pcbarts/fast-open-switch-hardware/README.md

The electronic design data from the fast-open-switch project is stored in this repo.
