pcbarts/fast-open-switch-hardware/fast-open-switch r1.0/Documentation/KlusterLab r1.x Pinouts.xlsx

Sheet: FPGA Pinout
Pin Designator | Net Name | Display Name | IO Bank | IO Standard | Slew Rate | Drive Strength | IO Pin | Vref Pin | CLK Pin | Config Pin | Special Pin | Group | Differential Pair
A1 | GND | GND
A2 | GND | GND
A3 | PCIe_C_TX0_N | MGTXTXN3_116
A4 | PCIe_C_TX0_P | MGTXTXP3_116
A5 | GND | GND
A6 | GND | GND
A7 | GND | GND
A8 | CRUVI_B_6_N | IO_L9N_T1_DQS_16
A9 | CRUVI_B_6_P | IO_L9P_T1_DQS_16
A10 | CRUVI_A_4_N | IO_L22N_T3_16
A11 | VCC3V3 | VCCO_16
A12 | CRUVI_A_1_N | IO_L24N_T3_16
A13 | CRUVI_A_1_P | IO_L24P_T3_16
A14 | CRUVI_A_7_N | IO_L21N_T3_DQS_16
A15 | CRUVI_A_8_N | IO_L23N_T3_16
A16 | GND | GND
A17 | UART_USB_RxD | IO_L3N_T0_DQS_AD1N_15
A18 | PI_E\X\T\R\S\T\ | IO_L2P_T0_AD8P_15
A19 |  | IO_L2N_T0_AD8N_15
A20 | FPGA_SOFT_RST | IO_L8N_T1_D12_14
A21 | VCC1V8 | VCCO_14
A22 | FPGA_D3 | IO_L2N_T0_D03_14
A23 | FPGA_D4 | IO_L4P_T0_D04_14
A24 | FPGA_D5 | IO_L4N_T0_D05_14
A25 | FPGA_D1 | IO_L1N_T0_D01_DIN_14
A26 | GND | GND
AA1 | VCC1V5 | VCCO_34
AA2 |  | IO_L12N_T1_MRCC_34
AA3 | DDR3_D57 | IO_L12P_T1_MRCC_34
AA4 | DDR3_D39 | IO_L13P_T2_MRCC_34
AA5 | DDR3_DQS4_P | IO_L15P_T2_DQS_34
AA6 | GND | GND
AA7 | DDR3_C\A\S\ | IO_L8N_T1_33
AA8 | DDR3_ODT0 | IO_L8P_T1_33
AA9 | DDR3_CLK1_P | IO_L11P_T1_SRCC_33
AA10 | DDR3_R\A\S\ | IO_L14P_T2_SRCC_33
AA11 | VCC1V5 | VCCO_33
AA12 | DDR3_A5 | IO_L16N_T2_33
AA13 | DDR3_A12 | IO_L16P_T2_33
AA14 | DDR3_DM3 | IO_L7P_T1_32
AA15 | DDR3_D24 | IO_L7N_T1_32
AA16 | GND | GND
AA17 | DDR3_D29 | IO_L11P_T1_SRCC_32
AA18 | DDR3_D28 | IO_L11N_T1_SRCC_32
AA19 | DDR3_D4 | IO_L16P_T2_32
AA20 | DDR3_D5 | IO_L16N_T2_32
AA21 | VCC1V8 | VCCO_12
AA22 | SMI_SD17 | IO_L13N_T2_MRCC_12
AA23 | SMI_SD15 | IO_L11P_T1_SRCC_12
AA24 | SMI_SD16 | IO_L12N_T1_MRCC_12
AA25 | SMI_SD3 | IO_L7P_T1_12
AA26 | GND | GND
AB1 | DDR3_DQS7_P | IO_L9P_T1_DQS_34
AB2 | DDR3_D56 | IO_L11P_T1_SRCC_34
AB3 | GND | GND
AB4 | DDR3_D35 | IO_L13N_T2_MRCC_34
AB5 | DDR3_DQS4_N | IO_L15N_T2_DQS_34
AB6 | DDR3_D36 | IO_L16P_T2_34
AB7 | DDR3_A13 | IO_L10P_T1_33
AB8 | VCC1V5 | VCCO_33
AB9 | DDR3_CLK1_N | IO_L11N_T1_SRCC_33
AB10 | DDR3_A2 | IO_L14N_T2_SRCC_33
AB11 | DDR3_CLK0_P | IO_L13P_T2_MRCC_33
AB12 | DDR3_A8 | IO_L15P_T2_DQS_33
AB13 | GND | GND
AB14 | DDR3_D27 | IO_L10P_T1_32
AB15 | DDR3_D30 | IO_L10N_T1_32
AB16 | DDR3_D25 | IO_L12P_T1_MRCC_32
AB17 | DDR3_D0 | IO_L14P_T2_SRCC_32
AB18 | VCC1V5 | VCCO_32
AB19 | DDR3_D11 | IO_L18P_T2_32
AB20 | DDR3_D10 | IO_L18N_T2_32
AB21 | FPGA_µSD_DAT3 | IO_L18P_T2_12
AB22 | FPGA_µSD_CMD | IO_L17P_T2_12
AB23 | GND | GND
AB24 | SMI_SD7 | IO_L11N_T1_SRCC_12
AB25 | SMI_SA4 | IO_L7N_T1_12
AB26 | SMI_SA0 | IO_L9P_T1_DQS_12
AC1 | DDR3_DQS7_N | IO_L9N_T1_DQS_34
AC2 | DDR3_D60 | IO_L11N_T1_SRCC_34
AC3 | DDR3_D34 | IO_L14N_T2_SRCC_34
AC4 | DDR3_DM4 | IO_L14P_T2_SRCC_34
AC5 | VCC1V5 | VCCO_34
AC6 | DDR3_D33 | IO_L16N_T2_34
AC7 | DDR3_BA0 | IO_L10N_T1_33
AC8 | DDR3_A3 | IO_L9P_T1_DQS_33
AC9 | 200MHz_SYSCLK_P | IO_L12P_T1_MRCC_33
AC10 | GND | GND
AC11 | DDR3_CLK0_N | IO_L13N_T2_MRCC_33
AC12 | DDR3_A6 | IO_L15N_T2_DQS_33
AC13 | DDR3_BA2 | IO_L17P_T2_33
AC14 | DDR3_D31 | IO_L8P_T1_32
AC15 | VCC1V5 | VCCO_32
AC16 | DDR3_D7 | IO_L12N_T1_MRCC_32
AC17 | DDR3_D2 | IO_L14N_T2_SRCC_32
AC18 | DDR3_D1 | IO_L13P_T2_MRCC_32
AC19 | DDR3_DM0 | IO_L17P_T2_32
AC20 | GND | GND
AC21 | FPGA_µSD_DAT1 | IO_L18N_T2_12
AC22 | FPGA_µSD_CD | IO_L17N_T2_12
AC23 | SMI_SD11 | IO_L14P_T2_SRCC_12
AC24 | SMI_SOE_N/SE | IO_L14N_T2_SRCC_12
AC25 | VCC1V8 | VCCO_12
AC26 | SMI_SD5 | IO_L9N_T1_DQS_12
AD1 | DDR3_D47 | IO_L20P_T3_34
AD2 | VCC1V5 | VCCO_34
AD3 | VTTVREF | IO_L19N_T3_VREF_34
AD4 | DDR3_D46 | IO_L19P_T3_34
AD5 |  | IO_L18N_T2_34
AD6 | DDR3_D32 | IO_L18P_T2_34
AD7 | GND | GND
AD8 | DDR3_A1 | IO_L9N_T1_DQS_33
AD9 | 200MHz_SYSCLK_N | IO_L12N_T1_MRCC_33
AD10 |  | IO_L20P_T3_33
AD11 | DDR3_A9 | IO_L19P_T3_33
AD12 | VCC1V5 | VCCO_33
AD13 | DDR3_A7 | IO_L17N_T2_33
AD14 | DDR3_D26 | IO_L8N_T1_32
AD15 | DDR3_D22 | IO_L4P_T0_32
AD16 | DDR3_D21 | IO_L6P_T0_32
AD17 | GND | GND
AD18 | DDR3_D6 | IO_L13N_T2_MRCC_32
AD19 | DDR3_D3 | IO_L17N_T2_32
AD20 | DDR3_DQS0_P | IO_L15P_T2_DQS_32
AD21 | FPGA_µSD_CLK | IO_L19P_T3_12
AD22 | VCC1V8 | VCCO_12
AD23 | FPGA_µSD_DAT2 | IO_L16P_T2_12
AD24 | FPGA_µSD_DAT0 | IO_L16N_T2_12
AD25 |  | IO_L23P_T3_12
AD26 | TEMP_I2C_SDA_LS | IO_L21P_T3_DQS_12
AE1 | DDR3_D43 | IO_L20N_T3_34
AE2 | DDR3_D42 | IO_L22N_T3_34
AE3 | DDR3_D41 | IO_L22P_T3_34
AE4 | GND | GND
AE5 | DDR3_D45 | IO_L23N_T3_34
AE6 | DDR3_D44 | IO_L23P_T3_34
AE7 | DDR3_A10 | IO_L7P_T1_33
AE8 |  | IO_L22P_T3_33
AE9 | VCC1V5 | VCCO_33
AE10 |  | IO_L20N_T3_33
AE11 | VTTVREF | IO_L19N_T3_VREF_33
AE12 |  | IO_L21P_T3_DQS_33
AE13 |  | IO_L23P_T3_33
AE14 | GND | GND
AE15 | DDR3_D18 | IO_L4N_T0_32
AE16 | VTTVREF | IO_L6N_T0_VREF_32
AE17 | DDR3_D17 | IO_L1P_T0_32
AE18 | DDR3_DQS2_P | IO_L3P_T0_DQS_32
AE19 | VCC1V5 | VCCO_32
AE20 | DDR3_DQS0_N | IO_L15N_T2_DQS_32
AE21 |  | IO_L19N_T3_VREF_12
AE22 | Main_I2C_SDA | IO_L24P_T3_12
AE23 |  | IO_L22P_T3_12
AE24 | GND | GND
AE25 |  | IO_L23N_T3_12
AE26 | TEMP_I2C_SCL_LS | IO_L21N_T3_DQS_12
AF1 | GND | GND
AF2 | DDR3_DM5 | IO_L24N_T3_34
AF3 | DDR3_D40 | IO_L24P_T3_34
AF4 | DDR3_DQS5_N | IO_L21N_T3_DQS_34
AF5 | DDR3_DQS5_P | IO_L21P_T3_DQS_34
AF6 | VCC1V5 | VCCO_34
AF7 | DDR3_A0 | IO_L7N_T1_33
AF8 |  | IO_L22N_T3_33
AF9 |  | IO_L24N_T3_33
AF10 |  | IO_L24P_T3_33
AF11 | GND | GND
AF12 |  | IO_L21N_T3_DQS_33
AF13 |  | IO_L23N_T3_33
AF14 | DDR3_D23 | IO_L2P_T0_32
AF15 | DDR3_D19 | IO_L2N_T0_32
AF16 | VCC1V5 | VCCO_32
AF17 | DDR3_DM2 | IO_L1N_T0_32
AF18 | DDR3_DQS2_N | IO_L3N_T0_DQS_32
AF19 | DDR3_D16 | IO_L5P_T0_32
AF20 | DDR3_D20 | IO_L5N_T0_32
AF21 | GND | GND
AF22 |  | IO_L24N_T3_12
AF23 |  | IO_L22N_T3_12
AF24 |  | IO_L20P_T3_12
AF25 |  | IO_L20N_T3_12
AF26 | VCC1V8 | VCCO_12
B1 | SATA_TX_C_N | MGTXTXN2_116
B2 | SATA_TX_C_P | MGTXTXP2_116
B3 | MGTAVTT | MGTAVTT
B4 | GND | GND
B5 | PCIe_RX0_N | MGTXRXN3_116
B6 | PCIe_RX0_P | MGTXRXP3_116
B7 | GND | GND
B8 | VCC3V3 | VCCO_16
B9 | CRUVI_A_3_N | IO_L10N_T1_16
B10 | CRUVI_A_4_P | IO_L22P_T3_16
B11 | CRUVI_A_5_N | IO_L20N_T3_16
B12 | CRUVI_A_5_P | IO_L20P_T3_16
B13 | GND | GND
B14 | CRUVI_A_7_P | IO_L21P_T3_DQS_16
B15 | CRUVI_A_8_P | IO_L23P_T3_16
B16 | PCIe_PERST | IO_L1N_T0_AD0N_15
B17 | UART_USB_R\T\S\ | IO_L3P_T0_DQS_AD1P_15
B18 | VCC3V3 | VCCO_15
B19 | FPGA_FAN_TACH | IO_L4N_T0_AD9N_15
B20 |  | IO_L8P_T1_D11_14
B21 |  | IO_L10N_T1_D15_14
B22 | FPGA_D2 | IO_L2P_T0_D02_14
B23 | GND | GND
B24 | FPGA_D0 | IO_L1P_T0_D00_MOSI_14
B25 | NetR274_2 | IO_L3P_T0_DQS_PUDC_B_14
B26 | FPGA_EMCCLK | IO_L3N_T0_DQS_EMCCLK_14
C1 | GND | GND
C2 | MGTAVTT | MGTAVTT
C3 | SATA_RX_C_N | MGTXRXN2_116
C4 | SATA_RX_C_P | MGTXRXP2_116
C5 | GND | GND
C6 | MGTAVCC | MGTAVCC
C7 | GND | GND
C8 | FPGA_CLK | CCLK_0
C9 | CRUVI_A_3_P | IO_L10P_T1_16
C10 | GND | GND
C11 | CRUVI_A_6_N | IO_L13N_T2_MRCC_16
C12 | CRUVI_A_6_P | IO_L13P_T2_MRCC_16
C13 | CRUVI_A_9_N | IO_L19N_T3_VREF_16
C14 | CRUVI_A_9_P | IO_L19P_T3_16
C15 | VCC3V3 | VCCO_16
C16 |  | IO_L1P_T0_AD0P_15
C17 | FPGA_FAN_PWM | IO_L5P_T0_AD2P_15
C18 | CRUVI_B_DO | IO_L5N_T0_AD2N_15
C19 | SYS_FAN_PWM | IO_L4P_T0_AD9P_15
C20 | GND | GND
C21 |  | IO_L10P_T1_D14_14
C22 | CS_MAN_CTRL | IO_L7N_T1_D10_14
C23 | FPGA_F\C\S\ | IO_L6P_T0_FCS_B_14
C24 |  | IO_L6N_T0_D08_VREF_14
C25 | VCC1V8 | VCCO_14
C26 | FPGA_D7 | IO_L5N_T0_D07_14
D1 |  | MGTXTXN1_116
D2 |  | MGTXTXP1_116
D3 | MGTAVTT | MGTAVTT
D4 | GND | GND
D5 | PCIe_REFCLK_N | MGTREFCLK0N_116
D6 | PCIe_REFCLK_P | MGTREFCLK0P_116
D7 | GND | GND
D8 | CRUVI_A_2_N | IO_L8N_T1_16
D9 | CRUVI_A_2_P | IO_L8P_T1_16
D10 | CRUVI_B_5_N | IO_L12N_T1_MRCC_16
D11 | CRUVI_B_7_N | IO_L14N_T2_SRCC_16
D12 | VCC3V3 | VCCO_16
D13 | CRUVI_A_11_N | IO_L17N_T2_16
D14 | CRUVI_A_11_P | IO_L17P_T2_16
D15 | CRUVI_B_RESET | IO_L6P_T0_15
D16 | CRUVI_B_HSO | IO_L6N_T0_VREF_15
D17 | GND | GND
D18 | CRUVI_B_SEL | IO_L13N_T2_MRCC_15
D19 | CRUVI_B_SCK | IO_L15P_T2_DQS_15
D20 | CRUVI_A_DO | IO_L15N_T2_DQS_ADV_B_15
D21 | FPGA_Strobe | IO_L7P_T1_D09_14
D22 | VCC1V8 | VCCO_14
D23 | Switch_5 | IO_L11P_T1_SRCC_14
D24 | Switch_4 | IO_L11N_T1_SRCC_14
D25 | Switch_2 | IO_L15N_T2_DQS_DOUT_CSO_B_14
D26 | FPGA_D6 | IO_L5P_T0_D06_14
E1 | GND | GND
E2 | GND | GND
E3 |  | MGTXRXN1_116
E4 |  | MGTXRXP1_116
E5 | GND | GND
E6 | MGTAVCC | MGTAVCC
E7 | GND | GND
E8 | NetTP21_1 | VCCBATT_0
E9 | VCC3V3 | VCCO_16
E10 | CRUVI_B_5_P | IO_L12P_T1_MRCC_16
E11 | CRUVI_B_7_P | IO_L14P_T2_SRCC_16
E12 | CRUVI_B_9_N | IO_L18N_T2_16
E13 | CRUVI_B_9_P | IO_L18P_T2_16
E14 | GND | GND
E15 | CRUVI_B_SMB_SCL | IO_L10P_T1_AD4P_15
E16 | CRUVI_B_REFCLK | IO_L10N_T1_AD4N_15
E17 | CRUVI_A_REFCLK | IO_L12N_T1_MRCC_AD5N_15
E18 | CRUVI_B_MODE | IO_L13P_T2_MRCC_15
E19 | VCC3V3 | VCCO_15
E20 | CRUVI_A_SEL | IO_L17N_T2_A25_15
E21 |  | IO_L9P_T1_DQS_14
E22 | Switch_7 | IO_L9N_T1_DQS_D13_14
E23 | Switch_6 | IO_L12N_T1_MRCC_14
E24 | GND | GND
E25 | Switch_0 | IO_L15P_T2_DQS_RDWR_B_14
E26 | Switch_1 | IO_L17N_T2_A13_D29_14
F1 |  | MGTXTXN0_116
F2 |  | MGTXTXP0_116
F3 | GND | GND
F4 | GND | GND
F5 | 150MHz_REFCLK_N | MGTREFCLK1N_116
F6 | 150MHz_REFCLK_P | MGTREFCLK1P_116
F7 | GND | GND
F8 | CRUVI_B_3_N | IO_L7N_T1_16
F9 | CRUVI_B_3_P | IO_L7P_T1_16
F10 | CRUVI_B_4_N | IO_L11N_T1_SRCC_16
F11 | GND | GND
F12 | CRUVI_B_8_N | IO_L16N_T2_16
F13 | CRUVI_A_0_N | IO_L15N_T2_DQS_16
F14 | CRUVI_A_0_P | IO_L15P_T2_DQS_16
F15 | CRUVI_B_HSIO | IO_L8N_T1_AD3N_15
F16 | VCC3V3 | VCCO_15
F17 | CRUVI_A_HSI | IO_L12P_T1_MRCC_AD5P_15
F18 | UART_USB_C\T\S\ | IO_L11N_T1_SRCC_AD12N_15
F19 | CRUVI_A_SMB_SDA | IO_L17P_T2_A26_15
F20 | CRUVI_A_MODE | IO_L16N_T2_A27_15
F21 | GND | GND
F22 | Switch_3 | IO_L12P_T1_MRCC_14
F23 | USER_LED_0 | IO_L13N_T2_MRCC_14
F24 | USER_LED_5 | IO_L14N_T2_SRCC_14
F25 | USER_LED_6 | IO_L17P_T2_A14_D30_14
F26 | VCC1V8 | VCCO_14
G1 | GND | GND
G2 | MGTAVTT | MGTAVTT
G3 |  | MGTXRXN0_116
G4 |  | MGTXRXP0_116
G5 | GND | GND
G6 | MGTAVCC | MGTAVCC
G7 | FPGA_I\N\I\T\ | INIT_B_0
G8 | GND | GND
G9 | CRUVI_B_2_N | IO_L2N_T0_16
G10 | CRUVI_B_2_P | IO_L2P_T0_16
G11 | CRUVI_B_4_P | IO_L11P_T1_SRCC_16
G12 | CRUVI_B_8_P | IO_L16P_T2_16
G13 | VCC3V3 | VCCO_16
G14 | CRUVI_A_10_N | IO_L5N_T0_16
G15 | CRUVI_B_SMB_ALERT | IO_L8P_T1_AD3P_15
G16 | CRUVI_B_HSI | IO_L7N_T1_AD10N_15
G17 | CRUVI_A_SMB_SCL | IO_L11P_T1_SRCC_AD12P_15
G18 | GND | GND
G19 | CRUVI_A_DI | IO_L16P_T2_A28_15
G20 | CRUVI_A_SCK | IO_L18N_T2_A23_15
G21 |  | IO_L19N_T3_A09_D25_VREF_14
G22 | Button_D | IO_L13P_T2_MRCC_14
G23 | VCC1V8 | VCCO_14
G24 | USER_LED_7 | IO_L14P_T2_SRCC_14
G25 | USER_LED_4 | IO_L16P_T2_CSI_B_14
G26 | USER_LED_2 | IO_L16N_T2_A15_D31_14
H1 | MGTX115_TX3_N | MGTXTXN3_115
H2 | MGTX115_TX3_P | MGTXTXP3_115
H3 | MGTAVTT | MGTAVTT
H4 | GND | GND
H5 | 156.25MHz_REFCLK_N | MGTREFCLK0N_115
H6 | 156.25MHz_REFCLK_P | MGTREFCLK0P_115
H7 | GND | GND
H8 | CRUVI_B_1_N | IO_L1N_T0_16
H9 | CRUVI_B_1_P | IO_L1P_T0_16
H10 | VCC3V3 | VCCO_16
H11 | CRUVI_B_10_N | IO_L6N_T0_VREF_16
H12 | CRUVI_B_10_P | IO_L6P_T0_16
H13 | CRUVI_B_11_N | IO_L3N_T0_DQS_16
H14 | CRUVI_A_10_P | IO_L5P_T0_16
H15 | GND | GND
H16 | CRUVI_A_RESET | IO_L7P_T1_AD10P_15
H17 | CRUVI_A_HSO | IO_L14P_T2_SRCC_15
H18 | CRUVI_A_HSIO | IO_L14N_T2_SRCC_15
H19 | CRUVI_A_SMB_ALERT | IO_L18P_T2_A24_15
H20 | VCC3V3 | VCCO_15
H21 |  | IO_L19P_T3_A10_D26_14
H22 | Button_L | IO_L21N_T3_DQS_A06_D22_14
H23 | Button_C | IO_L20P_T3_A08_D24_14
H24 | Button_R | IO_L20N_T3_A07_D23_14
H25 | GND | GND
H26 | USER_LED_3 | IO_L18N_T2_A11_D27_14
J1 | GND | GND
J2 | GND | GND
J3 | MGTX115_RX3_N | MGTXRXN3_115
J4 | MGTX115_RX3_P | MGTXRXP3_115
J5 | GND | GND
J6 | MGTAVCC | MGTAVCC
J7 | FPGA_DONE | DONE_0
J8 |  | IO_0_16
J9 | VCC1V0_FPGA | VCCINT
J10 | CRUVI_B_0_N | IO_L4N_T0_16
J11 | CRUVI_B_0_P | IO_L4P_T0_16
J12 | GND | GND
J13 | CRUVI_B_11_P | IO_L3P_T0_DQS_16
J14 |  | IO_25_16
J15 | CRUVI_B_DI | IO_L9P_T1_DQS_AD11P_15
J16 | CRUVI_B_SMB_SDA | IO_L9N_T1_DQS_AD11N_15
J17 | VCC3V3 | VCCO_15
J18 |  | IO_L20P_T3_A20_15
J19 |  | IO_L20N_T3_A19_15
J20 |  | IO_L19N_T3_A21_VREF_15
J21 |  | IO_L21P_T3_DQS_14
J22 | GND | GND
J23 |  | IO_L24N_T3_A00_D16_14
J24 | Button_U | IO_L22P_T3_A05_D21_14
J25 | Switch_8 | IO_L22N_T3_A04_D20_14
J26 | USER_LED_1 | IO_L18P_T2_A12_D28_14
K1 | MGTX115_TX2_N | MGTXTXN2_115
K2 | MGTX115_TX2_P | MGTXTXP2_115
K3 | GND | GND
K4 | GND | GND
K5 | SI5324_REFCLK_N | MGTREFCLK1N_115
K6 | SI5324_REFCLK_P | MGTREFCLK1P_115
K7 | GND | GND
K8 | VCC1V0_FPGA | VCCINT
K9 | GND | GND
K10 | VCC1V0_FPGA | VCCINT
K11 | GND | GND
K12 | VCC1V0_FPGA | VCCINT
K13 | GND | GND
K14 | VCC1V0_FPGA | VCCINT
K15 | UART_USB_TxD | IO_0_15
K16 |  | IO_L22P_T3_A17_15
K17 |  | IO_L22N_T3_A16_15
K18 | NetTP11_1 | IO_L24N_T3_RS0_15
K19 | GND | GND
K20 |  | IO_L19P_T3_A22_15
K21 |  | IO_0_14
K22 |  | IO_L23N_T3_A02_D18_14
K23 |  | IO_L24P_T3_A01_D17_14
K24 | VCC3V3 | VCCO_13
K25 | HDMI_FPGA_TX1_P | IO_L1P_T0_13
K26 | HDMI_FPGA_TX1_N | IO_L1N_T0_13
L1 | GND | GND
L2 | MGTAVTT | MGTAVTT
L3 | MGTX115_RX2_N | MGTXRXN2_115
L4 | MGTX115_RX2_P | MGTXRXP2_115
L5 | GND | GND
L6 | MGTAVCC | MGTAVCC
L7 | VCC2V5 | VCCO_0
L8 | JTAG_TCK | TCK_0
L9 | VCC1V0_FPGA | VCCINT
L10 | GND | GND
L11 | VCC1V8_AUX | VCCAUX
L12 | GND | GND
L13 | VCC1V0_FPGA | VCCINT
L14 | GND | GND
L15 | VCC1V0_FPGA | VCCINT
L16 | GND | GND
L17 | NetTP10_1 | IO_L24P_T3_RS1_15
L18 | NetTP9_1 | IO_L23N_T3_FWE_B_15
L19 |  | IO_L21P_T3_DQS_15
L20 |  | IO_L21N_T3_DQS_A18_15
L21 | VCC1V8 | VCCO_14
L22 |  | IO_L23P_T3_A03_D19_14
L23 |  | IO_25_14
L24 | HDMI_FPGA_RXC_N | IO_L8N_T1_13
L25 | HDMI_FPGA_TX2_N | IO_L3N_T0_DQS_13
L26 | GND | GND
M1 | MGTX115_TX1_N | MGTXTXN1_115
M2 | MGTX115_TX1_P | MGTXTXP1_115
M3 | MGTAVTT | MGTAVTT
M4 | GND | GND
M5 | MGTAVTT | MGTAVTTRCAL_115
M6 | NetR16_1 | MGTRREF_115
M7 | GND | GND
M8 | VCC1V0_FPGA | VCCINT
M9 | GND | GND
M10 | VCC1V8_AUX | VCCAUX
M11 | GND | GNDADC_0
M12 | NetTP22_1 | VCCADC_0
M13 | GND | GND
M14 | VCC1V0_FPGA | VCCINT
M15 | GND | GND
M16 |  | IO_25_15
M17 | NetTP8_1 | IO_L23P_T3_FOE_B_15
M18 | VCC3V3 | VCCO_15
M19 | SFP+_1_LOS | IO_L22N_T3_13
M20 | HDMI_FPGA_TXC_N | IO_L7N_T1_13
M21 | HDMI_FPGA_RXSDA | IO_L10P_T1_13
M22 | HDMI_FPGA_RXHPD | IO_L10N_T1_13
M23 | GND | GND
M24 | HDMI_FPGA_RXC_P | IO_L8P_T1_13
M25 | HDMI_FPGA_TX2_P | IO_L3P_T0_DQS_13
M26 | HDMI_FPGA_TXHPD | IO_L5N_T0_13
N1 | GND | GND
N2 | GND | GND
N3 | MGTX115_RX1_N | MGTXRXN1_115
N4 | MGTX115_RX1_P | MGTXRXP1_115
N5 | GND | GND
N6 | VCC1V8_AUX | MGTVCCAUX
N7 | GND | GND
N8 | JTAG_TMS | TMS_0
N9 | VCC1V0_FPGA | VCCINT
N10 | GND | GND
N11 | GND | VREFN_0
N12 | GND | VP_0
N13 | VCC1V0_FPGA | VCCBRAM
N14 | GND | GND
N15 | VCC1V0_FPGA | VCCINT
N16 |  | IO_0_13
N17 | SFP+_2_TX_DIS | IO_L20N_T3_13
N18 | SFP+_1_TX_DIS | IO_L22P_T3_13
N19 | HDMI_FPGA_TXC_P | IO_L7P_T1_13
N20 | GND | GND
N21 | SFP+_2_ACT | IO_L12P_T1_MRCC_13
N22 | SFP+_2_Link | IO_L12N_T1_MRCC_13
N23 | HDMI_FPGA_RXCEC | IO_L11N_T1_SRCC_13
N24 | HDMI_FPGA_RX0_N | IO_L4N_T0_13
N25 | VCC3V3 | VCCO_13
N26 | HDMI_FPGA_TXCEC | IO_L5P_T0_13
P1 | MGTX115_TX0_N | MGTXTXN0_115
P2 | MGTX115_TX0_P | MGTXTXP0_115
P3 | GND | GND
P4 | GND | GND
P5 | FPGA_M2 | M2_0
P6 | FPGA_PROG | PROGRAM_B_0
P7 | VCC2V5 | CFGBVS_0
P8 | VCC1V8_AUX | VCCAUX_IO_G0
P9 | GND | GND
P10 | VCC1V8_AUX | VCCAUX
P11 | GND | VN_0
P12 | GND | VREFP_0
P13 | GND | GND
P14 | VCC1V0_FPGA | VCCINT
P15 | GND | GND
P16 | SFP+_3_TX_DIS | IO_L20P_T3_13
P17 | GND | GND
P18 |  | IO_L24N_T3_13
P19 | HDMI_FPGA_TX0_P | IO_L9P_T1_DQS_13
P20 | HDMI_FPGA_TX0_N | IO_L9N_T1_DQS_13
P21 | REC_CLOCK_C_N | IO_L13N_T2_MRCC_13
P22 | VCC3V3 | VCCO_13
P23 | HDMI_FPGA_RXSCL | IO_L11P_T1_SRCC_13
P24 | HDMI_FPGA_RX0_P | IO_L4P_T0_13
P25 | HDMI_FPGA_RX2_N | IO_L6N_T0_VREF_13
P26 | HDMI_FPGA_RX1_N | IO_L2N_T0_13
R1 | GND | GND
R2 | GND | GND
R3 | MGTX115_RX0_N | MGTXRXN0_115
R4 | MGTX115_RX0_P | MGTXRXP0_115
R5 | GND | GND
R6 | JTAG_TDI | TDI_0
R7 | JTAG_TDO | TDO_0
R8 | GND | GND
R9 | VCC1V8_AUX | VCCAUX_IO_G0
R10 | GND | GND
R11 | GND | DXN_0
R12 | GND | DXP_0
R13 | VCC1V0_FPGA | VCCBRAM
R14 | GND | GND
R15 | VCC1V0_FPGA | VCCINT
R16 | SFP+_3_LOS | IO_L21P_T3_DQS_13
R17 | SFP+_2_LOS | IO_L21N_T3_DQS_13
R18 | SFP+_0_TX_DIS | IO_L24P_T3_13
R19 | VCC3V3 | VCCO_13
R20 | SFP+_3_Link | IO_L16N_T2_13
R21 | REC_CLOCK_C_P | IO_L13P_T2_MRCC_13
R22 | SFP+_3_ACT | IO_L14P_T2_SRCC_13
R23 | SFP+_1_ACT | IO_L14N_T2_SRCC_13
R24 | GND | GND
R25 | HDMI_FPGA_RX2_P | IO_L6P_T0_13
R26 | HDMI_FPGA_RX1_P | IO_L2P_T0_13
T1 | GND | GND
T2 | FPGA_M1 | M1_0
T3 | GND | GND
T4 | GND | GND
T5 | FPGA_M0 | M0_0
T6 | VCC2V5 | VCCO_0
T7 | VRP_34 | IO_25_VRP_34
T8 | VCC1V8_AUX | VCCAUX_IO_G0
T9 | GND | GND
T10 | VCC1V8_AUX | VCCAUX
T11 | GND | GND
T12 | VCC1V0_FPGA | VCCBRAM
T13 | GND | GND
T14 | VCC1V0_FPGA | VCCINT
T15 | GND | GND
T16 | VCC3V3 | VCCO_13
T17 |  | IO_L23N_T3_13
T18 |  | IO_L19P_T3_13
T19 | SFP+_0_LOS | IO_L19N_T3_VREF_13
T20 |  | IO_L16P_T2_13
T21 | GND | GND
T22 | SFP+_1_Link | IO_L17P_T2_13
T23 |  | IO_L17N_T2_13
T24 | SFP+_0_Link | IO_L15P_T2_DQS_13
T25 | SFP+_0_ACT | IO_L15N_T2_DQS_13
T26 | VCC3V3 | VCCO_13
U1 | DDR3_D54 | IO_L2N_T0_34
U2 | DDR3_D50 | IO_L2P_T0_34
U3 | VCC1V5 | VCCO_34
U4 | VRN_34 | IO_0_VRN_34
U5 | DDR3_D51 | IO_L1N_T0_34
U6 | DDR3_D55 | IO_L1P_T0_34
U7 | DDR3_DM6 | IO_L5P_T0_34
U8 | GND | GND
U9 | VRN_33 | IO_0_VRN_33
U10 | GND | GND
U11 | VCC1V8_AUX | VCCAUX
U12 | GND | GND
U13 | VCC1V0_FPGA | VCCBRAM
U14 | GND | GND
U15 | VCC1V0_FPGA | VCCINT
U16 |  | IO_25_13
U17 |  | IO_L23P_T3_13
U18 | GND | GND
U19 |  | IO_L18P_T2_13
U20 |  | IO_L18N_T2_13
U21 |  | IO_0_12
U22 | SMI_SD4 | IO_L1P_T0_12
U23 | VCC1V8 | VCCO_12
U24 | SMI_SA2 | IO_L2P_T0_12
U25 | SMI_SD6 | IO_L2N_T0_12
U26 | SMI_SA3 | IO_L4P_T0_12
V1 | DDR3_D63 | IO_L8N_T1_34
V2 | DDR3_D59 | IO_L8P_T1_34
V3 | DDR3_D53 | IO_L4P_T0_34
V4 | DDR3_D49 | IO_L6P_T0_34
V5 | GND | GND
V6 | DDR3_D52 | IO_L5N_T0_34
V7 | DDR3_S\1\ | IO_L2N_T0_33
V8 | DDR3_BA1 | IO_L2P_T0_33
V9 | DDR3_ODT1 | IO_L6P_T0_33
V10 | VCC1V5 | VCCO_33
V11 | DDR3_R\E\S\E\T\ | IO_L1P_T0_33
V12 | VRP_33 | IO_25_VRP_33
V13 | VRN_32 | IO_0_VRN_32
V14 |  | IO_L24P_T3_32
V15 | GND | GND
V16 | DDR3_D8 | IO_L20P_T3_32
V17 | DDR3_DM1 | IO_L20N_T3_32
V18 | DDR3_D9 | IO_L23P_T3_32
V19 | DDR3_D13 | IO_L23N_T3_32
V20 | VCC1V8 | VCCO_12
V21 | Main_I2C_SCL | IO_L6P_T0_12
V22 | SI5324_\R\S\T\_LS | IO_L1N_T0_12
V23 | SMI_SA5 | IO_L3P_T0_DQS_12
V24 | SI5324_I\N\I\T\_LS | IO_L3N_T0_DQS_12
V25 | GND | GND
V26 | SMI_SA1 | IO_L4N_T0_12
W1 | DDR3_D58 | IO_L10P_T1_34
W2 | GND | GND
W3 | DDR3_D48 | IO_L4N_T0_34
W4 | VTTVREF | IO_L6N_T0_VREF_34
W5 | DDR3_DQS6_N | IO_L3N_T0_DQS_34
W6 | DDR3_DQS6_P | IO_L3P_T0_DQS_34
W7 | VCC1V5 | VCCO_33
W8 | VTTVREF | IO_L6N_T0_VREF_33
W9 | DDR3_CKE1 | IO_L3N_T0_DQS_33
W10 | DDR3_E\V\E\N\T\ | IO_L3P_T0_DQS_33
W11 | DDR3_A4 | IO_L1N_T0_33
W12 | GND | GND
W13 | VRP_32 | IO_25_VRP_32
W14 |  | IO_L24N_T3_32
W15 | DDR3_D12 | IO_L22P_T3_32
W16 | DDR3_D14 | IO_L22N_T3_32
W17 | VCC1V5 | VCCO_32
W18 | DDR3_DQS1_P | IO_L21P_T3_DQS_32
W19 | DDR3_DQS1_N | IO_L21N_T3_DQS_32
W20 | SMI_SD13 | IO_L15P_T2_DQS_12
W21 | Main_I2C_MUX_RST | IO_L6N_T0_VREF_12
W22 | GND | GND
W23 | SMI_SWE_N/SRW_N | IO_L8P_T1_12
W24 | SMI_SD0 | IO_L8N_T1_12
W25 | SMI_SD9 | IO_L5P_T0_12
W26 | SMI_SD14 | IO_L5N_T0_12
Y1 | DDR3_DM7 | IO_L10N_T1_34
Y2 | DDR3_D62 | IO_L7N_T1_34
Y3 | DDR3_D61 | IO_L7P_T1_34
Y4 | VCC1V5 | VCCO_34
Y5 | DDR3_D38 | IO_L17N_T2_34
Y6 | DDR3_D37 | IO_L17P_T2_34
Y7 | DDR3_W\E\ | IO_L4N_T0_33
Y8 | DDR3_S\0\ | IO_L4P_T0_33
Y9 | GND | GND
Y10 | DDR3_CKE0 | IO_L5N_T0_33
Y11 | DDR3_A11 | IO_L5P_T0_33
Y12 | DDR3_A15 | IO_L18N_T2_33
Y13 | DDR3_A14 | IO_L18P_T2_33
Y14 | VCC1V5 | VCCO_32
Y15 | DDR3_DQS3_P | IO_L9P_T1_DQS_32
Y16 | DDR3_DQS3_N | IO_L9N_T1_DQS_32
Y17 | DDR3_D15 | IO_L19P_T3_32
Y18 | VTTVREF | IO_L19N_T3_VREF_32
Y19 | GND | GND
Y20 |  | IO_25_12
Y21 | SMI_SD12 | IO_L15N_T2_DQS_12
Y22 | SMI_SD8 | IO_L13P_T2_MRCC_12
Y23 | SMI_SD10 | IO_L12P_T1_MRCC_12
Y24 | VCC1V8 | VCCO_12
Y25 | SMI_SD2 | IO_L10P_T1_12
Y26 | SMI_SD1 | IO_L10N_T1_12

Sheet: Pi CM4 Pinout
GPIO | Pull | ALT0 | ALT1 | ALT2 | ALT3 | ALT4 | ALT5 | Design Note
GPIO0 | High | SDA0 | SA5 | PCLK | SPI3_CE0_N | TXD2 | SDA6
GPIO1 | High | SCL0 | SA4 | DE | SPI3_MISO | RXD2 | SCL6
GPIO2 | High | SDA1 | SA3 | LCD_VSYNC | SPI3_MOSI | CTS2 | SDA3
GPIO3 | High | SCL1 | SA2 | LCD_HSYNC | SPI3_SCLK | RTS2 | SCL3
GPIO4 | High | GPCLK0 | SA1 | DPI_D0 | SPI4_CE0_N | TXD3 | SDA3
GPIO5 | High | GPCLK1 | SA0 | DPI_D1 | SPI4_MISO | RXD3 | SCL3
GPIO6 | High | GPCLK2 | SOE_N / SE | DPI_D2 | SPI4_MOSI | CTS3 | SDA4
GPIO7 | High | SPI0_CE1_N | SWE_N / SRW_N | DPI_D3 | SPI4_SCLK | RTS3 | SCL4
GPIO8 | High | SPI0_CE0_N | SD0 | DPI_D4 | BSCSL / CE_N | TXD4 | SDA4
GPIO9 | Low | SPI0_MISO | SD1 | DPI_D5 | BSCSL / MISO | RXD4 | SCL4
GPIO10 | Low | SPI0_MOSI | SD2 | DPI_D6 | BSCSL SDA / MOSI | CTS4 | SDA5
GPIO11 | Low | SPI0_SCLK | SD3 | DPI_D7 | BSCSL SCL / SCLK | RTS4 | SCL5
GPIO12 | Low | PWM0_0 | SD4 | DPI_D8 | SPI5_CE0_N | TXD5 | SDA5
GPIO13 | Low | PWM0_1 | SD5 | DPI_D9 | SPI5_MISO | RXD5 | SCL5
GPIO14 | Low | TXD0 | SD6 | DPI_D10 | SPI5_MOSI | CTS5 | TXD1
GPIO15 | Low | RXD0 | SD7 | DPI_D11 | SPI5_SCLK | RTS5 | RXD1
GPIO16 | Low | <reserved> | SD8 | DPI_D12 | CTS0 | SPI1_CE2_N | CTS1
GPIO17 | Low | <reserved> | SD9 | DPI_D13 | RTS0 | SPI1_CE1_N | RTS1
GPIO18 | Low | PCM_CLK | SD10 | DPI_D14 | SPI6_CE0_N | SPI1_CE0_N | PWM0_0
GPIO19 | Low | PCM_FS | SD11 | DPI_D15 | SPI6_MISO | SPI1_MISO | PWM0_1
GPIO20 | Low | PCM_DIN | SD12 | DPI_D16 | SPI6_MOSI | SPI1_MOSI | GPCLK0
GPIO21 | Low | PCM_DOUT | SD13 | DPI_D17 | SPI6_SCLK | SPI1_SCLK | GPCLK1
GPIO22 | Low | SD0_CLK | SD14 | DPI_D18 | SD1_CLK | ARM_TRST | SDA6
GPIO23 | Low | SD0_CMD | SD15 | DPI_D19 | SD1_CMD | ARM_RTCK | SCL6
GPIO24 | Low | SD0_DAT0 | SD16 | DPI_D20 | SD1_DAT0 | ARM_TDO | SPI3_CE1_N
GPIO25 | Low | SD0_DAT1 | SD17 | DPI_D21 | SD1_DAT1 | ARM_TCK | SPI4_CE1_N
GPIO26 | Low | SD0_DAT2 | <reserved> | DPI_D22 | SD1_DAT2 | ARM_TDI | SPI5_CE1_N | not connected
GPIO27 | Low | SD0_DAT3 | <reserved> | DPI_D23 | SD1_DAT3 | ARM_TMS | SPI6_CE1_N | not connected
GPIO44 | - | GPCLK1 | SDA0 | SDA1 | <reserved> | SPI0_CE1_N | SD_CARD_VOLT | not connected
GPIO45 | - | PWM0_1 | SCL0 | SCL1 | <reserved> | SPI0_CE2_N | SD_CARD_PWR0 | not connected
