pcbarts/fast-open-switch-hardware/fast-open-switch r1.0/Output Data/PCB/JLC12161H-2313A layerstack.png

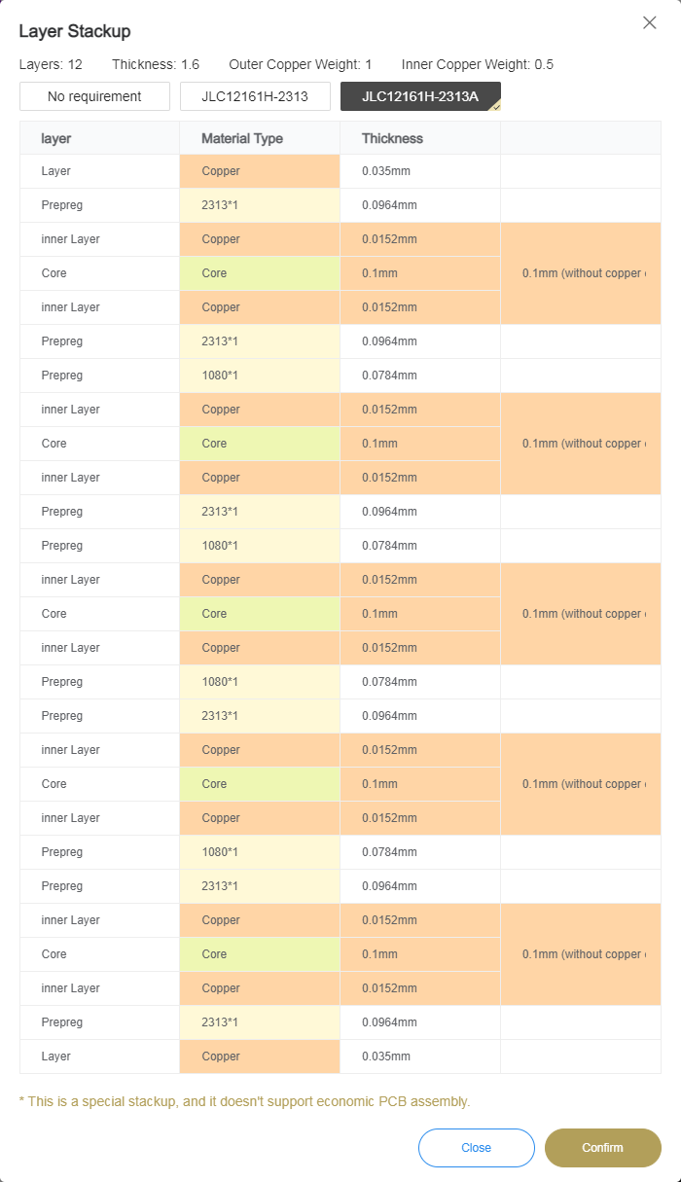
fast-open-switch r1.0/Output Data/PCB/JLC12161H-2313A layerstack.png
