pcbarts/fast-open-switch-hardware/fast-open-switch r1.0/Output Data/PCBA/fast-open-switch r1.0.xlsx

 | Bill of Materials |  | Bill of Materials for Project [fast-open-switch r1.0.PrjPcb] (No PCB Document Selected)
 | Source Data From: |  | fast-open-switch r1.0.PrjPcb
 | Project: |  | fast-open-switch r1.0.PrjPcb
 | Variant: |  | None
 | Report Date: | 03.05.2023 | 15:09
 | Print Date: | 2023-05-03 | 16:19:40
# | Comment | Description | Designator | Footprint | Library Name | Manufacturer 1 | Manufacturer 1 Prt. Nr. | Manufacturer 2 | Manufacturer 2 Prt. Nr. | Quantity
1 | 10nF 50V | Multilayer Ceramic Capacitors MLCC - SMD/SMT 0402 50VDC | C1, C2, C3, C14, C16, C83, C84, C85, C86, C107, C108, C109, C110, C151, C287, C288, C289, C291, C292 | CAP_0402_L | Cap.SchLib | Wurth Elektronik | 885012205067 | Yageo | AC0402KPX7R9BB103 | 19
2 | 10µF 35V | Multilayer Ceramic Capacitors MLCC - SMD/SMT 0805 35VDC | C4, C7, C8, C11, C12, C13, C37, C59, C80, C121, C139, C180 | CAP_0805 | Cap.SchLib | Murata Electronics | GRM21BR6YA106ME43L | TDK | C2012X5R1V106M085AC | 12
3 | 100nF 50V | Multilayer Ceramic Capacitors MLCC - SMD/SMT 0402 50VDC | C5, C9, C10, C15, C17, C18, C19, C21, C22, C23, C24, C25, C26, C27, C28, C29, C30, C31, C32, C33, C34, C35, C36, C57, C58, C78, C79, C81, C82, C88, C90, C92, C94, C95, C97, C99, C101, C105, C106, C114, C115, C116, C122, C123, C124, C125, C126, C127, C128, C129, C130, C131, C132, C133, C134, C135, C136, C137, C138, C140, C142, C143, C147, C148, C150, C152, C153, C154, C155, C156, C157, C158, C159, C160, C161, C162, C163, C164, C165, C166, C167, C168, C169, C170, C171, C172, C173, C176, C177, C179, C181, C183, C184, C185, C186, C187, C188, C189, C190, C191, C192, C194, C195, C197, C198, C199, C286, C290, C381, C382, C399, C400, C416, C417, C418, C419, C420 | CAP_0402_L | Cap.SchLib | Murata Electronics | GCM155L8EH104KE07D | TDK | UMK105B7104KV-FR | 117
4 | 100nF 100V | Multilayer Ceramic Capacitors MLCC - SMD/SMT 0603 100VDC | C6 | CAP_0603_L | Cap.SchLib | Samsung Electro-Mechanics | CL10B104KC8NNNC | AVX | 06031C104KAT2A | 1
5 | 100µF 6.3V | Multilayer Ceramic Capacitors MLCC - SMD/SMT 1210 6.3VDC | C38, C207, C235, C253 | CAP_1210 | Cap.SchLib | Samsung Electro-Mechanics | CL32A107MQVNNWE | Taiyo Yuden | JMK325ABJ107MMHP | 4
6 | 1µF 35V | Multilayer Ceramic Capacitors MLCC - SMD/SMT 0402 35VDC | C39, C40, C120, C144, C200, C201, C202, C204, C205, C206, C208, C209, C210, C211, C212, C214, C215, C216, C217, C218, C219, C220, C221, C222, C223, C224, C225, C226, C227, C228, C229, C230, C231, C232, C233, C234, C236, C237, C238, C239, C241, C242, C243, C244, C245, C247, C248, C249, C251, C254, C255, C256, C257, C263, C269, C271, C272, C274, C275, C277, C421, C422 | CAP_0402_L | Cap.SchLib | Kyocera Electronic Components | CM05X5R105K35AH | TDK | C1005X5R1V105K050BC | 62
7 | 22µF 25V | Multilayer Ceramic Capacitors MLCC - SMD/SMT 1210 25VDC | C87, C89, C91, C93, C96, C98, C100, C102, C103, C104, C149, C178 | CAP_1210 | Cap.SchLib | KEMET | C1210C226K3PACTU | Taiyo Yuden | TMK212BBJ226MG-TT | 12
8 | 1nF 2000V | Multilayer Ceramic Capacitors MLCC - SMD/SMT 1206 2000VDC | C111 | CAP_1206 | Cap.SchLib | Yageo | CC1206MKX7RDBB102 | Walsin | 1206B102M202CT | 1
9 | 10µF 6.3V | Multilayer Ceramic Capacitors MLCC - SMD/SMT 0603 6.3VDC | C112, C113, C118, C174, C175, C203, C240, C246, C261, C262 | CAP_0603_L | Cap.SchLib | Murata Electronics | GRM188R60J106ME84J | Taiyo Yuden | JMK107ABJ106MA-T | 10
10 | 12pF 50V | Multilayer Ceramic Capacitors MLCC - SMD/SMT 0402 50VDC | C117, C145, C146 | CAP_0402_L | Cap.SchLib | Murata Electronics | GCM1555C1H120JA16J | KEMET | C0402C120J5GACTU | 3
11 | 22µF 16V | Multilayer Ceramic Capacitors MLCC - SMD/SMT 0805 16VDC | C119 | CAP_0805 | Cap.SchLib | Samsung Electro-Mechanics | CL21A226KOQNNNG | Murata Electronics | GRM21BC81C226ME44K | 1
12 | 100µF 10V | Organische Polymer-Aluminiumkondensatoren 100uF 10 Volts 20% | C141 | WCAP-ASLI_D5H5.5 | Cap.SchLib | Würth Elektronik | 875105242010 |  |  | 1
13 | 22µF 10V | Multilayer Ceramic Capacitors MLCC - SMD/SMT 0603 10VDC | C182 | CAP_0603_L | Cap.SchLib | Samsung Electro-Mechanics | CL10A226MP8NUNE | Murata Electronics | GRM188R61A226ME15D | 1
14 | OPT | Multilayer Ceramic Capacitors MLCC - SMD/SMT 0402 Optional Placeholder | C193, C196, C407, C408, C409, C410, C411, C412, C413, C414, C415 | CAP_0402_L | Cap.SchLib |  |  |  |  | 11
15 | 1µF 50V | Multilayer Ceramic Capacitors MLCC - SMD/SMT 0805 50VDC | C279, C284, C285, C293, C294, C295, C296, C297, C298, C299, C300, C337, C338, C339, C340, C341, C342, C343, C344, C383, C384, C385, C386 | CAP_0805 | Cap.SchLib | Samsung Electro-Mechanics | CL21B105KBFNNNG | Taiyo Yuden | UMK212BJ105KGHT | 23
16 | 330µF 25V | Organische Polymer-Aluminiumkondensatoren 330uF 25 Volts 20% AEC-Q200 | C281, C282, C283, C318, C320, C322, C324, C325, C326, C327, C328, C329, C330, C331, C332, C362, C364, C366, C368, C369, C370, C371, C372, C373, C374, C375, C376, C396, C397, C401, C402, C403, C404 | WCAP-PTG5_D10H12.5 | Cap.SchLib | Würth Elektronik | 870025575009 |  |  | 33
17 | 10µF 100V | Multilayer Ceramic Capacitors MLCC - SMD/SMT 1210 100VDC | C301, C302, C303, C304, C305, C306, C307, C308, C309, C310, C311, C312, C313, C314, C315, C316, C317, C319, C321, C323, C345, C346, C347, C348, C349, C350, C351, C352, C353, C354, C355, C356, C357, C358, C359, C360, C361, C363, C365, C367, C387, C388, C389, C390, C391, C392, C393, C394, C395, C398 | CAP_1210 | Cap.SchLib | Murata Electronics | GRM32EC72A106ME05L | TDK | C3225X7R2A106K250AC | 50
18 | 220nF 35V | Multilayer Ceramic Capacitors MLCC - SMD/SMT 0402 35VDC | C333, C334, C335, C336, C377, C378, C379, C380, C406 | CAP_0402_L | Cap.SchLib | Murata Electronics | GCM155R71C224ME02D | Wurth Elektronik | 885012105017 | 9
19 | 1nF 50V | Multilayer Ceramic Capacitors MLCC - SMD/SMT 0402 50VDC | C405 | CAP_0402_L | Cap.SchLib | Murata Electronics | GRM155R71H102JA01D | KEMET | C0402C102J5RAC7411 | 1
20 | LTST-S270KGKT | GREEN 0603 Light Emitting Diode | D1, D30, D138, D140, D142, D144 | LED-0603 Sideview | Active.SchLib | lite-On | LTST-S270KGKT |  |  | 6
21 | LTST-S270KRKT | RED 0603 Light Emitting Diode | D2, D29, D64, D65, D66, D67, D68, D69, D70, D71 | LED-0603 Sideview | Active.SchLib | lite-On | LTST-S270KRKT |  |  | 10
22 | CESDP0402UC5VB | Low Capacitance ESD Protection Diode 0402 | D3, D4, D5, D6, D7, D8, D9, D10, D11, D12, D13, D14, D15, D16, D17, D18, D19, D20, D21, D22, D23, D24, D25, D26, D27, D28, D32, D33, D34, D35, D36, D38, D39, D40, D41, D42, D43, D44, D45, D46, D47, D48, D51, D52, D53, D54, D55, D56, D57, D58, D59, D60, D61, D62, D63, D74, D75, D76 | TVS_0402 | Protec.SchLib | CREATEK | CESDP0402UC5VB | BORN | BPESD0402-05ST | 58
23 | LTST-S270TBKT | BLUE 0603 Light Emitting Diode | D31, D73 | LED-0603 Sideview | Active.SchLib | lite-On | LTST-S270TBKT |  |  | 2
24 | BAT54GWJ | Schottky Diode 30V, 200mA | D37, D49, D50 | SOD123 | Active.SchLib | Nexperia | BAT54GWJ | onsemi | BAT54T1G | 3
25 | SMB15F18A | ESD-Entstörer/TVS-Dioden 1500 W, 18 V TVS | D72 | DO221-AA | Protec.SchLib | STMicroelectronics | SMB15F18A |  |  | 1
26 | LTST-S270KFKT | ORANGE 0603 Light Emitting Diode | D139, D141, D143, D145 | LED-0603 Sideview | Active.SchLib | lite-On | LTST-S270KFKT |  |  | 4
27 | 15406.3 | SMD Ceramic Holder with Fuse - Fast 6.3A | F1 | 154 Series Littelfuse | Passive.SchLib | Littelfuse | 15406.3 |  |  | 1
28 | 9774065151R | Würth Standoff M2.5 h:6.5mm 9774065151R | H1 | 9774065151R | Electro_Mech.SchLib | Würth Elektronik | 9774065151R |  |  | 1
29 | 9774030151R | Würth Standoff M2.5 h:3.0mm 9774030151R | H2, H3, H4, H5 | 9774030151R | Electro_Mech.SchLib | Würth Elektronik | 9774030151R |  |  | 4
30 | 9774050960R | Würth Standoff TH3.3 h:5mm 9774050960R | H6, H7, H8, H9 | 9774050960R | Electro_Mech.SchLib | Würth Elektronik | 9774050960R | Würth Elektronik | 78614050960 | 4
31 | 9774050243R | Würth Standoff M2 h:5mm 9774050243R | H10, H11, H12, H13, H14, H15 | 9774050243R | Electro_Mech.SchLib | Würth Elektronik | 9774050243R |  |  | 6
32 | 9774020360R | Würth Standoff M3 h:2mm 9774020360R | H16, H17, H18, H19 | 9774020360R | Electro_Mech.SchLib | Würth Elektronik | 9774020360R |  |  | 4
33 | Heatsink Assembly 52.65x52.65x24.5mm | Machined Copper Heatsink for GaN Devices | HS1 | ATS-61500W-C2-R0 | Electro_Mech.SchLib | Advanced Thermal Solutions | ATS-61500W-C2-R0 |  |  | 1
34 | 2-2013310-1 | SO-DIMM DDR3 204P 9.2H STD Connector | J1 | 2-2013310-1 | Conn.SchLib | TE Connectivity | 2-2013310-1 |  |  | 1
35 | 74441-0010 | 20 Pin Right Angle 0.8mm SMD Card Edge Connector for SFP+ | J2, J3, J4, J5 | 74441-0010 | Conn.SchLib | Molex | 74441-0010 |  |  | 4
36 | APCI0161 | NGFF B-Key Card Edge Connector 8.5mm Height | J6 | APCI0161-P001A | Conn.SchLib | Lotes | APCI0161 |  |  | 1
37 | Hirose Hirose DF40HC(3.0)-100DS-0.4V | Hirose DF40HC(3.0)-100DS-0.4V 3mm heigth receptacle for Raspberry Pi CM4, Pin 1-100 | J7 | Hirose DF40HC(3.0)-100DS-0.4V_1-100 | Conn.SchLib | Hirose | DF40HC(3.0)-100DS-0.4V |  |  | 1
38 | Hirose DF40HC(3.0)-100DS-0.4V PiMC4 Pin 101-200 | Hirose DF40C-100DS-0.4V 3mm heigth receptacle for Raspberry Pi CM4, Pin 101-200 | J8 | Hirose DF40HC(3.0)-100DS-0.4V_101-200 | Conn.SchLib | Hirose | DF40HC(3.0)-100DS-0.4V |  |  | 1
39 | R-RJ45R08P-C000 | RJ45 8 1 Shielded Yellow - Green Through Hole Ethernet Connectors/Modular Connectors (RJ45 RJ11) RoHS | J9 | Ckmtw - R-RJ45R08P-C000 | Conn.SchLib | Ckmtw(Shenzhen Cankemeng) | R-RJ45R08P-C000 |  |  | 1
40 | 53398-0476 | 1.25mm Pitch, PicoBlade PCB Header, Single Row, horizontal, SMD, 4 Pin | J10, J16 | Molex 53398-0476 | Conn.SchLib | Molex | 53398-0476 | Molex | 53398-0471 | 2
41 | EB-500-6007 | HDMI Connector Female Vertical 19 Pin | J11, J23, J24 | Elecbee EB-500-6007 | Conn.SchLib | Elecbee | EB-500-6007 |  |  | 3
42 | TF-115 | microSD™ Memory Card 8 connector&Ejector 14.5x14.75x1.85mm Card Sockets Connector | J12, J22 | TF-115 | Conn.SchLib | XUNPU | TF-115 |  |  | 2
43 | MICRO5.9mmusb | SHOU HAN MICRO5.9mmusb | J13, J19, J31 | MICRO5.9mmusb | Conn.SchLib | SHOU HAN | MICRO5.9mmusb |  |  | 3
44 | UEA1112C-8FS6-4F | Dual USB 3.0 Horizontal Type A | J14 | UEA1112C-8FS6-4F | Conn.SchLib | Foxconn | UEA1112C-8FS6-4F | HDGC | USB-HX-19DIP | 1
45 | 4-Pin THT Pin header | WR-PHD 2.54mm 4Pin THT Header | J15, J17, J25 | 61300411121 | Conn.SchLib | Würth Elektronik | 61300411121 |  |  | 3
46 | Box Pinheader, 14 Pin, THT, Straight | Box Pin header THT 2.00mm 14Pol Straight | J18 | 87832-1420 | Conn.SchLib | Molex | 87832-1420 |  |  | 1
47 | Pinheader, 20 Pin, THT, Straight | Box Pin header THT 1.27mm 20Pol Straight | J20 | 62702021621 | Conn.SchLib | Würth Elektronik | 62702021621 |  |  | 1
48 | SS4-30-3.50-L-D-K-TR | Platine-zu-Platine & Mezzanine-Steckverbinder 0.40 mm Micro Blade & Beam Ultra Fine Pitch Socket | J21, J27 | SS4-30-3.50-L-D-K-TR | Conn.SchLib | Samtec | SS4-30-3.50-L-D-K-TR |  |  | 2
49 | 87427-0602 | Mini-Fit Jr. Right angle Header, 4.20mm Pitch, Dual Row, 6 Circuits | J26 | Molex 87427-0602 | Conn.SchLib | MOLEX | 874270602 |  |  | 1
50 | Pinheader, 10 Pin, THT, Straight | Box Pin header THT 1.27mm 10Pol Straight | J28 | 62701021621 | Conn.SchLib | Würth Elektronik | 62701021621 |  |  | 1
51 | PINREX 744-81-04TG20 | FAN Connector header 2.54mm 4Pol | J29, J30 | PINREX 744-81-04TG20 | Conn.SchLib | PINREX | 744-81-04TG20 |  |  | 2
52 | BLM18SG121TN1D | Ferritperlen BLM18_xN 0603 100MHz 120Ohm 3000mA 25mOhm RSER | L1, L2, L3, L4, L5, L6, L7, L8, L12, L13 | L_0603 | Indc.SchLib | Murata Electronics | BLM18SG121TN1D |  |  | 10
53 | FXL0420-1R0-M | 1uH ±20% 6A 27mΩ SMD,4.4x4.5x1.8mm Power Inductor | L9 | FXL0420-1R0-M | Indc.SchLib | cjiang(Changjiang Microelectronics Tech) | FXL0420-1R0-M |  |  | 1
54 | BLM21PG221SN1D | Ferrite Beads 0805 220 OHM | L10, L11 | L_0805 | Indc.SchLib | Murata Electronics | BLM21PG221SN1D |  |  | 2
55 | 2007198-1 | 2SFP+ Cage, 1x1, external EMV springs, no lightpipes | M1, M2, M3, M4 | 2007198-1 | Conn.SchLib | TE Connectivity | 2007198-1 |  |  | 4
56 | RPiCM4 | Raspberry Pi 4 Compute Module 4 | PC1 | RaspberryPi_CM4 | Mechanical.SchLib | Raspberry Pi | Compute Module 4 |  |  | 1
57 | RUC002N05T116 | MOSFET N-Ch 1.2 VGS Spec | Q1, Q2, Q3, Q4, Q7, Q8, Q12 | SOT95P251X112-3N | Trans.SchLib | ROHM Semiconductor | RUC002N05T116 |  |  | 7
58 | 2N7002NXAKR | MOSFET 60V SGL N-CH TRENCHMOS | Q5, Q6, Q9, Q10, Q11 | SOT95P251X112-3N | Trans.SchLib | Nexperia | 2N7002NXAKR |  |  | 5
59 | 80.6R 1% | Thick Film Resistors - SMD 80.6R 1% | R1, R3, R5, R6, R7, R8 | RES_0402_L | Res.SchLib | Vishay / Dale | CRCW040280R6FKEDC | Yageo | RC0402FR-7W80R6L | 6
60 | 1.07k 1% | Thick Film Resistors - SMD 1.07kOhm 1% | R2, R4, R214, R218, R221, R223, R227, R237, R238, R239, R240, R245, R246, R247, R248, R253 | RES_0402_L | Res.SchLib | Vishay / Dale | CRCW04021K07FKEDC | Yageo | AC0402FR-071K07L | 16
61 | 100R 1% | Thick Film Resistors - SMD 100Ohm 1% | R9, R16, R109, R206 | RES_0402_L | Res.SchLib | Vishay / Dale | CRCW0402100RFKEE | Yageo | RC0402FR-7W100RL | 4
62 | 4.7k 1% | Thick Film Resistors - SMD 4.7kOhm 1% | R10, R11, R12, R13, R14, R15, R20, R21, R22, R23, R24, R25, R28, R29, R30, R31, R32, R33, R34, R35, R36, R39, R40, R41, R42, R43, R44, R45, R46, R47, R50, R51, R52, R53, R54, R55, R56, R57, R58, R61, R62, R63, R82, R83, R84, R94, R95, R98, R105, R139, R140, R141, R176, R177, R181, R182, R183, R184, R186, R187, R188, R211, R212, R216, R217, R219, R224, R225, R228, R251 | RES_0402_L | Res.SchLib | Vishay / Dale | CRCW04024K70FKEDC | Yageo | RC0402FR-134K7L | 70
63 | 47k 1% | Thick Film Resistors - SMD 47kOhm 1% | R64, R65, R164, R165, R166, R167, R170, R171, R262, R263, R264, R265, R266, R267, R268, R269, R270, R271, R272, R273, R274 | RES_0402_L | Res.SchLib | Vishay / Dale | CRCW040247K0FKEDC | Yageo | RC0402FR-7W47KL | 21
64 | 0R Jumper | Thick Film Resistors - SMD 0Ohm | R67, R70, R103, R104, R118, R119, R120, R121, R122, R123, R124, R125, R126, R127, R128, R129, R130, R142, R143, R144, R145, R146, R147, R148, R202, R203, R204 | RES_0402_L | Res.SchLib | Vishay / Dale | CRCW04020000Z0EDC | Yageo | RC0402JR-070RL | 27
65 | 2.2k 1% | Thick Film Resistors - SMD 2.2kOhm 1% | R68, R132 | RES_0402_L | Res.SchLib | Vishay / Dale | CRCW04022K20FKEDC | Yageo | AF0402FR-072K2L | 2
66 | 1k 1% | Thick Film Resistors - SMD 1kOhm 1% | R71, R72, R110, R111, R112, R178, R257, R258, R259, R261, R287, R288, R289, R290 | RES_0402_L | Res.SchLib | Vishay / Dale | CRCW04021K00FKEDC | Yageo | RC0402FR-7W1KL | 14
67 | 75R 1% | Thick Film Resistors - SMD 75Ohm 1% | R73, R74, R75, R78 | RES_0805 | Res.SchLib | Bourns | CR0805-FX-75R0ELF | Panasonic | ERJ-6ENF75R0V | 4
68 | 110R 1% | Thick Film Resistors - SMD 110Ohm 1% | R76, R77, R275, R277, R279, R281 | RES_0402_L | Res.SchLib | Vishay / Dale | CRCW0402110RFKTD | Yageo | RC0402FR-7W110RL | 6
69 | 12k 1% | Thick Film Resistors - SMD 12kOhm 1% | R79 | RES_0402_L | Res.SchLib | Vishay / Dale | CRCW040212K0FKEDC | Yageo | RC0402FR-7W12KL | 1
70 | 10k 1% | Thick Film Resistors - SMD 10kOhm 1% | R80, R85, R91, R92, R93, R102, R113, R116, R155, R156, R157, R160, R163, R175, R179, R180, R185, R255, R260, R291 | RES_0402_L | Res.SchLib | Vishay / Dale | CRCW040210K0FKEDC | Yageo | RC0402FR-7W10KL | 20
71 | 16k 1% | Thick Film Resistors - SMD 16kOhm 1% | R81 | RES_0402_L | Res.SchLib | Vishay / Dale | CRCW040216K0FKED | Yageo | RC0402FR-0716KL | 1
72 | 12.4k 1% | Thick Film Resistors - SMD 12.4kOhm 1% | R86 | RES_0402_L | Res.SchLib | Vishay / Dale | CRCW040212K4FKEDC | Yageo | RC0402FR-0712K4L | 1
73 | 1.6k 1% | Thick Film Resistors - SMD 1.6kOhm 1% | R87, R88, R89, R90, R153, R154, R158, R159, R168, R169, R172, R173, R174, R197, R198, R199, R208, R209, R283, R284, R285, R286 | RES_0402_L | Res.SchLib | Vishay / Dale | CRCW04021K60FKEDC | Yageo | RC0402FR-7W1K6L | 22
74 | 22R 1% | Thick Film Resistors - SMD 22Ohm 1% | R97, R99, R100, R101, R114, R115 | RES_0402_L | Res.SchLib | Vishay / Dale | CRCW040222R0FKEDC | Yageo | RC0402FR-7W22RL | 6
75 | 270R 1% | Thick Film Resistors - SMD 270Ohm 1% | R106, R108 | RES_0402_L | Res.SchLib | Vishay / Dale | CRCW0402270RFKEDC | Yageo | RC0402FR-07270RL | 2
76 | 360R 1% | Thick Film Resistors - SMD 360Ohm 1% | R107 | RES_0402_L | Res.SchLib | Vishay / Dale | CRCW0402360RFKED | Yageo | AC0402FR-07360RL | 1
77 | 20k 1% | Thick Film Resistors - SMD 20kOhm 1% | R131, R149, R207 | RES_0402_L | Res.SchLib | Vishay / Dale | CRCW040220K0FKEDC | Yageo | RC0402FR-7D20KL | 3
78 | 1M 1% | Thick Film Resistors - SMD 1MOhm 1% | R137, R150, R210 | RES_0402_L | Res.SchLib | Vishay / Dale | CRCW04021M00FKEDC | Yageo | RC0402FR-071ML | 3
79 | 30.1k 1% | Thick Film Resistors - SMD 30.1kOhm 1% | R151 | RES_0402_L | Res.SchLib | Vishay / Dale | CRCW040230K1FKEDC | Yageo | RC0402FR-1330K1L | 1
80 | 4.64k 1% | Thick Film Resistors - SMD 4.64kOhm 1% | R152 | RES_0402_L | Res.SchLib | Vishay / Dale | CRCW04024K64FKEDC | Yageo | RC0402FR-134K64L | 1
81 | 100k 1% | Thick Film Resistors - SMD 100kOhm 1% | R161, R162 | RES_0402_L | Res.SchLib | Vishay / Dale | CRCW0402100KFKEDC | Yageo | RC0402FR-7W100KL | 2
82 | 200R 1% | Thick Film Resistors - SMD 200Ohm 1% | R189, R190, R191, R192, R193, R194, R195, R196, R276, R278, R280, R282 | RES_0402_L | Res.SchLib | Vishay / Dale | CRCW0402200RFKEDC | Yageo | AF0402FR-07200RL | 12
83 | 5.62k 1% | Thick Film Resistors - SMD 5.62kOhm 1% | R213, R233, R254 | RES_0402_L | Res.SchLib | Vishay / Dale | CRCW04025K62FKEDC | Yageo | AC0402FR-7W5K62L | 3
84 | 267R 1% | Thick Film Resistors - SMD 267Ohm 1% | R215, R226, R242, R252 | RES_0402_L | Res.SchLib | Vishay / Dale | CRCW0402267RFKED | Yageo | RC0402FR-07267RL | 4
85 | 1.33k 1% | Thick Film Resistors - SMD 1.33kOhm 1% | R220, R229, R234, R235 | RES_0402_L | Res.SchLib | Vishay / Dale | CRCW04021K33FKEDC | Yageo | AC0402FR-071K33L | 4
86 | 536R 1% | Thick Film Resistors - SMD 536Ohm 1% | R222, R241 | RES_0402_L | Res.SchLib | Vishay / Dale | CRCW0402536RFKED | Yageo | RC0402FR-07536RL | 2
87 | 931R 1% | Thick Film Resistors - SMD 931Ohm 1% | R236 | RES_0402_L | Res.SchLib | Vishay / Dale | CRCW0402931RFKED | Yageo | RC0402FR-07931RL | 1
88 | 2.67k 1% | Thick Film Resistors - SMD 2.67kOhm 1% | R243 | RES_0402_L | Res.SchLib | Vishay / Dale | CRCW04022K67FKEDC | Yageo | AC0402FR-072K67L | 1
89 | 3.32k 1% | Thick Film Resistors - SMD 3.32kOhm 1% | R244 | RES_0402_L | Res.SchLib | Vishay / Dale | CRCW04023K32FKEDC | Yageo | AC0402FR-073K32L | 1
90 | LL3301BF065QJ | SPST Top Actuated Button, 65gf, SMD h: 9.8mm | S1, S2, S4, S5, S7, S8, S9, S12 | LL3301BF065QJ | Electro_Mech.SchLib | E-Switch | LL3301BF065QJ |  |  | 8
91 | DS04-254-1-03BK-SMT | SMD DIP Switch, 3 Pos, Slide actuator | S3, S6, S10, S11 | CUI DS04-254-SMT Series, 3 Pole | Electro_Mech.SchLib | CUI Devices | DS04-254-1-03BK-SMT |  |  | 4
92 | 7101MD9AV2BE | Kippschalter SPDT Right Angle Vertical | S13 | 7101MD9AV2BE | Electro_Mech.SchLib | C&K | 7101MD9AV2BE |  |  | 1
93 | QT24A01 | 1:1 350 28 1.2 -1 -16 SMD,24PIN RJ45 Transformer RoHS | T1 | QT24A01 | Indc.SchLib | TNK | QT24A01 |  |  | 1
94 | XC7K160T-3FFG676E | Kintex-7 FPGA, 400 User I/Os, 8 GTX, 676-Ball BGA, Speed Grade 3, Extended Grade, Pb-Free | U1 | BGA100P2700X2700X317-676N | Digital.SchLib | Xilinx | XC7K160T-3FFG676E |  |  | 1
95 | TPS51200DRCT | Sink and Source DDR Termination Regulator | U2 | QFN50P300X300X100-11N | Power.SchLib | Texas Instruments | TPS51200DRCT |  |  | 1
96 | NL17SZ07DFT2G | Puffer u. Leitungstreiber 1.65-5.5V Single Non-Inverting | U3, U4 | SOT65P210X110-5N | Digital.SchLib | ON Semiconductor | NL17SZ07DFT2G |  |  | 2
97 | AP21510FM-7 | Power Switch ICs - Power Distribution 0.5A SGL Ch USB 2.0 Curr Limited Switch | U5, U20 | QFN50P201X181X60_HS-7N | Power.SchLib | Diodes Incorporated | AP21510FM-7 |  |  | 2
98 | TLV62568ADRL | Step Down Converter with Forced PWM in SOT563 Package | U6 | SON50P150X80-6N | Power.SchLib | Texas Instruments | TLV62568ADRL |  |  | 1
99 | VL822-Q7 | USB Interface IC USB 3.1 Hub 4 Ports | U7 | QFN50P900X900X85-76N | Digital.SchLib | VIA Labs | VL822-Q7 |  |  | 1
100 | AP22811AW5-7 | Power Switch ICs - Power Distribution Load Switch | U8 | SOT95P285X140-5N | Power.SchLib | Diodes Incorporated | AP22811AW5-7 |  |  | 1
101 | FSUSB42MUX | IC USB SWITCH DPDT | U9, U10 | SOP50P300X300X110-10N | Digital.SchLib | onsemi / Fairchild | FSUSB42MUX |  |  | 2
102 | JTAG-SMT3-NC | Surface-mount JTAG Programming + UART Module | U11 | JTAG-SMT3-NC | Conn_Modules.SchLib | Digilent | JTAG-SMT3-NC |  |  | 1
103 | 74LV1T34GV-Q100H | Single supply translating buffer | U12 | SOT95P275X110-5N | Digital.SchLib | Nexperia | 74LV1T34GV-Q100H |  |  | 1
104 | FT234XD-R | IC USB SERIAL BASIC UART 12DFN | U13 | QFN45P300X300x75_-12N | Digital.SchLib | FTDI | FT234XD-R |  |  | 1
105 | S40FC004C1B2C00000 | eMMC 4GB e.MMC5.1 BGA 9.0 x 7.5 x 0.8 mm | U14 | BGA50P900X750X080-153N | Digital.SchLib | SkyHigh Memory | S40FC004C1B2C00000 |  |  | 1
106 | SN74LVC1G18DBVR | 1:2 Noninverting Demultiplexer With 3-State Deselected Output | U15 | SOT95P275X110-6N | Digital.SchLib | Texas Instruments | SN74LVC1G18DBVR |  |  | 1
107 | TXB0302DQMR | Translation - Voltage Levels 2B Bidir Vltg-Level Translator | U16, U24 | SON40P120X40-8N | Digital.SchLib | Texas Instruments | TXB0302DQMR |  |  | 2
108 | MT25QU256ABA8ESF-0SIT | NOR-Flash SPI 256Mbit NOR-Flash /1.8V | U17 | SOIC16_Widebody | Digital.SchLib | Micron | MT25QU256ABA8ESF-0SIT |  |  | 1
109 | TXB0108RGYR | Translation - Voltage Levels 8B Bidir Vltg-Level Translator | U18 | QFN50P450X350X100-21N | Digital.SchLib | Texas Instruments | TXB0108RGYR |  |  | 1
110 | TMDS141RHAR | HDMI Hider, 130 mA, 6 kV, 0 to +70 degC, 40-pin QFN | U19 | QFN50P600X600X100-41N | Digital.SchLib | Texas Instruments | TMDS141RHAR |  |  | 1
111 | AD8195ACPZ | IC VIDEO HDMI/DVI BUFFER 40LFCSP | U21 | QFN50P600X600X100-41N | Digital.SchLib | Analog Devices | AD8195ACPZ |  |  | 1
112 | TCA9548ARGERQ1 | Automotive 8-Channel I2C Switch with Reset | U22 | QFN50P400X400X100-25N | Digital.SchLib | Texas Instruments | TCA9548ARGERQ1 |  |  | 1
113 | SI5324C-C-GM | PRECISION CLOCK MULTIPLIER/ JITTER ATTENUATOR | U23 | QFN50P600X600X85-37N | Timer.SchLib | Skyworks Solutions, Inc. | SI5324C-C-GM |  |  | 1
114 | L7805CDT-TR | Linear Voltage Regulators 5.0V 1.0A Positive | U25 | DPAK230P991X241-3N | Power.SchLib | STMicroelectronics | L7805CDT-TR |  |  | 1
115 | TPS37043BJOFDDFRQ1 | Triple Supply Voltage Window Supervisors With Fixed Delay, Open Drain Output | U26, U27 | SOT65P295X160-8N | Comp.SchLib | Texas Instruments | TPS37043BJOFDDFRQ1 |  |  | 2
116 | LMZ22010TZE/NOPB | 10A SIMPLE SWITCHER® Power Module with 20V Maximum Input and Current Sharing | U28, U29, U30, U31, U32, U33, U34, U35, U38, U39 | TI Simpleswitcher NDY0011A_N | Power.SchLib | Texas Instruments | LMZ22010TZE/NOPB |  |  | 10
117 | PCT2075TP,147 | Digital Temp Sensor I2C | U36, U37 | SOT1069-2 (HWSON8) | Active.SchLib | NXP | PCT2075TP,147 |  |  | 2
118 | 74LVC1G14GV,125 | Inverter Single inverting Schmitt trigger | U40, U41 | SOT95P275X110-5N | Digital.SchLib | Nexperia | 74LVC1G14GV,125 |  |  | 2
119 | ECS-250-10-36B2-CTN-TR | 2.5 x 2.0 x 0.55 mm SMD Crystal | Y1 | ECX-2236B | Timer.SchLib | ECS | ECS-250-10-36B2-CTN-TR |  |  | 1
120 | ASVMB-66.000MHZ-XY-T | Clock-Memsoszillator 66.000MHz 1.8V 10ppm -40C +105C | Y2 | ASVMB Series | Timer.SchLib | ABRACON | ASVMB-66.000MHZ-XY-T |  |  | 1
121 | CS-023-114.285M | 3.2 x 2.5 x 0.8 mm SMD Crystal | Y3 | S3D - Shenzhen SCTF Elec | Timer.SchLib | Connor Winfield | CS-023-114.285M |  |  | 1
122 | AX3DCF1-200.0000 | 200MHz Clock Oscillator, 1V8, LVDS | Y4 | Abracon AX3 | Timer.SchLib | Abracon | AX3DCF1-200.0000 |  |  | 1
123 | 511JBA150M000BAG | 150MHz Clock Oscillator, 1V8, LVDS | Y5 | Abracon AX3 | Timer.SchLib | Skyworks Solutions, Inc. | 511JBA150M000BAG |  |  | 1
124 | AX3DCF1-156.2500 | 156.25MHz Clock Oscillator, 1V8, LVDS | Y6 | Abracon AX3 | Timer.SchLib | Abracon | AX3DCF1-156.2500 |  |  | 1
Approved |  |  | Notes |  |  |  |  |  |  | 860
 |  |  | The information contained in these documents is confidential, privileged and only for the information of the intended recipient and may not be used, published or redistributed without the prior written consent from PCB Arts GmbH. |  |  |  | PCB Arts GmbH https://pcb-arts.com/ Sitz: Fürth, Bayern Registergericht: Amtsgericht Fürth, HRB 16070 Geschäftsführer: Saber Kaygusuz
