pcbarts/fast-open-switch-hardware/CM4 to FMC Adapter/CM4 to FMC Adapter r2.0/Output Data 230405/PCBA/CM4 to FMC Adapter r2.0.xlsx

 | Bill of Materials |  | RPi_CM4_Testadapter
 | Source Data From: |  | RPi_CM4_Testadapter.PrjPcb
 | Project: |  | RPi_CM4_Testadapter.PrjPcb
 | Variant: |  | None
 | Report Date: | 05.04.2023 | 10:20
 | Print Date: | 2023-04-05 | 16:48:10
# | Comment | Description | Designator | Footprint | Library Name | Manufacturer 1 | Manufacturer 1 Prt. Nr. | Manufacturer 2 | Manufacturer 2 Prt. Nr. | Quantity
1 | 100µF 10V | Organische Polymer-Aluminiumkondensatoren 100uF 10 Volts 20% | C1 | WCAP-ASLI_D5H5.5 | Cap.SchLib | Würth Elektronik | 875105242010 |  |  | 1
2 | 1µF 16V | Multilayer Ceramic Capacitors MLCC - SMD/SMT 0402 16VDC | C2, C25 | CAP_0402 | Cap.SchLib | Taiyo Yuden | EMK105BJ105MVHF | Murata Electronics | GRM155R61E105KA12D | 2
3 | 100nF 50V | Multilayer Ceramic Capacitors MLCC - SMD/SMT 0402 50VDC | C3, C10, C11, C13, C16, C22, C23, C24, C27 | CAP_0402 | Cap.SchLib, AlemNano 201029.SchLib | Murata Electronics | GCM155L8EH104KE07D | TDK | UMK105B7104KV-FR | 9
4 | 10nF 50V | Multilayer Ceramic Capacitors MLCC - SMD/SMT 0402 50VDC | C4, C5, C6, C7 | CAP_0402 | Cap.SchLib | Wurth Elektronik | 885012205067 | Yageo | AC0402KPX7R9BB103 | 4
5 | 1nF 2000V | Multilayer Ceramic Capacitors MLCC - SMD/SMT 1206 2000VDC | C8 | CAP_1206 | Cap.SchLib | Yageo | CC1206MKX7RDBB102 | Walsin | 1206B102M202CT | 1
6 | 10µF 6.3V | Multilayer Ceramic Capacitors MLCC - SMD/SMT 0603 6.3VDC | C9, C17, C18, C26 | CAP_0603 | Cap.SchLib, AlemNano 201029.SchLib | Murata Electronics | GRM188R60J106ME84J | Taiyo Yuden | JMK107ABJ106MA-T | 4
7 | 10µF 16V | Multilayer Ceramic Capacitors MLCC - SMD/SMT 0805 16VDC | C12, C14 | CAP_0805 | AlemNano 201029.SchLib | Taiyo Yuden | EMK212ABJ106KG-T | TDK | C2012X5R1C106K085AC | 2
8 | 22nF 50V | Multilayer Ceramic Capacitors MLCC - SMD/SMT 0402 50VDC | C19 | CAP_0402 | AlemNano 201029.SchLib | Murata Electronics | GCM155R71H223KA55D | TDK | UMK105B7223KV-FR | 1
9 | 12pF 50V | Multilayer Ceramic Capacitors MLCC - SMD/SMT 0402 50VDC | C20 | CAP_0402 | AlemNano 201029.SchLib | Murata Electronics | GCM1555C1H120JA16J | KEMET | C0402C120J5GACTU | 1
10 | 1.8nF 50V | Multilayer Ceramic Capacitors MLCC - SMD/SMT 0402 50VDC | C21 | CAP_0402 | AlemNano 201029.SchLib | Yageo | CC0402JRX7R9BB182 | Murata Electronics | GCM155R71H182JA37D | 1
11 | 100nF 50V | Multilayer Ceramic Capacitors MLCC - SMD/SMT 0402 50VDC | C28 | CAP_0402_L | Cap.SchLib | Murata Electronics | GCM155L8EH104KE07D | TDK | UMK105B7104KV-FR | 1
12 | LTST-S270KGKT | GREEN 0603 Light Emitting Diode | D1 | LED-0603 Sideview | Active.SchLib | lite-On | LTST-S270KGKT |  |  | 1
13 | CESDP0402UC5VB | Low Capacitance ESD Protection Diode 0402 | D2, D3, D4, D5, D6, D7, D8, D9, D10, D11, D12, D13, D14, D15, D16, D17, D18, D19, D20, D22, D23, D24, D25, D26, D27, D28, D29, D30, D31, D32, D33, D34, D35, D36, D37, D38, D39, D40, D41, D42, D43, D44, D45, D46, D47, D48, D49, D50, D51, D52, D53, D54 | TVS_0402 | Protec.SchLib | CREATEK | CESDP0402UC5VB | BORN | BPESD0402-05ST | 52
14 | LTST-S270KRKT | RED 0603 Light Emitting Diode | D21 | LED-0603 Sideview | Active.SchLib | lite-On | LTST-S270KRKT |  |  | 1
15 | 9774030151R | Würth Standoff M2.5 h:3.0mm 9774030151R | H1, H2, H3, H4 | 9774030151R | Electro_Mech.SchLib | Würth Elektronik | 9774030151R |  |  | 4
16 | 9774100151R | Würth Standoff M2.5 h:10mm 9774050151R | H5, H6 | 9774100151R | Electro_Mech.SchLib | Würth Elektronik | 9774100151R |  |  | 2
17 | Hirose Hirose DF40HC(3.0)-100DS-0.4V | Hirose DF40HC(3.0)-100DS-0.4V 3mm heigth receptacle for Raspberry Pi CM4, Pin 1-100 | J1 | Hirose DF40HC(3.0)-100DS-0.4V_1-100 | Conn.SchLib | Hirose | DF40HC(3.0)-100DS-0.4V |  |  | 1
18 | Hirose DF40HC(3.0)-100DS-0.4V PiMC4 Pin 101-200 | Hirose DF40C-100DS-0.4V 3mm heigth receptacle for Raspberry Pi CM4, Pin 101-200 | J2 | Hirose DF40HC(3.0)-100DS-0.4V_PiCM4_101_200 | Conn.SchLib | Hirose | DF40HC(3.0)-100DS-0.4V |  |  | 1
19 | CU01SAH0S00 | USB-A USB 2.0 Buchse Steckverbinder, rechtwinklig | J3 | USB_A_2.0_single | Conn.SchLib | Cvilux USA | CU01SAH0S00 |  |  | 1
20 | MICRO5.9mmusb | SHOU HAN MICRO5.9mmusb | J4 | MICRO5.9mmusb | Conn.SchLib | SHOU HAN | MICRO5.9mmusb |  |  | 1
21 | DC-005-5A-2.0 | DC Power Receptacle Jack 5.5/2.1mm | J6 | DC-005-5A-2.0 | Conn.SchLib | XKB Enterprise | DC-005-5A-2.0 |  |  | 1
22 | LCSC C60561 | Pin header 2.54mm 4Pol right angle | J10 | LCSC C60561 | Conn.SchLib | BOOMELE(Boom Precision Elec) | C60561 |  |  | 1
23 | TF-115 | microSD™ Memory Card 8 connector&Ejector 14.5x14.75x1.85mm Card Sockets Connector | J11 | TF-115 | Conn.SchLib | XUNPU | TF-115 |  |  | 1
24 | R-RJ45R08P-C000 | RJ45 8 1 Shielded Yellow - Green Through Hole Ethernet Connectors/Modular Connectors (RJ45 RJ11) RoHS | J12 | Ckmtw - R-RJ45R08P-C000 | Conn.SchLib | Ckmtw(Shenzhen Cankemeng) | R-RJ45R08P-C000 |  |  | 1
25 | HDMI-001_C138388 | HDMI Connector Female 19 Pin LCSC C138388 | J13 | BOOMELE HDMI-001 | Conn.SchLib | BOOMELE(Boom Precision Elec) | HDMI-001 |  |  | 1
26 | ASP-134604-01 | Female FMC-Connector mating plug | J14 | ASP-134604-01 | Conn.SchLib | Samtec | ASP-134604-01 |  |  | 1
27 | MS1350-3R3M | 3.3uH ±20% 13A 7.5mΩ SMD,13.8x12.6x5mm Inductor | L2 | MS1350 | AlemNano 201029.SchLib | COILMX | MS1350-3R3M |  |  | 1
28 | RPiCM4 | Raspberry Pi 4 Compute Module 4 | PC1 | RaspberryPi_CM4 | Mechanical.SchLib | Raspberry Pi | Compute Module 4 |  |  | 1
29 | 1k 1% | Thick Film Resistors - SMD 1kOhm 1% | R1, R12, R13, R14 | RES_0402 | Res.SchLib | Vishay / Dale | CRCW04021K00FKEDC | Yageo | RC0402FR-7W1KL | 4
30 | 75R 1% | Thick Film Resistors - SMD 75Ohm 1% | R2, R3, R9, R10 | RES_0805 | Res.SchLib | Bourns | CR0805-FX-75R0ELF | Panasonic | ERJ-6ENF75R0V | 4
31 | 0R Jumper | Thick Film Resistors - SMD 0Ohm | R4, R15 | RES_0402 | Res.SchLib | Vishay / Dale | CRCW04020000Z0EDC | Yageo | RC0402JR-070RL | 2
32 | 16.2k 1% | Thick Film Resistors - SMD 16.2kOhm 1% | R5 | RES_0402 | AlemNano 201029.SchLib | Vishay / Dale | CRCW040216K2FKED | Yageo | RC0402FR-0716K2L | 1
33 | 52.3k 1% | Thick Film Resistors - SMD 52.3kOhm 1% | R6 | RES_0402 | AlemNano 201029.SchLib | Vishay / Dale | CRCW040252K3FKEDC | Yageo | AC0402FR-0752K3L | 1
34 | 4.02k 1% | Thick Film Resistors - SMD 4.02kOhm 1% | R7 | RES_0402 | AlemNano 201029.SchLib | Vishay / Dale | CRCW04024K02FKEDC | Panasonic | ERJ-2RKF4021X | 1
35 | 2.21k 1% | Thick Film Resistors - SMD 2.21kOhm 1% | R8 | RES_0402 | AlemNano 201029.SchLib | Vishay / Dale | CRCW04022K21FKEDC | Yageo | RC0402FR-7W2K21L | 1
36 | 10k 1% | Thick Film Resistors - SMD 10kOhm 1% | R11 | RES_0402 | Res.SchLib | Vishay / Dale | CRCW040210K0FKEDC | Yageo | RC0402FR-7W10KL | 1
37 | 2.2k 1% | Thick Film Resistors - SMD 2.2kOhm 1% | R16, R17 | RES_0402_L | Res.SchLib | Vishay / Dale | CRCW04022K20FKEDC | Yageo | AF0402FR-072K2L | 2
38 | LL3301BF065QJ | SPST Top Actuated Button, 65gf, SMD h: 9.8mm | S1 | LL3301BF065QJ | Electro_Mech.SchLib | XKB Connectivity | TC-1109DE-C-B |  |  | 1
39 | Solderbridge_0402 | Solderbridge_0402 | SJ1, SJ2, SJ3, SJ4 | Solderbridge_0402 | Conn.SchLib |  |  |  |  | 4
40 | QT24A01 | 1:1 350 28 1.2 -1 -16 SMD,24PIN RJ45 Transformer RoHS | T1 | QT24A01 | Indc.SchLib | TNK | QT24A01 |  |  | 1
41 | AP22811AW5-7 | Power Switch ICs - Power Distribution Load Switch | U1, U3 | SOT95P285X140-5N | Power.SchLib | Diodes Incorporated | AP22811AW5-7 |  |  | 2
42 | AP21510FM-7 | Power Switch ICs - Power Distribution 0.5A SGL Ch USB 2.0 Curr Limited Switch | U2 | QFN50P201X181X60_HS-7N | Power.SchLib | Diodes Incorporated | AP21510FM-7 |  |  | 1
43 | TPS54821RHLR | 4.5 V to 17 V Input, 8 A Synchronous Step Down Converter | U4 | VQFN14U3535 | AlemNano 201029.SchLib | Texas Instruments | TPS54821RHLR |  |  | 1
44 | NL17SZ07DFT2G | Puffer u. Leitungstreiber 1.65-5.5V Single Non-Inverting | U5, U6 | SOT65P210X110-5N | Digital.SchLib | ON Semiconductor | NL17SZ07DFT2G |  |  | 2
45 | FSUSB42MUX | IC USB SWITCH DPDT | U7 | SOP50P300X300X110-10N | Digital.SchLib | onsemi / Fairchild | FSUSB42MUX |  |  | 1
Approved |  |  | Notes |  |  |  |  |  |  | 129
 |  |  | The information contained in these documents is confidential, privileged and only for the information of the intended recipient and may not be used, published or redistributed without the prior written consent from PCB Arts GmbH. |  |  |  | PCB Arts GmbH https://pcb-arts.com/ Sitz: Fürth, Bayern Registergericht: Amtsgericht Fürth, HRB 16070 Geschäftsführer: Saber Kaygusuz
