pcbarts/fast-open-switch-hardware/fast-open-switch r1.0 - KiCad/ALTIUM_EMBEDDED_MODELS/X2SON-8 vergleichbar mit TXB0302DQMR.stp

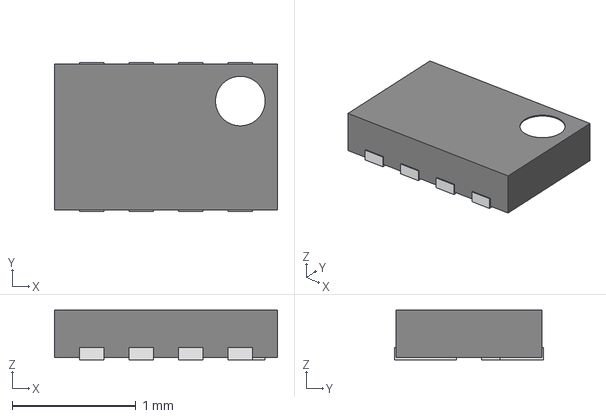
[picture p2: CAD file, 2023-05-11]
fast-open-switch r1.0 - KiCad/ALTIUM_EMBEDDED_MODELS/X2SON-8 vergleichbar mit TXB0302DQMR.stp
1.80 x 1.20 x 0.4 mm
