pcbarts/fast-open-switch-hardware/fast-open-switch r1.0 - KiCad/ALTIUM_EMBEDDED_MODELS/OLED.stp

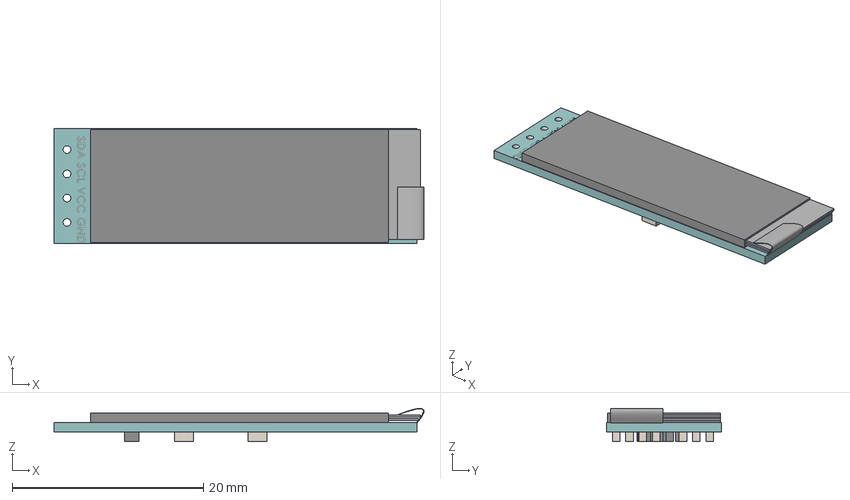
[picture p3: CAD file, 2023-05-11]
fast-open-switch r1.0 - KiCad/ALTIUM_EMBEDDED_MODELS/OLED.stp
38.7 x 12.0 x 3.46 mm
