pcbarts/fast-open-switch-hardware/fast-open-switch r1.0 - KiCad/ALTIUM_EMBEDDED_MODELS/SOT-353.stp

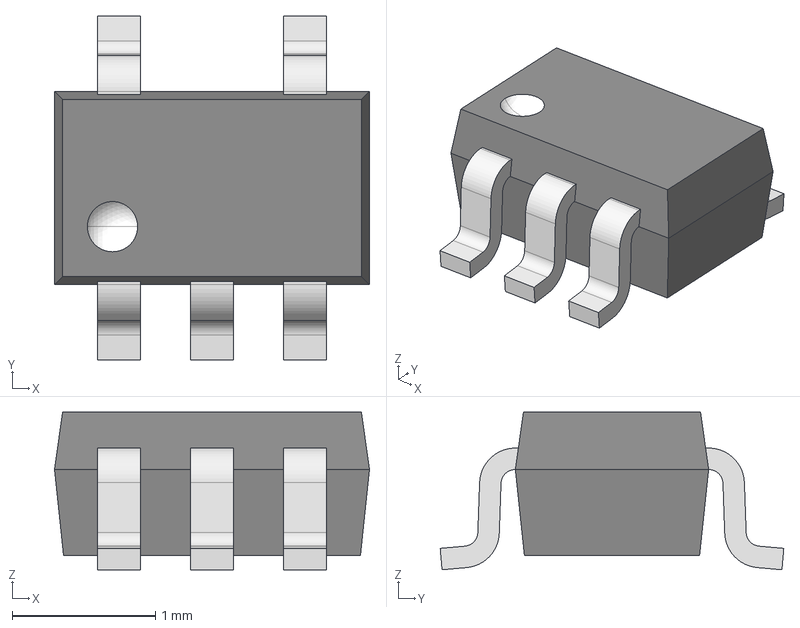
[picture p4: CAD file, 2023-05-11]
fast-open-switch r1.0 - KiCad/ALTIUM_EMBEDDED_MODELS/SOT-353.stp
2.20 x 2.40 x 1.10 mm
