pcbarts/fast-open-switch-hardware/fast-open-switch r1.0 - KiCad/ALTIUM_EMBEDDED_MODELS/TVS Diode vergleichbar mit CESDP0402UC5VB.stp

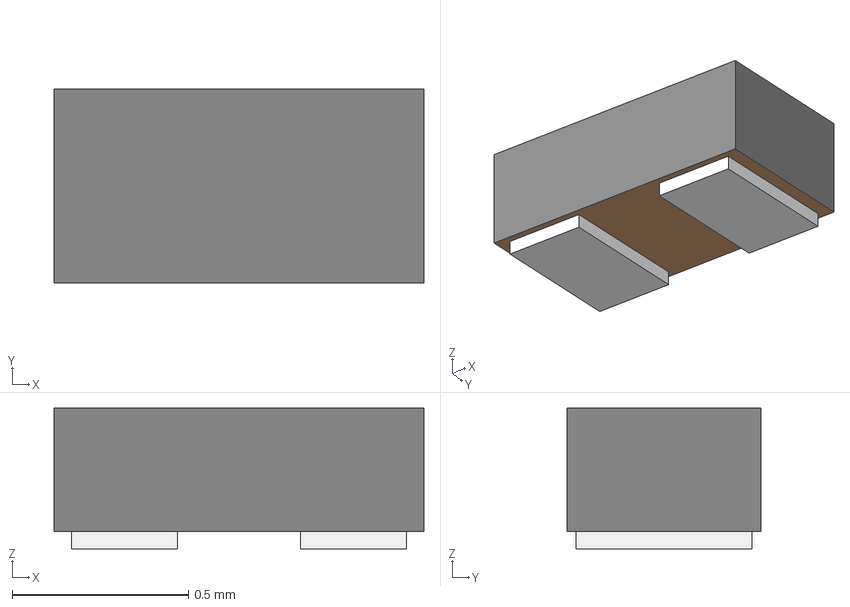
[picture p5: CAD file, 2023-05-11]
fast-open-switch r1.0 - KiCad/ALTIUM_EMBEDDED_MODELS/TVS Diode vergleichbar mit CESDP0402UC5VB.stp
1.05 x 0.55 x 0.4 mm
