pcbarts/fast-open-switch-hardware/fast-open-switch r1.0 - KiCad/ALTIUM_EMBEDDED_MODELS/10x12.5x5x0.6.stp

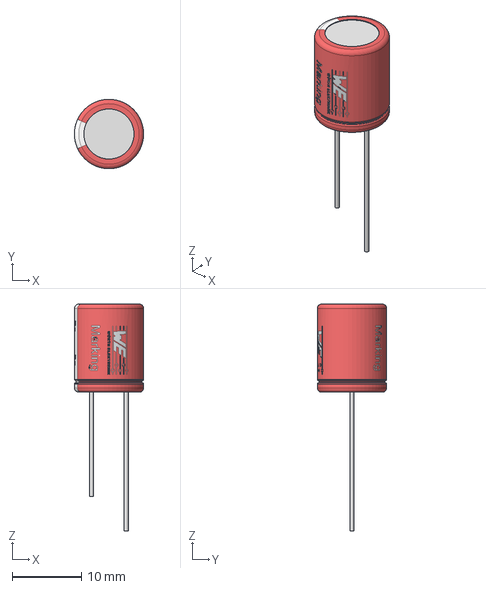
[picture p6: CAD file, 2023-05-11]
fast-open-switch r1.0 - KiCad/ALTIUM_EMBEDDED_MODELS/10x12.5x5x0.6.stp
9.99 x 10.00 x 32.7 mm
