pcbarts/fast-open-switch-hardware/fast-open-switch r1.0 - KiCad/ALTIUM_EMBEDDED_MODELS/ATS-61500W-C2-R0.STEP

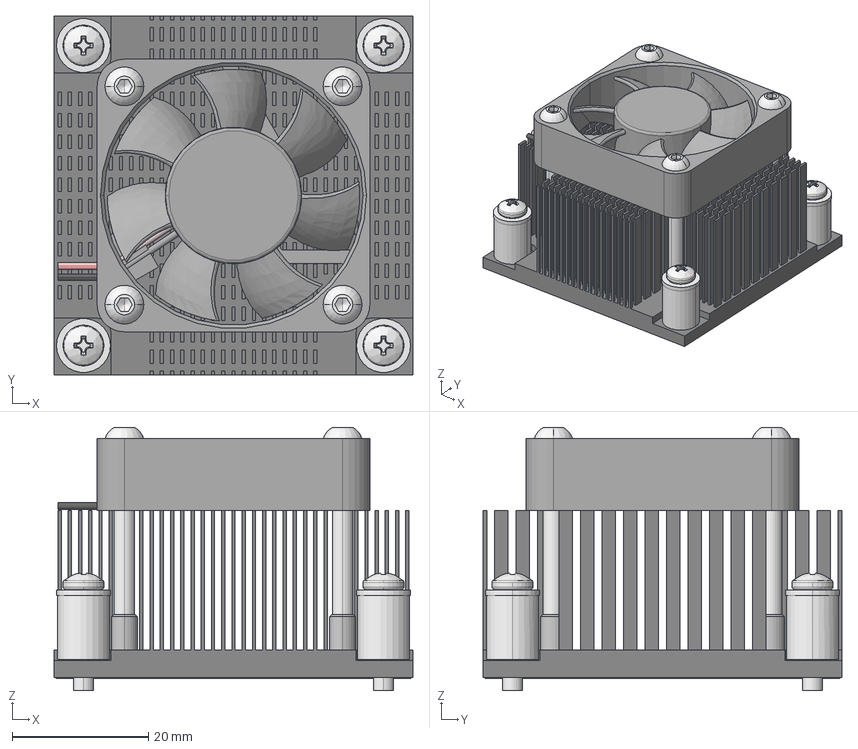
[picture p7: CAD file, 2023-05-11]
fast-open-switch r1.0 - KiCad/ALTIUM_EMBEDDED_MODELS/ATS-61500W-C2-R0.STEP
52.7 x 52.7 x 38.6 mm
40x40x10 DC Fan
schraube_iso_7380-m3x35-12_9 x 4
