pcbarts/fast-open-switch-hardware/fast-open-switch r1.0 - KiCad/ALTIUM_EMBEDDED_MODELS/7101MD9AV2BE.stp

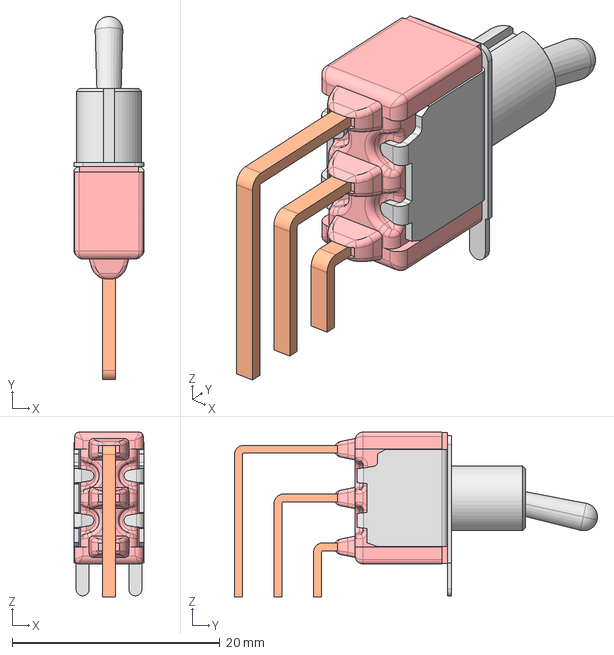
[picture p8: CAD file, 2023-05-11]
fast-open-switch r1.0 - KiCad/ALTIUM_EMBEDDED_MODELS/7101MD9AV2BE.stp
6.76 x 35.0 x 15.9 mm
7101MD9AV2BE_PART2
7101MD9AV2BE_PART1
