pcbarts/fast-open-switch-hardware/fast-open-switch r1.0 - KiCad/ALTIUM_EMBEDDED_MODELS/USB3.0x2 vergleichbar mit UEA11121-8FS6-4F.stp

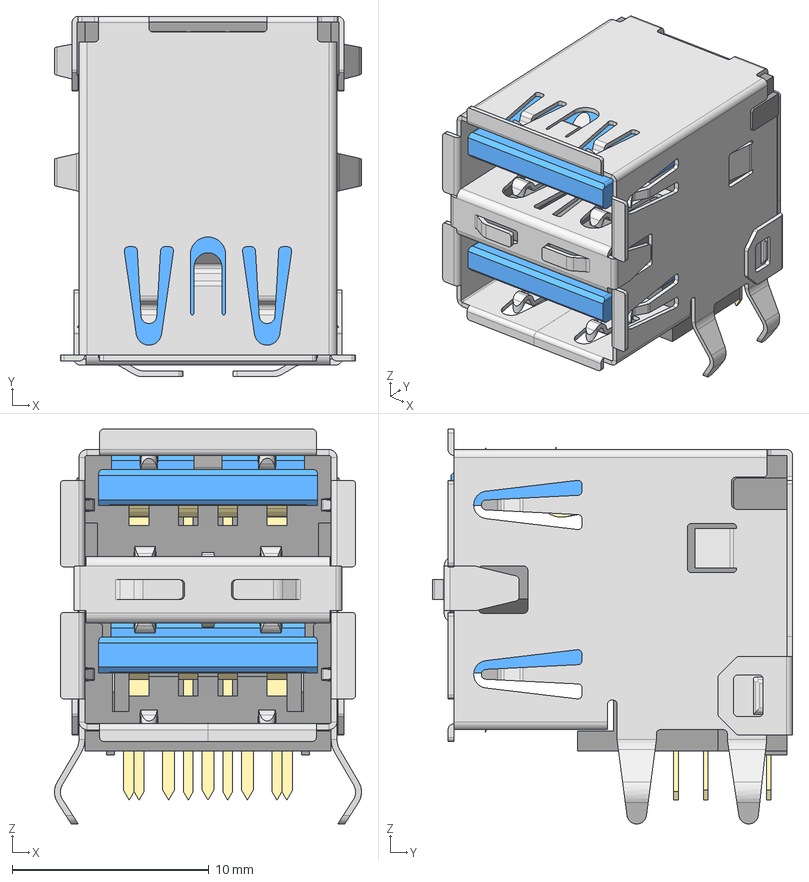
[picture p11: CAD file, 2023-05-11]
fast-open-switch r1.0 - KiCad/ALTIUM_EMBEDDED_MODELS/USB3.0x2 vergleichbar mit UEA11121-8FS6-4F.stp
15.6 x 18.3 x 20.1 mm
pin1 x 5
pin4 x 5
pin3 x 2
pin2 x 2
pin5 x 2
pin6 x 2
Housing1
Housing
Housing2
Housing4
Shielding2
Shielding
