pcbarts/fast-open-switch-hardware/fast-open-switch r1.0 - KiCad/ALTIUM_EMBEDDED_MODELS/Crystal 3.2x2.5_6p.stp

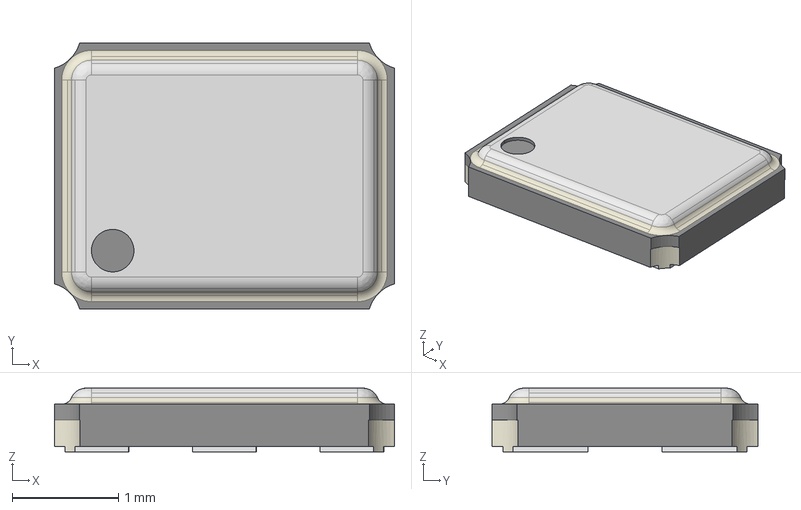
[picture p13: CAD file, 2023-05-11]
fast-open-switch r1.0 - KiCad/ALTIUM_EMBEDDED_MODELS/Crystal 3.2x2.5_6p.stp
3.20 x 2.50 x 0.6 mm
