pcbarts/fast-open-switch-hardware/fast-open-switch r1.0 - KiCad/ALTIUM_EMBEDDED_MODELS/uUSB vergleichbar mit C393940.stp

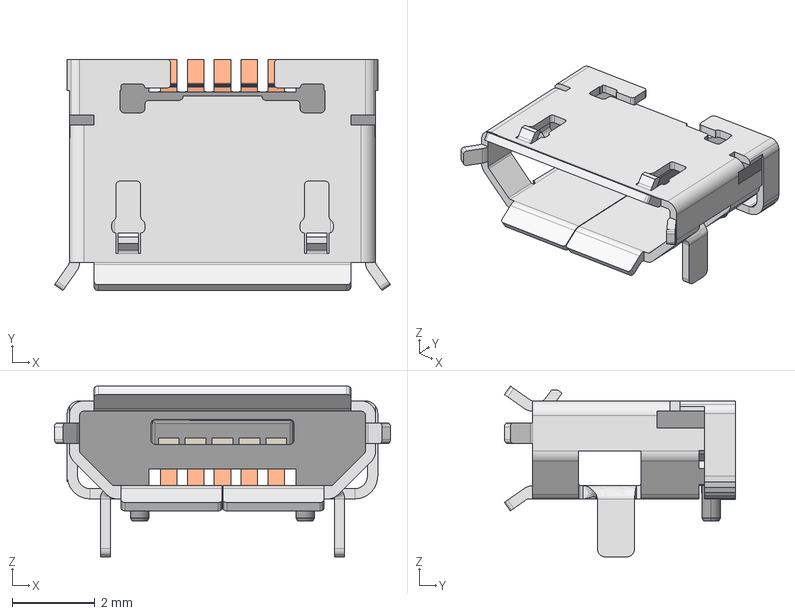
[picture p15: CAD file, 2023-05-11]
fast-open-switch r1.0 - KiCad/ALTIUM_EMBEDDED_MODELS/uUSB vergleichbar mit C393940.stp
8.11 x 5.59 x 4.13 mm
Shielding
Insulator
Pin x 5
