pcbarts/fast-open-switch-hardware/fast-open-switch r1.0 - KiCad/ALTIUM_EMBEDDED_MODELS/NDY0011A.stp

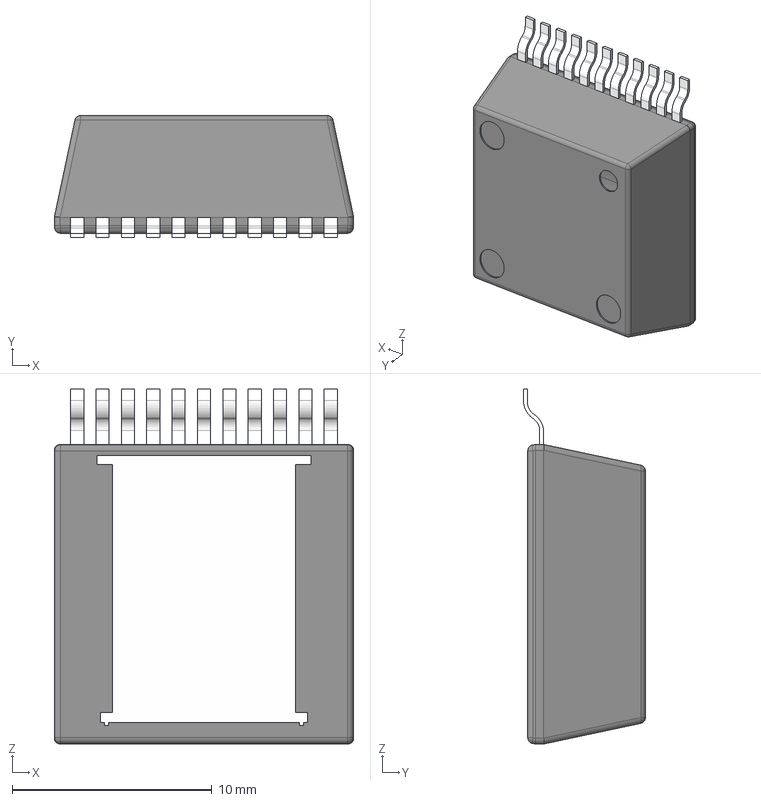
[picture p16: CAD file, 2023-05-11]
fast-open-switch r1.0 - KiCad/ALTIUM_EMBEDDED_MODELS/NDY0011A.stp
15.0 x 6.11 x 17.8 mm
LF_TOP_TZA11A
LF_BTM_TZA11A
BODY_TZA11A
LEAD_TZA11A x 11
