pcbarts/fast-open-switch-hardware/fast-open-switch r1.0 - KiCad/ALTIUM_EMBEDDED_MODELS/36-Lead 6 x 6 mm QFN.stp

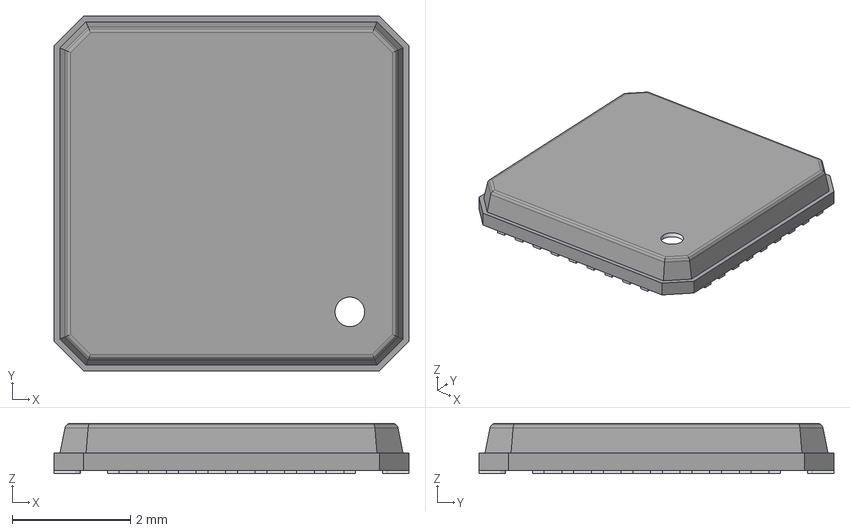
[picture p19: CAD file, 2023-05-11]
fast-open-switch r1.0 - KiCad/ALTIUM_EMBEDDED_MODELS/36-Lead 6 x 6 mm QFN.stp
6.00 x 6.00 x 0.85 mm
QFN Package
Pins
