pcbarts/fast-open-switch-hardware/fast-open-switch r1.0 - KiCad/ALTIUM_EMBEDDED_MODELS/JEDEC DDR3 204P SODIMM (1_5V).step

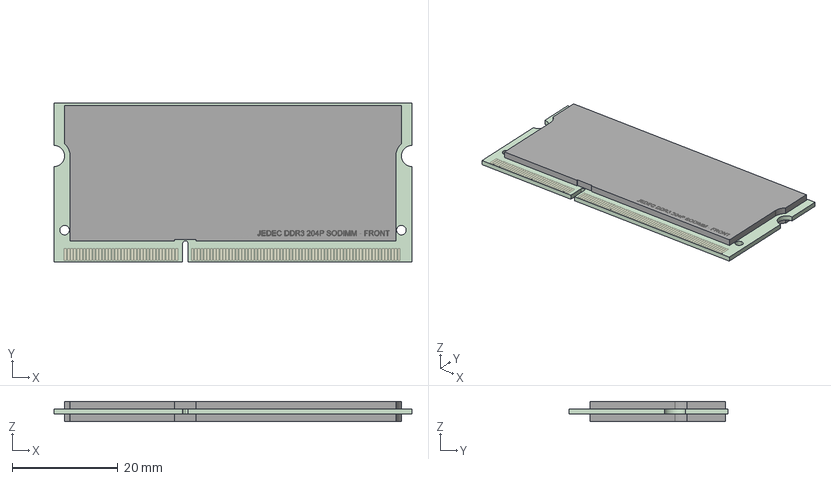
[picture p20: CAD file, 2023-05-11]
fast-open-switch r1.0 - KiCad/ALTIUM_EMBEDDED_MODELS/JEDEC DDR3 204P SODIMM (1_5V).step
67.6 x 30.0 x 3.80 mm
