pcbarts/fast-open-switch-hardware/fast-open-switch r1.0 - KiCad/ALTIUM_EMBEDDED_MODELS/QFN50P900X900X85-76N - VLI.step

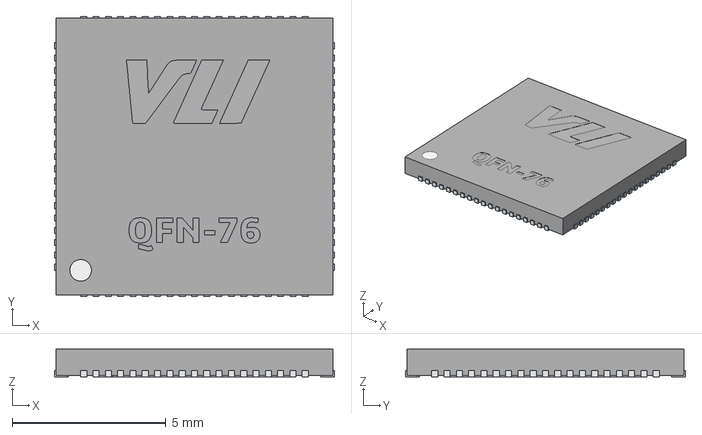
[picture p21: CAD file, 2023-05-11]
fast-open-switch r1.0 - KiCad/ALTIUM_EMBEDDED_MODELS/QFN50P900X900X85-76N - VLI.step
9.10 x 9.10 x 0.9 mm
