pcbarts/fast-open-switch-hardware/fast-open-switch r1.0 - KiCad/ALTIUM_EMBEDDED_MODELS/5x5.5x1.4.stp

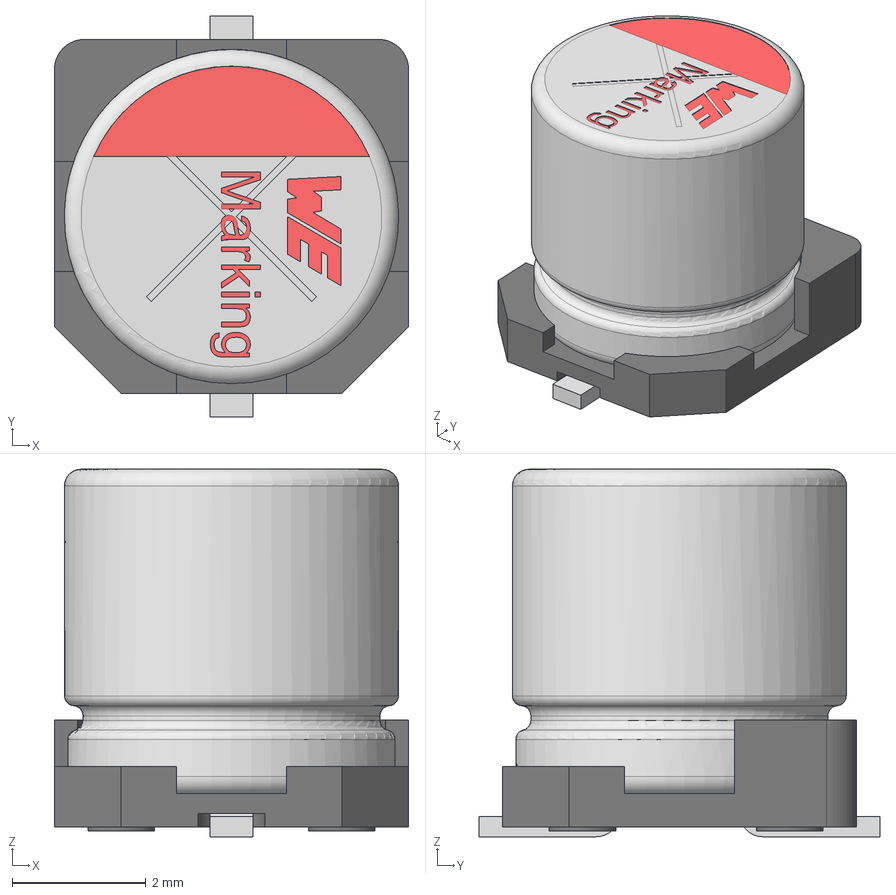
[picture p22: CAD file, 2023-05-11]
fast-open-switch r1.0 - KiCad/ALTIUM_EMBEDDED_MODELS/5x5.5x1.4.stp
5.30 x 6.00 x 5.50 mm
capicitor_5x5.5x1.4
Base_Φ5Capacitor
