pcbarts/fast-open-switch-hardware/fast-open-switch r1.0 - KiCad/ALTIUM_EMBEDDED_MODELS/Fan Connector vergleichbar pinrex 744-81-04TG20.stp

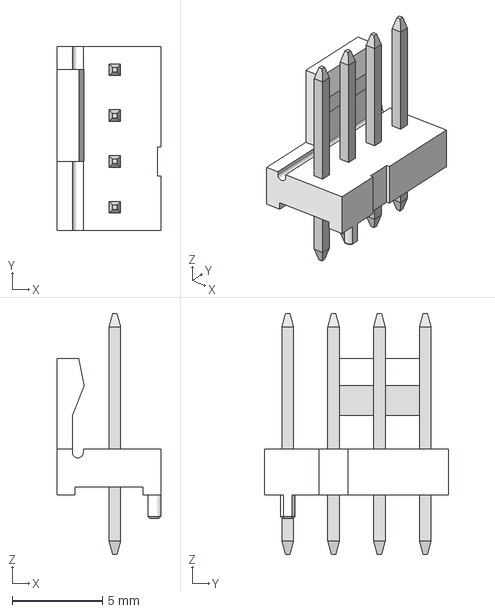
[picture p23: CAD file, 2023-05-11]
fast-open-switch r1.0 - KiCad/ALTIUM_EMBEDDED_MODELS/Fan Connector vergleichbar pinrex 744-81-04TG20.stp
5.75 x 10.2 x 13.4 mm
