pcbarts/fast-open-switch-hardware/fast-open-switch r1.0 - KiCad/ALTIUM_EMBEDDED_MODELS/DO221-AA.stp

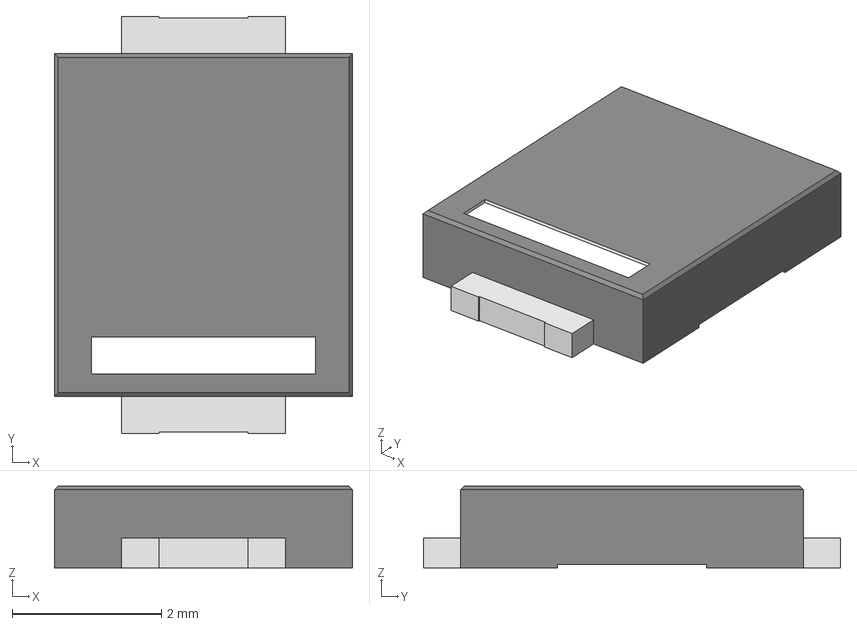
[picture p27: CAD file, 2023-05-11]
fast-open-switch r1.0 - KiCad/ALTIUM_EMBEDDED_MODELS/DO221-AA.stp
4.00 x 5.60 x 1.10 mm
Komponente2
Komponente3
Komponente4
