pcbarts/fast-open-switch-hardware/fast-open-switch r1.0 - KiCad/ALTIUM_EMBEDDED_MODELS/Inductor vergleichbar mit FXL0420-1R0-M.stp

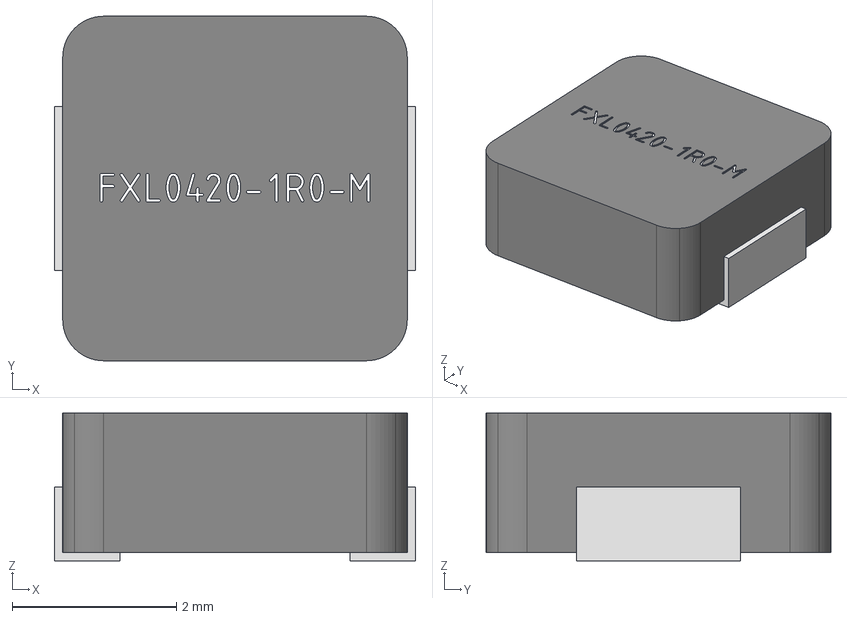
[picture p28: CAD file, 2023-05-11]
fast-open-switch r1.0 - KiCad/ALTIUM_EMBEDDED_MODELS/Inductor vergleichbar mit FXL0420-1R0-M.stp
4.40 x 4.20 x 1.80 mm
