pcbarts/fast-open-switch-hardware/fast-open-switch r1.0 - KiCad/ALTIUM_EMBEDDED_MODELS/U-DFN2018-6 vergleichbar mit AP21510FM-7.stp

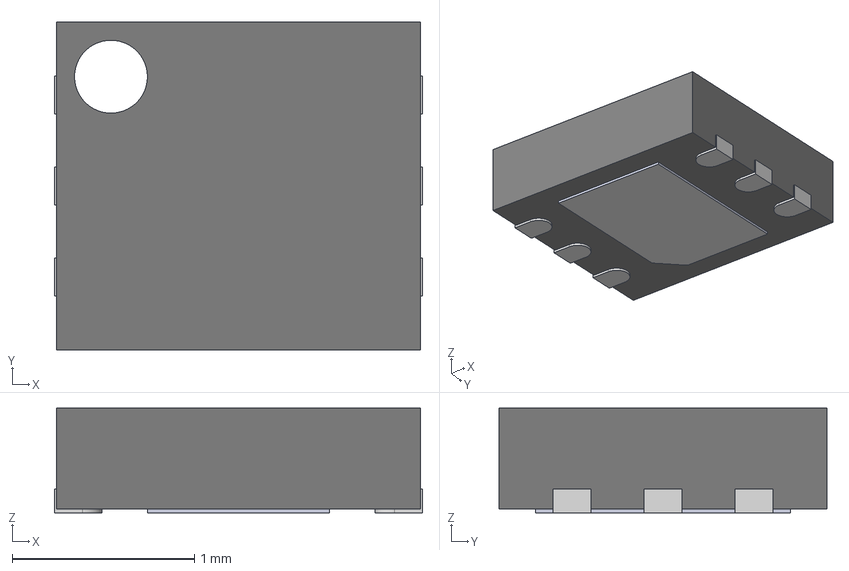
[picture p29: CAD file, 2023-05-11]
fast-open-switch r1.0 - KiCad/ALTIUM_EMBEDDED_MODELS/U-DFN2018-6 vergleichbar mit AP21510FM-7.stp
2.02 x 1.80 x 0.575 mm
