pcbarts/fast-open-switch-hardware/fast-open-switch r1.0 - KiCad/ALTIUM_EMBEDDED_MODELS/Lite-On LTST-S270KRKT.stp

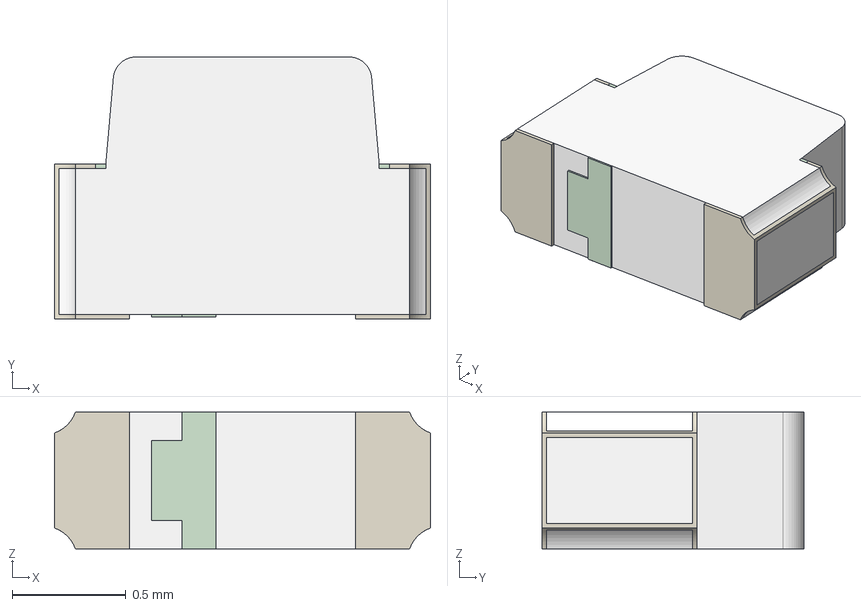
[picture p30: CAD file, 2023-05-11]
fast-open-switch r1.0 - KiCad/ALTIUM_EMBEDDED_MODELS/Lite-On LTST-S270KRKT.stp
1.65 x 1.15 x 0.6 mm
