pcbarts/fast-open-switch-hardware/fast-open-switch r1.0 - KiCad/ALTIUM_EMBEDDED_MODELS/LL3301BF065QJ.stp

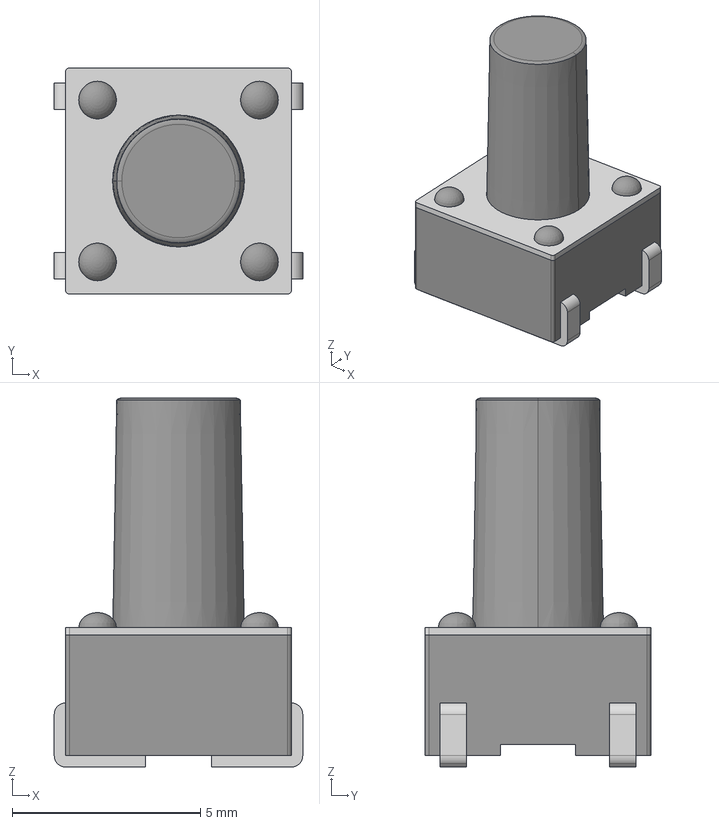
[picture p31: CAD file, 2023-05-11]
fast-open-switch r1.0 - KiCad/ALTIUM_EMBEDDED_MODELS/LL3301BF065QJ.stp
6.60 x 6.00 x 9.80 mm
