pcbarts/fast-open-switch-hardware/fast-open-switch r1.0 - KiCad/ALTIUM_EMBEDDED_MODELS/Testpad Cylinder.stp

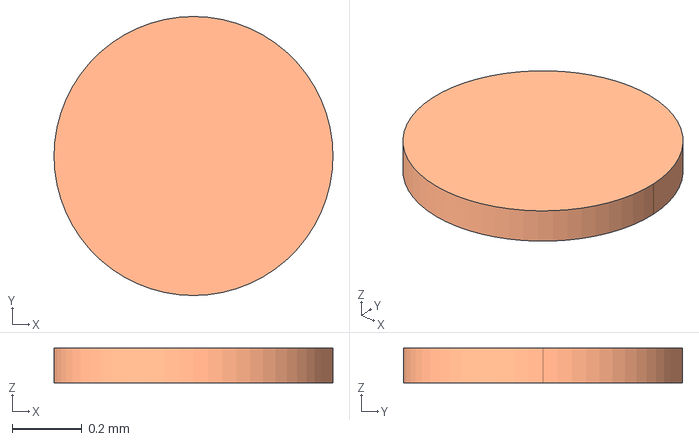
[picture p32: CAD file, 2023-05-11]
fast-open-switch r1.0 - KiCad/ALTIUM_EMBEDDED_MODELS/Testpad Cylinder.stp
0.8 x 0.8 x 0.1 mm
