pcbarts/fast-open-switch-hardware/fast-open-switch r1.0 - KiCad/ALTIUM_EMBEDDED_MODELS/ECS-260-10-36B-CKY-TR.stp

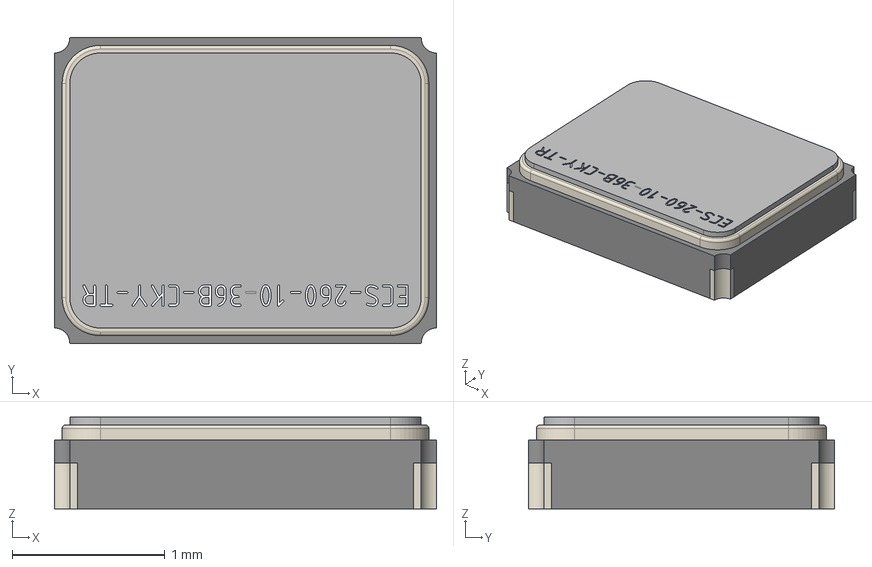
[picture p33: CAD file, 2023-05-11]
fast-open-switch r1.0 - KiCad/ALTIUM_EMBEDDED_MODELS/ECS-260-10-36B-CKY-TR.stp
2.50 x 2.00 x 0.6 mm
