pcbarts/fast-open-switch-hardware/fast-open-switch r1.0 - KiCad/ALTIUM_EMBEDDED_MODELS/Conn_SAMTEC_SS4-30-3_50-L-D-K-TR_eec.STEP

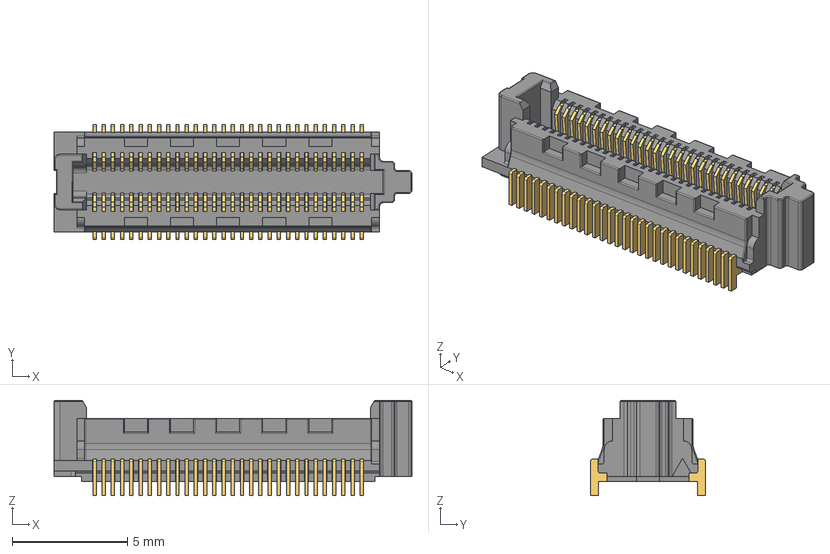
[picture p34: CAD file, 2023-05-11]
fast-open-switch r1.0 - KiCad/ALTIUM_EMBEDDED_MODELS/Conn_SAMTEC_SS4-30-3_50-L-D-K-TR_eec.STEP
15.5 x 5.00 x 4.13 mm
SS4-30_socket
C-229-30-3.50
Pin1_Triangle
Samtec
