pcbarts/fast-open-switch-hardware/fast-open-switch r1.0 - KiCad/ALTIUM_EMBEDDED_MODELS/HWSON8-2x3x0_80.step

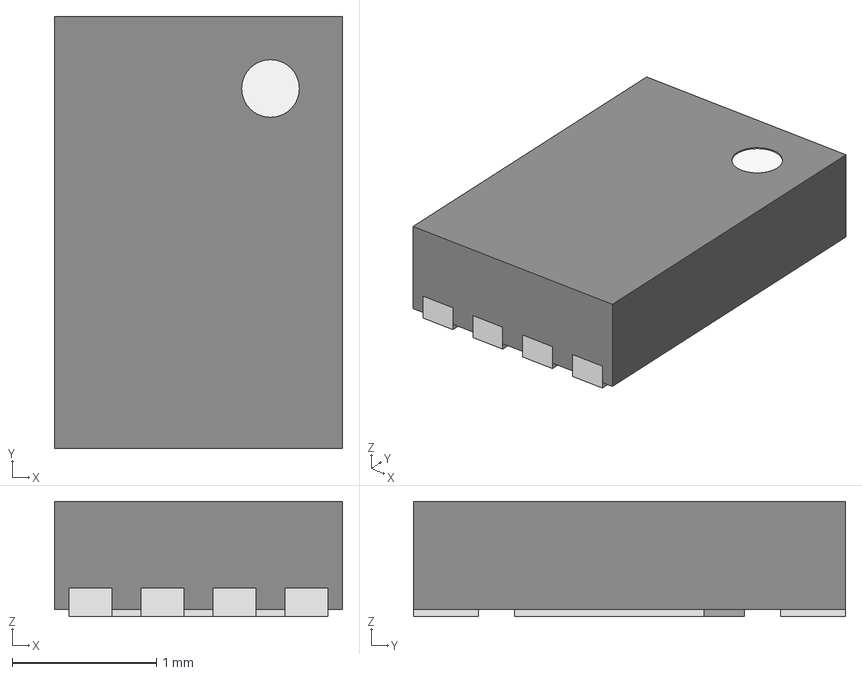
[picture p35: CAD file, 2023-05-11]
fast-open-switch r1.0 - KiCad/ALTIUM_EMBEDDED_MODELS/HWSON8-2x3x0_80.step
2.00 x 3.00 x 0.8 mm
