pcbarts/fast-open-switch-hardware/fast-open-switch r1.0 - KiCad/ALTIUM_EMBEDDED_MODELS/CUI_DEVICES_DS04-254-1-01BK-SMT.step

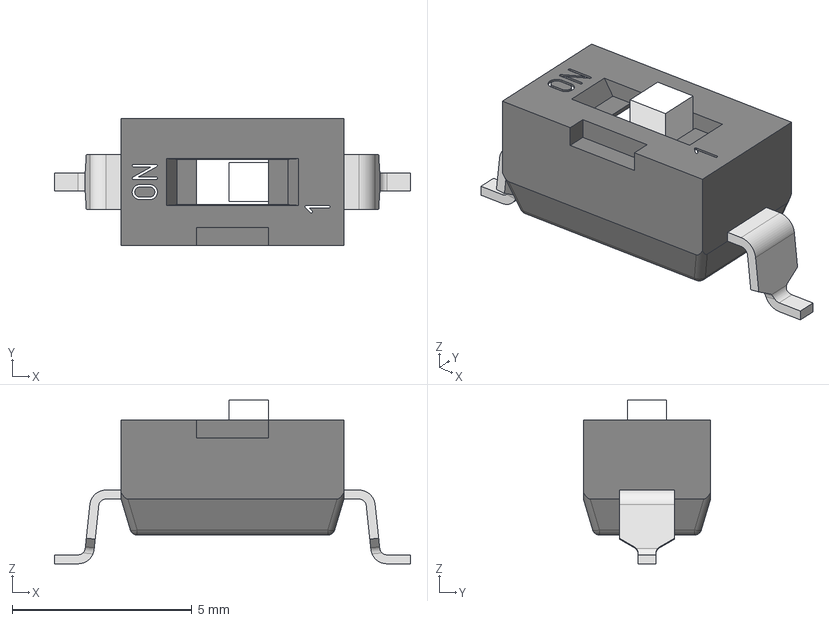
[picture p36: CAD file, 2023-05-11]
fast-open-switch r1.0 - KiCad/ALTIUM_EMBEDDED_MODELS/CUI_DEVICES_DS04-254-1-01BK-SMT.step
9.90 x 3.54 x 4.55 mm
