pcbarts/fast-open-switch-hardware/fast-open-switch r1.0 - KiCad/ALTIUM_EMBEDDED_MODELS/JTAG-SMT3-NC.stp

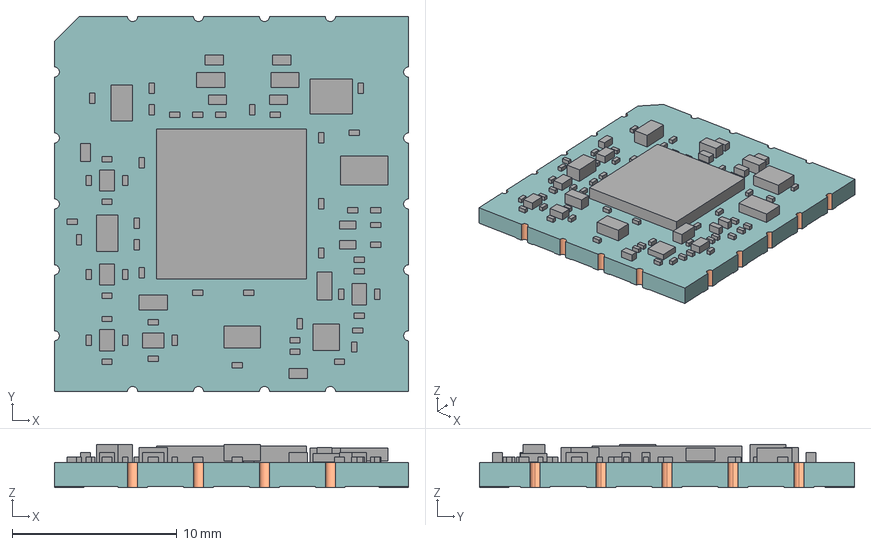
[picture p37: CAD file, 2023-05-11]
fast-open-switch r1.0 - KiCad/ALTIUM_EMBEDDED_MODELS/JTAG-SMT3-NC.stp
21.5 x 22.8 x 2.61 mm
Extruded
Extruded-0 x 3
Extruded-1 x 5
Extruded-2 x 27
Extruded-3 x 24
Extruded-4
Extruded-5
Extruded-6
Extruded-7
Extruded-8
Extruded-9 x 2
Extruded-10
Extruded-11 x 2
Extruded-12
Extruded-13 x 4
Board
