pcbarts/fast-open-switch-hardware/fast-open-switch r1.0 - KiCad/ALTIUM_EMBEDDED_MODELS/S3D32.768KB20F30T.stp

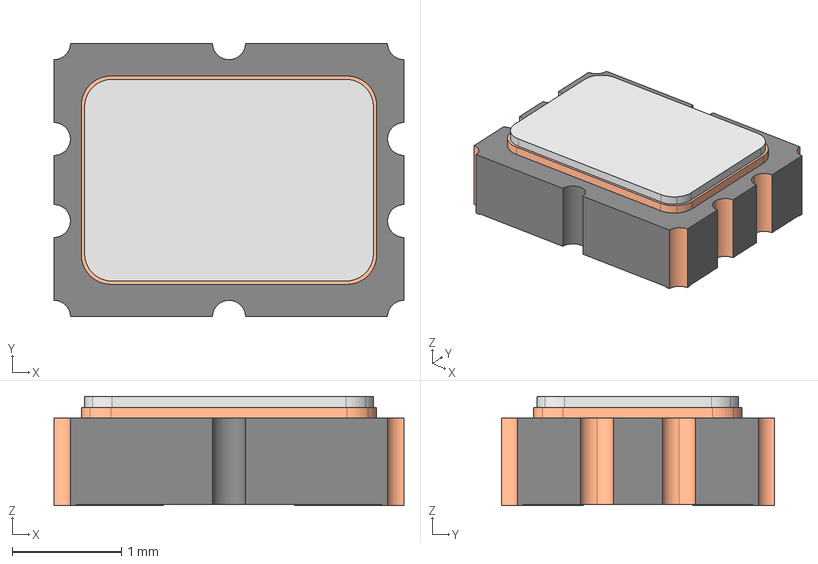
[picture p38: CAD file, 2023-05-11]
fast-open-switch r1.0 - KiCad/ALTIUM_EMBEDDED_MODELS/S3D32.768KB20F30T.stp
3.20 x 2.50 x 1.00 mm
