pcbarts/fast-open-switch-hardware/fast-open-switch r1.0 - KiCad/ALTIUM_EMBEDDED_MODELS/153BallWFBGA.stp

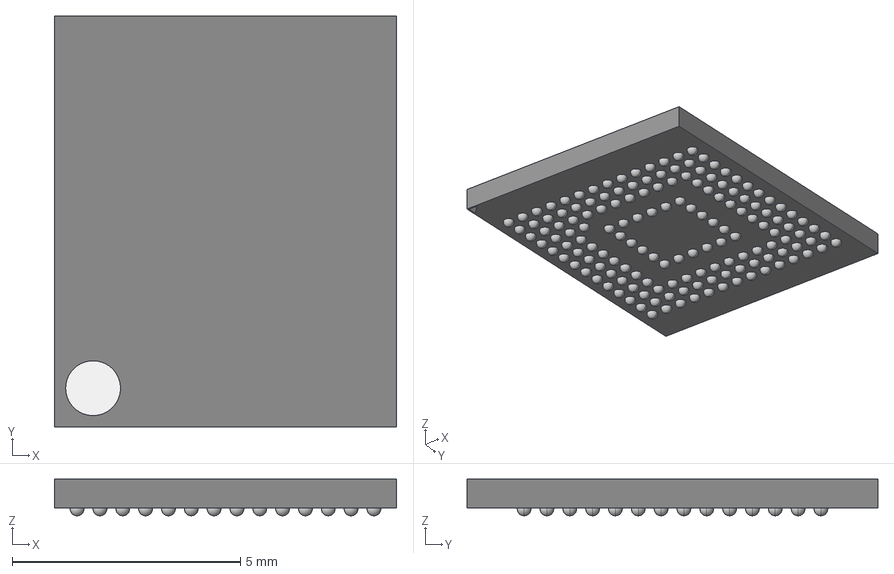
[picture p41: CAD file, 2023-05-11]
fast-open-switch r1.0 - KiCad/ALTIUM_EMBEDDED_MODELS/153BallWFBGA.stp
7.50 x 9.00 x 0.802 mm
