pcbarts/fast-open-switch-hardware/fast-open-switch r1.0 - KiCad/ALTIUM_EMBEDDED_MODELS/Ckmtw R-RJ45R08P-C000.stp

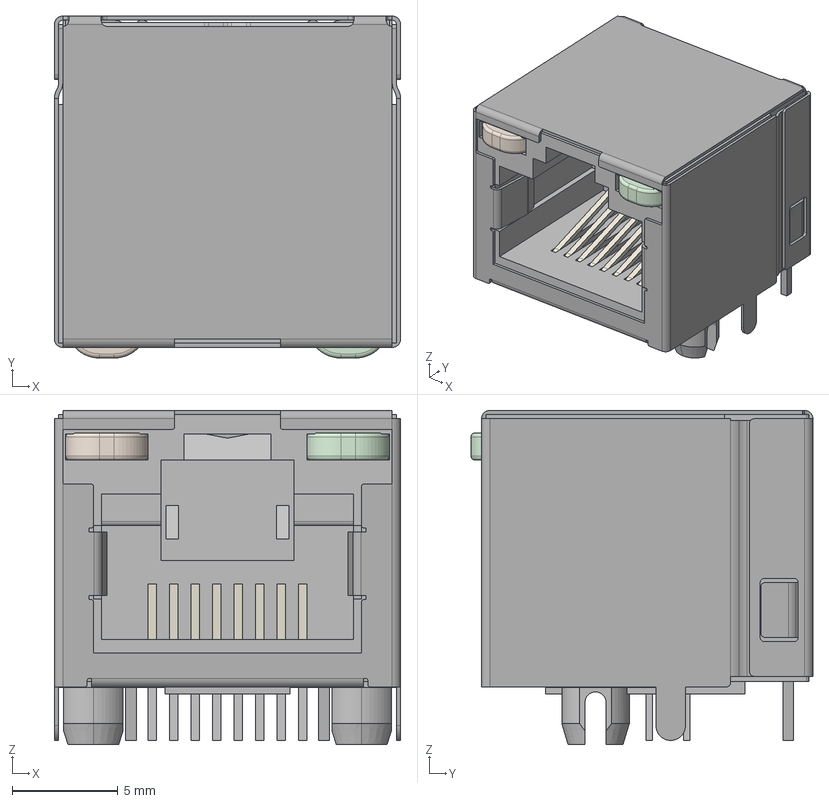
[picture p42: CAD file, 2023-05-11]
fast-open-switch r1.0 - KiCad/ALTIUM_EMBEDDED_MODELS/Ckmtw R-RJ45R08P-C000.stp
16.4 x 16.2 x 15.8 mm
615108137421R_Housing
615108137421R_Shielding
615108137421R_Pin_short x 4
615108137421R_Pin_long x 4
615108137421R_Housing2
615108137421R_LED_green
615108137421R_LED_yellow
