pcbarts/fast-open-switch-hardware/fast-open-switch r1.0 - KiCad/ALTIUM_EMBEDDED_MODELS/Ethernet transformer QT24A01.stp

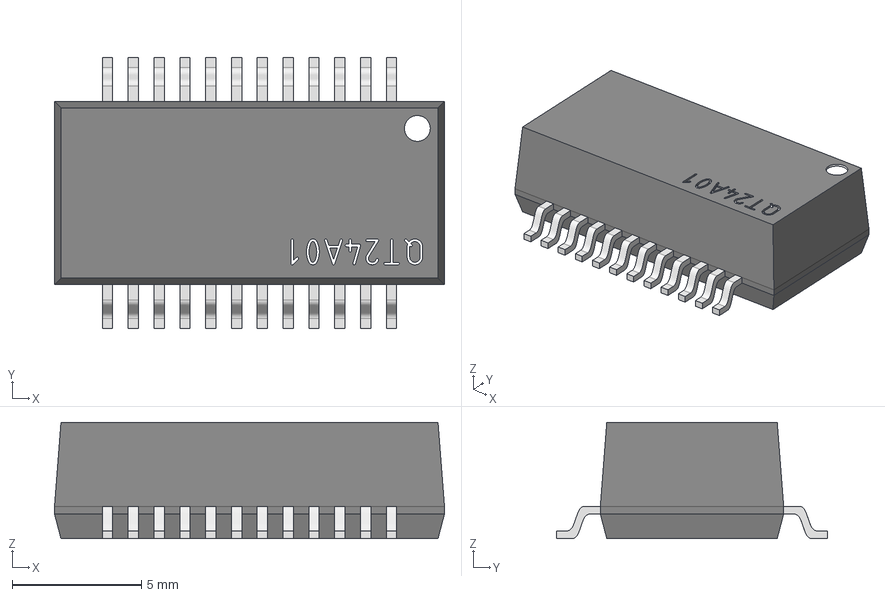
[picture p43: CAD file, 2023-05-11]
fast-open-switch r1.0 - KiCad/ALTIUM_EMBEDDED_MODELS/Ethernet transformer QT24A01.stp
15.1 x 10.5 x 4.50 mm
Konstruktion2
Komponente1
