pcbarts/fast-open-switch-hardware/fast-open-switch r1.0 - KiCad/ALTIUM_EMBEDDED_MODELS/QFN50P450X350X100-21N.stp

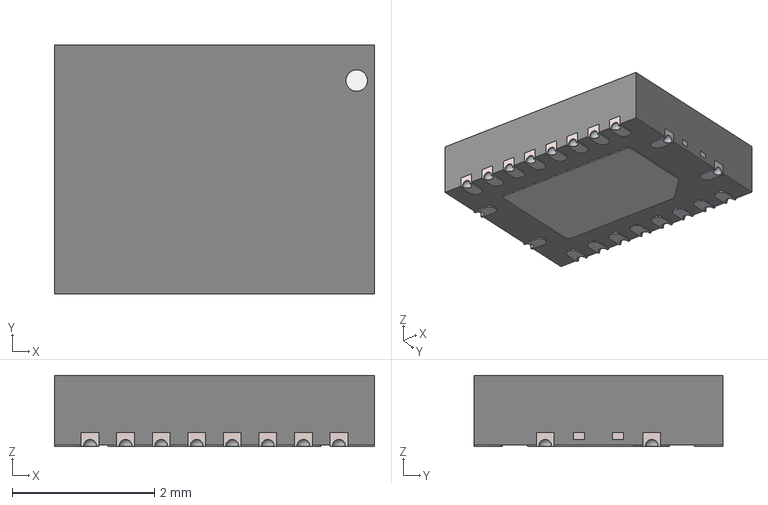
[picture p44: CAD file, 2023-05-11]
fast-open-switch r1.0 - KiCad/ALTIUM_EMBEDDED_MODELS/QFN50P450X350X100-21N.stp
4.50 x 3.50 x 1.00 mm
SOT764-1 LF
SOT764-1 Mold Body
