pcbarts/fast-open-switch-hardware/fast-open-switch r1.0 - KiCad/ALTIUM_EMBEDDED_MODELS/Conn_Molex_533980471_eec.STEP

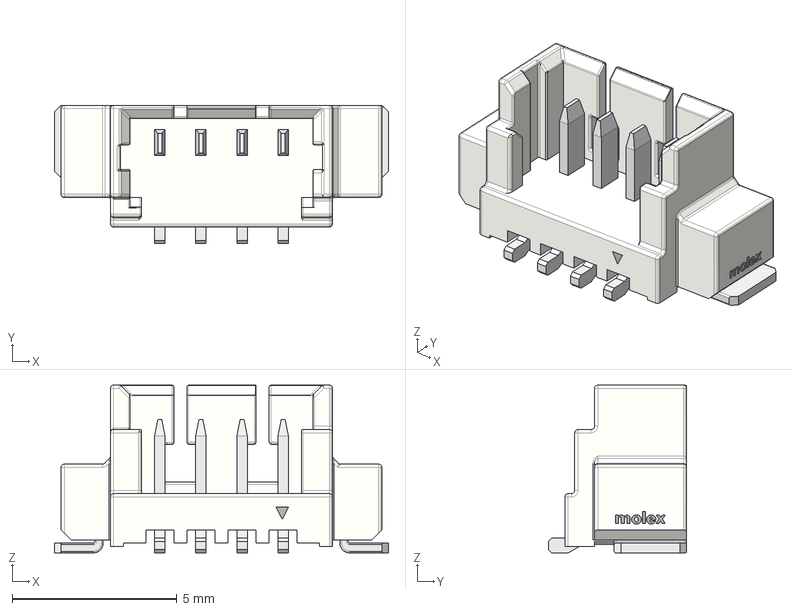
[picture p45: CAD file, 2023-05-11]
fast-open-switch r1.0 - KiCad/ALTIUM_EMBEDDED_MODELS/Conn_Molex_533980471_eec.STEP
10.2 x 4.20 x 5.10 mm
