pcbarts/fast-open-switch-hardware/fast-open-switch r1.0 - KiCad/ALTIUM_EMBEDDED_MODELS/BLM21PG121BH1J--3DModel-STEP-1.STEP

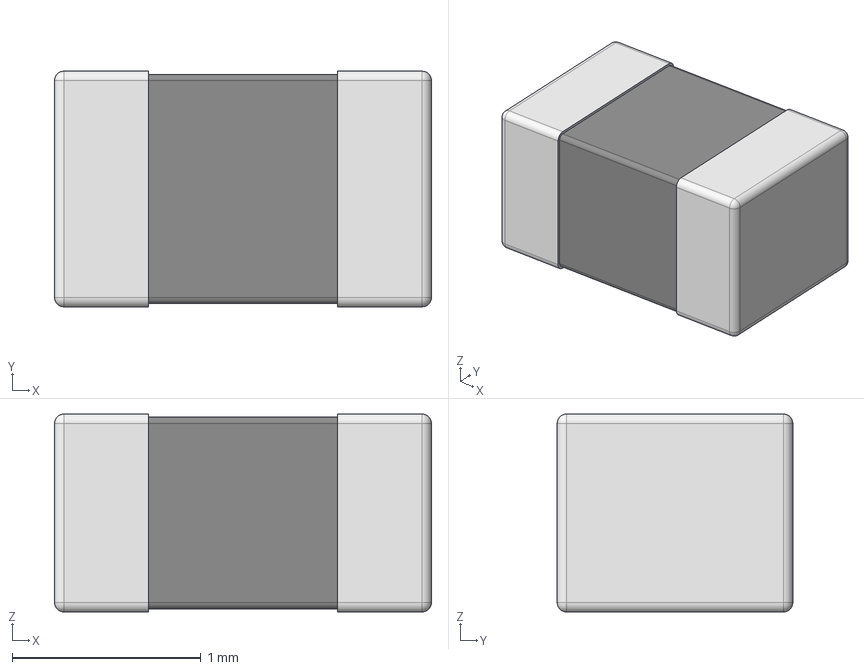
[picture p50: CAD file, 2023-05-11]
fast-open-switch r1.0 - KiCad/ALTIUM_EMBEDDED_MODELS/BLM21PG121BH1J--3DModel-STEP-1.STEP
2.00 x 1.25 x 1.05 mm
