pcbarts/fast-open-switch-hardware/fast-open-switch r1.0 - KiCad/ALTIUM_EMBEDDED_MODELS/DPAK_TO-252AA.stp

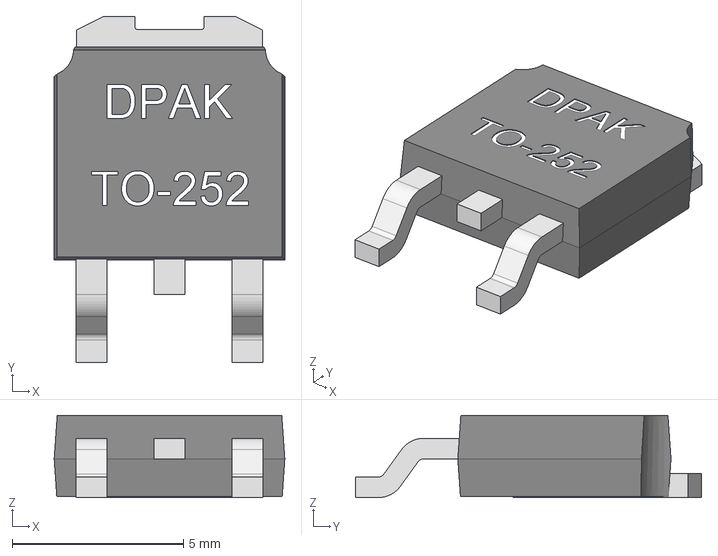
[picture p51: CAD file, 2023-05-11]
fast-open-switch r1.0 - KiCad/ALTIUM_EMBEDDED_MODELS/DPAK_TO-252AA.stp
6.73 x 10.1 x 2.40 mm
