pcbarts/fast-open-switch-hardware/fast-open-switch r1.0 - KiCad/ALTIUM_EMBEDDED_MODELS/QFN40_6mmX6mm.step

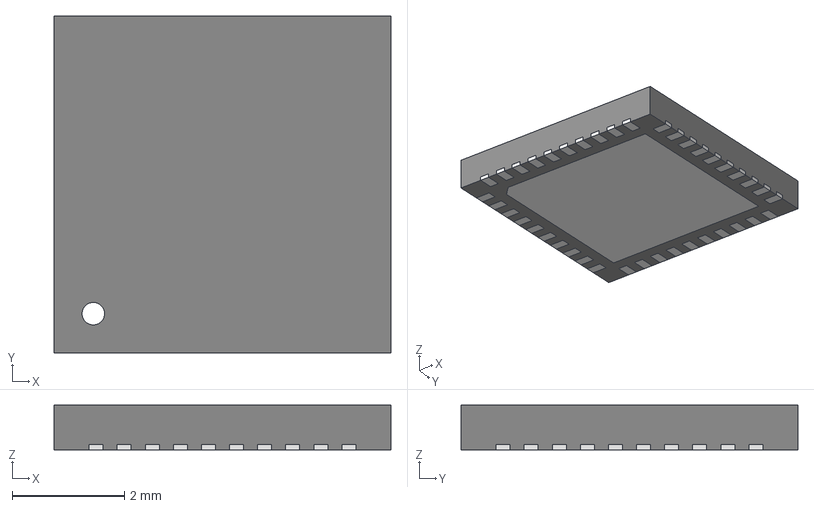
[picture p52: CAD file, 2023-05-11]
fast-open-switch r1.0 - KiCad/ALTIUM_EMBEDDED_MODELS/QFN40_6mmX6mm.step
6.00 x 6.00 x 0.8 mm
