pcbarts/fast-open-switch-hardware/fast-open-switch r1.0 - KiCad/ALTIUM_EMBEDDED_MODELS/WSON-6 vergleichbar mit TLV70018DSET.stp

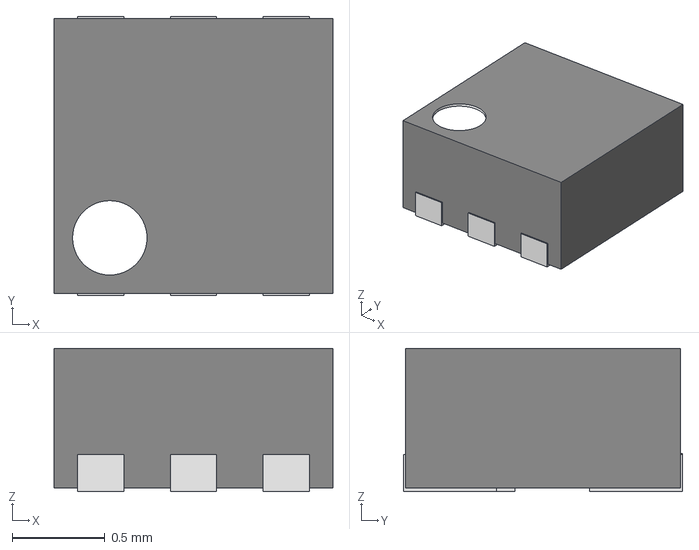
[picture p53: CAD file, 2023-05-11]
fast-open-switch r1.0 - KiCad/ALTIUM_EMBEDDED_MODELS/WSON-6 vergleichbar mit TLV70018DSET.stp
1.50 x 1.50 x 0.77 mm
