pcbarts/fast-open-switch-hardware/fast-open-switch r1.0 - KiCad/ALTIUM_EMBEDDED_MODELS/IC_ON_Semiconductor_FSUSB42MUX_eec.STEP

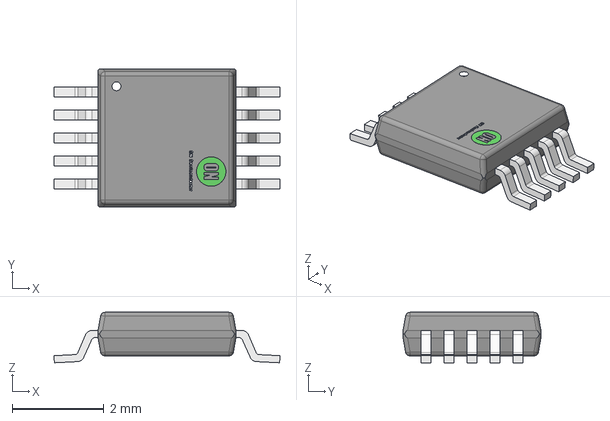
[picture p56: CAD file, 2023-05-11]
fast-open-switch r1.0 - KiCad/ALTIUM_EMBEDDED_MODELS/IC_ON_Semiconductor_FSUSB42MUX_eec.STEP
4.92 x 3.00 x 1.10 mm
