pcbarts/fast-open-switch-hardware/(list of files, cad)

Other CAD files:
fast-open-switch r1.0 - KiCad/ALTIUM_EMBEDDED_MODELS/0154010.DR.STP
fast-open-switch r1.0 - KiCad/ALTIUM_EMBEDDED_MODELS/2007198-1.stp
fast-open-switch r1.0 - KiCad/ALTIUM_EMBEDDED_MODELS/2007435-1.STP
fast-open-switch r1.0 - KiCad/ALTIUM_EMBEDDED_MODELS/61300411121 (rev1).stp
fast-open-switch r1.0 - KiCad/ALTIUM_EMBEDDED_MODELS/62701021621.stp
fast-open-switch r1.0 - KiCad/ALTIUM_EMBEDDED_MODELS/62702021621.stp
fast-open-switch r1.0 - KiCad/ALTIUM_EMBEDDED_MODELS/74441-0010.stp
fast-open-switch r1.0 - KiCad/ALTIUM_EMBEDDED_MODELS/874270602.stp
fast-open-switch r1.0 - KiCad/ALTIUM_EMBEDDED_MODELS/87832-1420.stp
fast-open-switch r1.0 - KiCad/ALTIUM_EMBEDDED_MODELS/9774020360R (rev1).stp
fast-open-switch r1.0 - KiCad/ALTIUM_EMBEDDED_MODELS/9774030151R.stp
fast-open-switch r1.0 - KiCad/ALTIUM_EMBEDDED_MODELS/9774050243R (rev1).stp
fast-open-switch r1.0 - KiCad/ALTIUM_EMBEDDED_MODELS/9774050960R (rev1).stp
fast-open-switch r1.0 - KiCad/ALTIUM_EMBEDDED_MODELS/9774065151.stp
