pcbarts/fast-open-switch-hardware/fast-open-switch r1.0/Documentation/KlusterLab Blockdiagram.pdf

# Blockdiagram FPGA 10Gig Switch

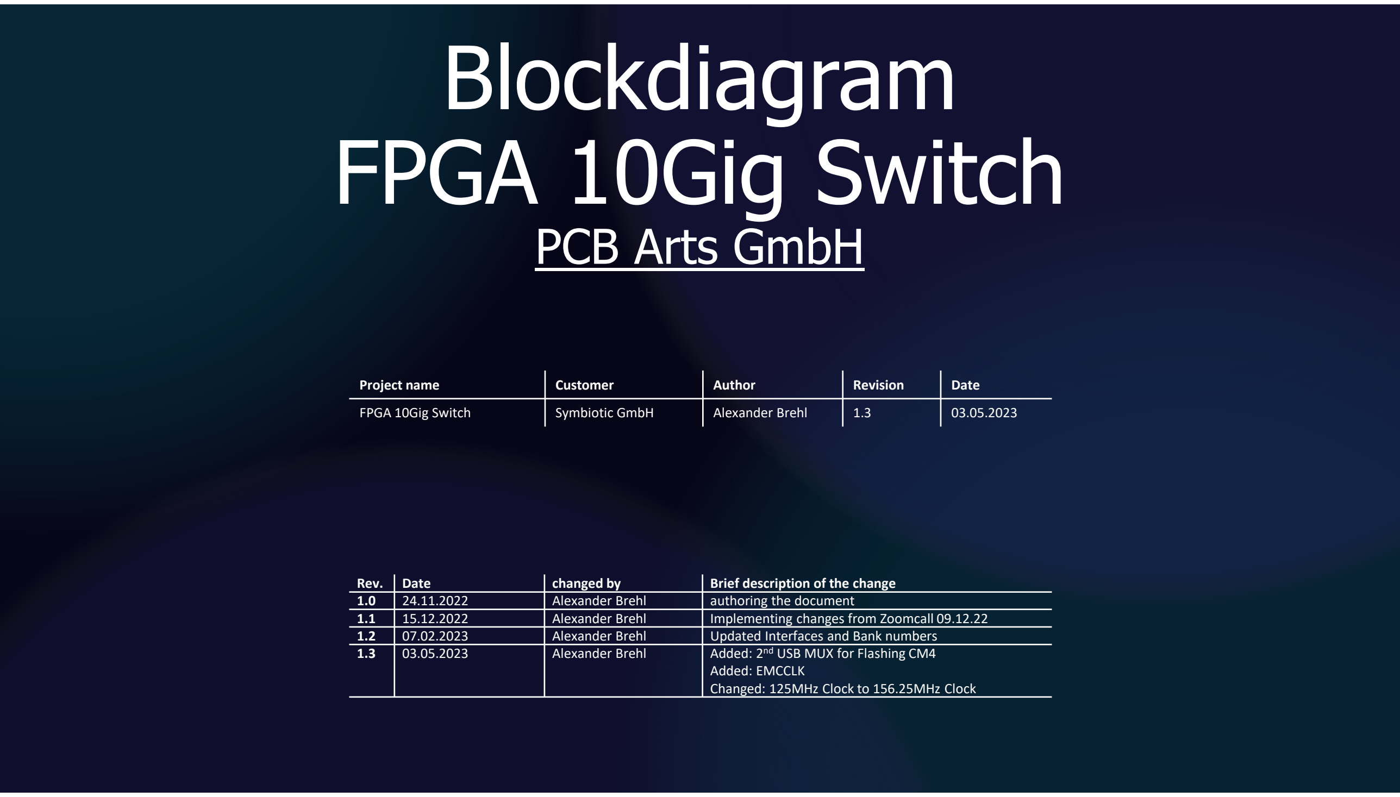
[picture p57: page 1]

# PCB Arts GmbH

Brief description of the changechanged byDateRev.

### 1.0 authoring the documentAlexander Brehl24.11.2022

1.1 | rehl15.12.2022 | Implementing changes from Zoomcall 09.12.22Alexander B
1.2 | 7.02.2023 | Updated Interfaces and Bank numbersAlexander Brehl0
Added: 2nd USB MUX for Flashing CM4 Added: EMCCLK
Changed: 125MHz Clock to 156.25MHz Clock

### 1.3 Alexander Brehl03.05.2023

DateRevisionAuthorCustomerProject name

Switch | 03.05.20231.3Alexander BrehlSymbiotic GmbHFPGA 10Gig

# Overview

# Raspberry Pi CM 4

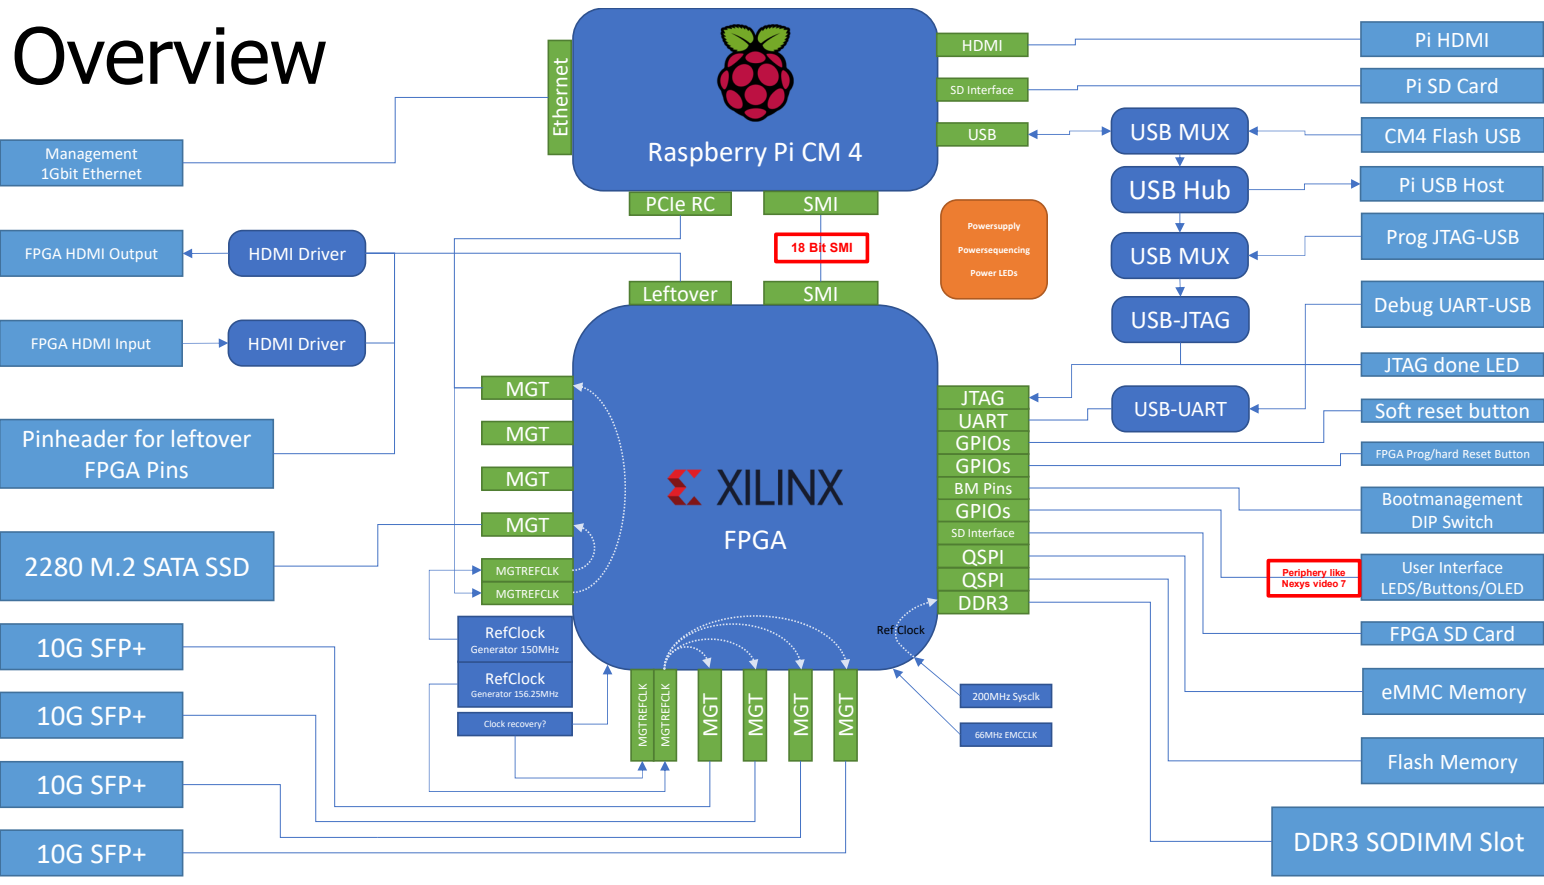
[picture p58: page 2]
FPGA; 10G SFP+; SMI; DDR3 SODIMM Slot; DDR3; eMMC Memory; Flash Memory; QSPI; UART; Powersupply; Powersequencing; Power LEDs; JTAG; Ethernet; 200MHz Sysclk; RefClock; Generator 156.25MHz; MGT; MGTREFCLK; 2280 M.2 SATA SSD; Management 1Gbit Ethernet; 18 Bit SMI; HDMI; PCIe RC; SD Interface; Pi SD Card; Pi HDMI; Generator 150MHz; Ref Clock; USB Hub; USB; USB MUX; Prog JTAG-USB; USB-JTAG; USB-UART; GPIOs; Periphery like Nexys video 7; Bootmanagement DIP Switch; BM Pins; Leftover; Clock recovery?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

Pi USB Host

Debug UART-USB

JTAG done LED

Soft reset button

Pinheader for leftover
FPGA Pins

FPGA Prog/hard Reset Button

User Interface
LEDS/Buttons/OLED

FPGA SD Card
