pcbarts/fast-open-switch-hardware/CM4 to FMC Adapter/CM4 to FMC Adapter r2.0/Source Data/CM4 to FMC Adapter r2.0.pdf

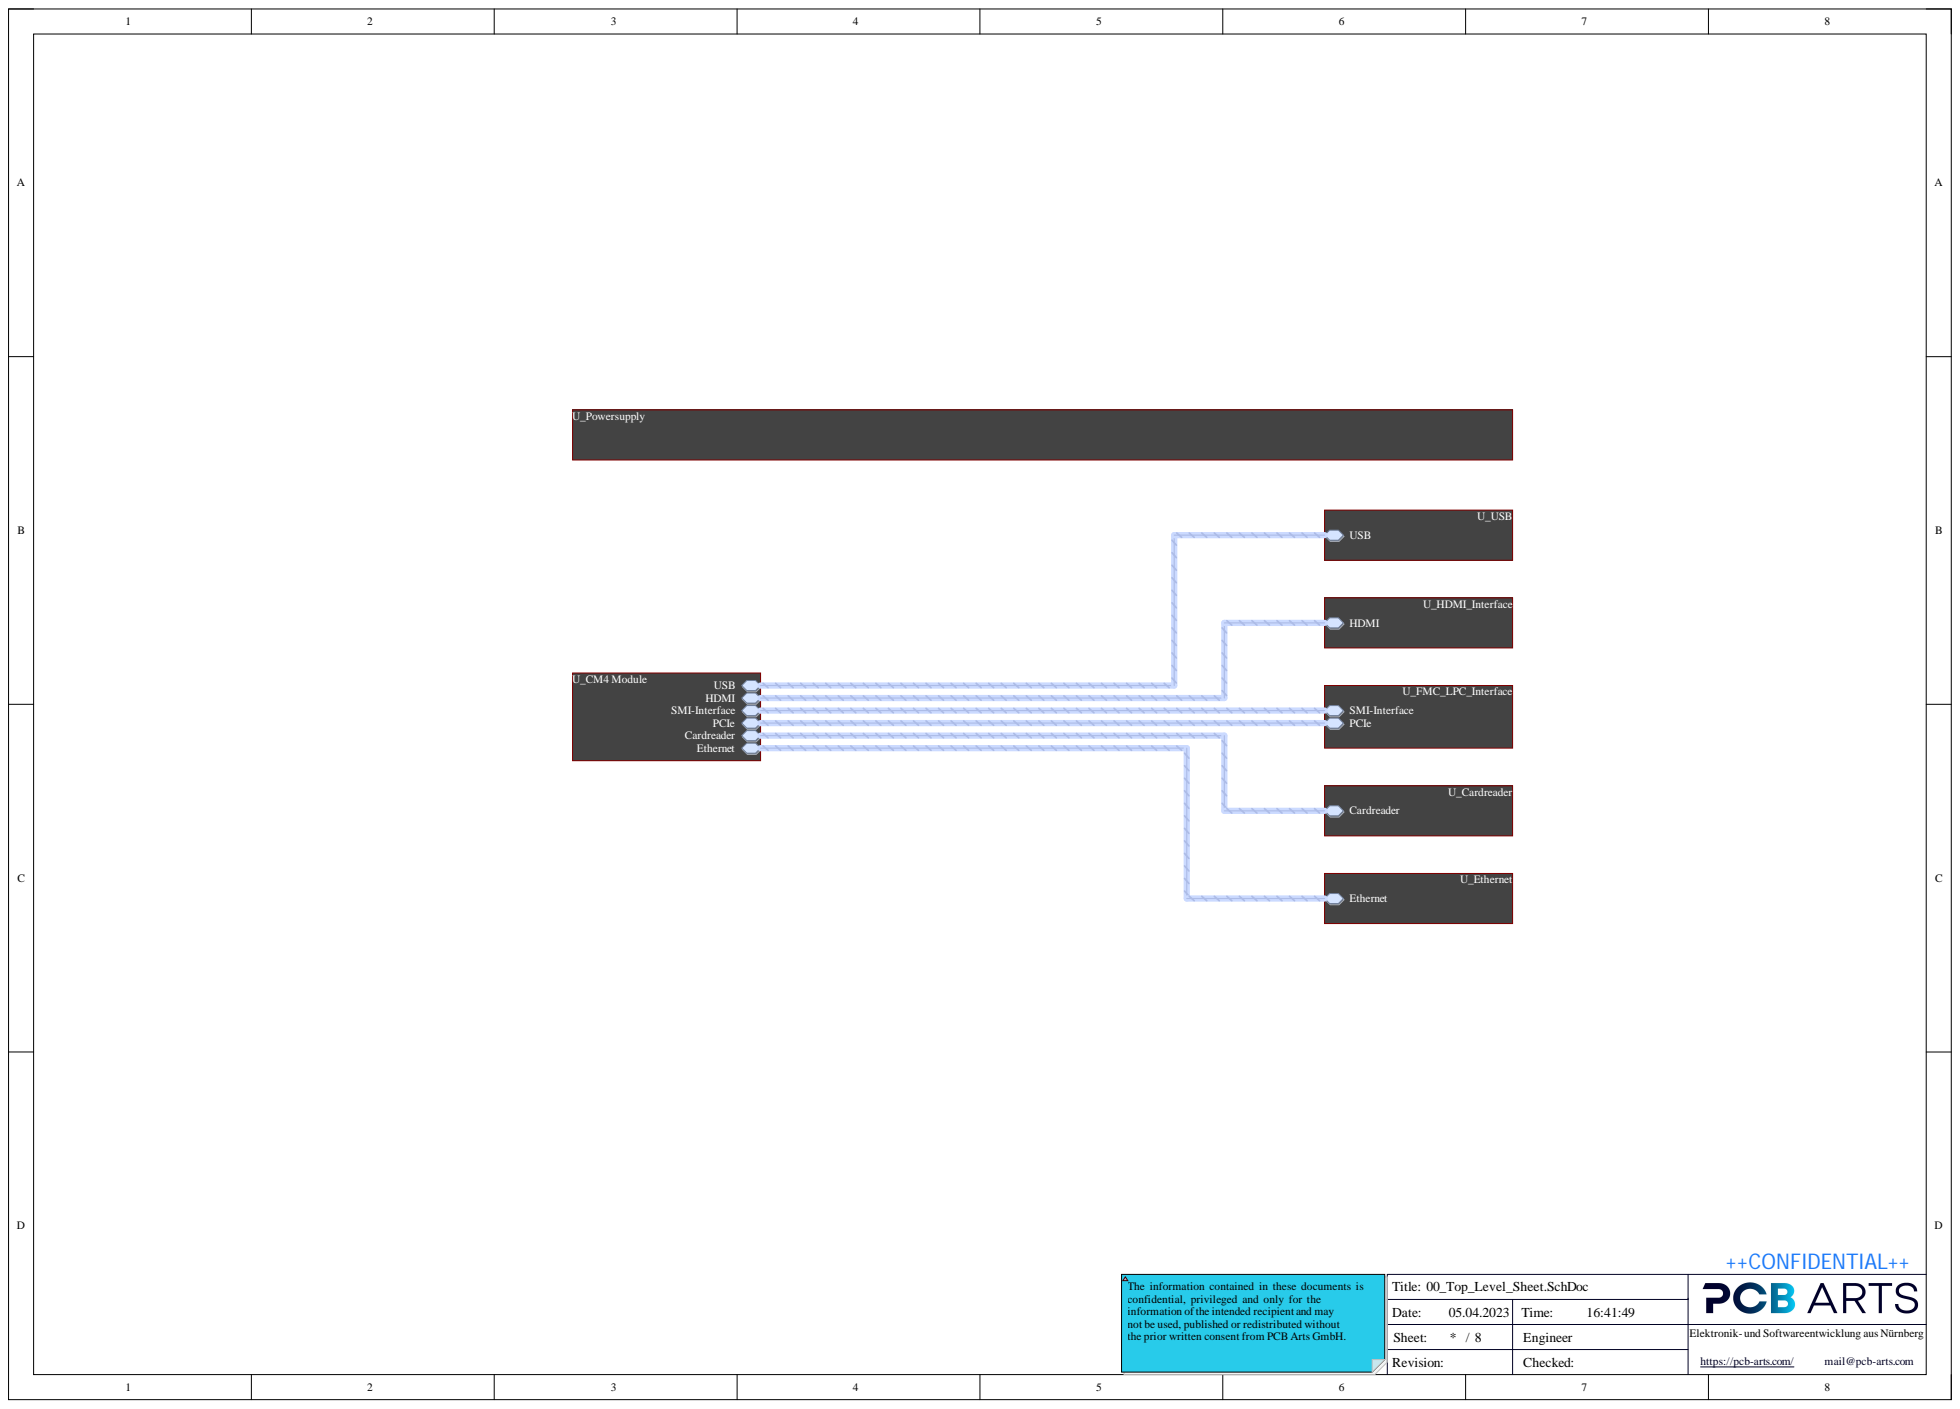
[picture p59: page 1]

The information contained in these documents is
confidential, privileged and only for the
information ofthe intended recipient and may
not be used, published or redistributed without
the prior written consent from PCB Arts GmbH.

Elektronik- und Softwareentwicklung aus Nürnberg

https://pcb-arts.com/

mail@pcb-arts.com

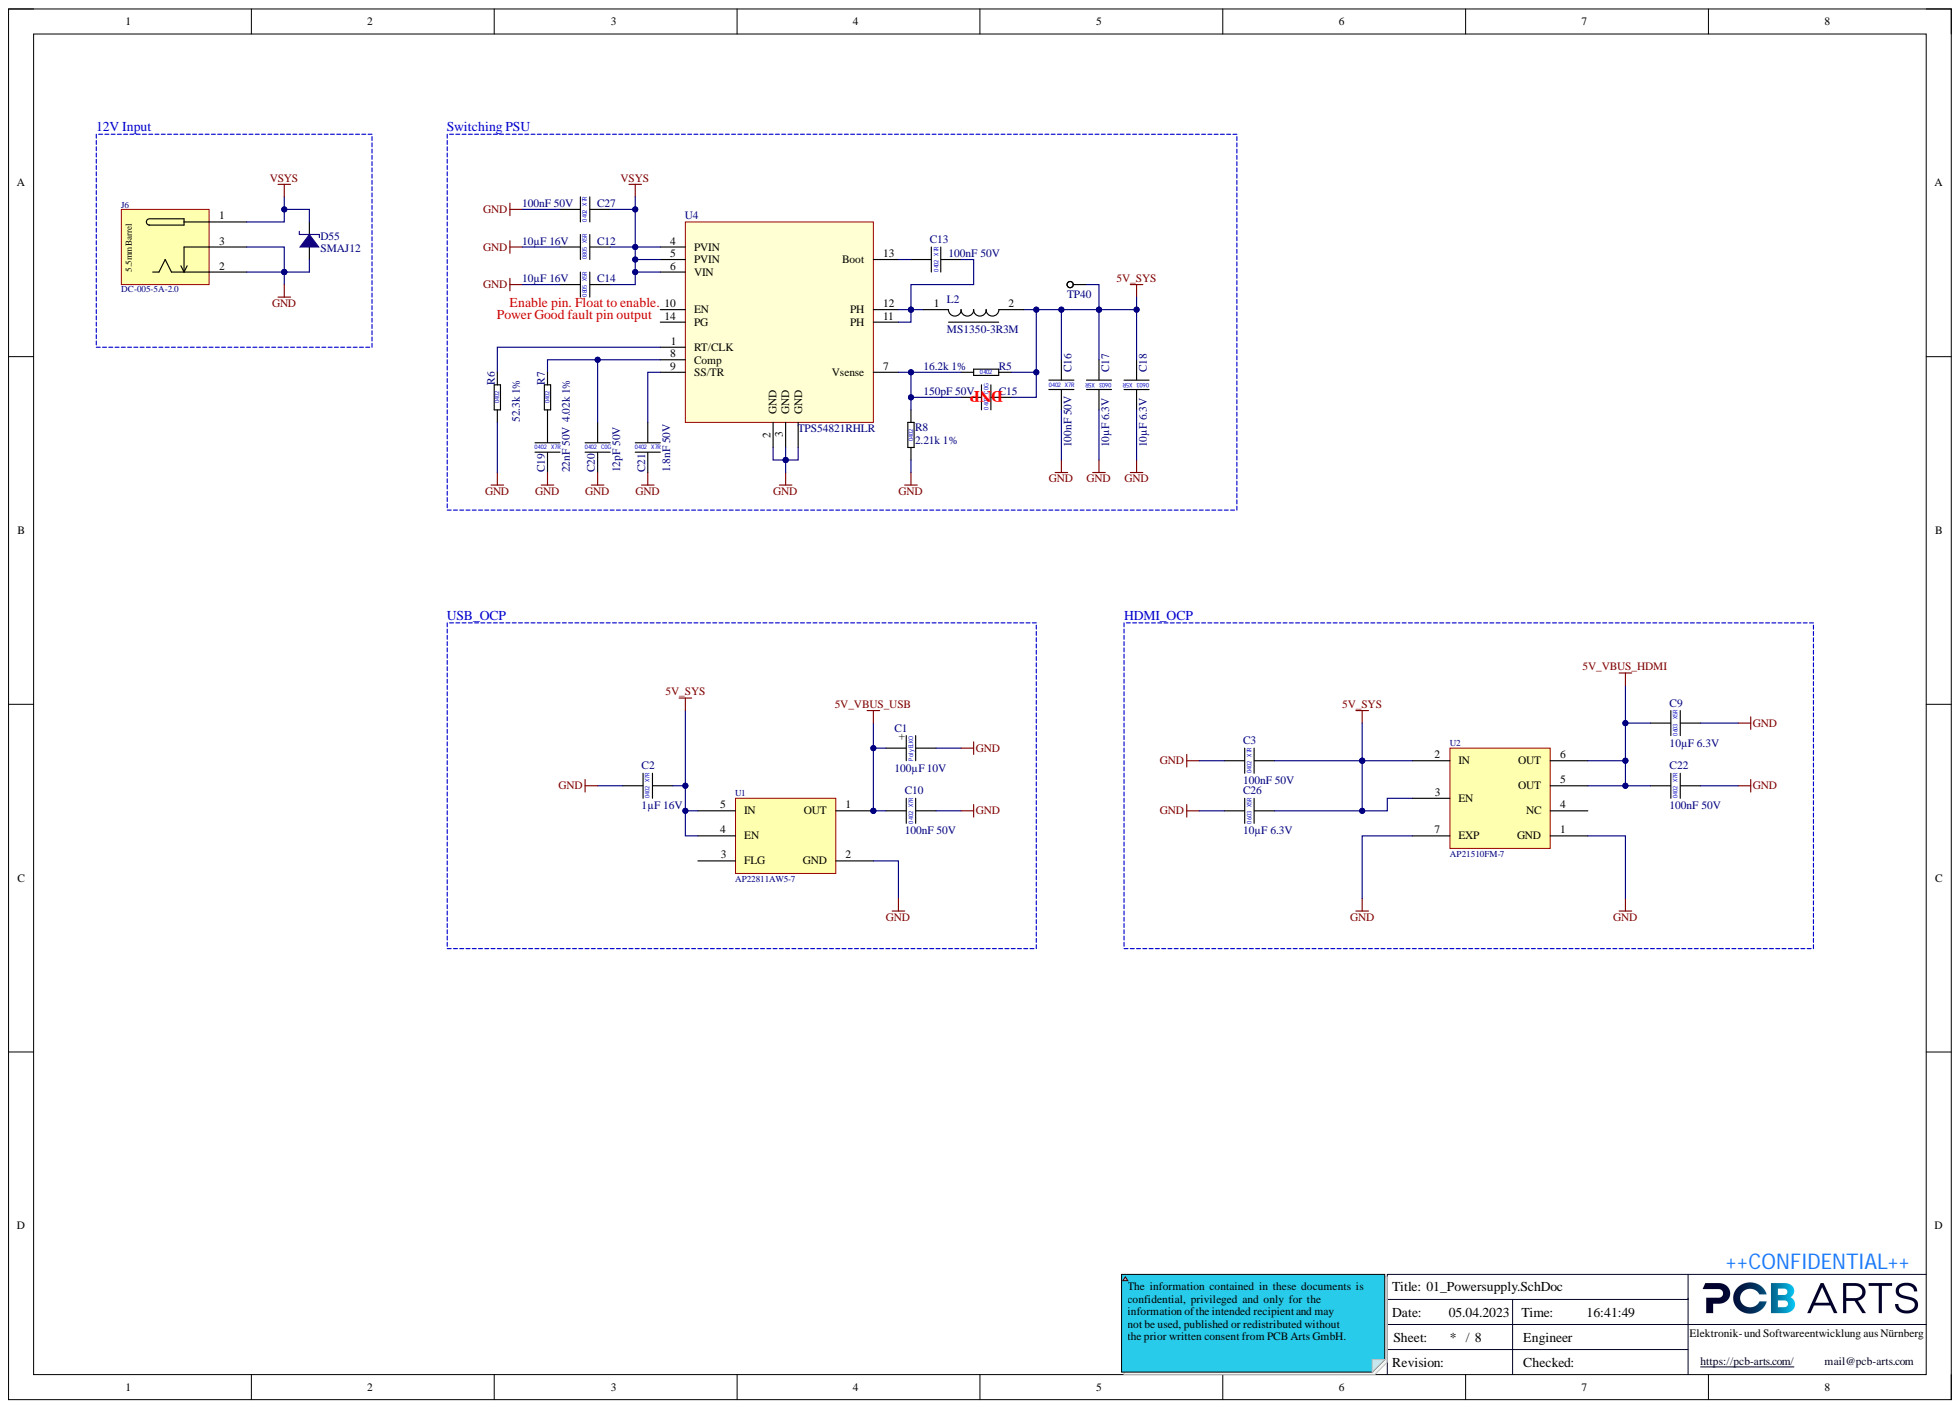
[picture p60: page 2]

GND
Enable pin. Float to enable. Power Good fault pin output

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

Elektronik- und Softwareentwicklung aus Nürnberg

https://pcb-arts.com/

mail@pcb-arts.com

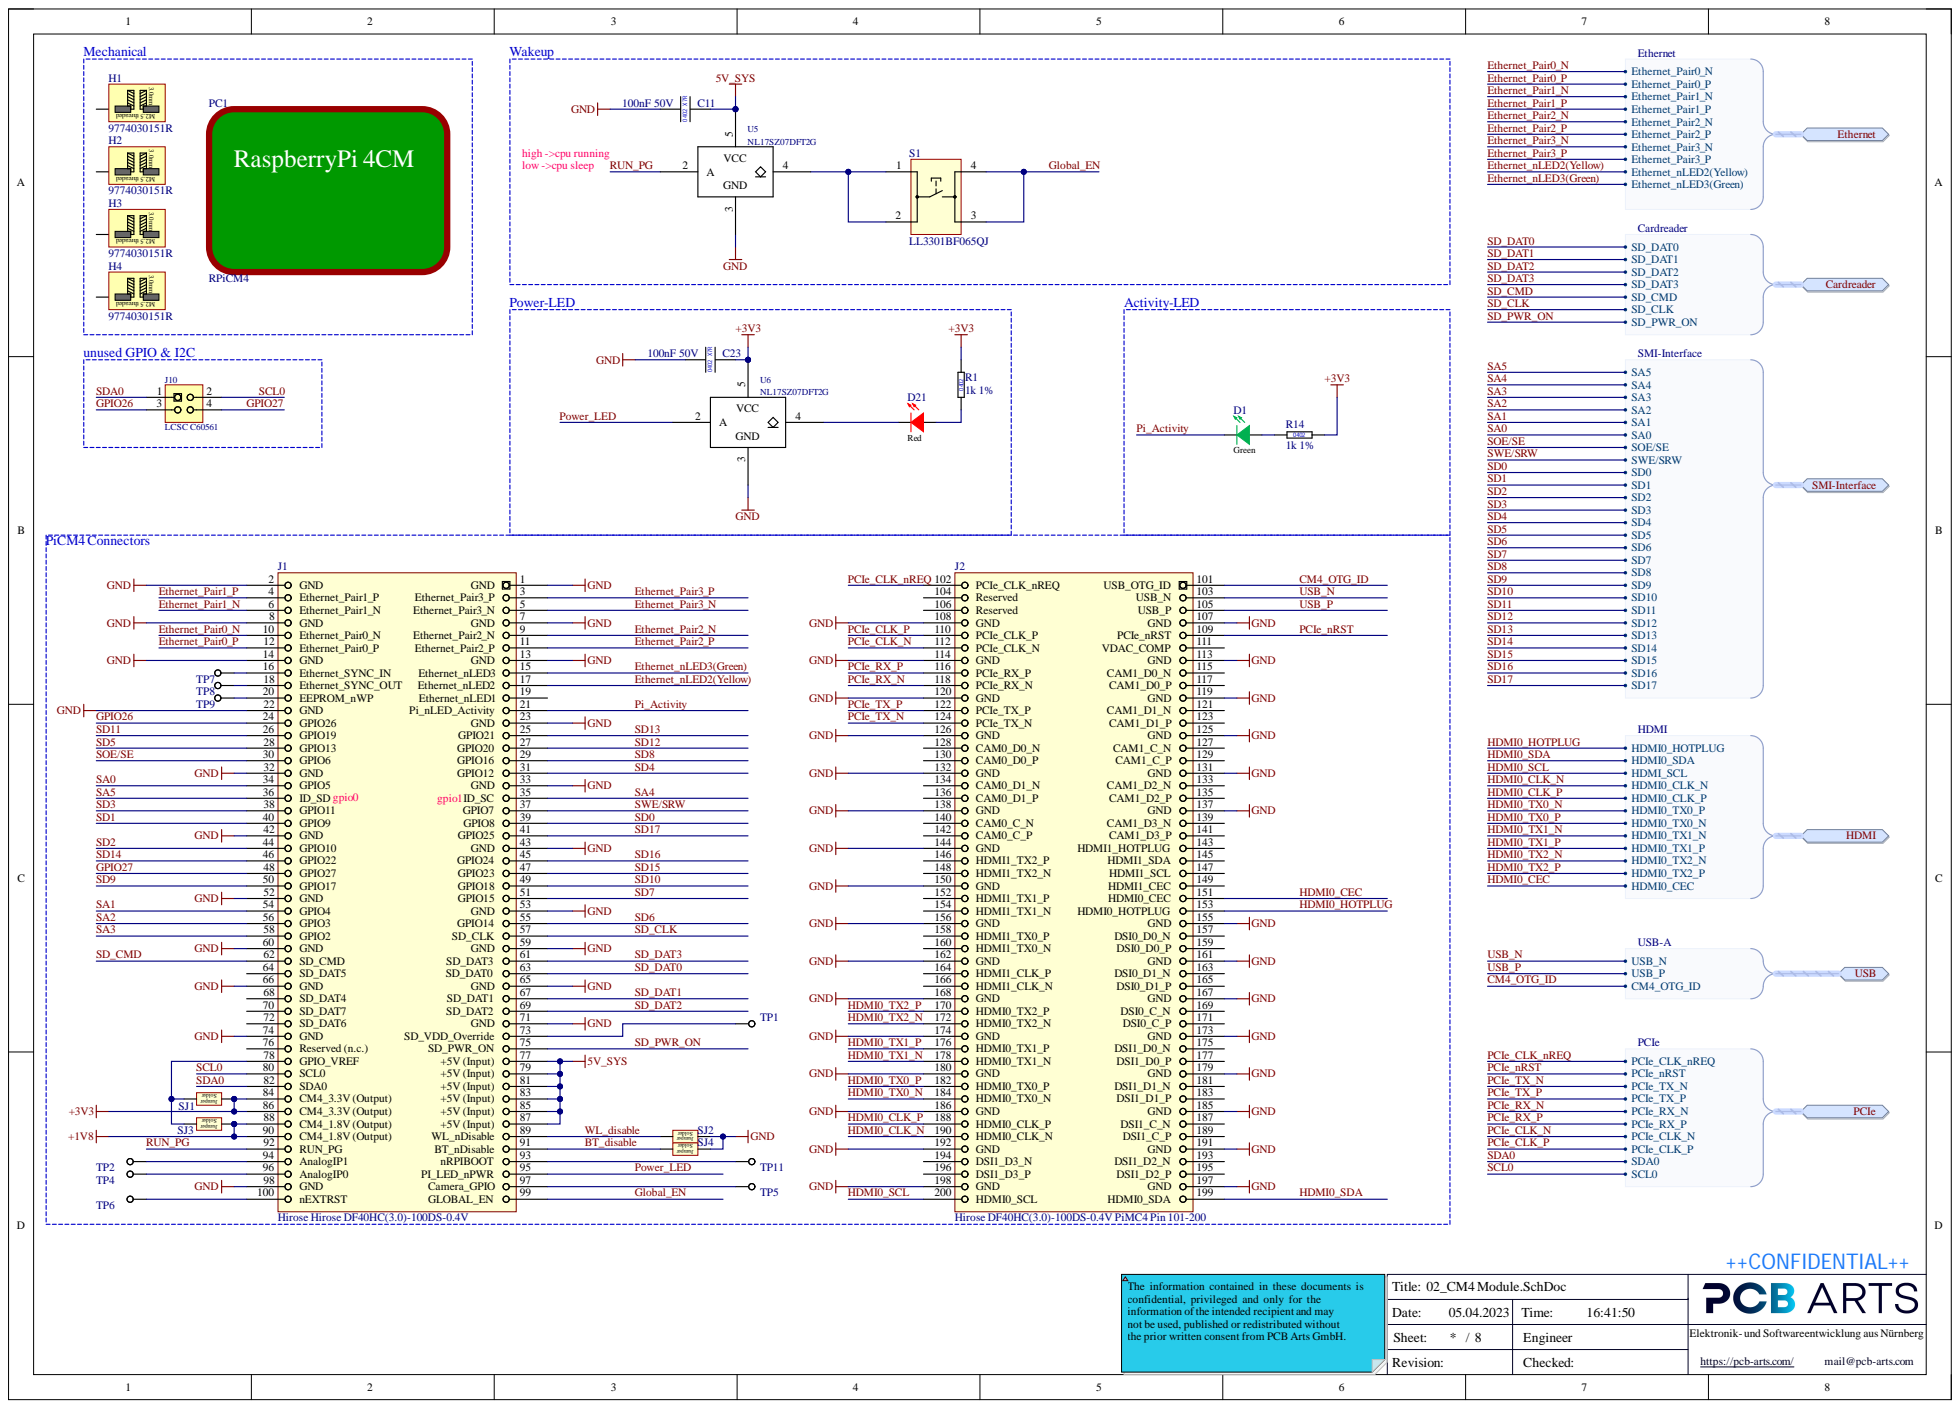
[picture p61: page 3]

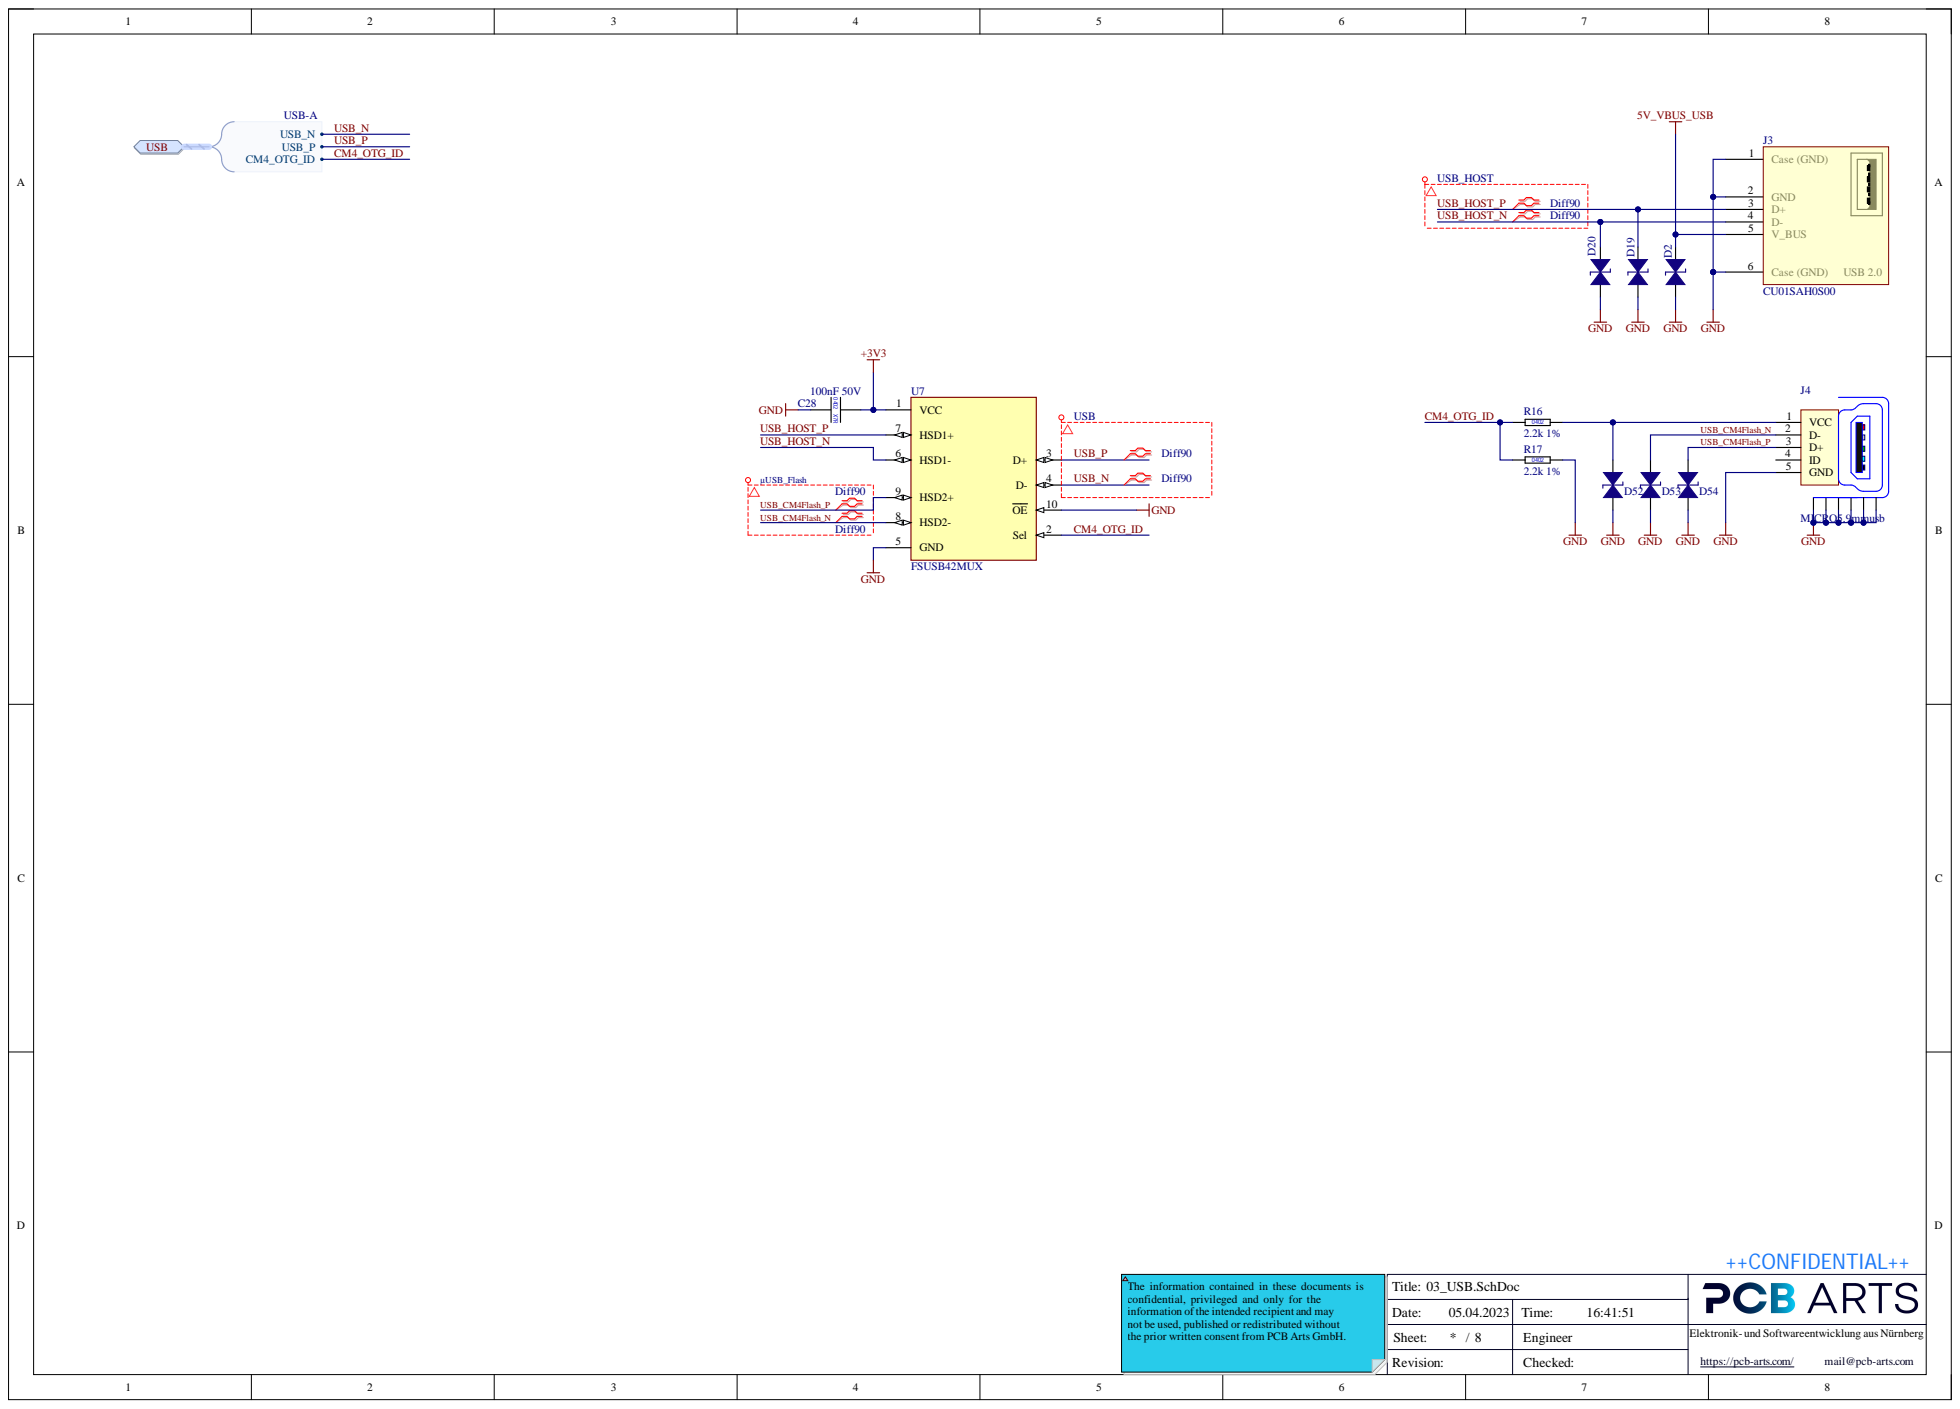
[picture p62: page 4]

USB_C M4Flash_P | 3

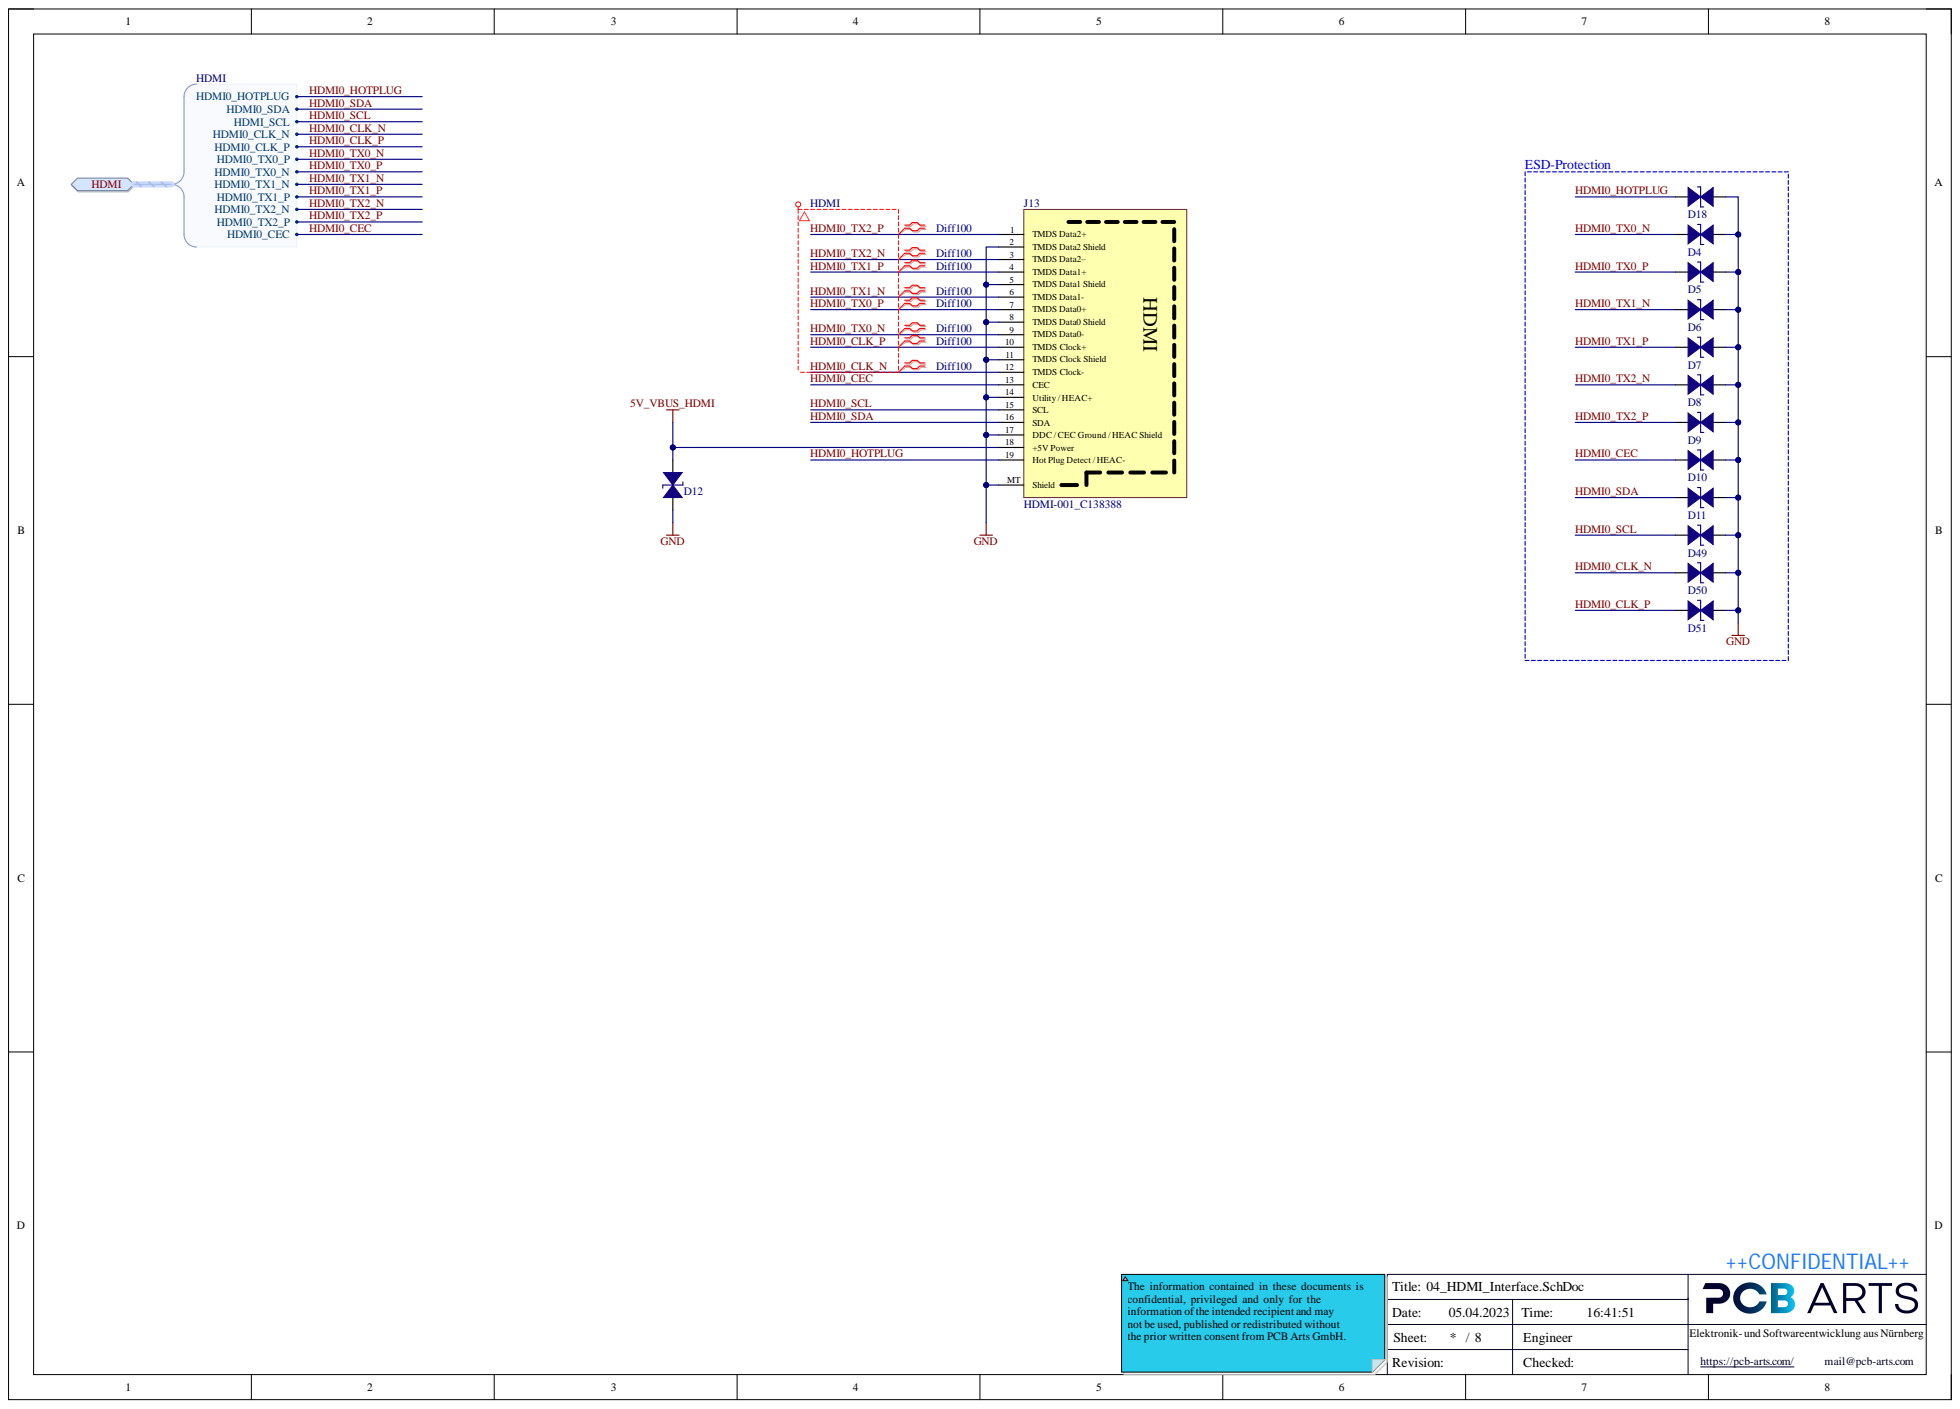
[picture p63: page 5]

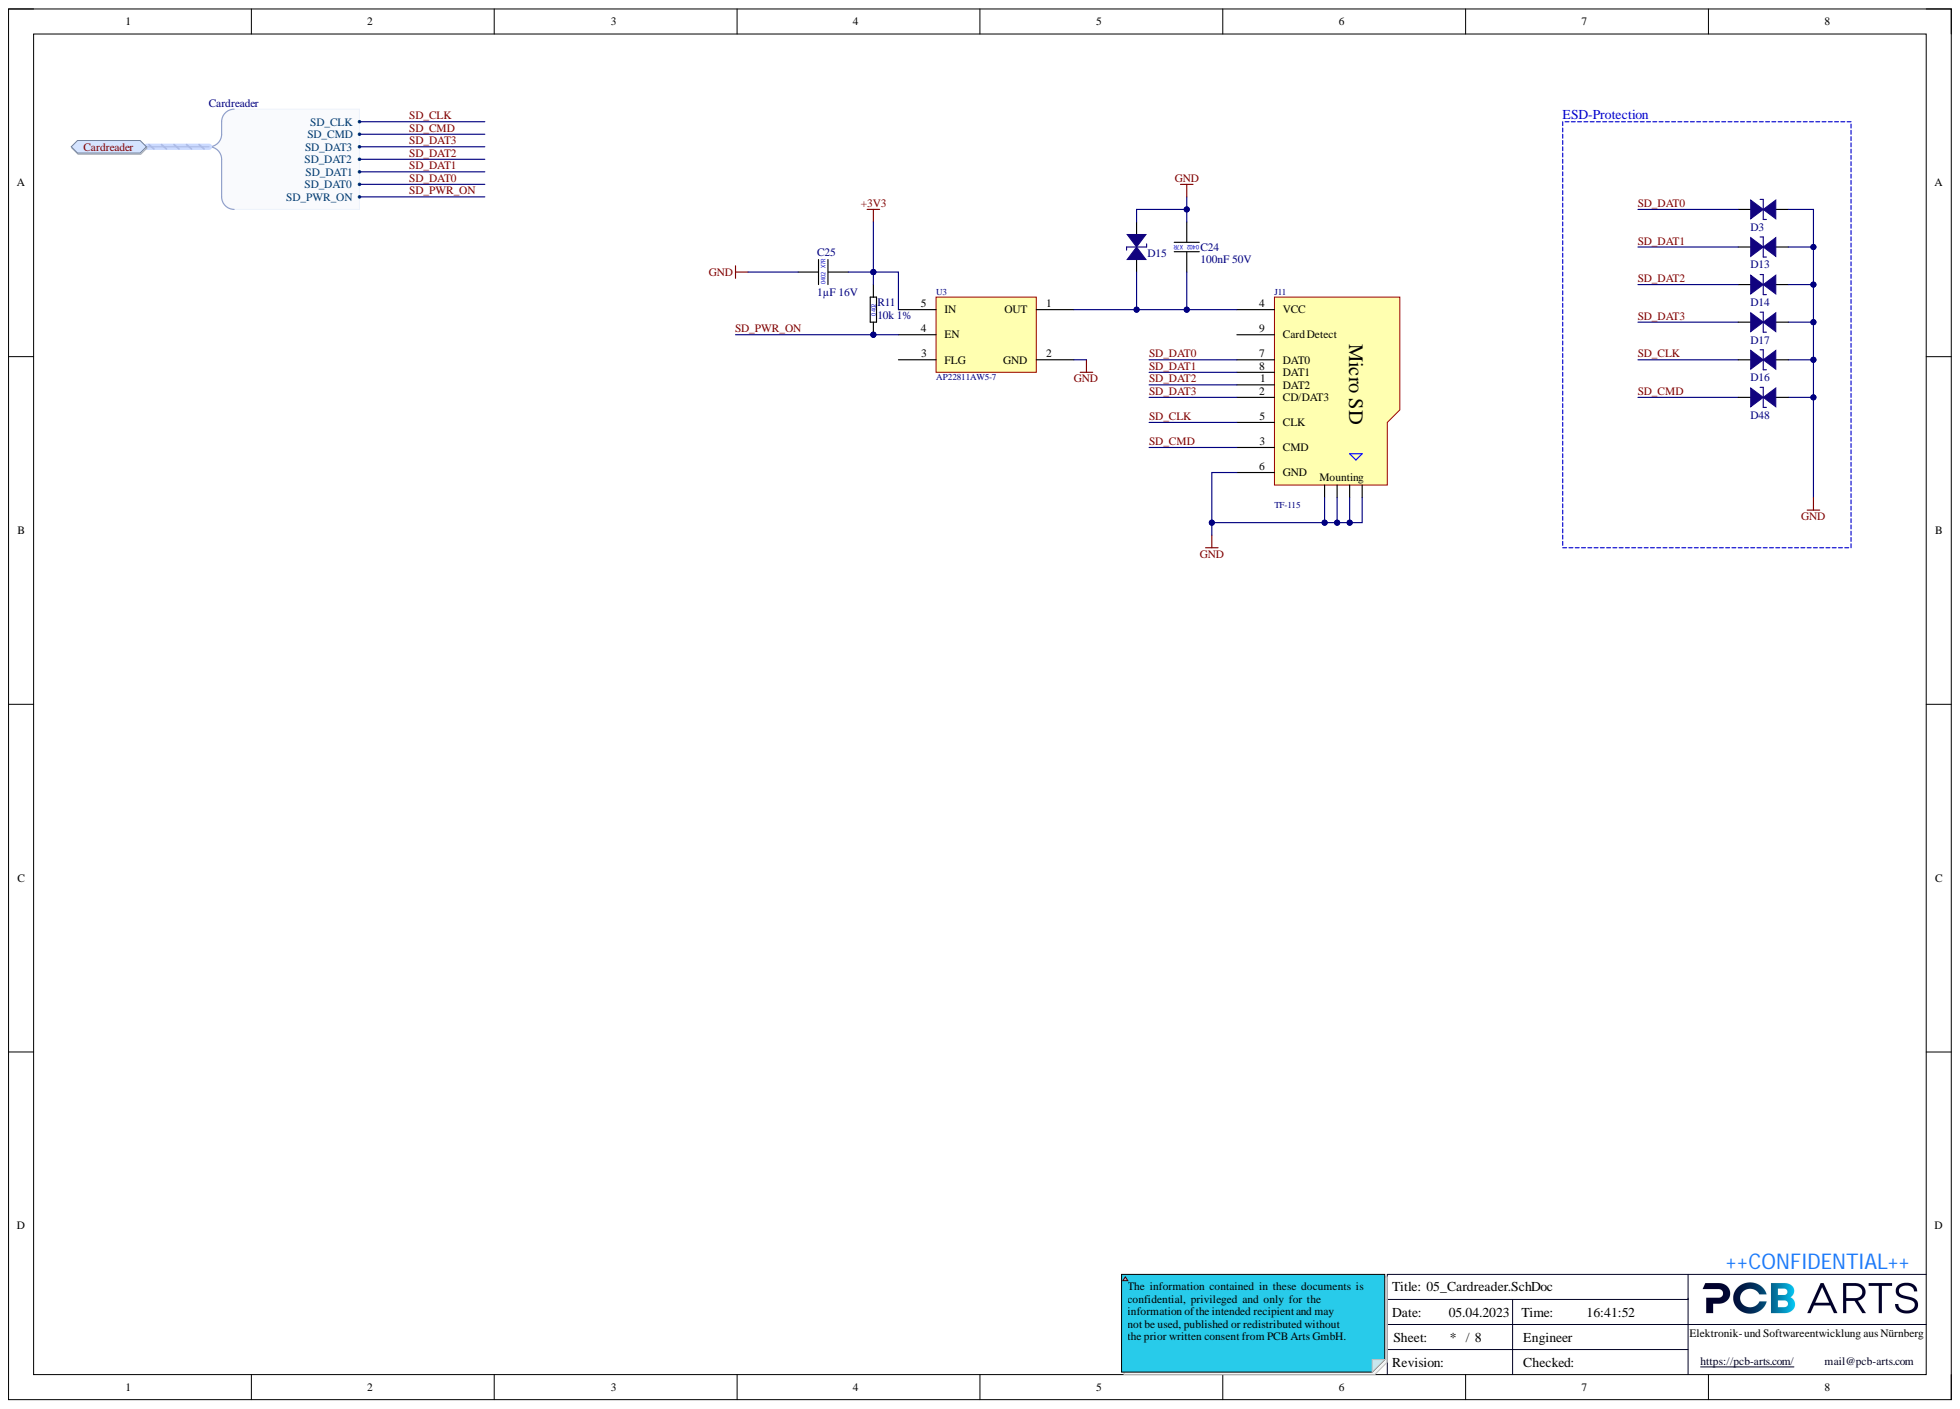
[picture p64: page 6]

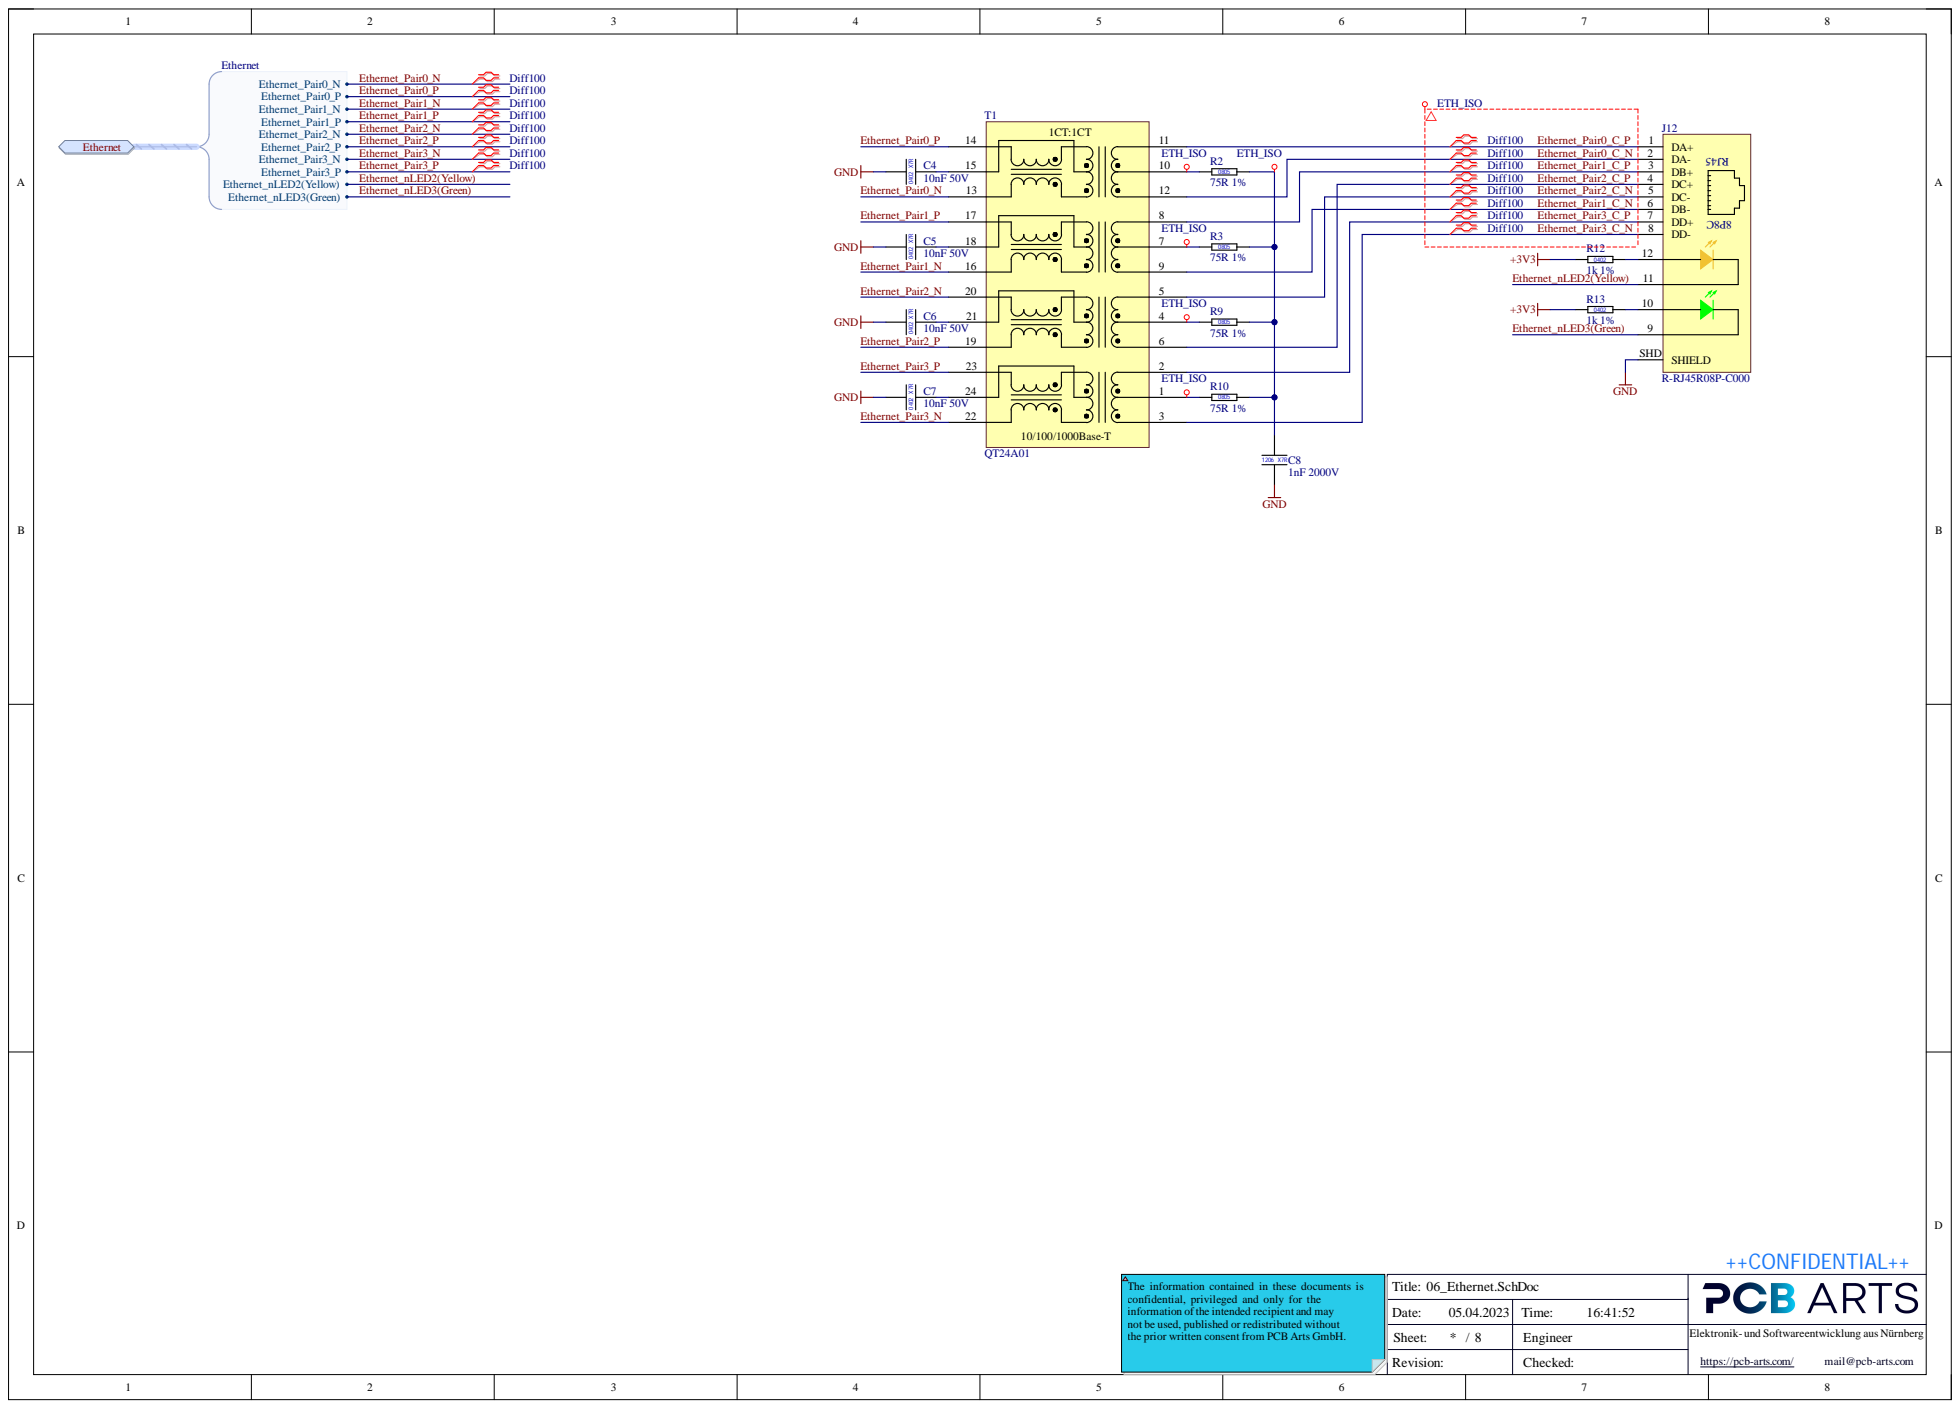
[picture p65: page 7]

R 2 D i ff10 0 E thernet_Pai r1_ C_P | 3 4

75R 1% 0805 R3 | | D i ff10 0 E thernet_Pai r2_C _N D i ff10 0 E thernet_Pai r1_C _N | 5 6

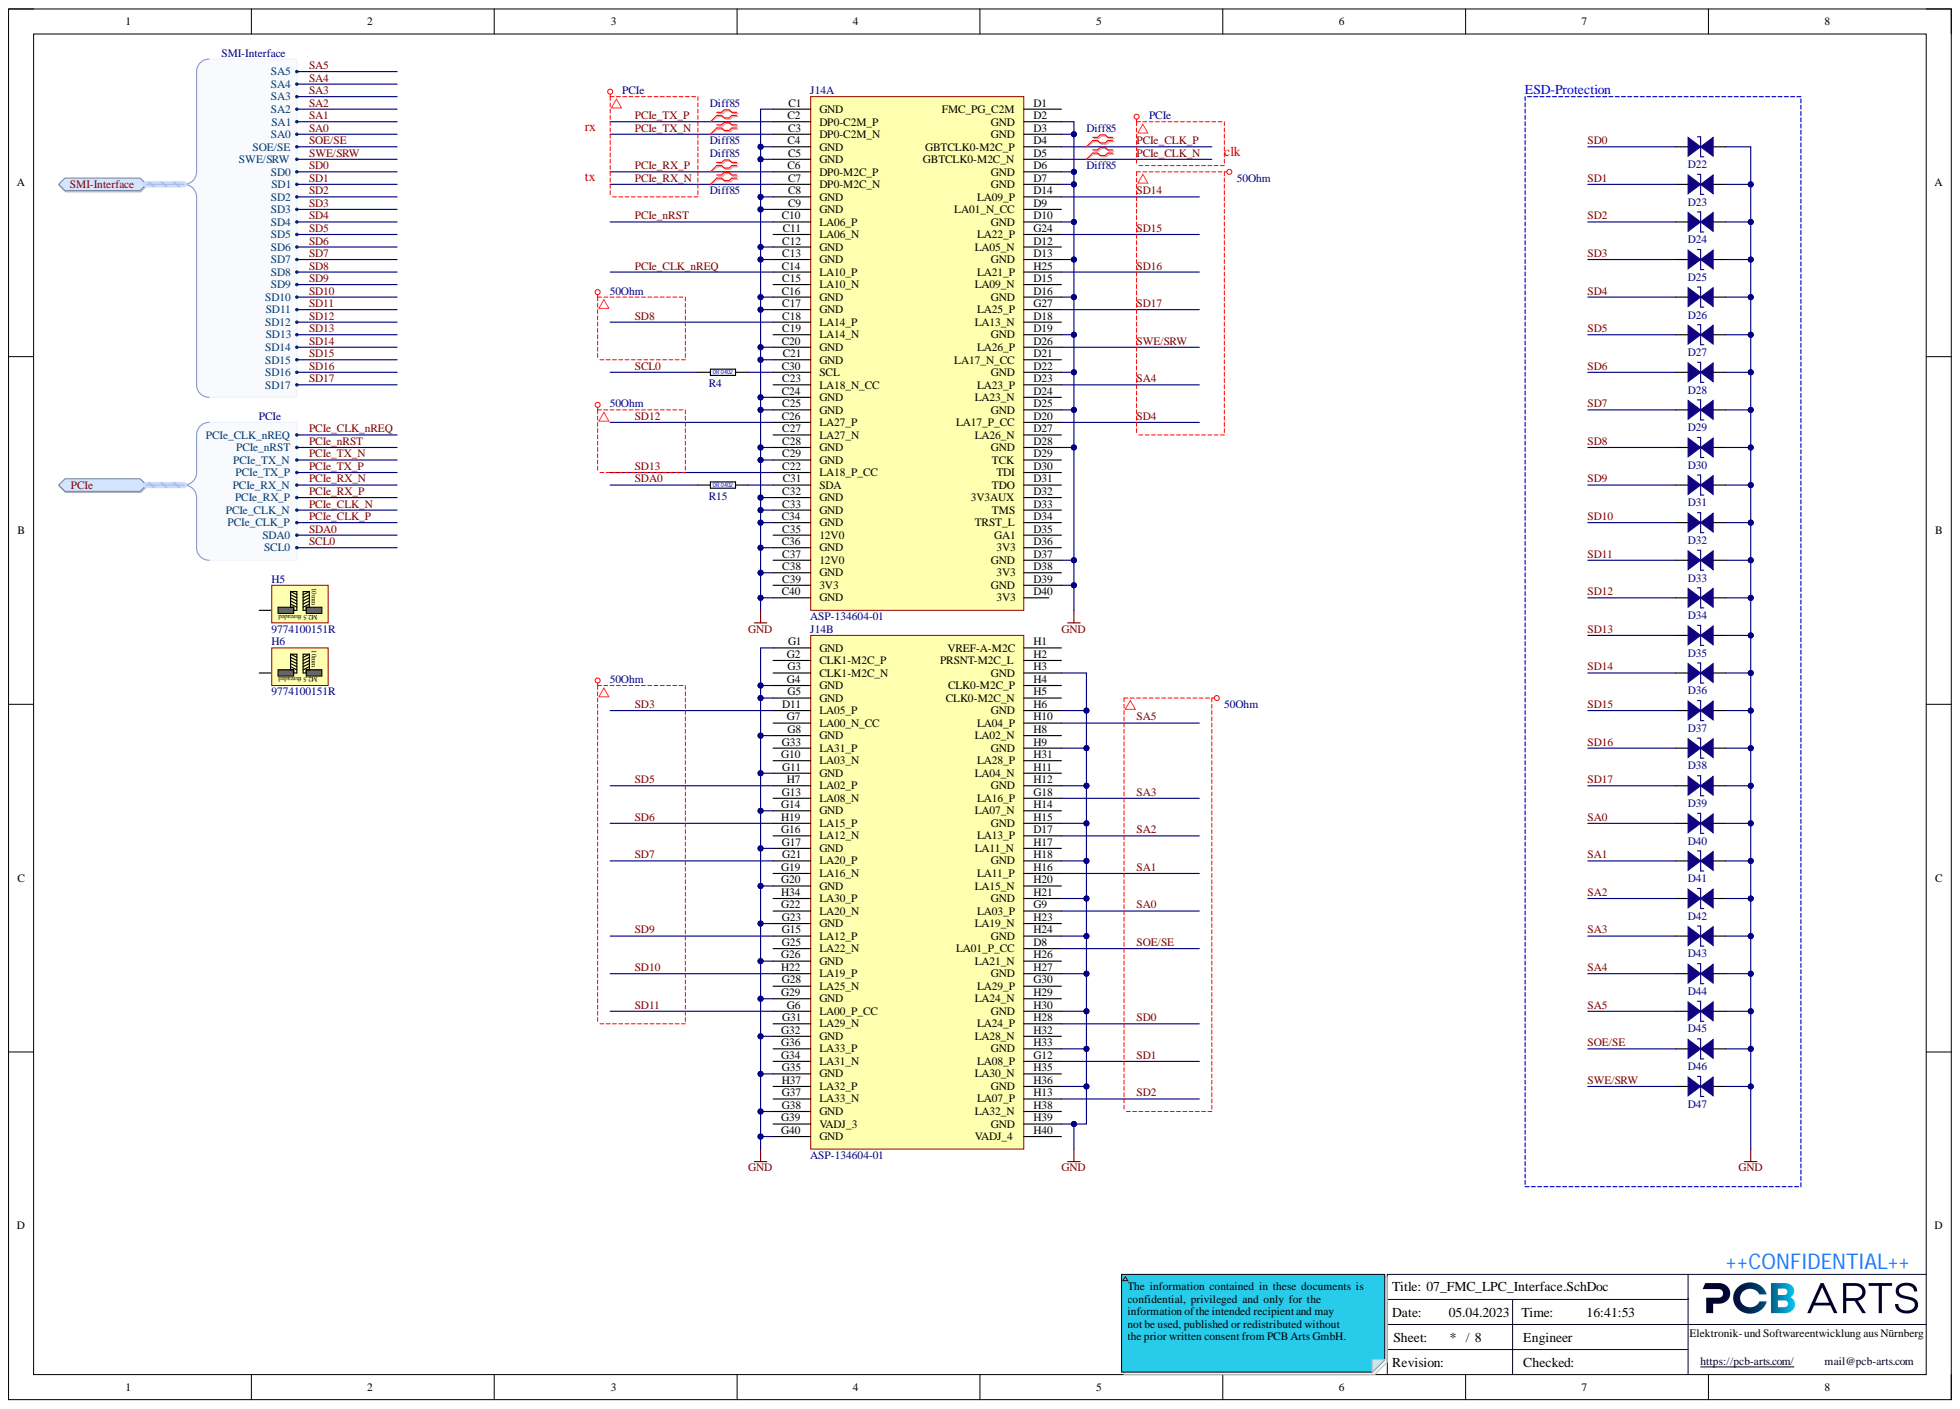
[picture p66: page 8]

C13 | D13
C14 C15 | H25 D15

C30 | D22
C23 | D23 D24

C25 | D25
C26 C27 | D20 D27

C29 | D29
C22 C31 | D30

C32 | D32
C33 | D33
C34 | D34
C35 | D35

G 5 | H 5
D 1 1 G 7 | H 6
