pcbarts/fast-open-switch-hardware/(list of files, drawings)

Other design files:
CM4 to FMC Adapter/CM4 to FMC Adapter r2.0/Source Data/00_Top_Level_Sheet.SchDoc
CM4 to FMC Adapter/CM4 to FMC Adapter r2.0/Source Data/01_Powersupply.SchDoc
CM4 to FMC Adapter/CM4 to FMC Adapter r2.0/Source Data/02_CM4 Module.SchDoc
CM4 to FMC Adapter/CM4 to FMC Adapter r2.0/Source Data/03_USB.SchDoc
CM4 to FMC Adapter/CM4 to FMC Adapter r2.0/Source Data/04_HDMI_Interface.SchDoc
CM4 to FMC Adapter/CM4 to FMC Adapter r2.0/Source Data/05_Cardreader.SchDoc
CM4 to FMC Adapter/CM4 to FMC Adapter r2.0/Source Data/06_Ethernet.SchDoc
CM4 to FMC Adapter/CM4 to FMC Adapter r2.0/Source Data/07_FMC_LPC_Interface.SchDoc
CM4 to FMC Adapter/CM4 to FMC Adapter r2.0/Source Data/RPi_CM4_Testadapter.PrjPcb
fast-open-switch r1.0/Source Data/Bank 0_Bank 14.SchDoc
fast-open-switch r1.0/Source Data/Bank 13_Bank 15_Bank 16.SchDoc
fast-open-switch r1.0/Source Data/Buck Modules.SchDoc
fast-open-switch r1.0/Source Data/DDR3 Memory_Banks 32-33-34.SchDoc
fast-open-switch r1.0/Source Data/DDR3 Memory_SO-DIMM.SchDoc
fast-open-switch r1.0/Source Data/fast-open-switch r1.0.PrjPcb
fast-open-switch r1.0/Source Data/FPGA Supply Pins.SchDoc
fast-open-switch r1.0/Source Data/FPGA_HDMI_IN_OUT.SchDoc
fast-open-switch r1.0/Source Data/HMI.SchDoc
fast-open-switch r1.0/Source Data/I2C Multiplexer.SchDoc
fast-open-switch r1.0/Source Data/MGT Banks 115-116.SchDoc
fast-open-switch r1.0/Source Data/PWR_CTRL.SchDoc
fast-open-switch r1.0/Source Data/QSPI Flash_eMMC_uSD-Card.SchDoc
fast-open-switch r1.0/Source Data/Raspberry Pi CM4.SchDoc
fast-open-switch r1.0/Source Data/Raspberry Pi CM4_Periphery.SchDoc
fast-open-switch r1.0/Source Data/SFP+_Connectors.SchDoc
fast-open-switch r1.0/Source Data/SMI Bank 12.SchDoc
fast-open-switch r1.0/Source Data/Spare Pins.SchDoc
fast-open-switch r1.0/Source Data/SSD M.2_B-Key.SchDoc
fast-open-switch r1.0/Source Data/System Clocks.SchDoc
fast-open-switch r1.0/Source Data/Top-Level-Sheet.SchDoc
fast-open-switch r1.0/Source Data/USB-HUB-MUX.SchDoc
fast-open-switch r1.0/Source Data/USB-UART-interface.SchDoc
