pcbarts/fast-open-switch-hardware/fast-open-switch r1.0 - KiCad/Bank 0_Bank 14.kicad_sch

## KiCad design fast-open-switch r1.0 - KiCad/Bank 0_Bank 14.kicad_sch (2023-05-11)

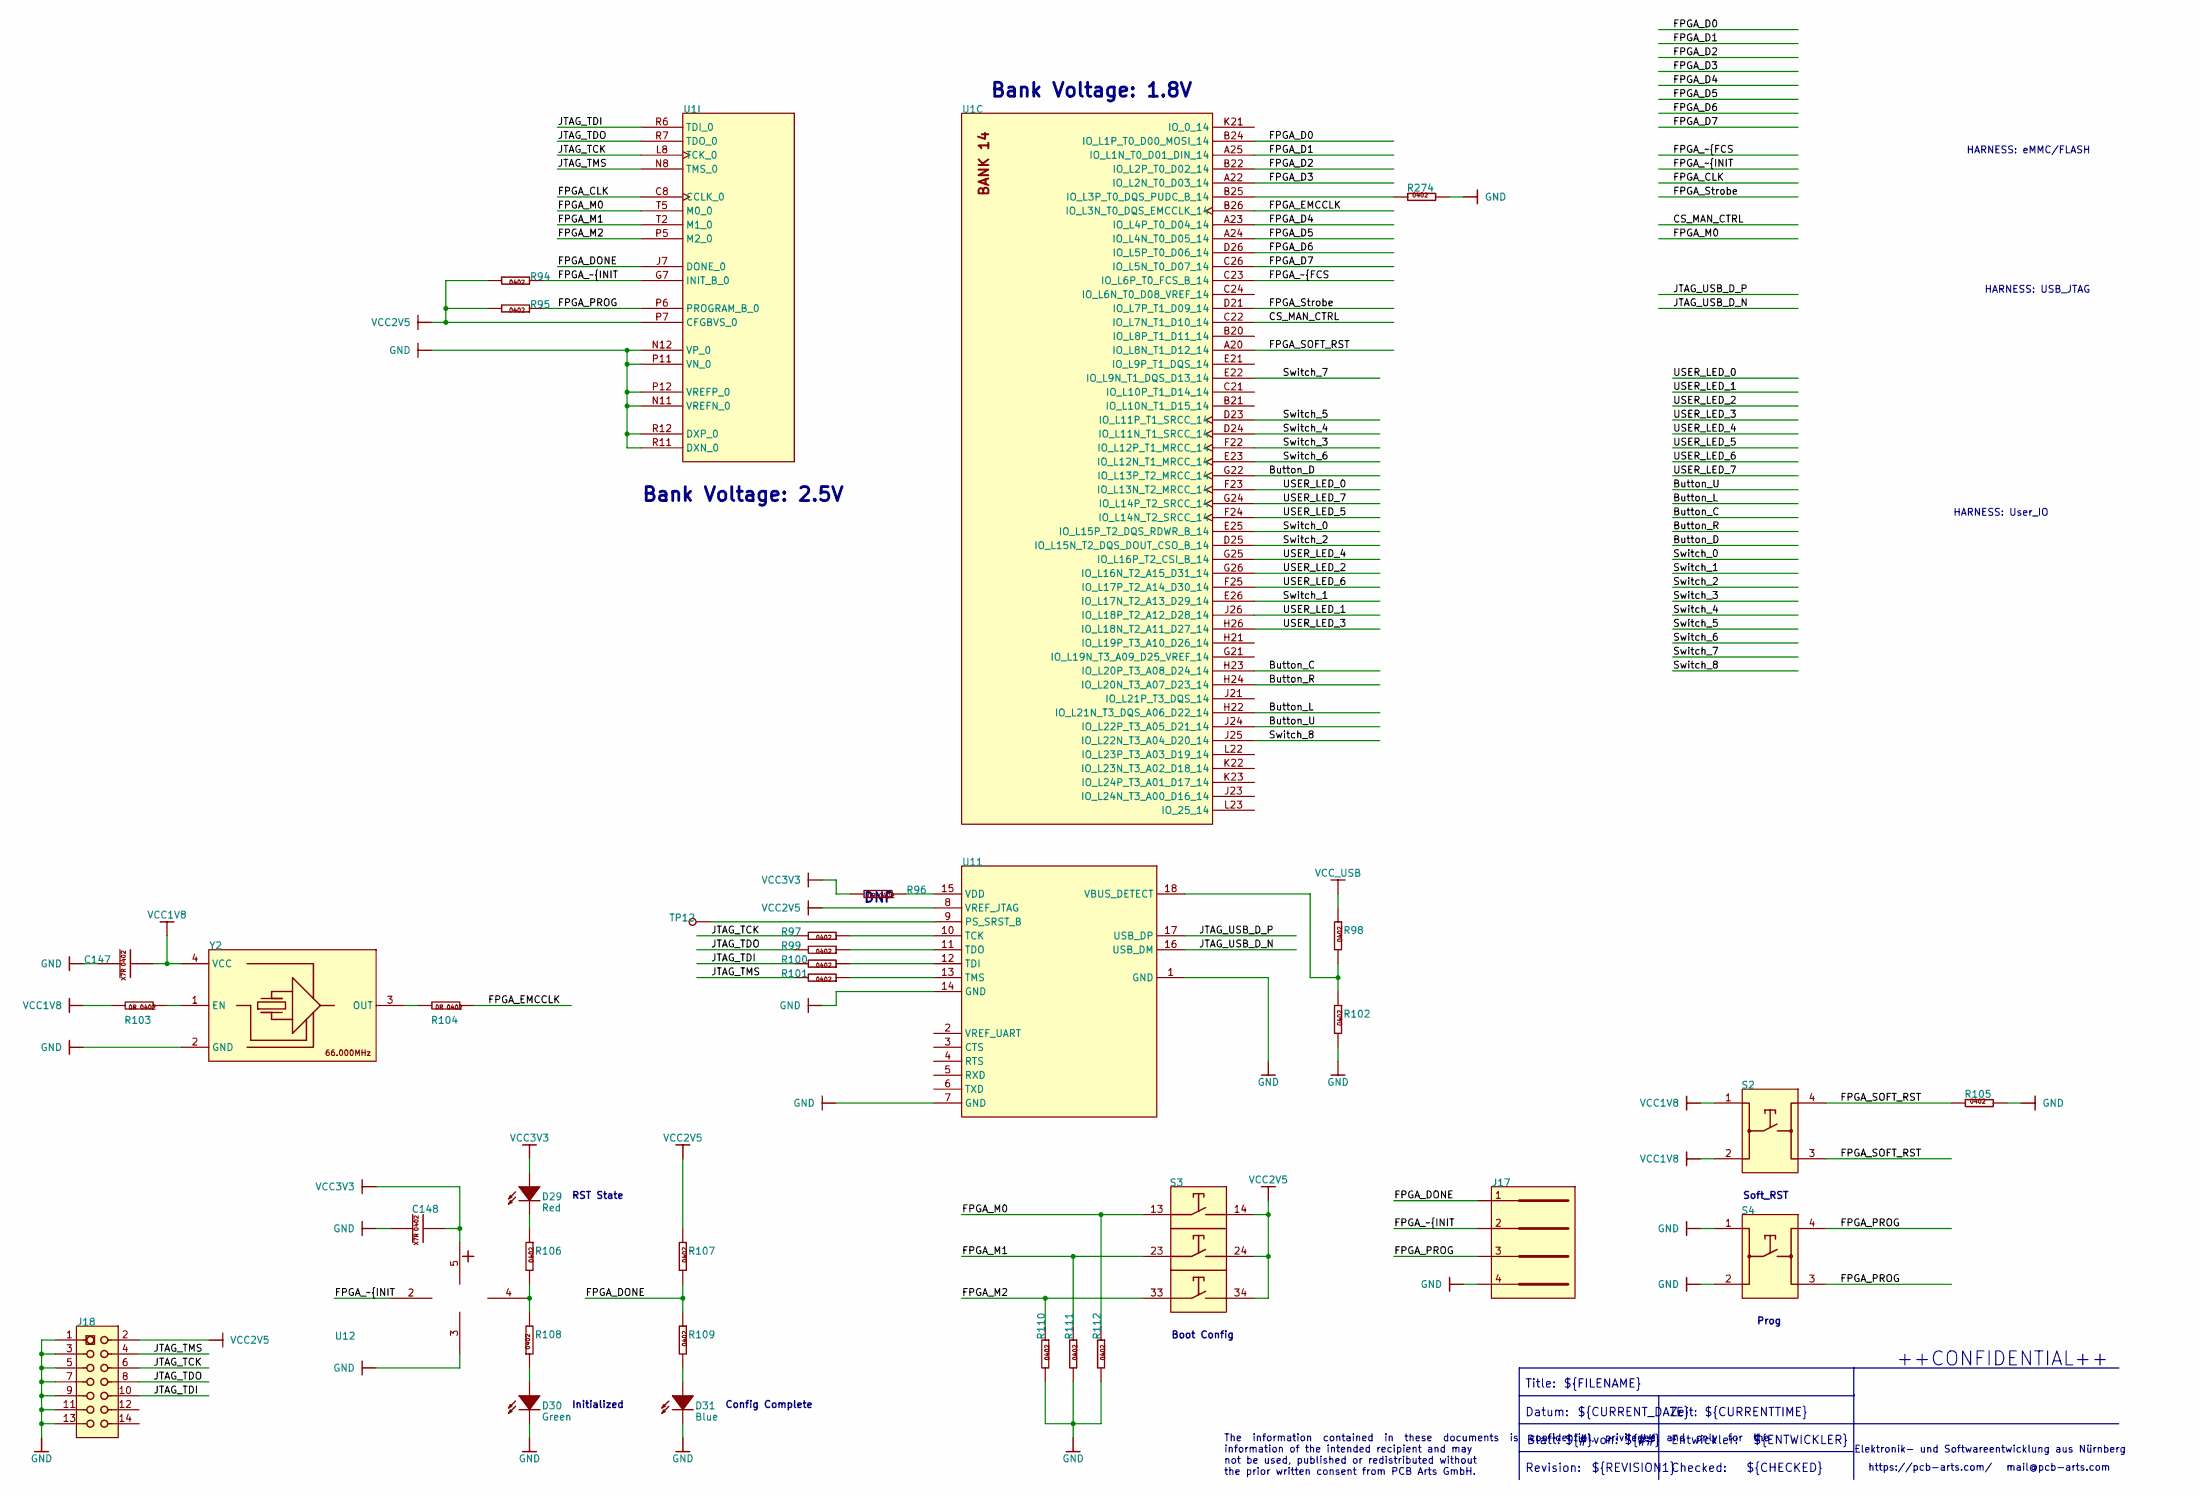
[picture p67: schematic Bank 0_Bank 14.kicad_sch]

Parts:
C147, C148: CAP_0402_L
D29, D30, D31: LED-0603 Sideview
J17: 61300411121
J18: 87832-1420
R94, R95, R96, R97, R98, R99, R100, R101, R102, R103, R104, R105, R106, R107, R108, R109, R110, R111, R112, R274: RES_0402_L
S2, S4: LL3301BF065QJ
S3: CUI DS04-254-SMT Series, 3 Pole
TP12: Testpoint 0.8mm
U1: BGA100P2700X2700X317-676N
U11: JTAG-SMT3-NC
U12: SOT95P275X110-5N
Y2: ASVMB Series

Connections:
Button_C: U1.H23 (IO_L20P_T3_A08_D24_14)
Button_D: U1.G22 (IO_L13P_T2_MRCC_14)
Button_L: U1.H22 (IO_L21N_T3_DQS_A06_D22_14)
Button_R: U1.H24 (IO_L20N_T3_A07_D23_14)
Button_U: U1.J24 (IO_L22P_T3_A05_D21_14)
CS_MAN_CTRL: U1.C22 (IO_L7N_T1_D10_14)
FPGA_CLK: U1.C8 (CCLK_0)
FPGA_D0: U1.B24 (IO_L1P_T0_D00_MOSI_14)
FPGA_D1: U1.A25 (IO_L1N_T0_D01_DIN_14)
FPGA_D2: U1.B22 (IO_L2P_T0_D02_14)
FPGA_D3: U1.A22 (IO_L2N_T0_D03_14)
FPGA_D4: U1.A23 (IO_L4P_T0_D04_14)
FPGA_D5: U1.A24 (IO_L4N_T0_D05_14)
FPGA_D6: U1.D26 (IO_L5P_T0_D06_14)
FPGA_D7: U1.C26 (IO_L5N_T0_D07_14)
FPGA_DONE: J17.1, R107.1, R109.2, U1.J7 (DONE_0)
FPGA_EMCCLK: R104.2, U1.B26 (IO_L3N_T0_DQS_EMCCLK_14)
FPGA_M0: R112.2, S3.13, U1.T5 (M0_0)
FPGA_M1: R111.2, S3.23, U1.T2 (M1_0)
FPGA_M2: R110.2, S3.33, U1.P5 (M2_0)
FPGA_PROG: J17.3, R95.2, S4.3, S4.4, U1.P6 (PROGRAM_B_0)
FPGA_SOFT_RST: R105.2, S2.3, S2.4, U1.A20 (IO_L8N_T1_D12_14)
FPGA_Strobe: U1.D21 (IO_L7P_T1_D09_14)
FPGA_~{FCS: U1.C23 (IO_L6P_T0_FCS_B_14)
FPGA_~{INIT: J17.2, R94.2, U1.G7 (INIT_B_0), U12.2 (A)
JTAG_TCK: J18.6, R97.1, U1.L8 (TCK_0)
JTAG_TDI: J18.10, R100.1, U1.R6 (TDI_0)
JTAG_TDO: J18.8, R99.1, U1.R7 (TDO_0)
JTAG_TMS: J18.4, R101.1, U1.N8 (TMS_0)
JTAG_USB_D_N: U11.16 (USB_DM)
JTAG_USB_D_P: U11.17 (USB_DP)
unnamed: C147.1, Y2.4 (VCC)
unnamed: C148.1, U12.5 (VCC)
unnamed: D29.1, R106.2
unnamed: D30.2, R108.2
unnamed: D31.2, R109.1
unnamed: J18.1, J18.3, J18.5, J18.7, J18.9, J18.11, J18.13
unnamed: R94.1, R95.1, U1.P7 (CFGBVS_0)
unnamed: R96.2, U11.15 (VDD)
unnamed: R97.2, U11.10 (TCK)
unnamed: R99.2, U11.11 (TDO)
unnamed: R100.2, U11.12 (TDI)
unnamed: R101.2, U11.13 (TMS)
unnamed: R98.1, R102.2, U11.18 (VBUS_DETECT)
unnamed: R103.2, Y2.1 (EN)
unnamed: R104.1, Y2.3 (OUT)
unnamed: R106.1, R108.1, U12.4 (Y)
unnamed: R110.1, R111.1, R112.1
unnamed: R274.2, U1.B25 (IO_L3P_T0_DQS_PUDC_B_14)
unnamed: S3.14, S3.24, S3.34
unnamed: TP12.1, U11.9 (PS_SRST_B)
unnamed: U1.N11 (VREFN_0), U1.N12 (VP_0), U1.P11 (VN_0), U1.P12 (VREFP_0), U1.R11 (DXN_0), U1.R12 (DXP_0)
Switch_0: U1.E25 (IO_L15P_T2_DQS_RDWR_B_14)
Switch_1: U1.E26 (IO_L17N_T2_A13_D29_14)
Switch_2: U1.D25 (IO_L15N_T2_DQS_DOUT_CSO_B_14)
Switch_3: U1.F22 (IO_L12P_T1_MRCC_14)
Switch_4: U1.D24 (IO_L11N_T1_SRCC_14)
Switch_5: U1.D23 (IO_L11P_T1_SRCC_14)
Switch_6: U1.E23 (IO_L12N_T1_MRCC_14)
Switch_7: U1.E22 (IO_L9N_T1_DQS_D13_14)
Switch_8: U1.J25 (IO_L22N_T3_A04_D20_14)
USER_LED_0: U1.F23 (IO_L13N_T2_MRCC_14)
USER_LED_1: U1.J26 (IO_L18P_T2_A12_D28_14)
USER_LED_2: U1.G26 (IO_L16N_T2_A15_D31_14)
USER_LED_3: U1.H26 (IO_L18N_T2_A11_D27_14)
USER_LED_4: U1.G25 (IO_L16P_T2_CSI_B_14)
USER_LED_5: U1.F24 (IO_L14N_T2_SRCC_14)
USER_LED_6: U1.F25 (IO_L17P_T2_A14_D30_14)
USER_LED_7: U1.G24 (IO_L14P_T2_SRCC_14)

Notes on the sheet:
Bank Voltage: 1.8V
++CONFIDENTIAL++
The information contained in these documents is confidential, privileged and only for the information of the intended recipient and may not be used, published or redistributed without the prior written consent from PCB Arts GmbH.
HARNESS: eMMC/FLASH
Zeit:
${CURRENT_DATE}
DNP
Revision:
${ENTWICKLER}
Soft_RST
Elektronik- und Softwareentwicklung aus Nürnberg
${CURRENTTIME}
${FILENAME}
Checked:
Entwickler:
Bank Voltage: 2.5V
von:
RST State
mail@pcb-arts.com
HARNESS: User_IO
https://pcb-arts.com/
Initialized
Datum:
Prog
${CHECKED}
HARNESS: USB_JTAG
${#}
Boot Config
${REVISION1}
Config Complete
${##}
Title:
Blatt:
