pcbarts/fast-open-switch-hardware/fast-open-switch r1.0 - KiCad/Bank 13_Bank 15_Bank 16.kicad_sch

## KiCad design fast-open-switch r1.0 - KiCad/Bank 13_Bank 15_Bank 16.kicad_sch (2023-05-11)

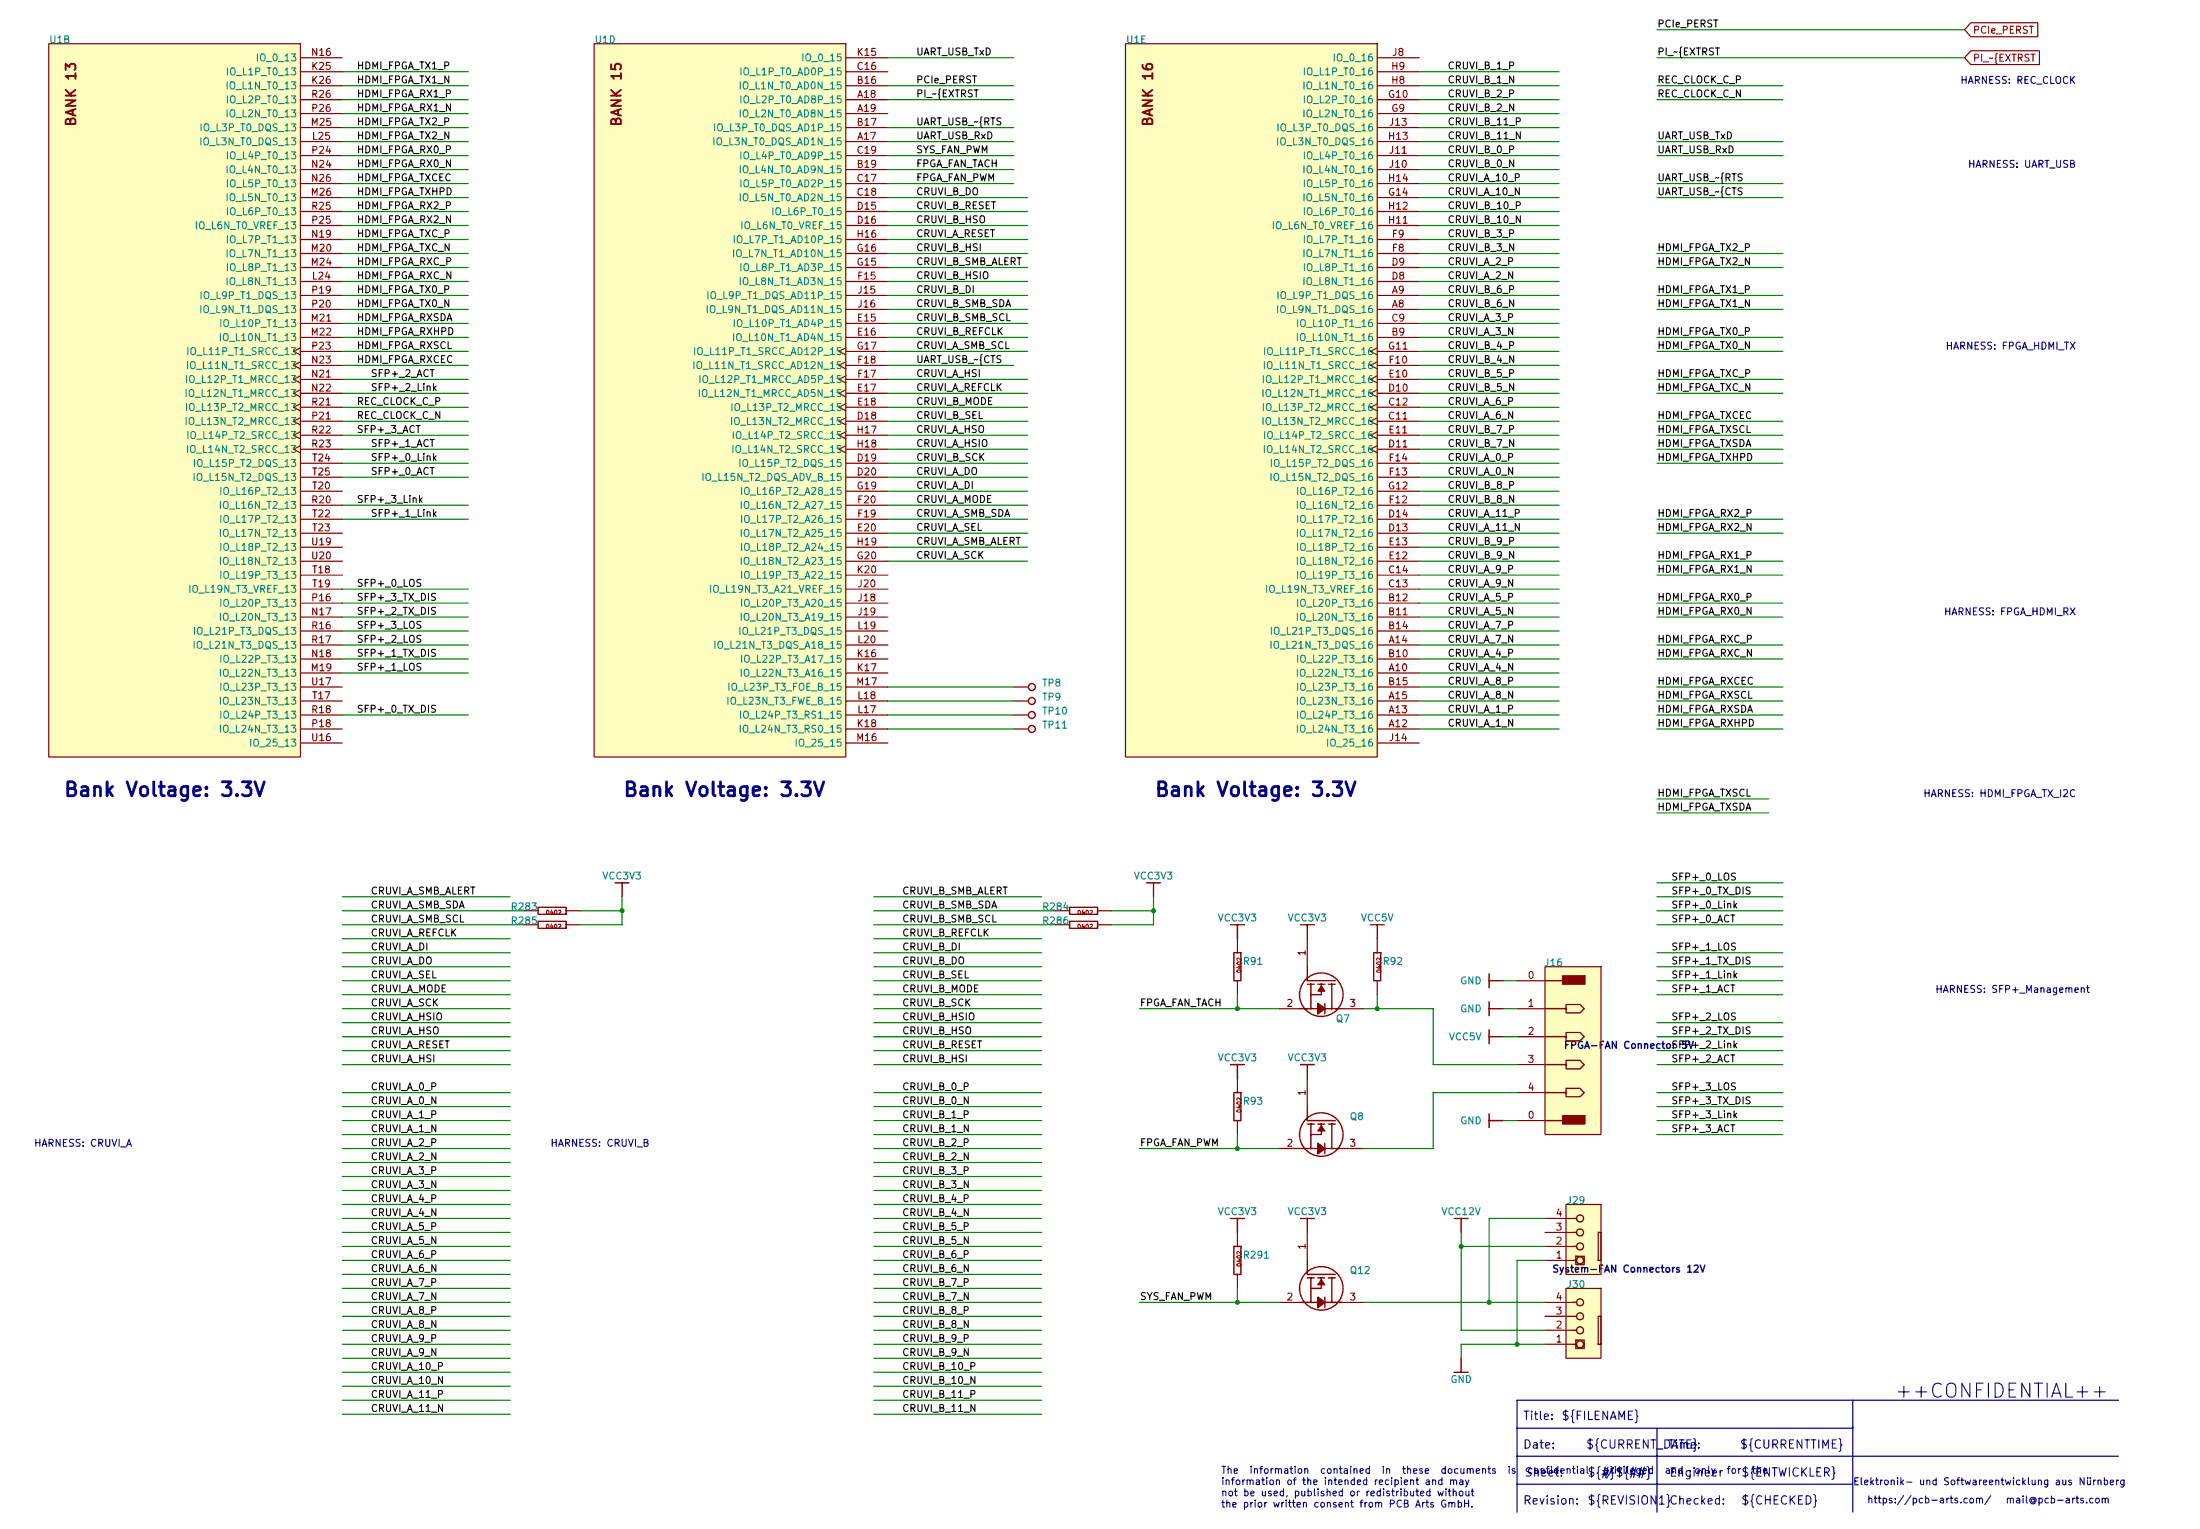
[picture p68: schematic Bank 13_Bank 15_Bank 16.kicad_sch]

Parts:
J16: Molex 53398-0476
J29, J30: PINREX 744-81-04TG20
Q7, Q8, Q12: SOT95P251X112-3N
R91, R92, R93, R283, R284, R285, R286, R291: RES_0402_L
TP8, TP9, TP10, TP11: Testpoint 0.8mm
U1: BGA100P2700X2700X317-676N

Connections:
CRUVI_A_0_N: U1.F13 (IO_L15N_T2_DQS_16)
CRUVI_A_0_P: U1.F14 (IO_L15P_T2_DQS_16)
CRUVI_A_1_N: U1.A12 (IO_L24N_T3_16)
CRUVI_A_1_P: U1.A13 (IO_L24P_T3_16)
CRUVI_A_2_N: U1.D8 (IO_L8N_T1_16)
CRUVI_A_2_P: U1.D9 (IO_L8P_T1_16)
CRUVI_A_3_N: U1.B9 (IO_L10N_T1_16)
CRUVI_A_3_P: U1.C9 (IO_L10P_T1_16)
CRUVI_A_4_N: U1.A10 (IO_L22N_T3_16)
CRUVI_A_4_P: U1.B10 (IO_L22P_T3_16)
CRUVI_A_5_N: U1.B11 (IO_L20N_T3_16)
CRUVI_A_5_P: U1.B12 (IO_L20P_T3_16)
CRUVI_A_6_N: U1.C11 (IO_L13N_T2_MRCC_16)
CRUVI_A_6_P: U1.C12 (IO_L13P_T2_MRCC_16)
CRUVI_A_7_N: U1.A14 (IO_L21N_T3_DQS_16)
CRUVI_A_7_P: U1.B14 (IO_L21P_T3_DQS_16)
CRUVI_A_8_N: U1.A15 (IO_L23N_T3_16)
CRUVI_A_8_P: U1.B15 (IO_L23P_T3_16)
CRUVI_A_9_N: U1.C13 (IO_L19N_T3_VREF_16)
CRUVI_A_9_P: U1.C14 (IO_L19P_T3_16)
CRUVI_A_10_N: U1.G14 (IO_L5N_T0_16)
CRUVI_A_10_P: U1.H14 (IO_L5P_T0_16)
CRUVI_A_11_N: U1.D13 (IO_L17N_T2_16)
CRUVI_A_11_P: U1.D14 (IO_L17P_T2_16)
CRUVI_A_DI: U1.G19 (IO_L16P_T2_A28_15)
CRUVI_A_DO: U1.D20 (IO_L15N_T2_DQS_ADV_B_15)
CRUVI_A_HSI: U1.F17 (IO_L12P_T1_MRCC_AD5P_15)
CRUVI_A_HSIO: U1.H18 (IO_L14N_T2_SRCC_15)
CRUVI_A_HSO: U1.H17 (IO_L14P_T2_SRCC_15)
CRUVI_A_MODE: U1.F20 (IO_L16N_T2_A27_15)
CRUVI_A_REFCLK: U1.E17 (IO_L12N_T1_MRCC_AD5N_15)
CRUVI_A_RESET: U1.H16 (IO_L7P_T1_AD10P_15)
CRUVI_A_SCK: U1.G20 (IO_L18N_T2_A23_15)
CRUVI_A_SEL: U1.E20 (IO_L17N_T2_A25_15)
CRUVI_A_SMB_ALERT: U1.H19 (IO_L18P_T2_A24_15)
CRUVI_A_SMB_SCL: R285.1, U1.G17 (IO_L11P_T1_SRCC_AD12P_15)
CRUVI_A_SMB_SDA: R283.1, U1.F19 (IO_L17P_T2_A26_15)
CRUVI_B_0_N: U1.J10 (IO_L4N_T0_16)
CRUVI_B_0_P: U1.J11 (IO_L4P_T0_16)
CRUVI_B_1_N: U1.H8 (IO_L1N_T0_16)
CRUVI_B_1_P: U1.H9 (IO_L1P_T0_16)
CRUVI_B_2_N: U1.G9 (IO_L2N_T0_16)
CRUVI_B_2_P: U1.G10 (IO_L2P_T0_16)
CRUVI_B_3_N: U1.F8 (IO_L7N_T1_16)
CRUVI_B_3_P: U1.F9 (IO_L7P_T1_16)
CRUVI_B_4_N: U1.F10 (IO_L11N_T1_SRCC_16)
CRUVI_B_4_P: U1.G11 (IO_L11P_T1_SRCC_16)
CRUVI_B_5_N: U1.D10 (IO_L12N_T1_MRCC_16)
CRUVI_B_5_P: U1.E10 (IO_L12P_T1_MRCC_16)
CRUVI_B_6_N: U1.A8 (IO_L9N_T1_DQS_16)
CRUVI_B_6_P: U1.A9 (IO_L9P_T1_DQS_16)
CRUVI_B_7_N: U1.D11 (IO_L14N_T2_SRCC_16)
CRUVI_B_7_P: U1.E11 (IO_L14P_T2_SRCC_16)
CRUVI_B_8_N: U1.F12 (IO_L16N_T2_16)
CRUVI_B_8_P: U1.G12 (IO_L16P_T2_16)
CRUVI_B_9_N: U1.E12 (IO_L18N_T2_16)
CRUVI_B_9_P: U1.E13 (IO_L18P_T2_16)
CRUVI_B_10_N: U1.H11 (IO_L6N_T0_VREF_16)
CRUVI_B_10_P: U1.H12 (IO_L6P_T0_16)
CRUVI_B_11_N: U1.H13 (IO_L3N_T0_DQS_16)
CRUVI_B_11_P: U1.J13 (IO_L3P_T0_DQS_16)
CRUVI_B_DI: U1.J15 (IO_L9P_T1_DQS_AD11P_15)
CRUVI_B_DO: U1.C18 (IO_L5N_T0_AD2N_15)
CRUVI_B_HSI: U1.G16 (IO_L7N_T1_AD10N_15)
CRUVI_B_HSIO: U1.F15 (IO_L8N_T1_AD3N_15)
CRUVI_B_HSO: U1.D16 (IO_L6N_T0_VREF_15)
CRUVI_B_MODE: U1.E18 (IO_L13P_T2_MRCC_15)
CRUVI_B_REFCLK: U1.E16 (IO_L10N_T1_AD4N_15)
CRUVI_B_RESET: U1.D15 (IO_L6P_T0_15)
CRUVI_B_SCK: U1.D19 (IO_L15P_T2_DQS_15)
CRUVI_B_SEL: U1.D18 (IO_L13N_T2_MRCC_15)
CRUVI_B_SMB_ALERT: U1.G15 (IO_L8P_T1_AD3P_15)
CRUVI_B_SMB_SCL: R286.1, U1.E15 (IO_L10P_T1_AD4P_15)
CRUVI_B_SMB_SDA: R284.1, U1.J16 (IO_L9N_T1_DQS_AD11N_15)
FPGA_FAN_PWM: Q8.2 (D), R93.1, U1.C17 (IO_L5P_T0_AD2P_15)
FPGA_FAN_TACH: Q7.2 (D), R91.1, U1.B19 (IO_L4N_T0_AD9N_15)
HDMI_FPGA_RX0_N: U1.N24 (IO_L4N_T0_13)
HDMI_FPGA_RX0_P: U1.P24 (IO_L4P_T0_13)
HDMI_FPGA_RX1_N: U1.P26 (IO_L2N_T0_13)
HDMI_FPGA_RX1_P: U1.R26 (IO_L2P_T0_13)
HDMI_FPGA_RX2_N: U1.P25 (IO_L6N_T0_VREF_13)
HDMI_FPGA_RX2_P: U1.R25 (IO_L6P_T0_13)
HDMI_FPGA_RXCEC: U1.N23 (IO_L11N_T1_SRCC_13)
HDMI_FPGA_RXC_N: U1.L24 (IO_L8N_T1_13)
HDMI_FPGA_RXC_P: U1.M24 (IO_L8P_T1_13)
HDMI_FPGA_RXHPD: U1.M22 (IO_L10N_T1_13)
HDMI_FPGA_RXSCL: U1.P23 (IO_L11P_T1_SRCC_13)
HDMI_FPGA_RXSDA: U1.M21 (IO_L10P_T1_13)
HDMI_FPGA_TX0_N: U1.P20 (IO_L9N_T1_DQS_13)
HDMI_FPGA_TX0_P: U1.P19 (IO_L9P_T1_DQS_13)
HDMI_FPGA_TX1_N: U1.K26 (IO_L1N_T0_13)
HDMI_FPGA_TX1_P: U1.K25 (IO_L1P_T0_13)
HDMI_FPGA_TX2_N: U1.L25 (IO_L3N_T0_DQS_13)
HDMI_FPGA_TX2_P: U1.M25 (IO_L3P_T0_DQS_13)
HDMI_FPGA_TXCEC: U1.N26 (IO_L5P_T0_13)
HDMI_FPGA_TXC_N: U1.M20 (IO_L7N_T1_13)
HDMI_FPGA_TXC_P: U1.N19 (IO_L7P_T1_13)
HDMI_FPGA_TXHPD: U1.M26 (IO_L5N_T0_13)
unnamed: J16.3, Q7.3 (S), R92.1
unnamed: J16.4, Q8.3 (S)
unnamed: J29.1, J30.1
unnamed: J29.2, J30.2
unnamed: J29.4, J30.4, Q12.3 (S)
unnamed: R283.2, R285.2
unnamed: R284.2, R286.2
unnamed: TP8.1, U1.M17 (IO_L23P_T3_FOE_B_15)
unnamed: TP9.1, U1.L18 (IO_L23N_T3_FWE_B_15)
unnamed: TP10.1, U1.L17 (IO_L24P_T3_RS1_15)
unnamed: TP11.1, U1.K18 (IO_L24N_T3_RS0_15)
PCIe_PERST: U1.B16 (IO_L1N_T0_AD0N_15)
PI_~{EXTRST: U1.A18 (IO_L2P_T0_AD8P_15)
REC_CLOCK_C_N: U1.P21 (IO_L13N_T2_MRCC_13)
REC_CLOCK_C_P: U1.R21 (IO_L13P_T2_MRCC_13)
SFP+_0_ACT: U1.T25 (IO_L15N_T2_DQS_13)
SFP+_0_LOS: U1.T19 (IO_L19N_T3_VREF_13)
SFP+_0_Link: U1.T24 (IO_L15P_T2_DQS_13)
SFP+_0_TX_DIS: U1.R18 (IO_L24P_T3_13)
SFP+_1_ACT: U1.R23 (IO_L14N_T2_SRCC_13)
SFP+_1_LOS: U1.M19 (IO_L22N_T3_13)
SFP+_1_Link: U1.T22 (IO_L17P_T2_13)
SFP+_1_TX_DIS: U1.N18 (IO_L22P_T3_13)
SFP+_2_ACT: U1.N21 (IO_L12P_T1_MRCC_13)
SFP+_2_LOS: U1.R17 (IO_L21N_T3_DQS_13)
SFP+_2_Link: U1.N22 (IO_L12N_T1_MRCC_13)
SFP+_2_TX_DIS: U1.N17 (IO_L20N_T3_13)
SFP+_3_ACT: U1.R22 (IO_L14P_T2_SRCC_13)
SFP+_3_LOS: U1.R16 (IO_L21P_T3_DQS_13)
SFP+_3_Link: U1.R20 (IO_L16N_T2_13)
SFP+_3_TX_DIS: U1.P16 (IO_L20P_T3_13)
SYS_FAN_PWM: Q12.2 (D), R291.1, U1.C19 (IO_L4P_T0_AD9P_15)
UART_USB_RxD: U1.A17 (IO_L3N_T0_DQS_AD1N_15)
UART_USB_TxD: U1.K15 (IO_0_15)
UART_USB_~{CTS: U1.F18 (IO_L11N_T1_SRCC_AD12N_15)
UART_USB_~{RTS: U1.B17 (IO_L3P_T0_DQS_AD1P_15)

Notes on the sheet:
Date:
Sheet:
${CURRENTTIME}
${CURRENT_DATE}
++CONFIDENTIAL++
${ENTWICKLER}
${CHECKED}
HARNESS: REC_CLOCK
Elektronik- und Softwareentwicklung aus Nürnberg
Engineer
FPGA-FAN Connector 5V
Bank Voltage: 3.3V
HARNESS: SFP+_Management
https://pcb-arts.com/
Checked:
mail@pcb-arts.com
Title:
The information contained in these documents is confidential, privileged and only for the information of the intended recipient and may not be used, published or redistributed without the prior written consent from PCB Arts GmbH.
${#}
${REVISION1}
Time:
HARNESS: FPGA_HDMI_RX
HARNESS: HDMI_FPGA_TX_I2C
${##}
${FILENAME}
HARNESS: FPGA_HDMI_TX
HARNESS: UART_USB
Revision:
HARNESS: CRUVI_B
HARNESS: CRUVI_A
System-FAN Connectors 12V
