pcbarts/fast-open-switch-hardware/fast-open-switch r1.0 - KiCad/Buck Modules.kicad_sch

## KiCad design fast-open-switch r1.0 - KiCad/Buck Modules.kicad_sch (2023-05-11)

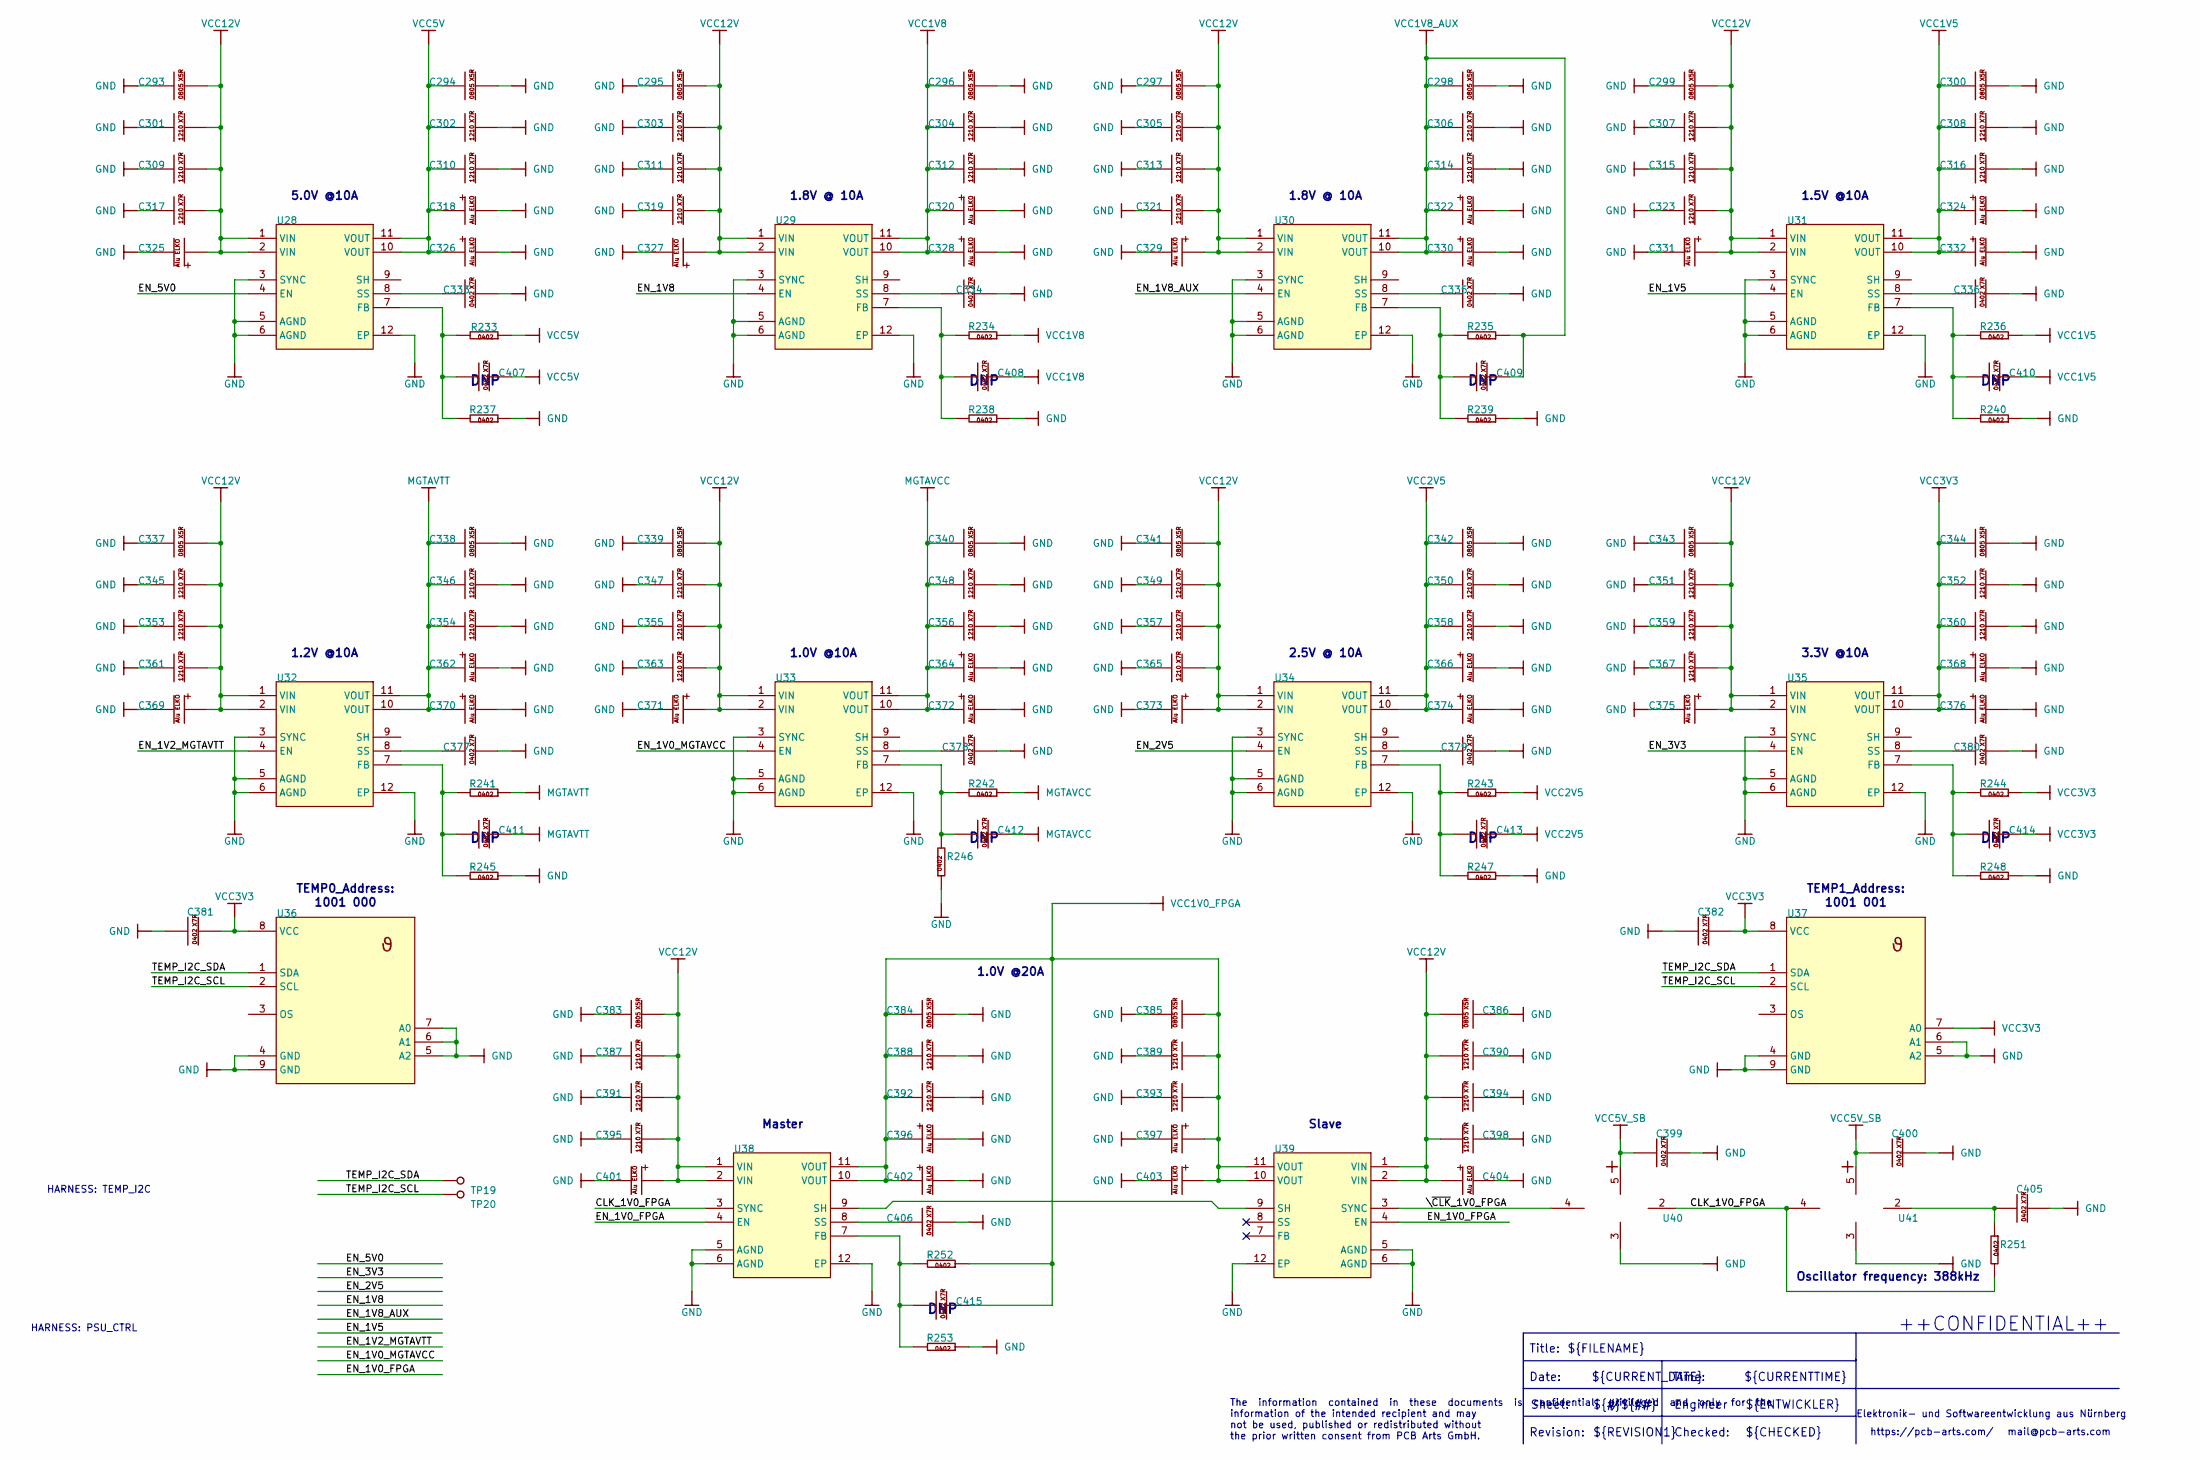
[picture p69: schematic Buck Modules.kicad_sch]

Parts:
C293, C294, C295, C296, C297, C298, C299, C300, C337, C338, C339, C340, C341, C342, C343, C344, C383, C384, C385, C386: CAP_0805
C301, C302, C303, C304, C305, C306, C307, C308, C309, C310, C311, C312, C313, C314, C315, C316, C317, C319, C321, C323, C345, C346, C347, C348, C349, C350, C351, C352, C353, C354, C355, C356, C357, C358, C359, C360, C361, C363, C365, C367, C387, C388, C389, C390, C391, C392, C393, C394, C395, C398: CAP_1210
C318, C320, C322, C324, C325, C326, C327, C328, C329, C330, C331, C332, C362, C364, C366, C368, C369, C370, C371, C372, C373, C374, C375, C376, C396, C397, C401, C402, C403, C404: WCAP-PTG5_D10H12.5
C333, C334, C335, C336, C377, C378, C379, C380, C381, C382, C399, C400, C405, C406, C407, C408, C409, C410, C411, C412, C413, C414, C415: CAP_0402_L
R233, R234, R235, R236, R237, R238, R239, R240, R241, R242, R243, R244, R245, R246, R247, R248, R251, R252, R253: RES_0402_L
TP19, TP20: Testpoint 0.8mm
U28, U29, U30, U31, U32, U33, U34, U35, U38, U39: TI Simpleswitcher NDY0011A_N
U36, U37: SOT1069-2 (HWSON8)
U40, U41: SOT95P275X110-5N

Connections:
CLK_1V0_FPGA: R251.1, U38.3 (SYNC), U40.2 (A), U41.4 (Y)
EN_1V0_FPGA: U38.4 (EN), U39.4 (EN)
EN_1V0_MGTAVCC: U33.4 (EN)
EN_1V2_MGTAVTT: U32.4 (EN)
EN_1V5: U31.4 (EN)
EN_1V8: U29.4 (EN)
EN_1V8_AUX: U30.4 (EN)
EN_2V5: U34.4 (EN)
EN_3V3: U35.4 (EN)
EN_5V0: U28.4 (EN)
unnamed: C293.2, C301.2, C309.2, C317.2, C325.1, U28.1 (VIN), U28.2 (VIN)
unnamed: C294.1, C302.1, C310.1, C318.1, C326.1, U28.10 (VOUT), U28.11 (VOUT)
unnamed: C295.2, C303.2, C311.2, C319.2, C327.1, U29.1 (VIN), U29.2 (VIN)
unnamed: C296.1, C304.1, C312.1, C320.1, C328.1, U29.10 (VOUT), U29.11 (VOUT)
unnamed: C297.2, C305.2, C313.2, C321.2, C329.1, U30.1 (VIN), U30.2 (VIN)
unnamed: C298.1, C306.1, C314.1, C322.1, C330.1, C409.2, R235.2, U30.10 (VOUT), U30.11 (VOUT)
unnamed: C299.2, C307.2, C315.2, C323.2, C331.1, U31.1 (VIN), U31.2 (VIN)
unnamed: C300.1, C308.1, C316.1, C324.1, C332.1, U31.10 (VOUT), U31.11 (VOUT)
unnamed: C333.1, U28.8 (SS)
unnamed: C334.1, U29.8 (SS)
unnamed: C335.1, U30.8 (SS)
unnamed: C336.1, U31.8 (SS)
unnamed: C337.2, C345.2, C353.2, C361.2, C369.1, U32.1 (VIN), U32.2 (VIN)
unnamed: C338.1, C346.1, C354.1, C362.1, C370.1, U32.10 (VOUT), U32.11 (VOUT)
unnamed: C339.2, C347.2, C355.2, C363.2, C371.1, U33.1 (VIN), U33.2 (VIN)
unnamed: C340.1, C348.1, C356.1, C364.1, C372.1, U33.10 (VOUT), U33.11 (VOUT)
unnamed: C341.2, C349.2, C357.2, C365.2, C373.1, U34.1 (VIN), U34.2 (VIN)
unnamed: C342.1, C350.1, C358.1, C366.1, C374.1, U34.10 (VOUT), U34.11 (VOUT)
unnamed: C343.2, C351.2, C359.2, C367.2, C375.1, U35.1 (VIN), U35.2 (VIN)
unnamed: C344.1, C352.1, C360.1, C368.1, C376.1, U35.10 (VOUT), U35.11 (VOUT)
unnamed: C377.1, U32.8 (SS)
unnamed: C378.1, U33.8 (SS)
unnamed: C379.1, U34.8 (SS)
unnamed: C380.1, U35.8 (SS)
unnamed: C381.2, U36.8 (VCC)
unnamed: C382.2, U37.8 (VCC)
unnamed: C383.2, C387.2, C391.2, C395.2, C401.1, U38.1 (VIN), U38.2 (VIN)
unnamed: C384.1, C385.1, C388.1, C389.1, C392.1, C393.1, C396.1, C397.1, C402.1, C403.1, C415.2, R252.2, U38.10 (VOUT), U38.11 (VOUT), U39.10 (VOUT), U39.11 (VOUT)
unnamed: C386.2, C390.2, C394.2, C398.2, C404.1, U39.1 (VIN), U39.2 (VIN)
unnamed: C399.1, U40.5 (VCC)
unnamed: C400.1, U41.5 (VCC)
unnamed: C405.1, R251.2, U41.2 (A)
unnamed: C406.1, U38.8 (SS)
unnamed: C407.1, R233.1, R237.1, U28.7 (FB)
unnamed: C408.1, R234.1, R238.1, U29.7 (FB)
unnamed: C409.1, R235.1, R239.1, U30.7 (FB)
unnamed: C410.1, R236.1, R240.1, U31.7 (FB)
unnamed: C411.1, R241.1, R245.1, U32.7 (FB)
unnamed: C412.1, R242.1, R246.1, U33.7 (FB)
unnamed: C413.1, R243.1, R247.1, U34.7 (FB)
unnamed: C414.1, R244.1, R248.1, U35.7 (FB)
unnamed: C415.1, R252.1, R253.1, U38.7 (FB)
unnamed: U28.3 (SYNC), U28.5 (AGND), U28.6 (AGND)
unnamed: U29.3 (SYNC), U29.5 (AGND), U29.6 (AGND)
unnamed: U30.3 (SYNC), U30.5 (AGND), U30.6 (AGND)
unnamed: U31.3 (SYNC), U31.5 (AGND), U31.6 (AGND)
unnamed: U32.3 (SYNC), U32.5 (AGND), U32.6 (AGND)
unnamed: U33.3 (SYNC), U33.5 (AGND), U33.6 (AGND)
unnamed: U34.3 (SYNC), U34.5 (AGND), U34.6 (AGND)
unnamed: U35.3 (SYNC), U35.5 (AGND), U35.6 (AGND)
unnamed: U36.4 (GND), U36.9 (GND)
unnamed: U36.5 (A2), U36.6 (A1), U36.7 (A0)
unnamed: U37.4 (GND), U37.9 (GND)
unnamed: U37.5 (A2), U37.6 (A1)
unnamed: U38.5 (AGND), U38.6 (AGND)
unnamed: U38.9 (SH), U39.9 (SH)
unnamed: U39.5 (AGND), U39.6 (AGND)
TEMP_I2C_SCL: TP20.1, U36.2 (SCL), U37.2 (SCL)
TEMP_I2C_SDA: TP19.1, U36.1 (SDA), U37.1 (SDA)
\~CLK_1V0_FPGA: U39.3 (SYNC), U40.4 (Y)

Notes on the sheet:
Checked:
Title:
DNP
${CURRENT_DATE}
TEMP0_Address:
mail@pcb-arts.com
${ENTWICKLER}
3.3V @10A
Oscillator frequency: 388kHz
https://pcb-arts.com/
Time:
TEMP1_Address:
1.5V @10A
The information contained in these documents is confidential, privileged and only for the information of the intended recipient and may not be used, published or redistributed without the prior written consent from PCB Arts GmbH.
${CURRENTTIME}
HARNESS: TEMP_I2C
Revision:
1.0V @10A
HARNESS: PSU_CTRL
++CONFIDENTIAL++
1.0V @20A
1.8V @ 10A
1001 000
Master
1001 001
${#}
Sheet:
${REVISION1}
1.2V @10A
2.5V @ 10A
${##}
Slave
Date:
${FILENAME}
Elektronik- und Softwareentwicklung aus Nürnberg
Engineer
5.0V @10A
${CHECKED}
