pcbarts/fast-open-switch-hardware/fast-open-switch r1.0 - KiCad/DDR3 Memory_Banks 32-33-34.kicad_sch

## KiCad design fast-open-switch r1.0 - KiCad/DDR3 Memory_Banks 32-33-34.kicad_sch (2023-05-11)

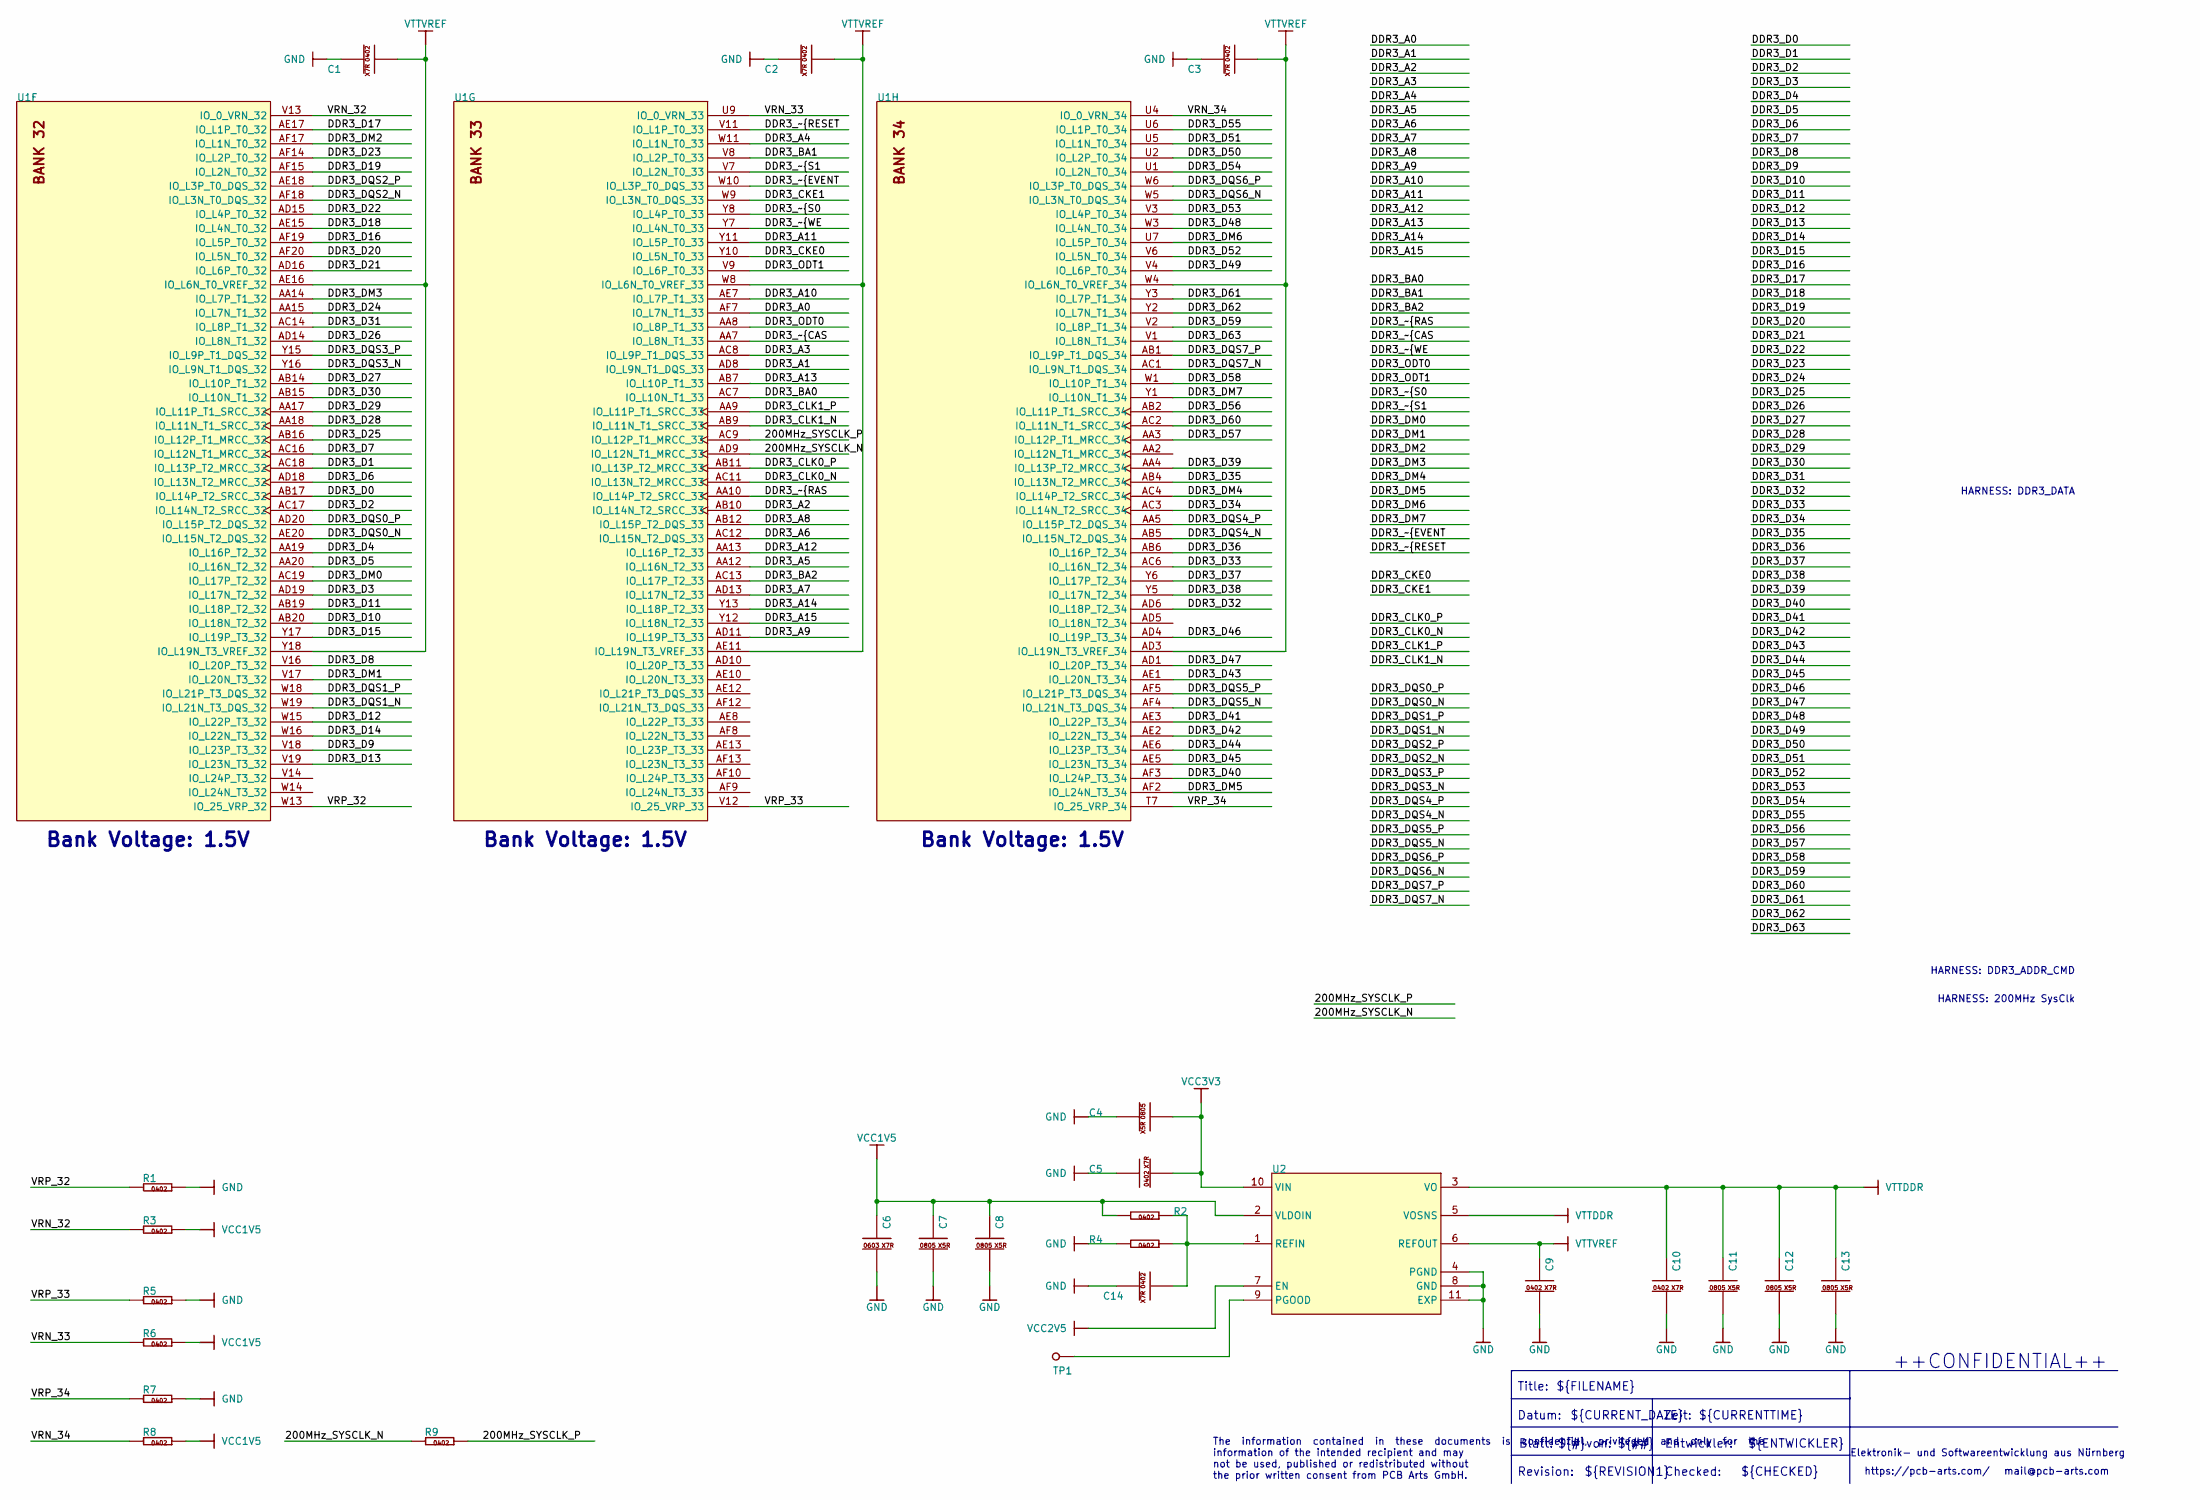
[picture p70: schematic DDR3 Memory_Banks 32-33-34.kicad_sch]

Parts:
C1, C2, C3, C5, C9, C10, C14: CAP_0402_L
C4, C7, C8, C11, C12, C13: CAP_0805
C6: CAP_0603_L
R1, R2, R3, R4, R5, R6, R7, R8, R9: RES_0402_L
TP1: Testpoint 0.8mm
U1: BGA100P2700X2700X317-676N
U2: QFN50P300X300X100-11N

Connections:
200MHz_SYSCLK_N: R9.1, U1.AD9 (IO_L12N_T1_MRCC_33)
200MHz_SYSCLK_P: R9.2, U1.AC9 (IO_L12P_T1_MRCC_33)
DDR3_A0: U1.AF7 (IO_L7N_T1_33)
DDR3_A1: U1.AD8 (IO_L9N_T1_DQS_33)
DDR3_A2: U1.AB10 (IO_L14N_T2_SRCC_33)
DDR3_A3: U1.AC8 (IO_L9P_T1_DQS_33)
DDR3_A4: U1.W11 (IO_L1N_T0_33)
DDR3_A5: U1.AA12 (IO_L16N_T2_33)
DDR3_A6: U1.AC12 (IO_L15N_T2_DQS_33)
DDR3_A7: U1.AD13 (IO_L17N_T2_33)
DDR3_A8: U1.AB12 (IO_L15P_T2_DQS_33)
DDR3_A9: U1.AD11 (IO_L19P_T3_33)
DDR3_A10: U1.AE7 (IO_L7P_T1_33)
DDR3_A11: U1.Y11 (IO_L5P_T0_33)
DDR3_A12: U1.AA13 (IO_L16P_T2_33)
DDR3_A13: U1.AB7 (IO_L10P_T1_33)
DDR3_A14: U1.Y13 (IO_L18P_T2_33)
DDR3_A15: U1.Y12 (IO_L18N_T2_33)
DDR3_BA0: U1.AC7 (IO_L10N_T1_33)
DDR3_BA1: U1.V8 (IO_L2P_T0_33)
DDR3_BA2: U1.AC13 (IO_L17P_T2_33)
DDR3_CKE0: U1.Y10 (IO_L5N_T0_33)
DDR3_CKE1: U1.W9 (IO_L3N_T0_DQS_33)
DDR3_CLK0_N: U1.AC11 (IO_L13N_T2_MRCC_33)
DDR3_CLK0_P: U1.AB11 (IO_L13P_T2_MRCC_33)
DDR3_CLK1_N: U1.AB9 (IO_L11N_T1_SRCC_33)
DDR3_CLK1_P: U1.AA9 (IO_L11P_T1_SRCC_33)
DDR3_D0: U1.AB17 (IO_L14P_T2_SRCC_32)
DDR3_D1: U1.AC18 (IO_L13P_T2_MRCC_32)
DDR3_D2: U1.AC17 (IO_L14N_T2_SRCC_32)
DDR3_D3: U1.AD19 (IO_L17N_T2_32)
DDR3_D4: U1.AA19 (IO_L16P_T2_32)
DDR3_D5: U1.AA20 (IO_L16N_T2_32)
DDR3_D6: U1.AD18 (IO_L13N_T2_MRCC_32)
DDR3_D7: U1.AC16 (IO_L12N_T1_MRCC_32)
DDR3_D8: U1.V16 (IO_L20P_T3_32)
DDR3_D9: U1.V18 (IO_L23P_T3_32)
DDR3_D10: U1.AB20 (IO_L18N_T2_32)
DDR3_D11: U1.AB19 (IO_L18P_T2_32)
DDR3_D12: U1.W15 (IO_L22P_T3_32)
DDR3_D13: U1.V19 (IO_L23N_T3_32)
DDR3_D14: U1.W16 (IO_L22N_T3_32)
DDR3_D15: U1.Y17 (IO_L19P_T3_32)
DDR3_D16: U1.AF19 (IO_L5P_T0_32)
DDR3_D17: U1.AE17 (IO_L1P_T0_32)
DDR3_D18: U1.AE15 (IO_L4N_T0_32)
DDR3_D19: U1.AF15 (IO_L2N_T0_32)
DDR3_D20: U1.AF20 (IO_L5N_T0_32)
DDR3_D21: U1.AD16 (IO_L6P_T0_32)
DDR3_D22: U1.AD15 (IO_L4P_T0_32)
DDR3_D23: U1.AF14 (IO_L2P_T0_32)
DDR3_D24: U1.AA15 (IO_L7N_T1_32)
DDR3_D25: U1.AB16 (IO_L12P_T1_MRCC_32)
DDR3_D26: U1.AD14 (IO_L8N_T1_32)
DDR3_D27: U1.AB14 (IO_L10P_T1_32)
DDR3_D28: U1.AA18 (IO_L11N_T1_SRCC_32)
DDR3_D29: U1.AA17 (IO_L11P_T1_SRCC_32)
DDR3_D30: U1.AB15 (IO_L10N_T1_32)
DDR3_D31: U1.AC14 (IO_L8P_T1_32)
DDR3_D32: U1.AD6 (IO_L18P_T2_34)
DDR3_D33: U1.AC6 (IO_L16N_T2_34)
DDR3_D34: U1.AC3 (IO_L14N_T2_SRCC_34)
DDR3_D35: U1.AB4 (IO_L13N_T2_MRCC_34)
DDR3_D36: U1.AB6 (IO_L16P_T2_34)
DDR3_D37: U1.Y6 (IO_L17P_T2_34)
DDR3_D38: U1.Y5 (IO_L17N_T2_34)
DDR3_D39: U1.AA4 (IO_L13P_T2_MRCC_34)
DDR3_D40: U1.AF3 (IO_L24P_T3_34)
DDR3_D41: U1.AE3 (IO_L22P_T3_34)
DDR3_D42: U1.AE2 (IO_L22N_T3_34)
DDR3_D43: U1.AE1 (IO_L20N_T3_34)
DDR3_D44: U1.AE6 (IO_L23P_T3_34)
DDR3_D45: U1.AE5 (IO_L23N_T3_34)
DDR3_D46: U1.AD4 (IO_L19P_T3_34)
DDR3_D47: U1.AD1 (IO_L20P_T3_34)
DDR3_D48: U1.W3 (IO_L4N_T0_34)
DDR3_D49: U1.V4 (IO_L6P_T0_34)
DDR3_D50: U1.U2 (IO_L2P_T0_34)
DDR3_D51: U1.U5 (IO_L1N_T0_34)
DDR3_D52: U1.V6 (IO_L5N_T0_34)
DDR3_D53: U1.V3 (IO_L4P_T0_34)
DDR3_D54: U1.U1 (IO_L2N_T0_34)
DDR3_D55: U1.U6 (IO_L1P_T0_34)
DDR3_D56: U1.AB2 (IO_L11P_T1_SRCC_34)
DDR3_D57: U1.AA3 (IO_L12P_T1_MRCC_34)
DDR3_D58: U1.W1 (IO_L10P_T1_34)
DDR3_D59: U1.V2 (IO_L8P_T1_34)
DDR3_D60: U1.AC2 (IO_L11N_T1_SRCC_34)
DDR3_D61: U1.Y3 (IO_L7P_T1_34)
DDR3_D62: U1.Y2 (IO_L7N_T1_34)
DDR3_D63: U1.V1 (IO_L8N_T1_34)
DDR3_DM0: U1.AC19 (IO_L17P_T2_32)
DDR3_DM1: U1.V17 (IO_L20N_T3_32)
DDR3_DM2: U1.AF17 (IO_L1N_T0_32)
DDR3_DM3: U1.AA14 (IO_L7P_T1_32)
DDR3_DM4: U1.AC4 (IO_L14P_T2_SRCC_34)
DDR3_DM5: U1.AF2 (IO_L24N_T3_34)
DDR3_DM6: U1.U7 (IO_L5P_T0_34)
DDR3_DM7: U1.Y1 (IO_L10N_T1_34)
DDR3_DQS0_N: U1.AE20 (IO_L15N_T2_DQS_32)
DDR3_DQS0_P: U1.AD20 (IO_L15P_T2_DQS_32)
DDR3_DQS1_N: U1.W19 (IO_L21N_T3_DQS_32)
DDR3_DQS1_P: U1.W18 (IO_L21P_T3_DQS_32)
DDR3_DQS2_N: U1.AF18 (IO_L3N_T0_DQS_32)
DDR3_DQS2_P: U1.AE18 (IO_L3P_T0_DQS_32)
DDR3_DQS3_N: U1.Y16 (IO_L9N_T1_DQS_32)
DDR3_DQS3_P: U1.Y15 (IO_L9P_T1_DQS_32)
DDR3_DQS4_N: U1.AB5 (IO_L15N_T2_DQS_34)
DDR3_DQS4_P: U1.AA5 (IO_L15P_T2_DQS_34)
DDR3_DQS5_N: U1.AF4 (IO_L21N_T3_DQS_34)
DDR3_DQS5_P: U1.AF5 (IO_L21P_T3_DQS_34)
DDR3_DQS6_N: U1.W5 (IO_L3N_T0_DQS_34)
DDR3_DQS6_P: U1.W6 (IO_L3P_T0_DQS_34)
DDR3_DQS7_N: U1.AC1 (IO_L9N_T1_DQS_34)
DDR3_DQS7_P: U1.AB1 (IO_L9P_T1_DQS_34)
DDR3_ODT0: U1.AA8 (IO_L8P_T1_33)
DDR3_ODT1: U1.V9 (IO_L6P_T0_33)
DDR3_~{CAS: U1.AA7 (IO_L8N_T1_33)
DDR3_~{EVENT: U1.W10 (IO_L3P_T0_DQS_33)
DDR3_~{RAS: U1.AA10 (IO_L14P_T2_SRCC_33)
DDR3_~{RESET: U1.V11 (IO_L1P_T0_33)
DDR3_~{S0: U1.Y8 (IO_L4P_T0_33)
DDR3_~{S1: U1.V7 (IO_L2N_T0_33)
DDR3_~{WE: U1.Y7 (IO_L4N_T0_33)
unnamed: C1.1, U1.AE16 (IO_L6N_T0_VREF_32), U1.Y18 (IO_L19N_T3_VREF_32)
unnamed: C2.1, U1.AE11 (IO_L19N_T3_VREF_33), U1.W8 (IO_L6N_T0_VREF_33)
unnamed: C3.1, U1.AD3 (IO_L19N_T3_VREF_34), U1.W4 (IO_L6N_T0_VREF_34)
unnamed: C4.1, C5.2, U2.10 (VIN)
unnamed: C6.1, C7.1, C8.1, R2.1, U2.2 (VLDOIN)
unnamed: C9.1, U2.6 (REFOUT)
unnamed: C10.1, C11.1, C12.1, C13.1, U2.3 (VO)
unnamed: C14.1, R2.2, R4.2, U2.1 (REFIN)
unnamed: TP1.1, U2.9 (PGOOD)
unnamed: U2.4 (PGND), U2.8 (GND), U2.11 (EXP)
VRN_32: R3.1, U1.V13 (IO_0_VRN_32)
VRN_33: R6.1, U1.U9 (IO_0_VRN_33)
VRN_34: R8.1, U1.U4 (IO_0_VRN_34)
VRP_32: R1.1, U1.W13 (IO_25_VRP_32)
VRP_33: R5.1, U1.V12 (IO_25_VRP_33)
VRP_34: R7.1, U1.T7 (IO_25_VRP_34)

Notes on the sheet:
${##}
Elektronik- und Softwareentwicklung aus Nürnberg
https://pcb-arts.com/
${#}
mail@pcb-arts.com
The information contained in these documents is confidential, privileged and only for the information of the intended recipient and may not be used, published or redistributed without the prior written consent from PCB Arts GmbH.
${ENTWICKLER}
${REVISION1}
++CONFIDENTIAL++
Revision:
HARNESS: DDR3_DATA
von:
${CURRENT_DATE}
HARNESS: 200MHz SysClk
Entwickler:
${CHECKED}
Bank Voltage: 1.5V
Blatt:
Datum:
Title:
${CURRENTTIME}
Zeit:
Checked:
HARNESS: DDR3_ADDR_CMD
${FILENAME}
