pcbarts/fast-open-switch-hardware/fast-open-switch r1.0 - KiCad/FPGA_HDMI_IN_OUT.kicad_sch

## KiCad design fast-open-switch r1.0 - KiCad/FPGA_HDMI_IN_OUT.kicad_sch (2023-05-11)

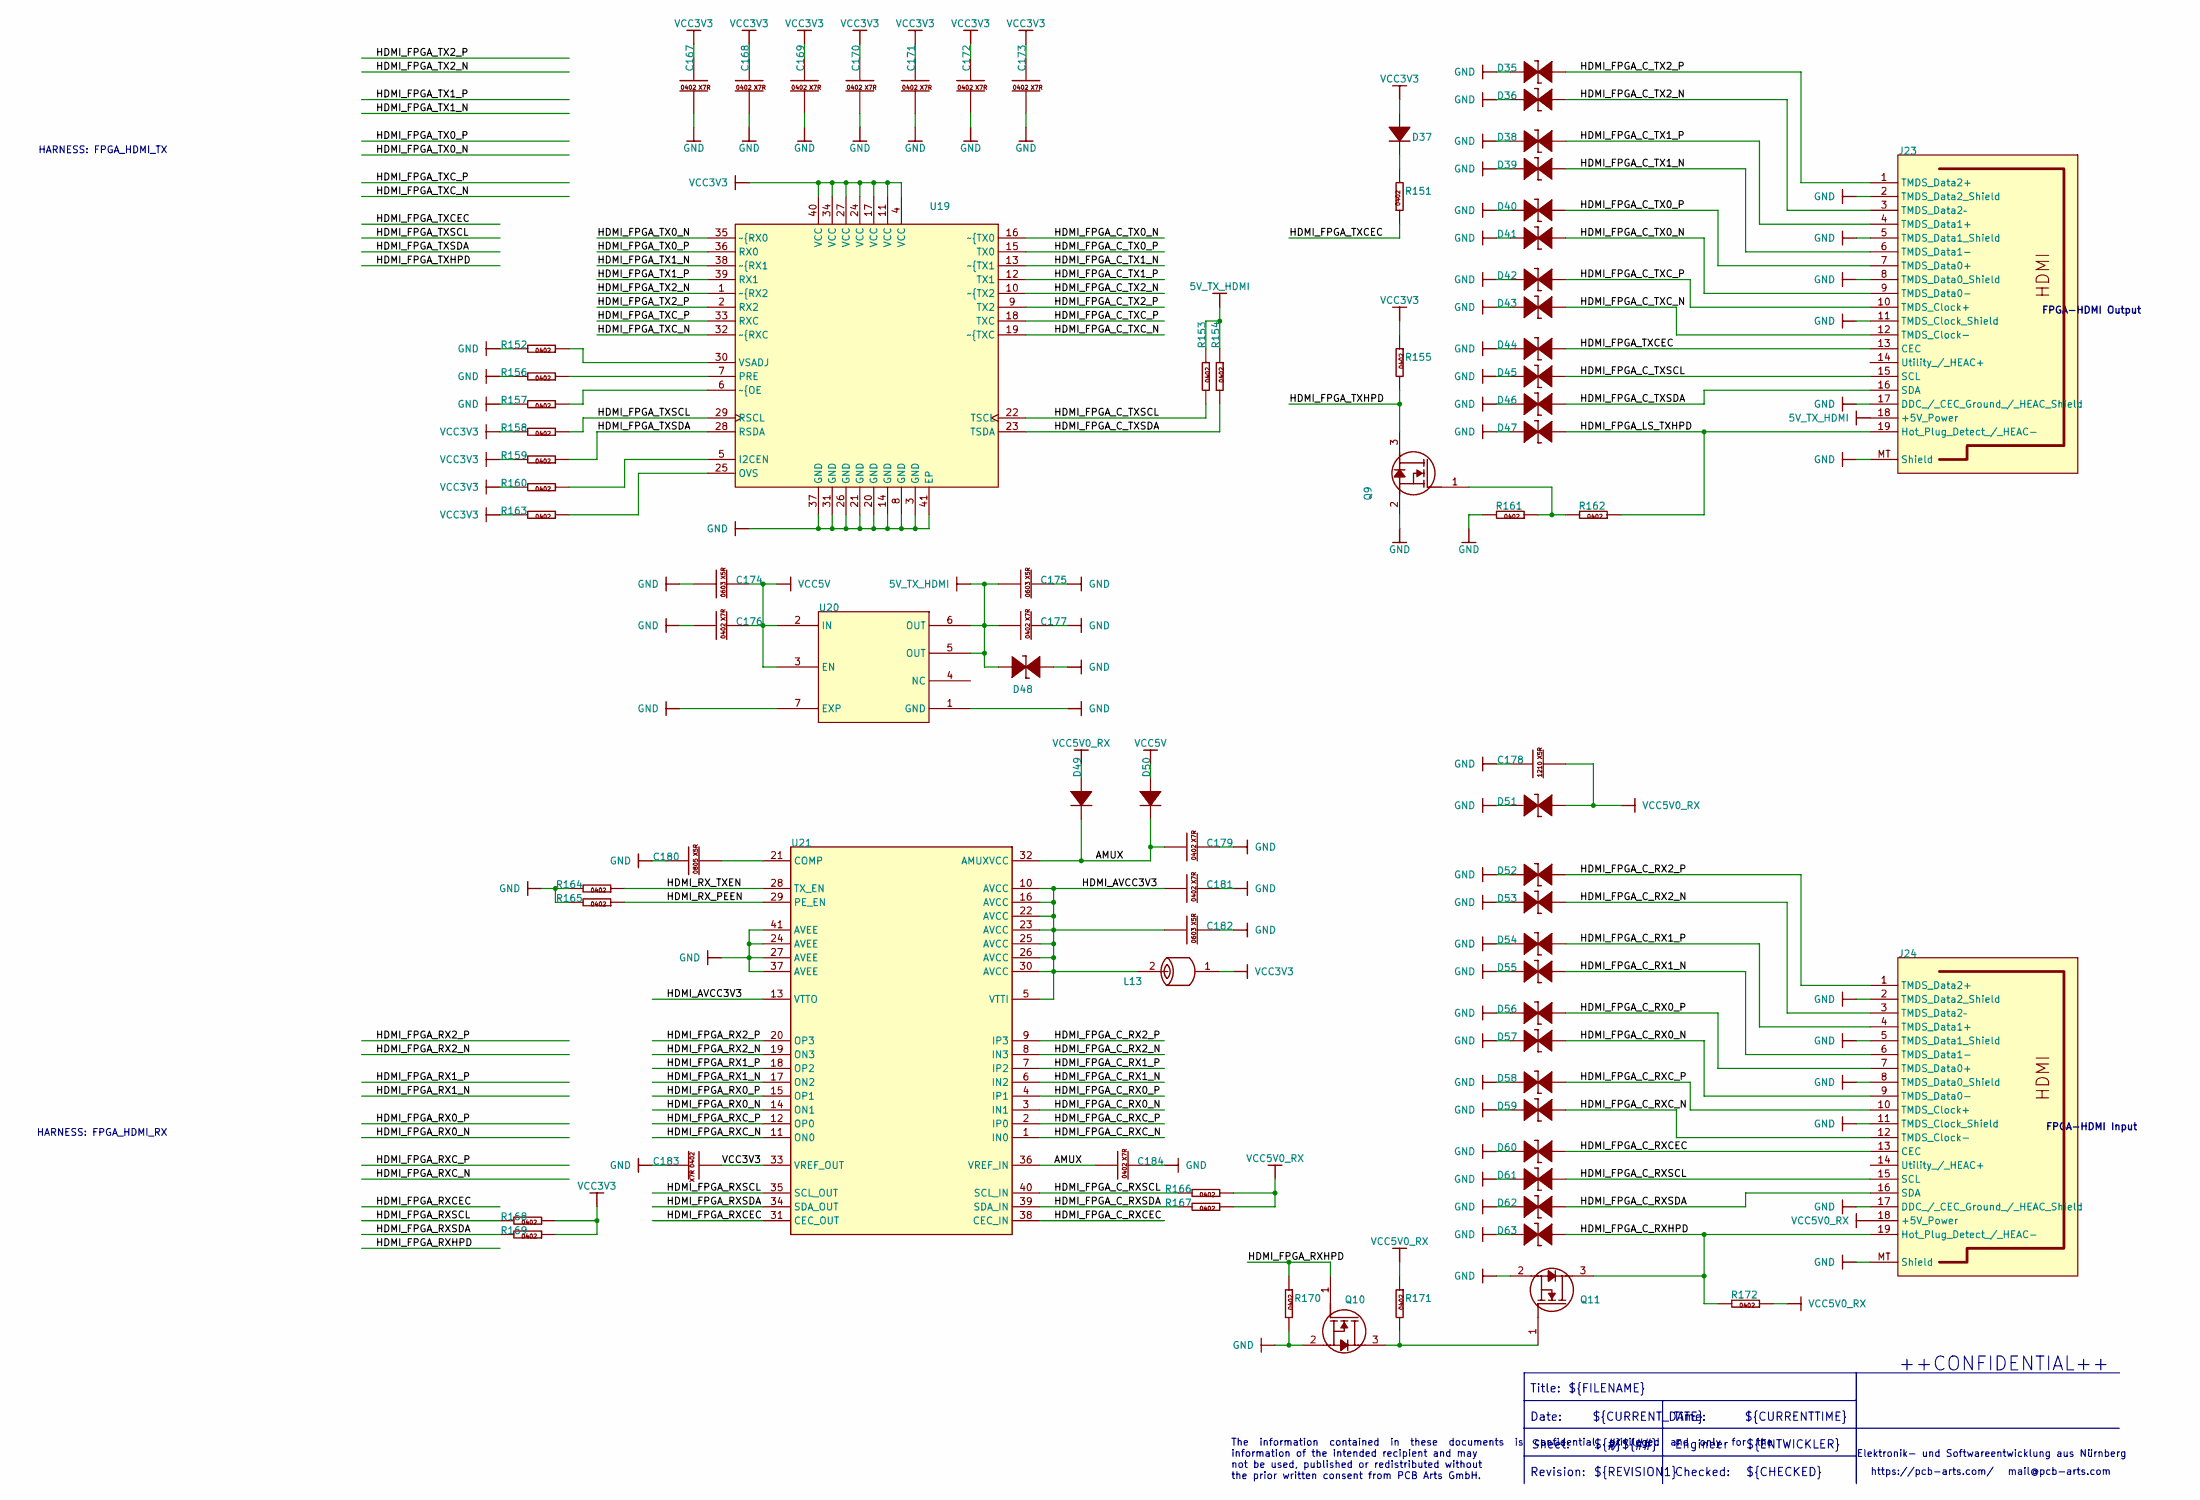
[picture p73: schematic FPGA_HDMI_IN_OUT.kicad_sch]

Parts:
C167, C168, C169, C170, C171, C172, C173, C176, C177, C179, C181, C183, C184: CAP_0402_L
C174, C175, C182: CAP_0603_L
C178: CAP_1210
C180: CAP_0805
D35, D36, D38, D39, D40, D41, D42, D43, D44, D45, D46, D47, D48, D51, D52, D53, D54, D55, D56, D57, D58, D59, D60, D61, D62, D63: TVS_0402
D37, D49, D50: SOD123
J23, J24: Elecbee EB-500-6007
L13: L_0603
Q9, Q10, Q11: SOT95P251X112-3N
R151, R152, R153, R154, R155, R156, R157, R158, R159, R160, R161, R162, R163, R164, R165, R166, R167, R168, R169, R170, R171, R172: RES_0402_L
U19, U21: QFN50P600X600X100-41N
U20: QFN50P201X181X60_HS-7N

Connections:
AMUX: C179.1, C184.1, D49.1, D50.1, U21.32 (AMUXVCC), U21.36 (VREF_IN)
HDMI_AVCC3V3: C181.1, C182.1, L13.2, U21.5 (VTTI), U21.10 (AVCC), U21.13 (VTTO), U21.16 (AVCC), U21.22 (AVCC), U21.23 (AVCC), U21.25 (AVCC), U21.26 (AVCC), U21.30 (AVCC)
HDMI_FPGA_C_RX0_N: D57.2, J24.9 (TMDS_Data0-), U21.3 (IN1)
HDMI_FPGA_C_RX0_P: D56.2, J24.7 (TMDS_Data0+), U21.4 (IP1)
HDMI_FPGA_C_RX1_N: D55.2, J24.6 (TMDS_Data1-), U21.6 (IN2)
HDMI_FPGA_C_RX1_P: D54.2, J24.4 (TMDS_Data1+), U21.7 (IP2)
HDMI_FPGA_C_RX2_N: D53.2, J24.3 (TMDS_Data2–), U21.8 (IN3)
HDMI_FPGA_C_RX2_P: D52.2, J24.1 (TMDS_Data2+), U21.9 (IP3)
HDMI_FPGA_C_RXCEC: D60.2, J24.13 (CEC), U21.38 (CEC_IN)
HDMI_FPGA_C_RXC_N: D59.2, J24.12 (TMDS_Clock-), U21.1 (IN0)
HDMI_FPGA_C_RXC_P: D58.2, J24.10 (TMDS_Clock+), U21.2 (IP0)
HDMI_FPGA_C_RXHPD: D63.2, J24.19 (Hot_Plug_Detect_/_HEAC-), Q11.3 (D), R172.1
HDMI_FPGA_C_RXSCL: D61.2, J24.15 (SCL), R166.1, U21.40 (SCL_IN)
HDMI_FPGA_C_RXSDA: D62.2, J24.16 (SDA), R167.1, U21.39 (SDA_IN)
HDMI_FPGA_C_TX0_N: D41.2, J23.9 (TMDS_Data0-), U19.16 (~{TX0)
HDMI_FPGA_C_TX0_P: D40.2, J23.7 (TMDS_Data0+), U19.15 (TX0)
HDMI_FPGA_C_TX1_N: D39.2, J23.6 (TMDS_Data1-), U19.13 (~{TX1)
HDMI_FPGA_C_TX1_P: D38.2, J23.4 (TMDS_Data1+), U19.12 (TX1)
HDMI_FPGA_C_TX2_N: D36.2, J23.3 (TMDS_Data2–), U19.10 (~{TX2)
HDMI_FPGA_C_TX2_P: D35.2, J23.1 (TMDS_Data2+), U19.9 (TX2)
HDMI_FPGA_C_TXC_N: D43.2, J23.12 (TMDS_Clock-), U19.19 (~{TXC)
HDMI_FPGA_C_TXC_P: D42.2, J23.10 (TMDS_Clock+), U19.18 (TXC)
HDMI_FPGA_C_TXSCL: D45.2, J23.15 (SCL), R153.1, U19.22 (TSCL)
HDMI_FPGA_C_TXSDA: D46.2, J23.16 (SDA), R154.1, U19.23 (TSDA)
HDMI_FPGA_LS_TXHPD: D47.2, J23.19 (Hot_Plug_Detect_/_HEAC-), R162.2
HDMI_FPGA_RX0_N: U21.14 (ON1)
HDMI_FPGA_RX0_P: U21.15 (OP1)
HDMI_FPGA_RX1_N: U21.17 (ON2)
HDMI_FPGA_RX1_P: U21.18 (OP2)
HDMI_FPGA_RX2_N: U21.19 (ON3)
HDMI_FPGA_RX2_P: U21.20 (OP3)
HDMI_FPGA_RXCEC: U21.31 (CEC_OUT)
HDMI_FPGA_RXC_N: U21.11 (ON0)
HDMI_FPGA_RXC_P: U21.12 (OP0)
HDMI_FPGA_RXHPD: Q10.1 (G), R170.2
HDMI_FPGA_RXSCL: R168.1, U21.35 (SCL_OUT)
HDMI_FPGA_RXSDA: R169.1, U21.34 (SDA_OUT)
HDMI_FPGA_TX0_N: U19.35 (~{RX0)
HDMI_FPGA_TX0_P: U19.36 (RX0)
HDMI_FPGA_TX1_N: U19.38 (~{RX1)
HDMI_FPGA_TX1_P: U19.39 (RX1)
HDMI_FPGA_TX2_N: U19.1 (~{RX2)
HDMI_FPGA_TX2_P: U19.2 (RX2)
HDMI_FPGA_TXCEC: D44.2, J23.13 (CEC), R151.2
HDMI_FPGA_TXC_N: U19.32 (~{RXC)
HDMI_FPGA_TXC_P: U19.33 (RXC)
HDMI_FPGA_TXHPD: Q9.3 (D), R155.1
HDMI_FPGA_TXSCL: R158.2, U19.29 (RSCL)
HDMI_FPGA_TXSDA: R159.2, U19.28 (RSDA)
HDMI_RX_PEEN: R165.2, U21.29 (PE_EN)
HDMI_RX_TXEN: R164.2, U21.28 (TX_EN)
unnamed: C174.2, C176.2, U20.2 (IN), U20.3 (EN)
unnamed: C175.1, C177.1, D48.1, U20.5 (OUT), U20.6 (OUT)
unnamed: C178.2, D51.2
unnamed: C180.2, U21.21 (COMP)
unnamed: D37.1, R151.1
unnamed: Q9.1 (G), R161.2, R162.1
unnamed: Q10.2 (S), R170.1
unnamed: Q10.3 (D), Q11.1 (G), R171.1
unnamed: R152.2, U19.30 (VSADJ)
unnamed: R153.2, R154.2
unnamed: R156.2, U19.7 (PRE)
unnamed: R157.2, U19.6 (~{OE)
unnamed: R160.2, U19.5 (I2CEN)
unnamed: R163.2, U19.25 (OVS)
unnamed: R164.1, R165.1
unnamed: R166.2, R167.2
unnamed: R168.2, R169.2
unnamed: U19.4 (VCC), U19.11 (VCC), U19.17 (VCC), U19.24 (VCC), U19.27 (VCC), U19.34 (VCC), U19.40 (VCC)
unnamed: U19.3 (GND), U19.8 (GND), U19.14 (GND), U19.20 (GND), U19.21 (GND), U19.26 (GND), U19.31 (GND), U19.37 (GND), U19.41 (EP)
unnamed: U21.24 (AVEE), U21.27 (AVEE), U21.37 (AVEE), U21.41 (AVEE)
VCC3V3: C183.1, U21.33 (VREF_OUT)

Notes on the sheet:
Checked:
Title:
${REVISION1}
The information contained in these documents is confidential, privileged and only for the information of the intended recipient and may not be used, published or redistributed without the prior written consent from PCB Arts GmbH.
HARNESS: FPGA_HDMI_TX
Engineer
Sheet:
${#}
FPGA-HDMI Input
FPGA-HDMI Output
${CHECKED}
${##}
${CURRENT_DATE}
Time:
Date:
${ENTWICKLER}
mail@pcb-arts.com
${FILENAME}
HARNESS: FPGA_HDMI_RX
Revision:
Elektronik- und Softwareentwicklung aus Nürnberg
++CONFIDENTIAL++
https://pcb-arts.com/
${CURRENTTIME}
