pcbarts/fast-open-switch-hardware/fast-open-switch r1.0 - KiCad/HMI.kicad_sch

## KiCad design fast-open-switch r1.0 - KiCad/HMI.kicad_sch (2023-05-11)

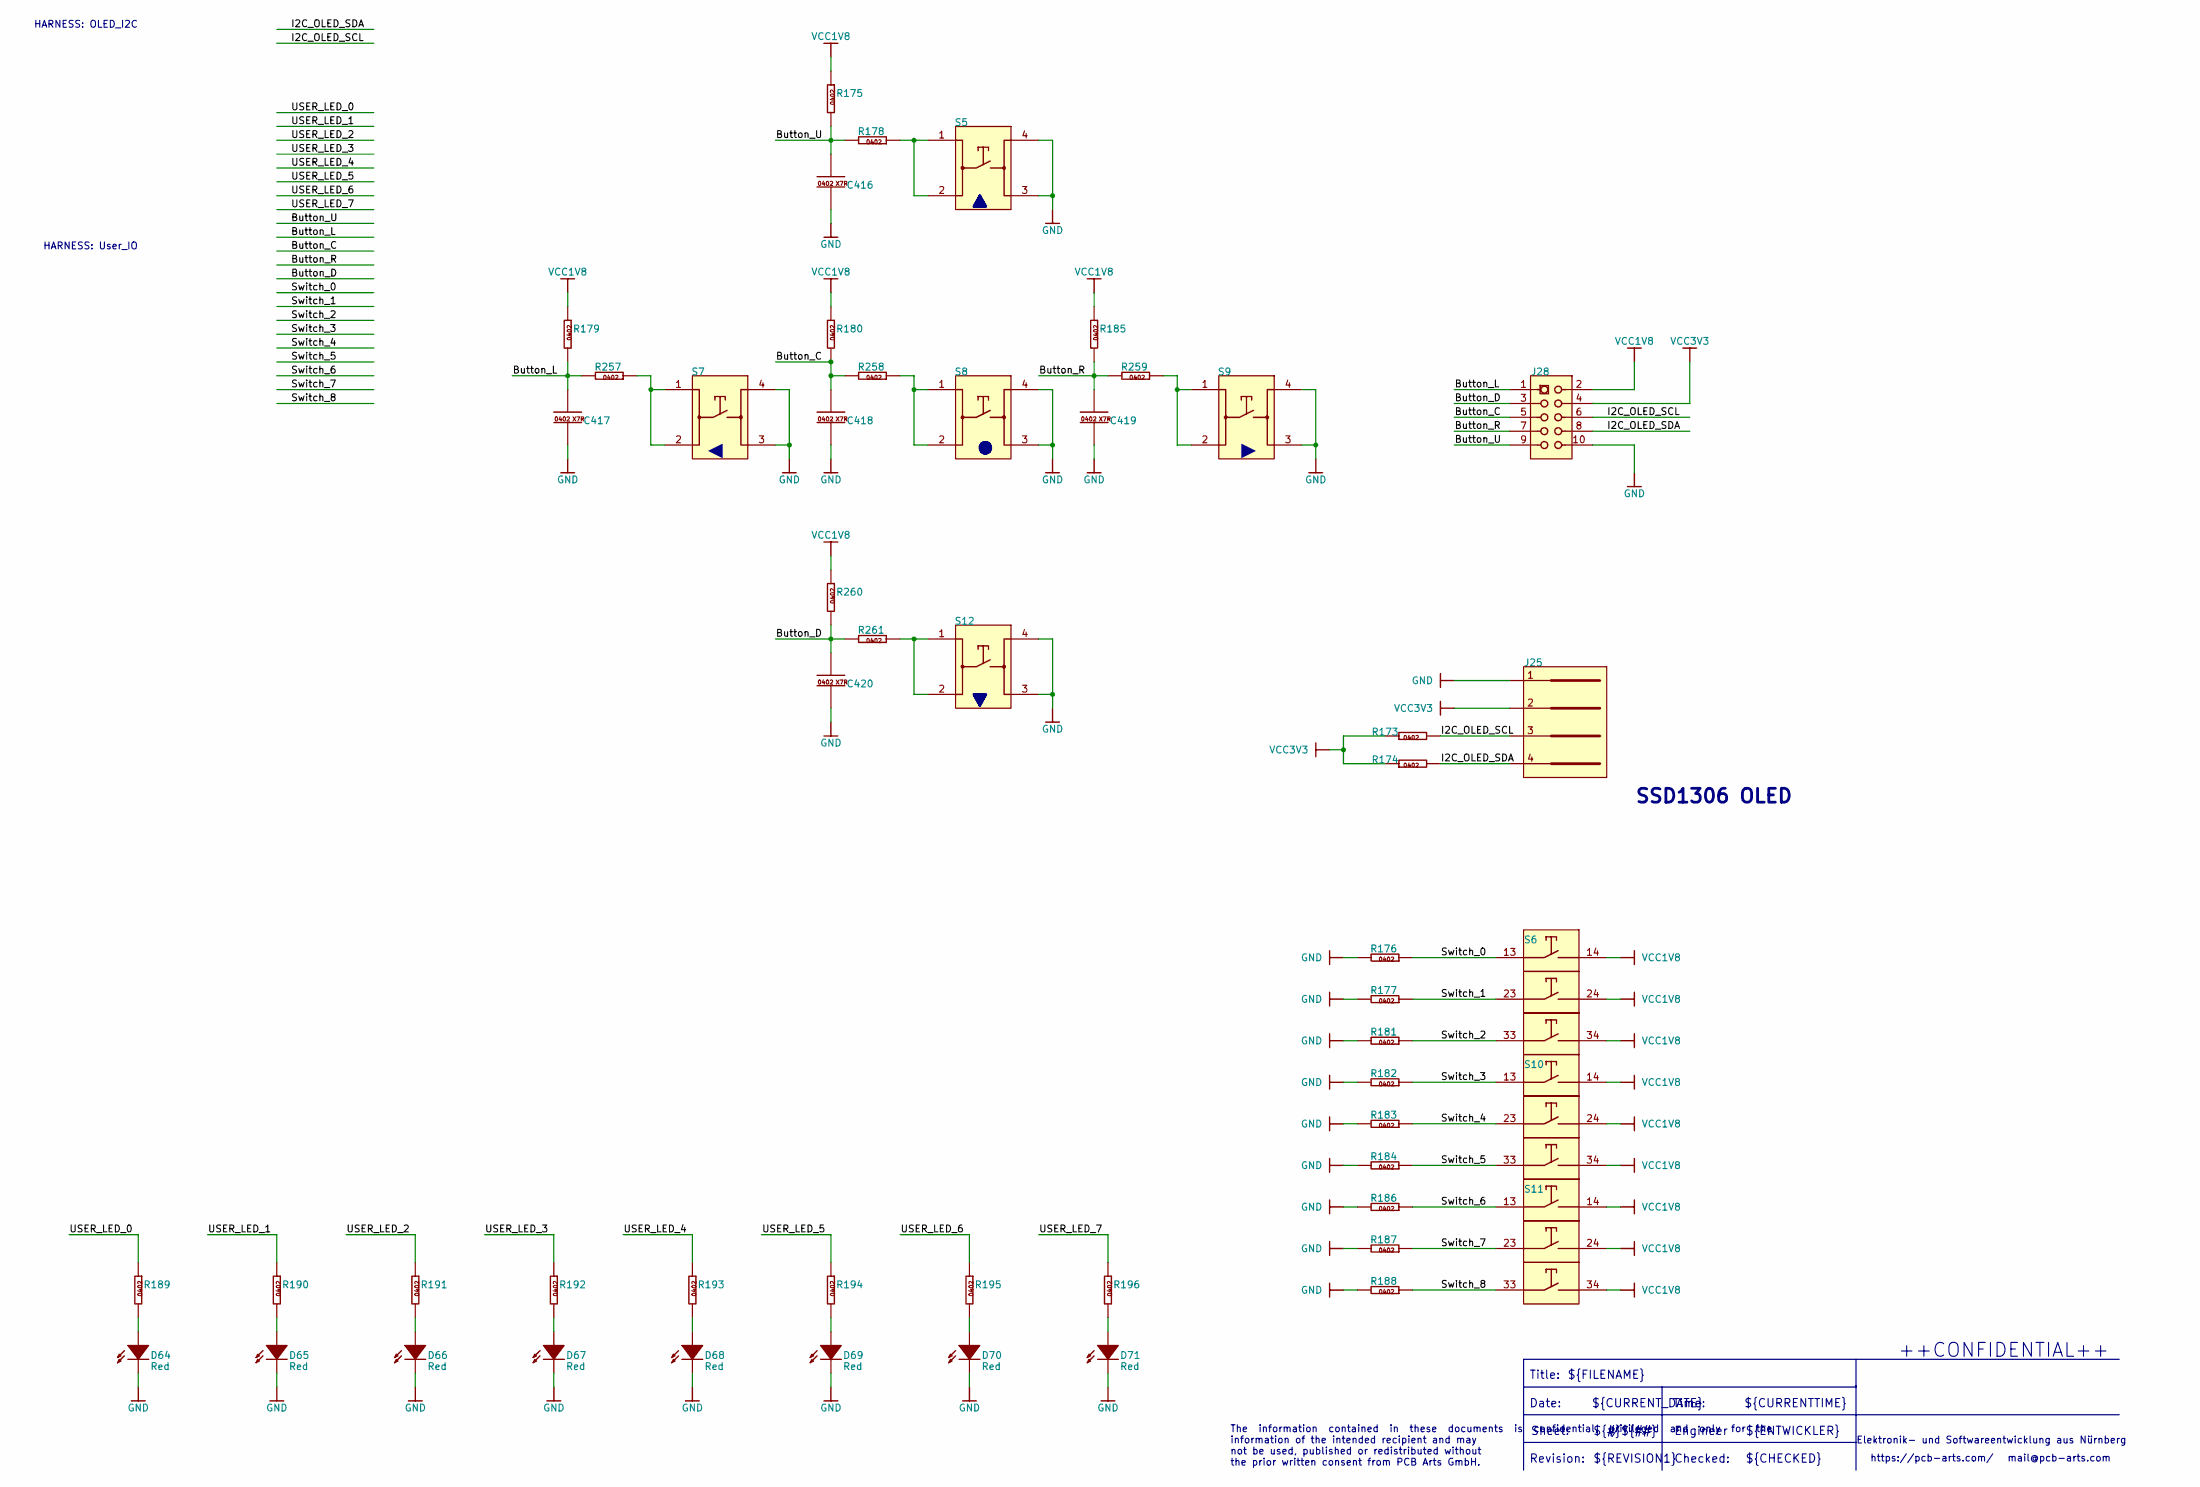
[picture p74: schematic HMI.kicad_sch]

Parts:
C416, C417, C418, C419, C420: CAP_0402_L
D64, D65, D66, D67, D68, D69, D70, D71: LED-0603 Sideview
J25: 61300411121
J28: 62701021621
R173, R174, R175, R176, R177, R178, R179, R180, R181, R182, R183, R184, R185, R186, R187, R188, R189, R190, R191, R192, R193, R194, R195, R196, R257, R258, R259, R260, R261: RES_0402_L
S5, S7, S8, S9, S12: LL3301BF065QJ
S6, S10, S11: CUI DS04-254-SMT Series, 3 Pole

Connections:
Button_C: C418.1, J28.5, R180.1, R258.1
Button_D: C420.1, J28.3, R260.1, R261.1
Button_L: C417.1, J28.1, R179.1, R257.1
Button_R: C419.1, J28.7, R185.1, R259.1
Button_U: C416.1, J28.9, R175.1, R178.1
I2C_OLED_SCL: J25.3, J28.6, R173.1
I2C_OLED_SDA: J25.4, J28.8, R174.1
unnamed: D64.2, R189.1
unnamed: D65.2, R190.1
unnamed: D66.2, R191.1
unnamed: D67.2, R192.1
unnamed: D68.2, R193.1
unnamed: D69.2, R194.1
unnamed: D70.2, R195.1
unnamed: D71.2, R196.1
unnamed: R173.2, R174.2
unnamed: R178.2, S5.1, S5.2
unnamed: R257.2, S7.1, S7.2
unnamed: R258.2, S8.1, S8.2
unnamed: R259.2, S9.1, S9.2
unnamed: R261.2, S12.1, S12.2
unnamed: S5.3, S5.4
unnamed: S7.3, S7.4
unnamed: S8.3, S8.4
unnamed: S9.3, S9.4
unnamed: S12.3, S12.4
Switch_0: R176.2, S6.13
Switch_1: R177.2, S6.23
Switch_2: R181.2, S6.33
Switch_3: R182.2, S10.13
Switch_4: R183.2, S10.23
Switch_5: R184.2, S10.33
Switch_6: R186.2, S11.13
Switch_7: R187.2, S11.23
Switch_8: R188.2, S11.33
USER_LED_0: R189.2
USER_LED_1: R190.2
USER_LED_2: R191.2
USER_LED_3: R192.2
USER_LED_4: R193.2
USER_LED_5: R194.2
USER_LED_6: R195.2
USER_LED_7: R196.2

Notes on the sheet:
mail@pcb-arts.com
HARNESS: User_IO
${CURRENT_DATE}
${#}
++CONFIDENTIAL++
${ENTWICKLER}
Revision:
Engineer
${FILENAME}
Time:
${##}
${REVISION1}
SSD1306 OLED
HARNESS: OLED_I2C
The information contained in these documents is confidential, privileged and only for the information of the intended recipient and may not be used, published or redistributed without the prior written consent from PCB Arts GmbH.
Checked:
Sheet:
${CHECKED}
${CURRENTTIME}
Title:
https://pcb-arts.com/
Date:
Elektronik- und Softwareentwicklung aus Nürnberg
