pcbarts/fast-open-switch-hardware/fast-open-switch r1.0 - KiCad/I2C Multiplexer.kicad_sch

## KiCad design fast-open-switch r1.0 - KiCad/I2C Multiplexer.kicad_sch (2023-05-11)

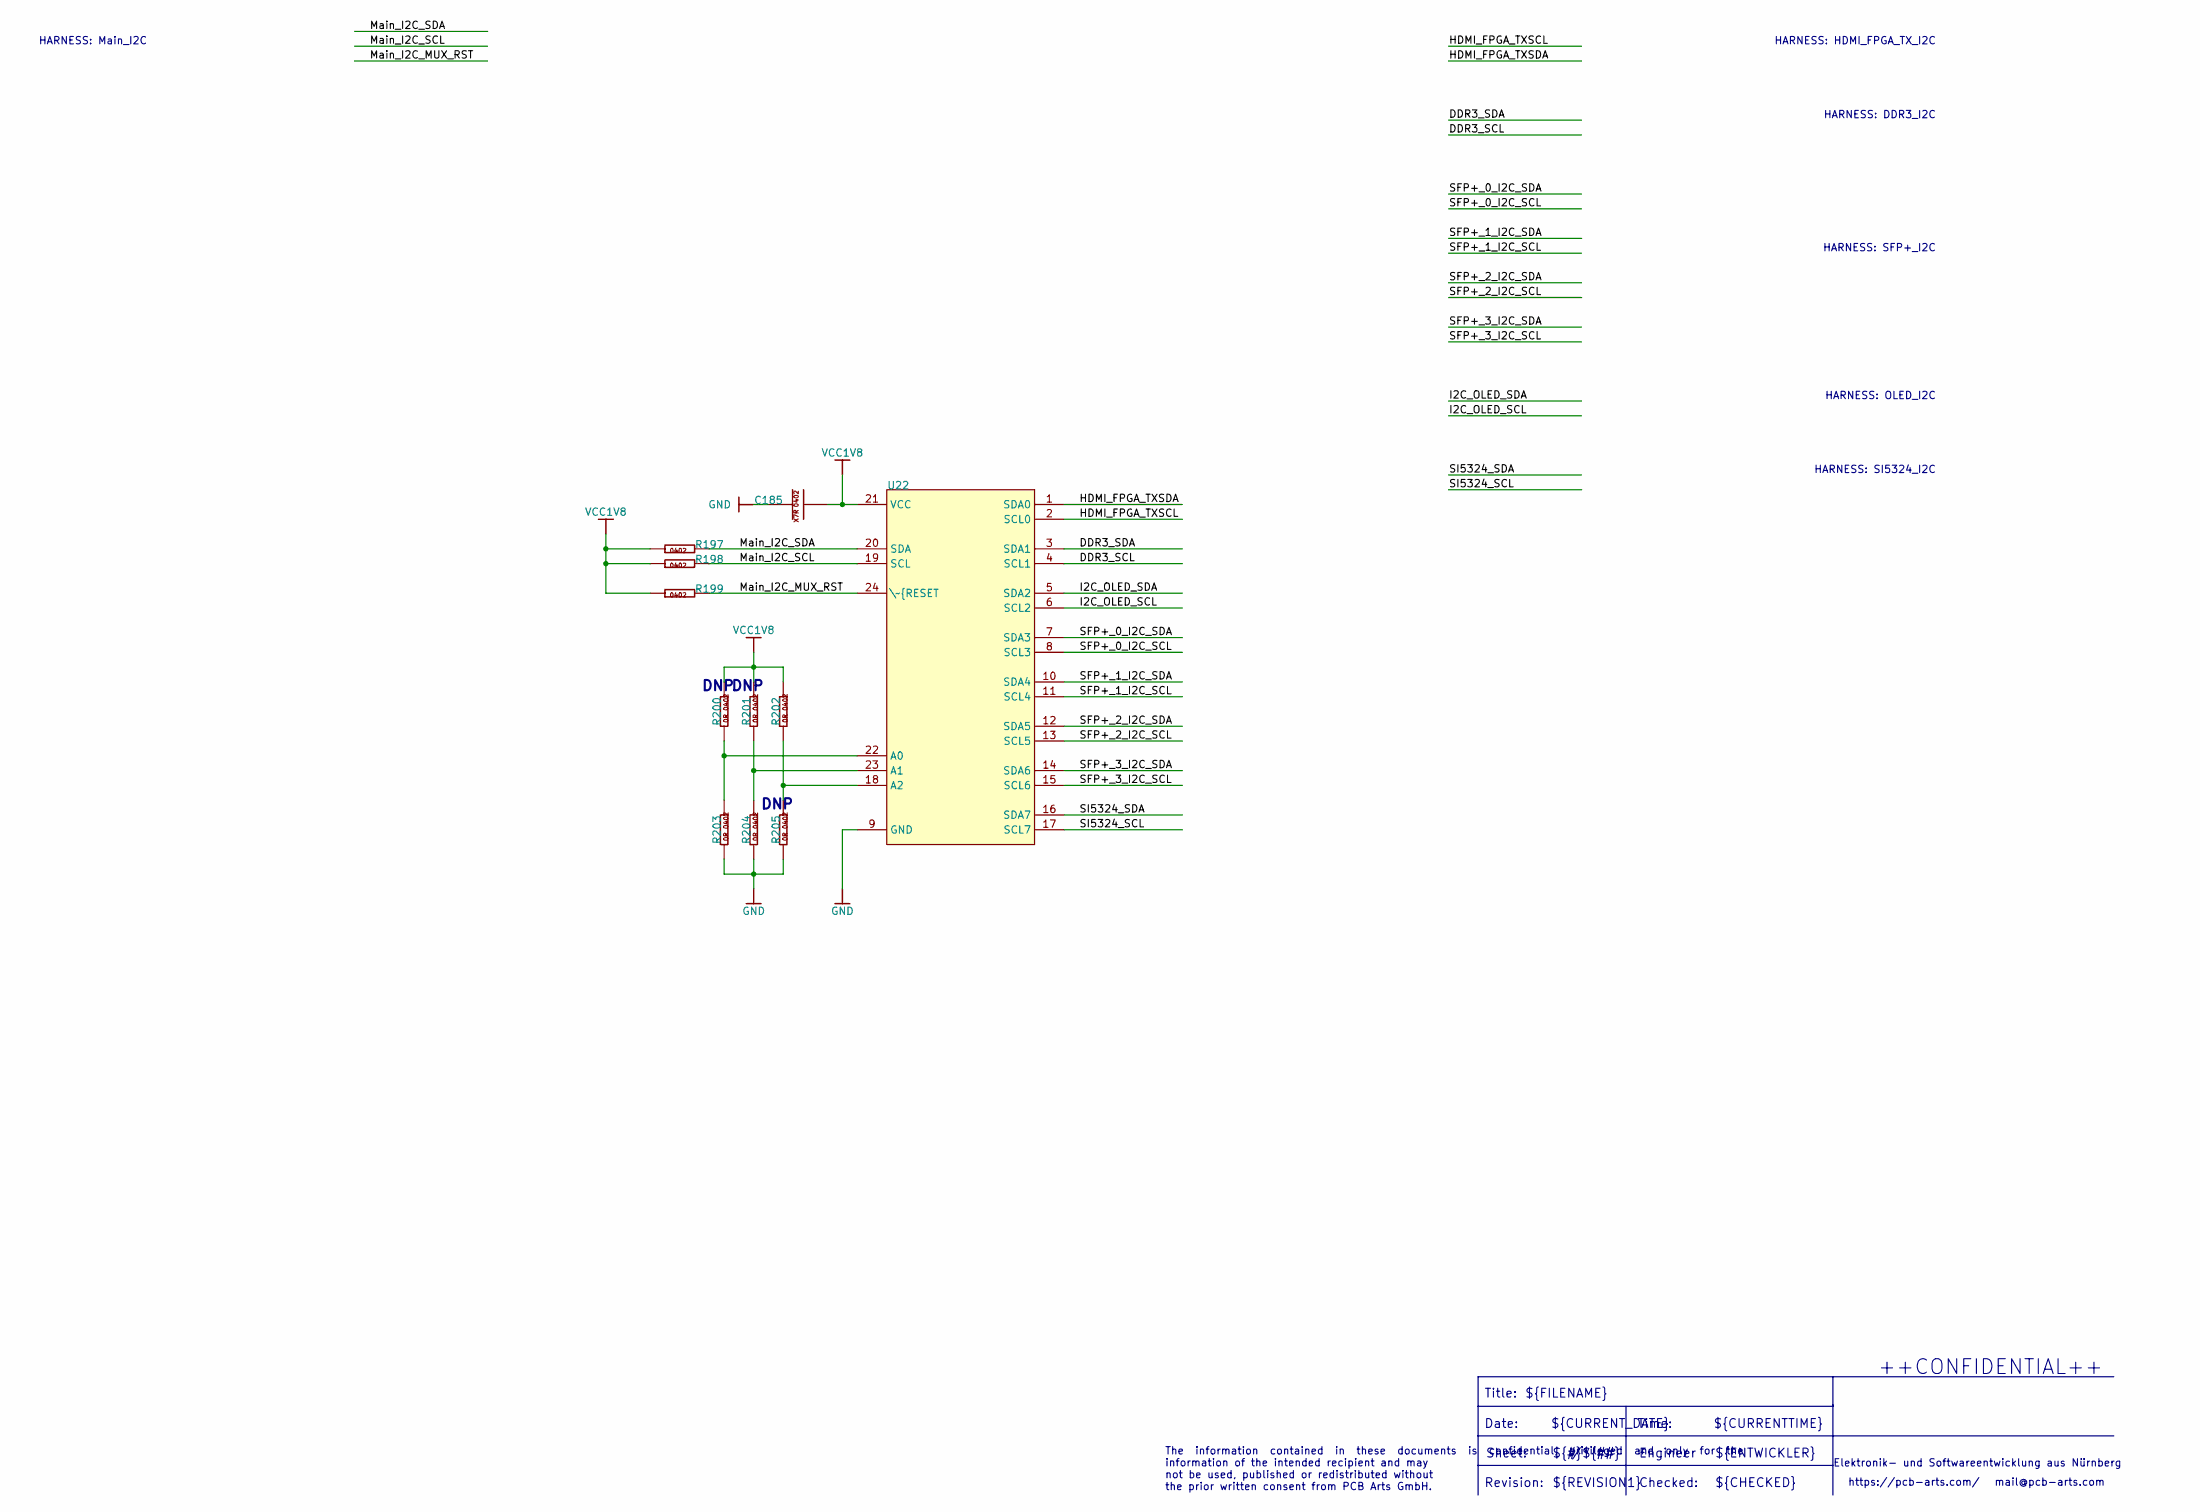
[picture p75: schematic I2C Multiplexer.kicad_sch]

Parts:
C185: CAP_0402_L
R197, R198, R199, R200, R201, R202, R203, R204, R205: RES_0402_L
U22: QFN50P400X400X100-25N

Connections:
DDR3_SCL: U22.4 (SCL1)
DDR3_SDA: U22.3 (SDA1)
HDMI_FPGA_TXSCL: U22.2 (SCL0)
HDMI_FPGA_TXSDA: U22.1 (SDA0)
I2C_OLED_SCL: U22.6 (SCL2)
I2C_OLED_SDA: U22.5 (SDA2)
Main_I2C_MUX_RST: R199.1, U22.24 (\~{RESET)
Main_I2C_SCL: R198.1, U22.19 (SCL)
Main_I2C_SDA: R197.1, U22.20 (SDA)
unnamed: C185.1, U22.21 (VCC)
unnamed: R197.2, R198.2, R199.2
unnamed: R200.1, R203.2, U22.22 (A0)
unnamed: R200.2, R201.2, R202.2
unnamed: R201.1, R204.2, U22.23 (A1)
unnamed: R202.1, R205.2, U22.18 (A2)
unnamed: R203.1, R204.1, R205.1
SFP+_0_I2C_SCL: U22.8 (SCL3)
SFP+_0_I2C_SDA: U22.7 (SDA3)
SFP+_1_I2C_SCL: U22.11 (SCL4)
SFP+_1_I2C_SDA: U22.10 (SDA4)
SFP+_2_I2C_SCL: U22.13 (SCL5)
SFP+_2_I2C_SDA: U22.12 (SDA5)
SFP+_3_I2C_SCL: U22.15 (SCL6)
SFP+_3_I2C_SDA: U22.14 (SDA6)
SI5324_SCL: U22.17 (SCL7)
SI5324_SDA: U22.16 (SDA7)

Notes on the sheet:
HARNESS: Main_I2C
Date:
${CHECKED}
Revision:
HARNESS: SFP+_I2C
${ENTWICKLER}
Title:
Checked:
DNP
HARNESS: OLED_I2C
Sheet:
Engineer
${REVISION1}
${FILENAME}
HARNESS: DDR3_I2C
Time:
The information contained in these documents is confidential, privileged and only for the information of the intended recipient and may not be used, published or redistributed without the prior written consent from PCB Arts GmbH.
${#}
mail@pcb-arts.com
${CURRENT_DATE}
HARNESS: HDMI_FPGA_TX_I2C
Elektronik- und Softwareentwicklung aus Nürnberg
https://pcb-arts.com/
${##}
HARNESS: SI5324_I2C
${CURRENTTIME}
++CONFIDENTIAL++
