pcbarts/fast-open-switch-hardware/fast-open-switch r1.0 - KiCad/MGT Banks 115-116.kicad_sch

## KiCad design fast-open-switch r1.0 - KiCad/MGT Banks 115-116.kicad_sch (2023-05-11)

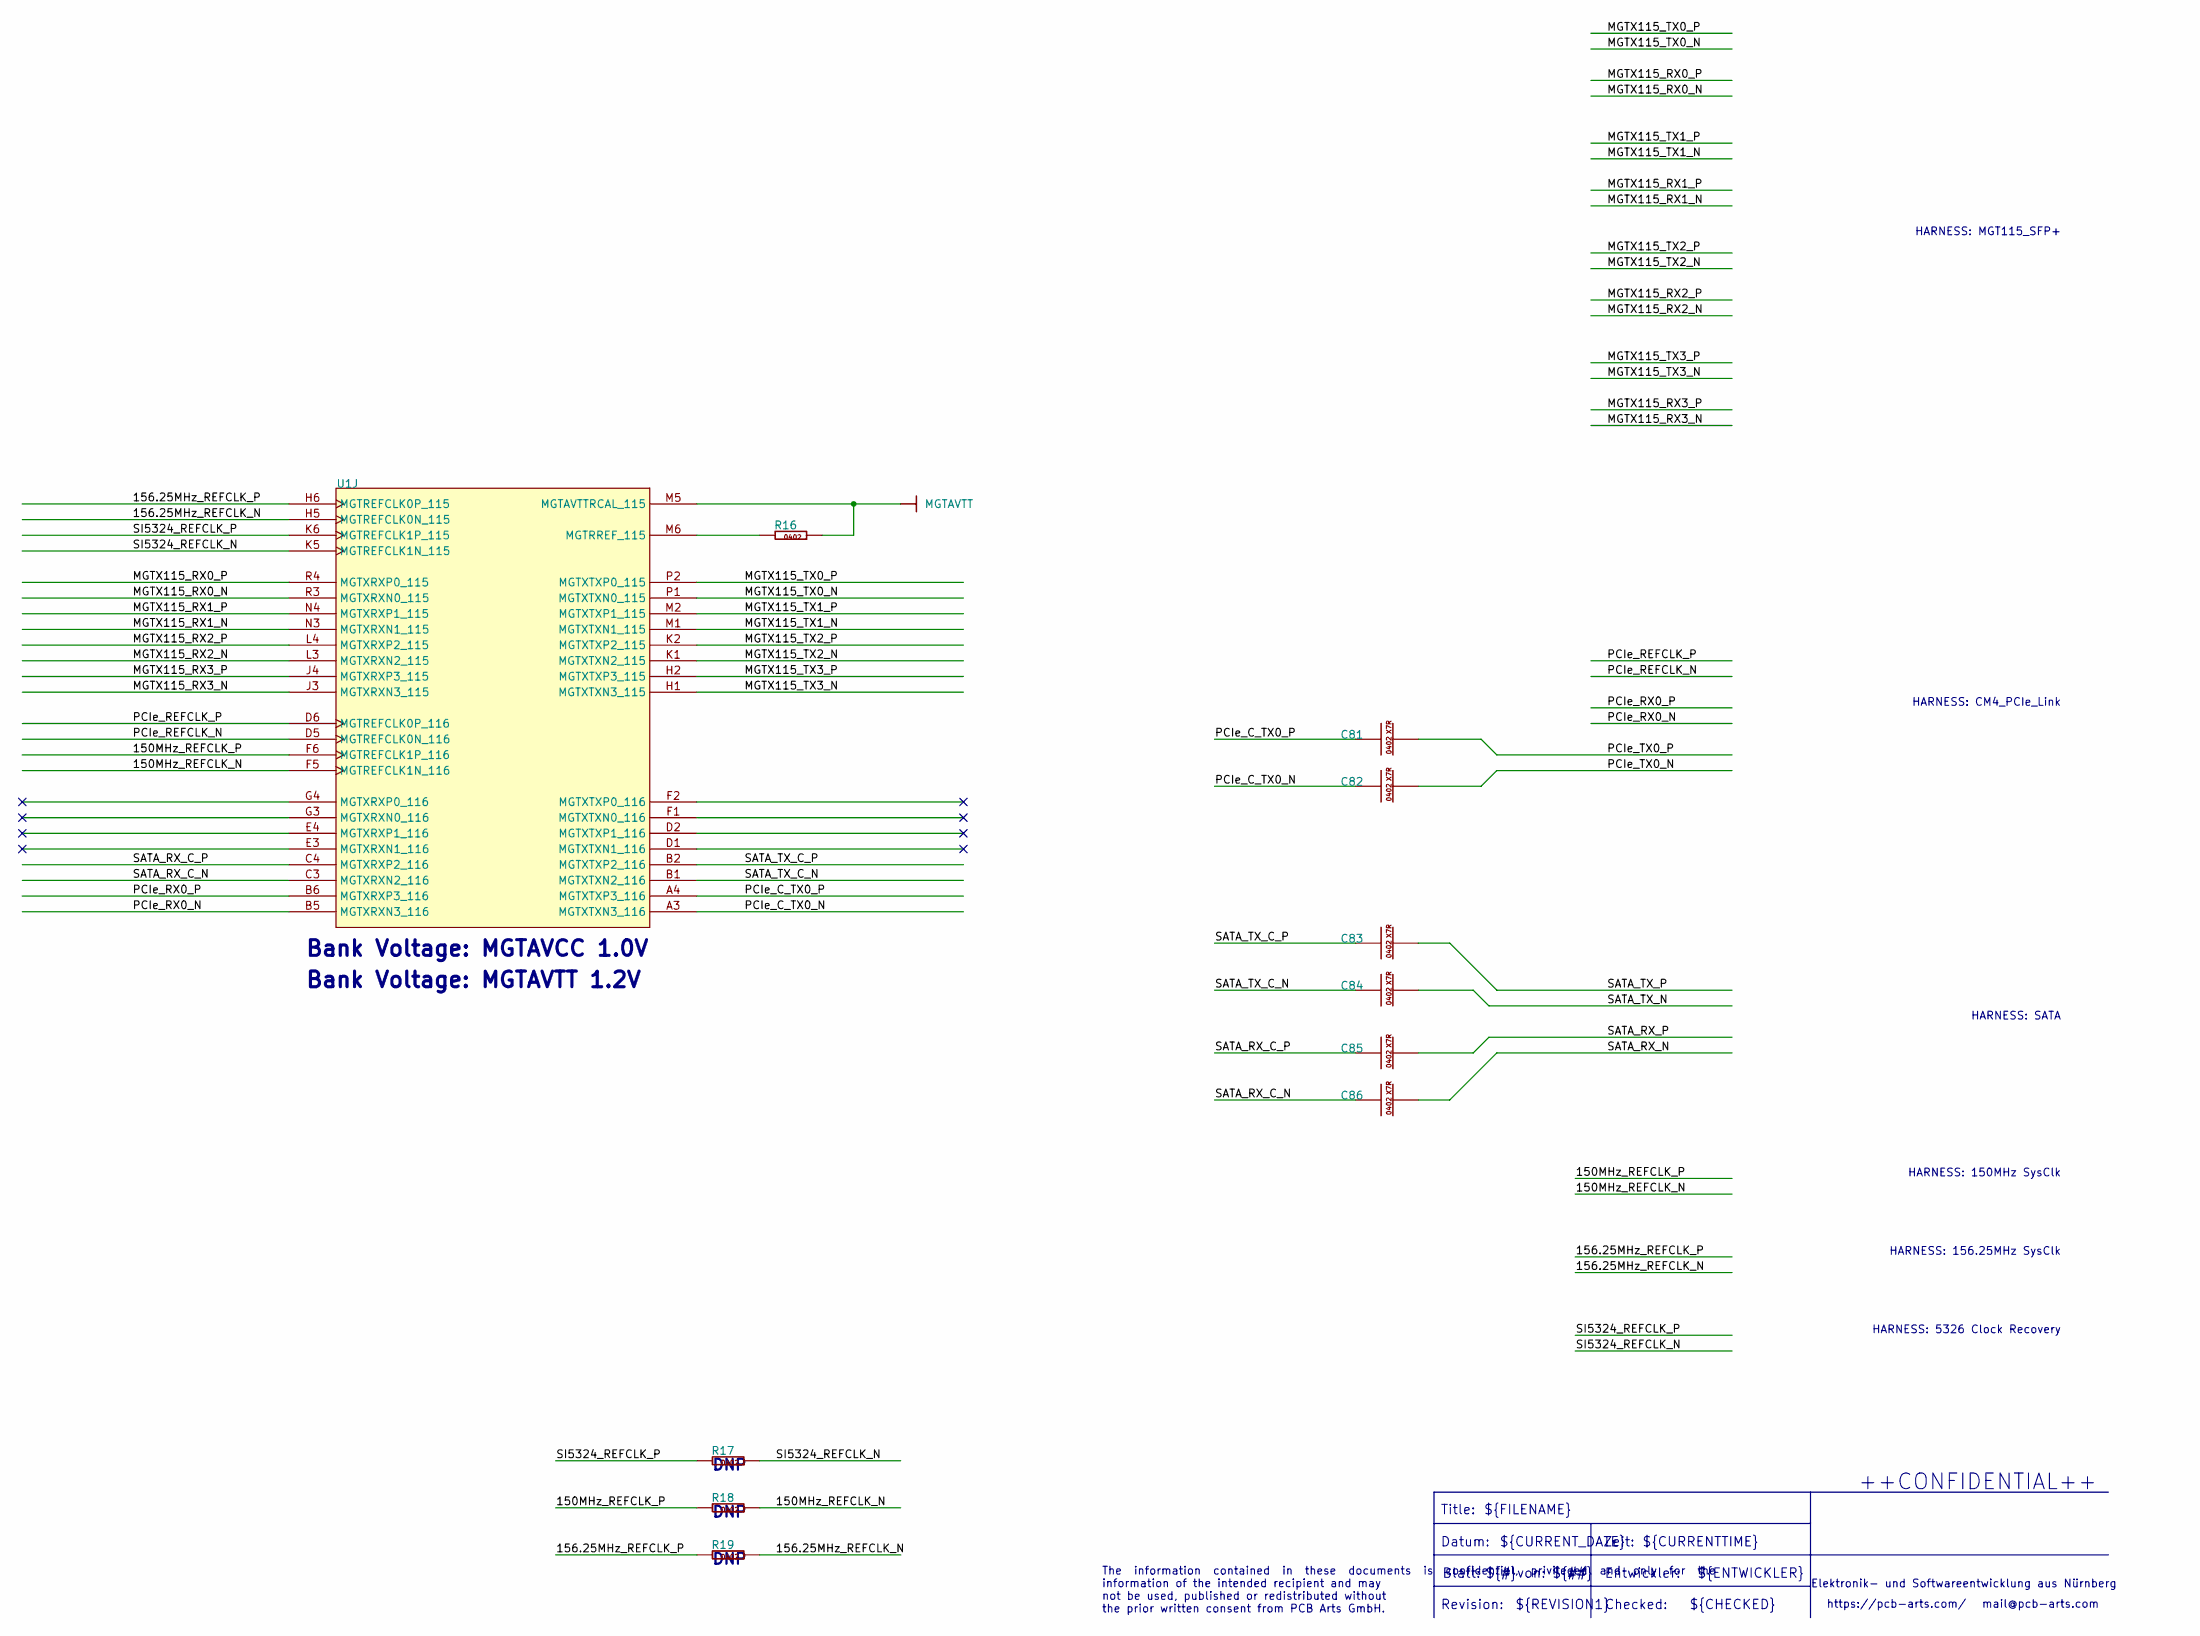
[picture p76: schematic MGT Banks 115-116.kicad_sch]

Parts:
C81, C82, C83, C84, C85, C86: CAP_0402_L
R16, R17, R18, R19: RES_0402_L
U1: BGA100P2700X2700X317-676N

Connections:
150MHz_REFCLK_N: R18.2, U1.F5 (MGTREFCLK1N_116)
150MHz_REFCLK_P: R18.1, U1.F6 (MGTREFCLK1P_116)
156.25MHz_REFCLK_N: R19.2, U1.H5 (MGTREFCLK0N_115)
156.25MHz_REFCLK_P: R19.1, U1.H6 (MGTREFCLK0P_115)
MGTX115_RX0_N: U1.R3 (MGTXRXN0_115)
MGTX115_RX0_P: U1.R4 (MGTXRXP0_115)
MGTX115_RX1_N: U1.N3 (MGTXRXN1_115)
MGTX115_RX1_P: U1.N4 (MGTXRXP1_115)
MGTX115_RX2_N: U1.L3 (MGTXRXN2_115)
MGTX115_RX2_P: U1.L4 (MGTXRXP2_115)
MGTX115_RX3_N: U1.J3 (MGTXRXN3_115)
MGTX115_RX3_P: U1.J4 (MGTXRXP3_115)
MGTX115_TX0_N: U1.P1 (MGTXTXN0_115)
MGTX115_TX0_P: U1.P2 (MGTXTXP0_115)
MGTX115_TX1_N: U1.M1 (MGTXTXN1_115)
MGTX115_TX1_P: U1.M2 (MGTXTXP1_115)
MGTX115_TX2_N: U1.K1 (MGTXTXN2_115)
MGTX115_TX2_P: U1.K2 (MGTXTXP2_115)
MGTX115_TX3_N: U1.H1 (MGTXTXN3_115)
MGTX115_TX3_P: U1.H2 (MGTXTXP3_115)
unnamed: R16.1, U1.M6 (MGTRREF_115)
unnamed: R16.2, U1.M5 (MGTAVTTRCAL_115)
PCIe_C_TX0_N: C82.1, U1.A3 (MGTXTXN3_116)
PCIe_C_TX0_P: C81.1, U1.A4 (MGTXTXP3_116)
PCIe_REFCLK_N: U1.D5 (MGTREFCLK0N_116)
PCIe_REFCLK_P: U1.D6 (MGTREFCLK0P_116)
PCIe_RX0_N: U1.B5 (MGTXRXN3_116)
PCIe_RX0_P: U1.B6 (MGTXRXP3_116)
PCIe_TX0_N: C82.2
PCIe_TX0_P: C81.2
SATA_RX_C_N: C86.1, U1.C3 (MGTXRXN2_116)
SATA_RX_C_P: C85.1, U1.C4 (MGTXRXP2_116)
SATA_RX_N: C86.2
SATA_RX_P: C85.2
SATA_TX_C_N: C84.1, U1.B1 (MGTXTXN2_116)
SATA_TX_C_P: C83.1, U1.B2 (MGTXTXP2_116)
SATA_TX_N: C84.2
SATA_TX_P: C83.2
SI5324_REFCLK_N: R17.2, U1.K5 (MGTREFCLK1N_115)
SI5324_REFCLK_P: R17.1, U1.K6 (MGTREFCLK1P_115)

Notes on the sheet:
HARNESS: CM4_PCIe_Link
${CURRENTTIME}
DNP
Checked:
${##}
Zeit:
++CONFIDENTIAL++
Revision:
HARNESS: 150MHz SysClk
${#}
https://pcb-arts.com/
${CURRENT_DATE}
Datum:
HARNESS: MGT115_SFP+
${CHECKED}
${REVISION1}
HARNESS: 5326 Clock Recovery
${ENTWICKLER}
Blatt:
HARNESS: 156.25MHz SysClk
Bank Voltage: MGTAVCC 1.0V
Entwickler:
Title:
von:
${FILENAME}
mail@pcb-arts.com
The information contained in these documents is confidential, privileged and only for the information of the intended recipient and may not be used, published or redistributed without the prior written consent from PCB Arts GmbH.
Bank Voltage: MGTAVTT 1.2V
HARNESS: SATA
Elektronik- und Softwareentwicklung aus Nürnberg
