pcbarts/fast-open-switch-hardware/fast-open-switch r1.0 - KiCad/PWR_CTRL.kicad_sch

## KiCad design fast-open-switch r1.0 - KiCad/PWR_CTRL.kicad_sch (2023-05-11)

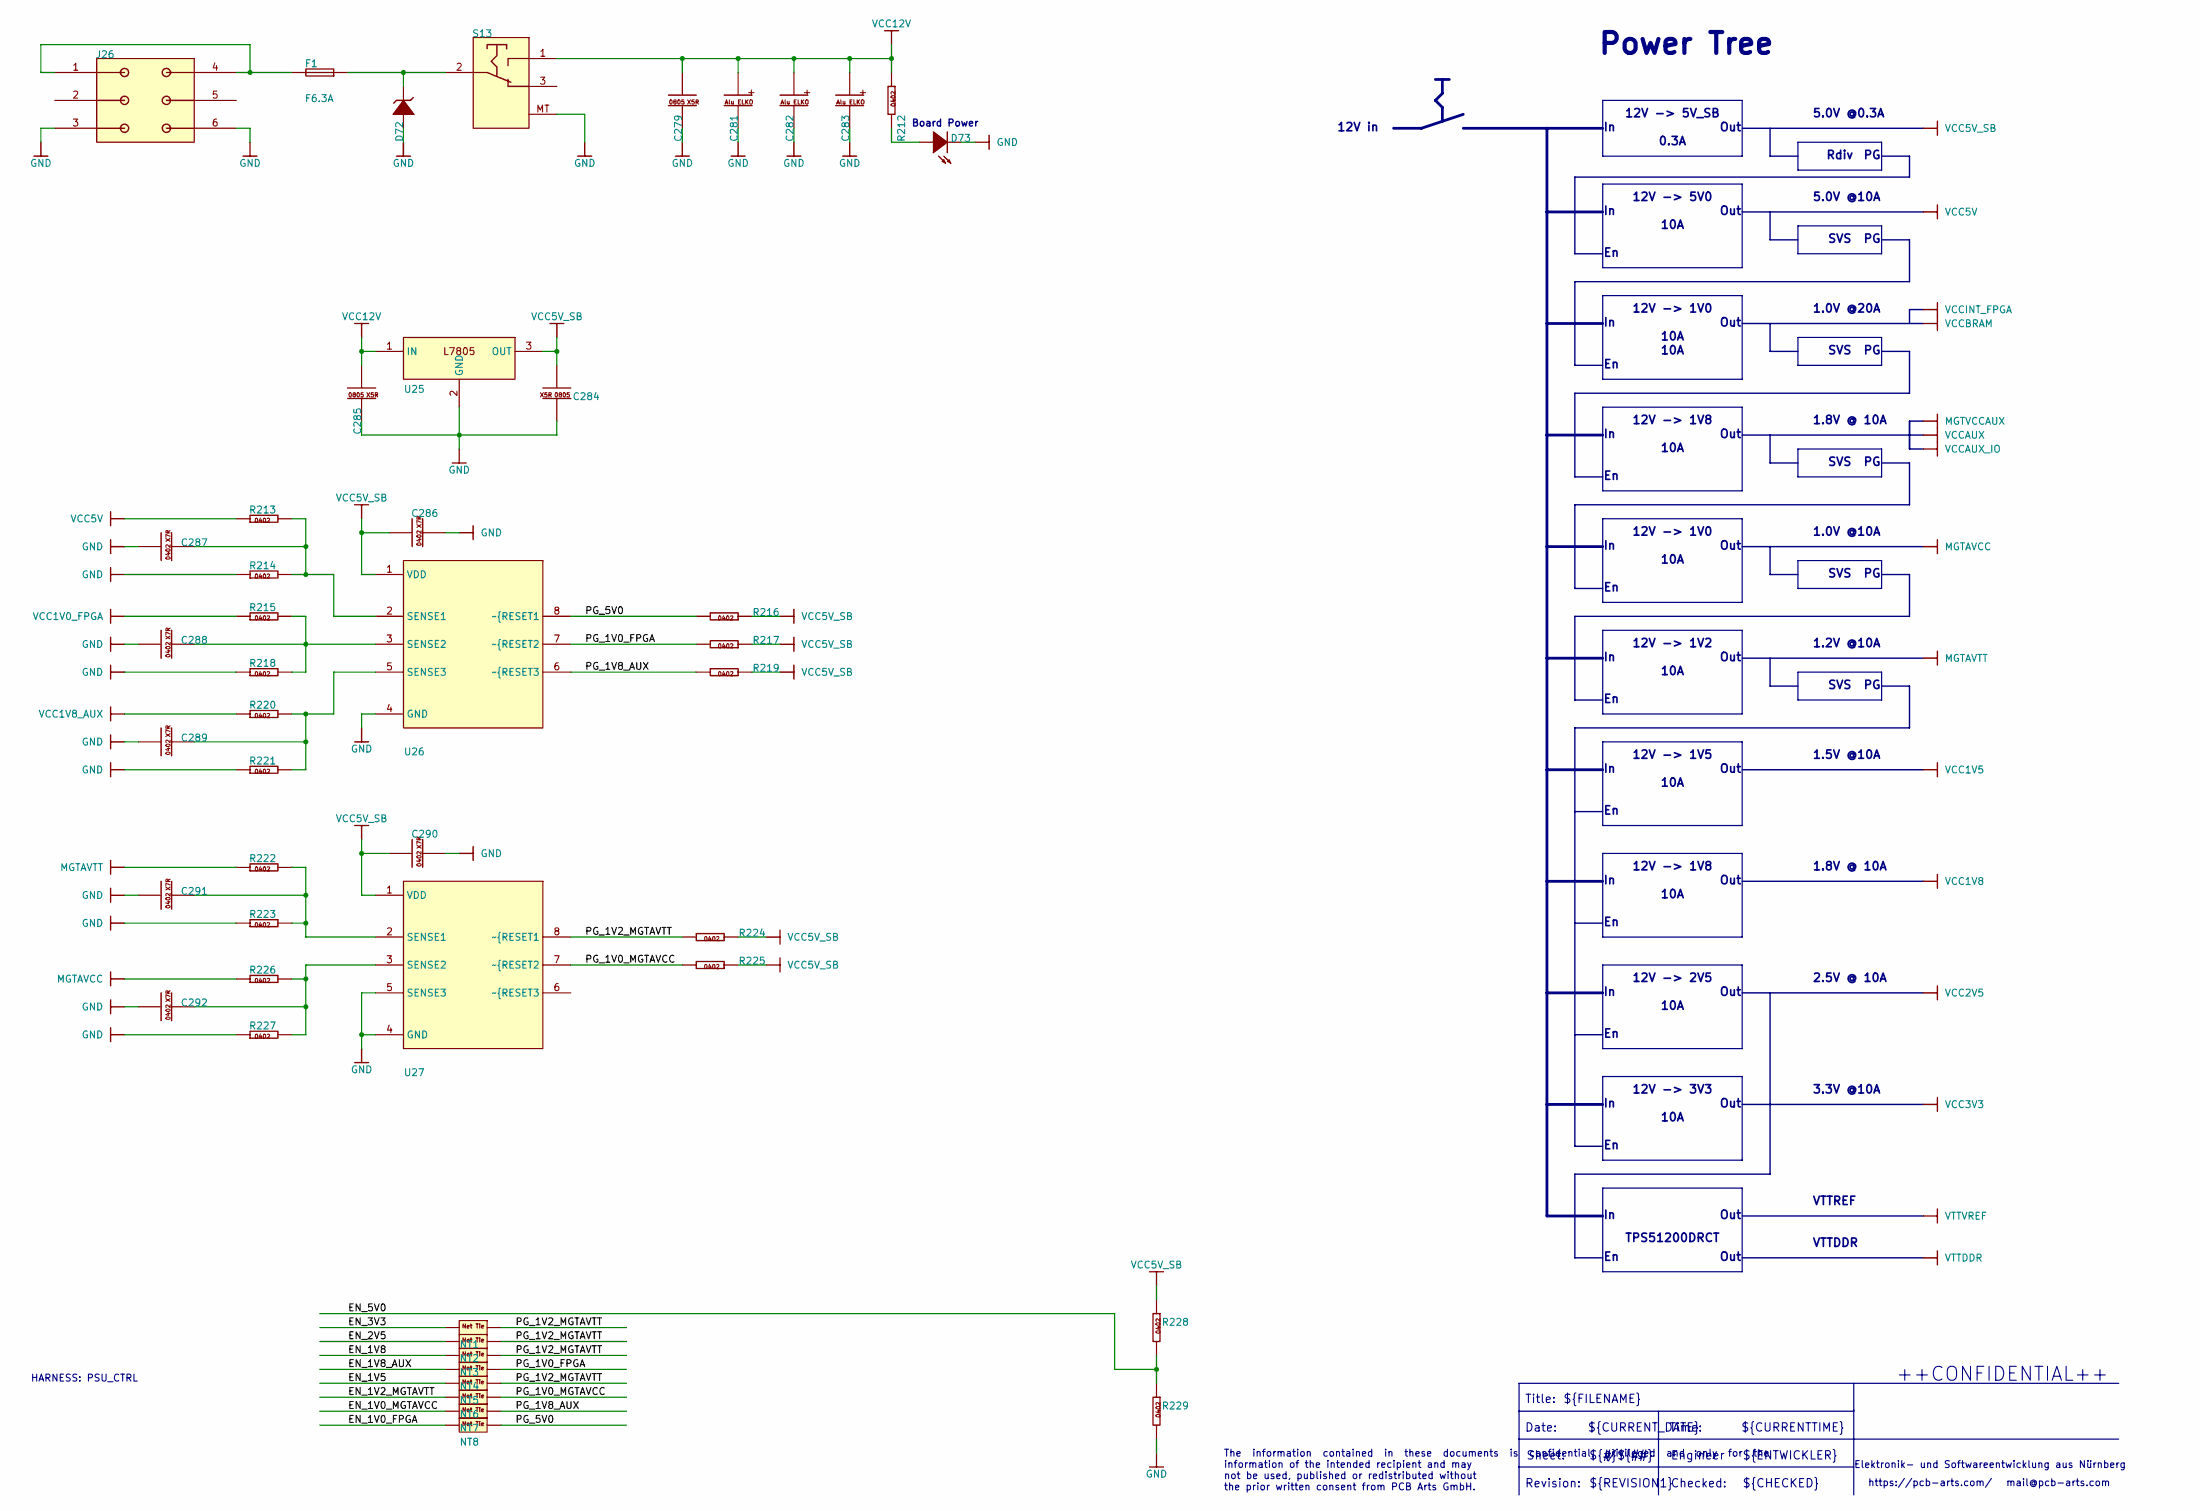
[picture p77: schematic PWR_CTRL.kicad_sch]

Parts:
C279, C284, C285: CAP_0805
C281, C282, C283: WCAP-PTG5_D10H12.5
C286, C287, C288, C289, C290, C291, C292: CAP_0402_L
D72: DO221-AA
D73: LED-0603 Sideview
F1: 154 Series Littelfuse
J26: Molex 87427-0602
NT1, NT2, NT3, NT4, NT5, NT6, NT7, NT8: Net Tie-0.3
R212, R213, R214, R215, R216, R217, R218, R219, R220, R221, R222, R223, R224, R225, R226, R227, R228, R229: RES_0402_L
S13: 7101MD9AV2BE
U25: DPAK230P991X241-3N
U26, U27: SOT65P295X160-8N

Connections:
EN_1V0_FPGA: NT8.1
EN_1V0_MGTAVCC: NT7.1
EN_1V2_MGTAVTT: NT6.1
EN_1V5: NT5.1
EN_1V8: NT3.1
EN_1V8_AUX: NT4.1
EN_2V5: NT2.1
EN_3V3: NT1.1
EN_5V0: R228.1, R229.2
unnamed: C279.1, C281.1, C282.1, C283.1, R212.2, S13.1
unnamed: C284.1, U25.3 (OUT)
unnamed: C284.2, C285.2, U25.2 (GND)
unnamed: C285.1, U25.1 (IN)
unnamed: C286.1, U26.1 (VDD)
unnamed: C287.2, R213.1, R214.1, U26.2 (SENSE1)
unnamed: C288.2, R215.1, R218.1, U26.3 (SENSE2)
unnamed: C289.2, R220.1, R221.1, U26.5 (SENSE3)
unnamed: C290.1, U27.1 (VDD)
unnamed: C291.2, R222.1, R223.1, U27.2 (SENSE1)
unnamed: C292.2, R226.1, R227.1, U27.3 (SENSE2)
unnamed: D72.1, F1.2, S13.2
unnamed: D73.2, R212.1
unnamed: F1.1, J26.1, J26.4
unnamed: U27.4 (GND), U27.5 (SENSE3)
PG_1V0_FPGA: NT4.2, R217.1, U26.7 (~{RESET2)
PG_1V0_MGTAVCC: NT6.2, R225.1, U27.7 (~{RESET2)
PG_1V2_MGTAVTT: NT1.2, NT2.2, NT3.2, NT5.2, R224.1, U27.8 (~{RESET1)
PG_1V8_AUX: NT7.2, R219.1, U26.6 (~{RESET3)
PG_5V0: NT8.2, R216.1, U26.8 (~{RESET1)

Notes on the sheet:
Out
VTTDDR
10A
1.8V @ 10A
Date:
12V -> 1V2
12V -> 1V0
Engineer
Rdiv
The information contained in these documents is confidential, privileged and only for the information of the intended recipient and may not be used, published or redistributed without the prior written consent from PCB Arts GmbH.
Power Tree
VTTREF
Sheet:
++CONFIDENTIAL++
${#}
${ENTWICKLER}
${##}
12V -> 3V3
12V -> 5V0
${REVISION1}
Board Power
12V in
SVS
1.5V @10A
HARNESS: PSU_CTRL
12V -> 1V8
3.3V @10A
Time:
12V -> 2V5
1.0V @10A
Title:
Elektronik- und Softwareentwicklung aus Nürnberg
5.0V @10A
1.0V @20A
2.5V @ 10A
1.2V @10A
${CHECKED}
${CURRENT_DATE}
mail@pcb-arts.com
0.3A
Revision:
${FILENAME}
TPS51200DRCT
Checked:
12V -> 5V_SB
5.0V @0.3A
12V -> 1V5
https://pcb-arts.com/
${CURRENTTIME}
