pcbarts/fast-open-switch-hardware/fast-open-switch r1.0 - KiCad/QSPI Flash_eMMC_uSD-Card.kicad_sch

## KiCad design fast-open-switch r1.0 - KiCad/QSPI Flash_eMMC_uSD-Card.kicad_sch (2023-05-11)

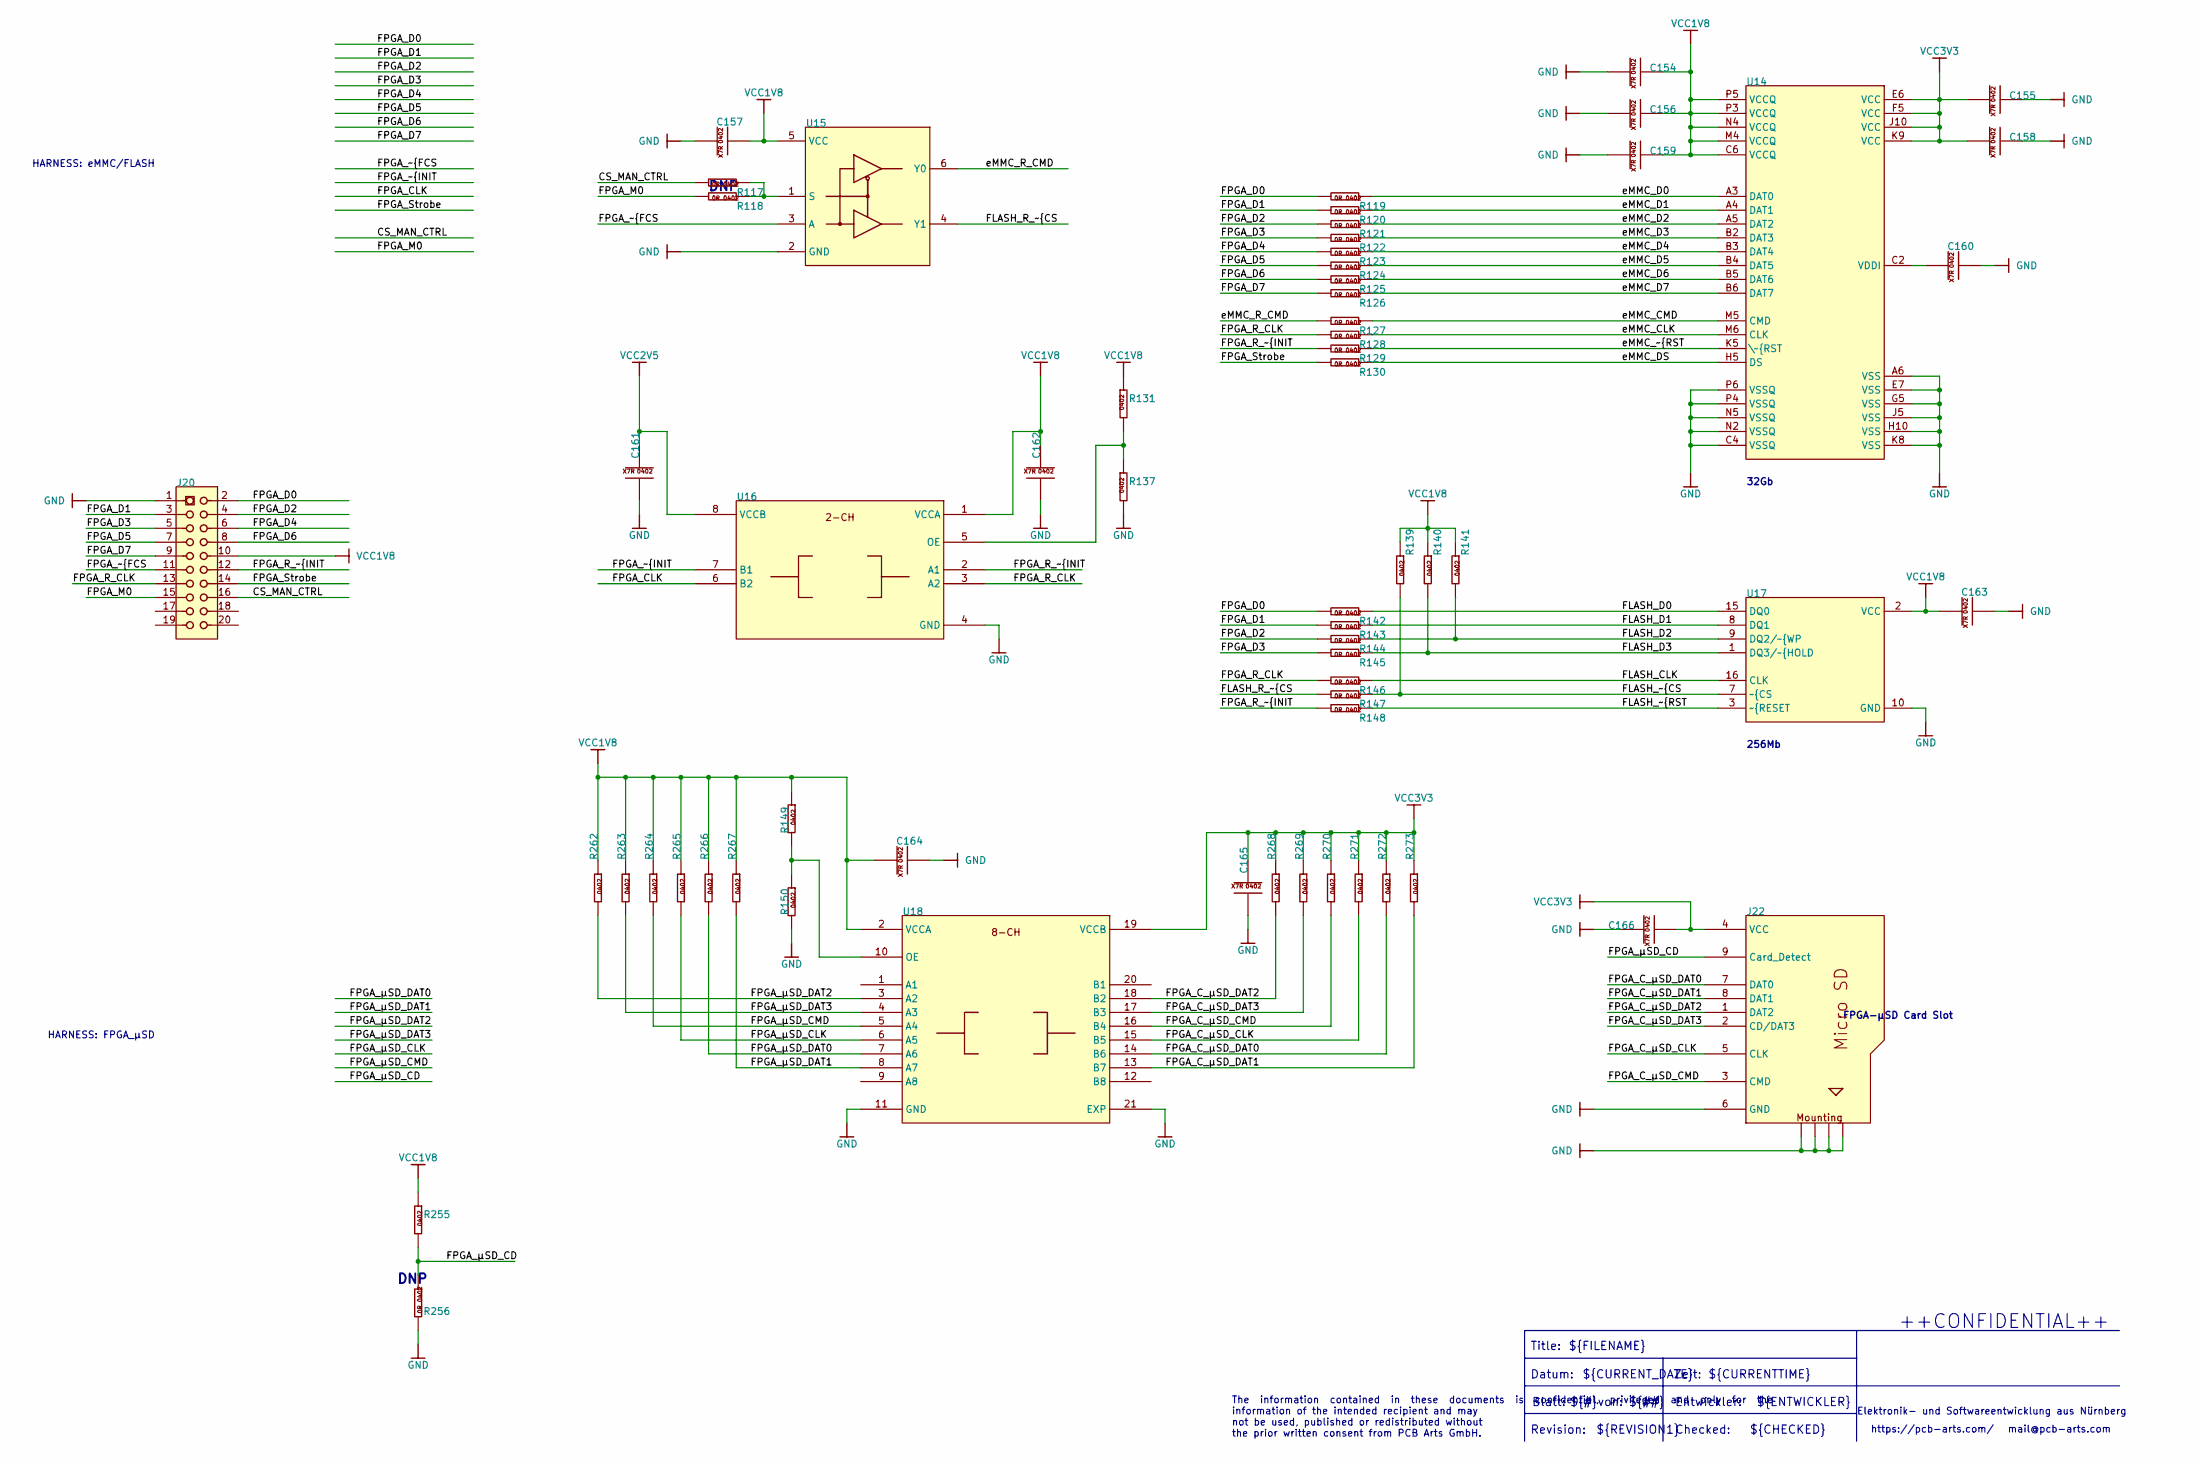
[picture p78: schematic QSPI Flash_eMMC_uSD-Card.kicad_sch]

Parts:
C154, C155, C156, C157, C158, C159, C160, C161, C162, C163, C164, C165, C166: CAP_0402_L
J20: 62702021621
J22: TF-115
R117, R118, R119, R120, R121, R122, R123, R124, R125, R126, R127, R128, R129, R130, R131, R137, R139, R140, R141, R142, R143, R144, R145, R146, R147, R148, R149, R150, R255, R262, R263, R264, R265, R266, R267, R268, R269, R270, R271, R272, R273: RES_0402_L
R256: RES_0402
U14: BGA50P900X750X080-153N
U15: SOT95P275X110-6N
U16: SON40P120X40-8N
U17: SOIC16_Widebody
U18: QFN50P450X350X100-21N

Connections:
CS_MAN_CTRL: J20.16, R117.1
FLASH_CLK: R146.2, U17.16 (CLK)
FLASH_D0: R142.2, U17.15 (DQ0)
FLASH_D1: R143.2, U17.8 (DQ1)
FLASH_D2: R141.1, R144.2, U17.9 (DQ2/~{WP)
FLASH_D3: R140.1, R145.2, U17.1 (DQ3/~{HOLD)
FLASH_R_~{CS: R147.1, U15.4 (Y1)
FLASH_~{CS: R139.1, R147.2, U17.7 (~{CS)
FLASH_~{RST: R148.2, U17.3 (~{RESET)
FPGA_CLK: U16.6 (B2)
FPGA_C_µSD_CLK: J22.5 (CLK), R271.1, U18.15 (B5)
FPGA_C_µSD_CMD: J22.3 (CMD), R270.1, U18.16 (B4)
FPGA_C_µSD_DAT0: J22.7 (DAT0), R272.1, U18.14 (B6)
FPGA_C_µSD_DAT1: J22.8 (DAT1), R273.1, U18.13 (B7)
FPGA_C_µSD_DAT2: J22.1 (DAT2), R268.1, U18.18 (B2)
FPGA_C_µSD_DAT3: J22.2 (CD/DAT3), R269.1, U18.17 (B3)
FPGA_D0: J20.2, R119.1, R142.1
FPGA_D1: J20.3, R120.1, R143.1
FPGA_D2: J20.4, R121.1, R144.1
FPGA_D3: J20.5, R122.1, R145.1
FPGA_D4: J20.6, R123.1
FPGA_D5: J20.7, R124.1
FPGA_D6: J20.8, R125.1
FPGA_D7: J20.9, R126.1
FPGA_M0: J20.15, R118.1
FPGA_R_CLK: J20.13, R128.1, R146.1, U16.3 (A2)
FPGA_R_~{INIT: J20.12, R129.1, R148.1, U16.2 (A1)
FPGA_Strobe: J20.14, R130.1
FPGA_~{FCS: J20.11, U15.3 (A)
FPGA_~{INIT: U16.7 (B1)
FPGA_µSD_CD: J22.9 (Card_Detect), R255.1, R256.2
FPGA_µSD_CLK: R265.1, U18.6 (A5)
FPGA_µSD_CMD: R264.1, U18.5 (A4)
FPGA_µSD_DAT0: R266.1, U18.7 (A6)
FPGA_µSD_DAT1: R267.1, U18.8 (A7)
FPGA_µSD_DAT2: R262.1, U18.3 (A2)
FPGA_µSD_DAT3: R263.1, U18.4 (A3)
unnamed: C154.1, C156.1, C159.1, U14.C6 (VCCQ), U14.M4 (VCCQ), U14.N4 (VCCQ), U14.P3 (VCCQ), U14.P5 (VCCQ)
unnamed: C155.2, C158.2, U14.E6 (VCC), U14.F5 (VCC), U14.J10 (VCC), U14.K9 (VCC)
unnamed: C157.1, U15.5 (VCC)
unnamed: C160.2, U14.C2 (VDDI)
unnamed: C161.2, U16.8 (VCCB)
unnamed: C162.2, U16.1 (VCCA)
unnamed: C163.2, U17.2 (VCC)
unnamed: C164.2, R149.2, R262.2, R263.2, R264.2, R265.2, R266.2, R267.2, U18.2 (VCCA)
unnamed: C165.2, R268.2, R269.2, R270.2, R271.2, R272.2, R273.2, U18.19 (VCCB)
unnamed: C166.1, J22.4 (VCC)
unnamed: J22.10, J22.11, J22.12, J22.13
unnamed: R117.2, R118.2, U15.1 (S)
unnamed: R131.1, R137.2, U16.5 (OE)
unnamed: R139.2, R140.2, R141.2
unnamed: R149.1, R150.2, U18.10 (OE)
unnamed: U14.A6 (VSS), U14.E7 (VSS), U14.G5 (VSS), U14.H10 (VSS), U14.J5 (VSS), U14.K8 (VSS)
unnamed: U14.C4 (VSSQ), U14.N2 (VSSQ), U14.N5 (VSSQ), U14.P4 (VSSQ), U14.P6 (VSSQ)
eMMC_CLK: R128.2, U14.M6 (CLK)
eMMC_CMD: R127.2, U14.M5 (CMD)
eMMC_D0: R119.2, U14.A3 (DAT0)
eMMC_D1: R120.2, U14.A4 (DAT1)
eMMC_D2: R121.2, U14.A5 (DAT2)
eMMC_D3: R122.2, U14.B2 (DAT3)
eMMC_D4: R123.2, U14.B3 (DAT4)
eMMC_D5: R124.2, U14.B4 (DAT5)
eMMC_D6: R125.2, U14.B5 (DAT6)
eMMC_D7: R126.2, U14.B6 (DAT7)
eMMC_DS: R130.2, U14.H5 (DS)
eMMC_R_CMD: R127.1, U15.6 (Y0)
eMMC_~{RST: R129.2, U14.K5 (\~{RST)

Notes on the sheet:
Blatt:
Title:
FPGA-µSD Card Slot
Checked:
DNP
${CURRENT_DATE}
https://pcb-arts.com/
mail@pcb-arts.com
${##}
Zeit:
${CURRENTTIME}
++CONFIDENTIAL++
${ENTWICKLER}
Datum:
Elektronik- und Softwareentwicklung aus Nürnberg
Entwickler:
HARNESS: eMMC/FLASH
HARNESS: FPGA_µSD
The information contained in these documents is confidential, privileged and only for the information of the intended recipient and may not be used, published or redistributed without the prior written consent from PCB Arts GmbH.
${CHECKED}
Revision:
${FILENAME}
32Gb
von:
256Mb
${REVISION1}
${#}
