pcbarts/fast-open-switch-hardware/fast-open-switch r1.0 - KiCad/Raspberry Pi CM4.kicad_sch

## KiCad design fast-open-switch r1.0 - KiCad/Raspberry Pi CM4.kicad_sch (2023-05-11)

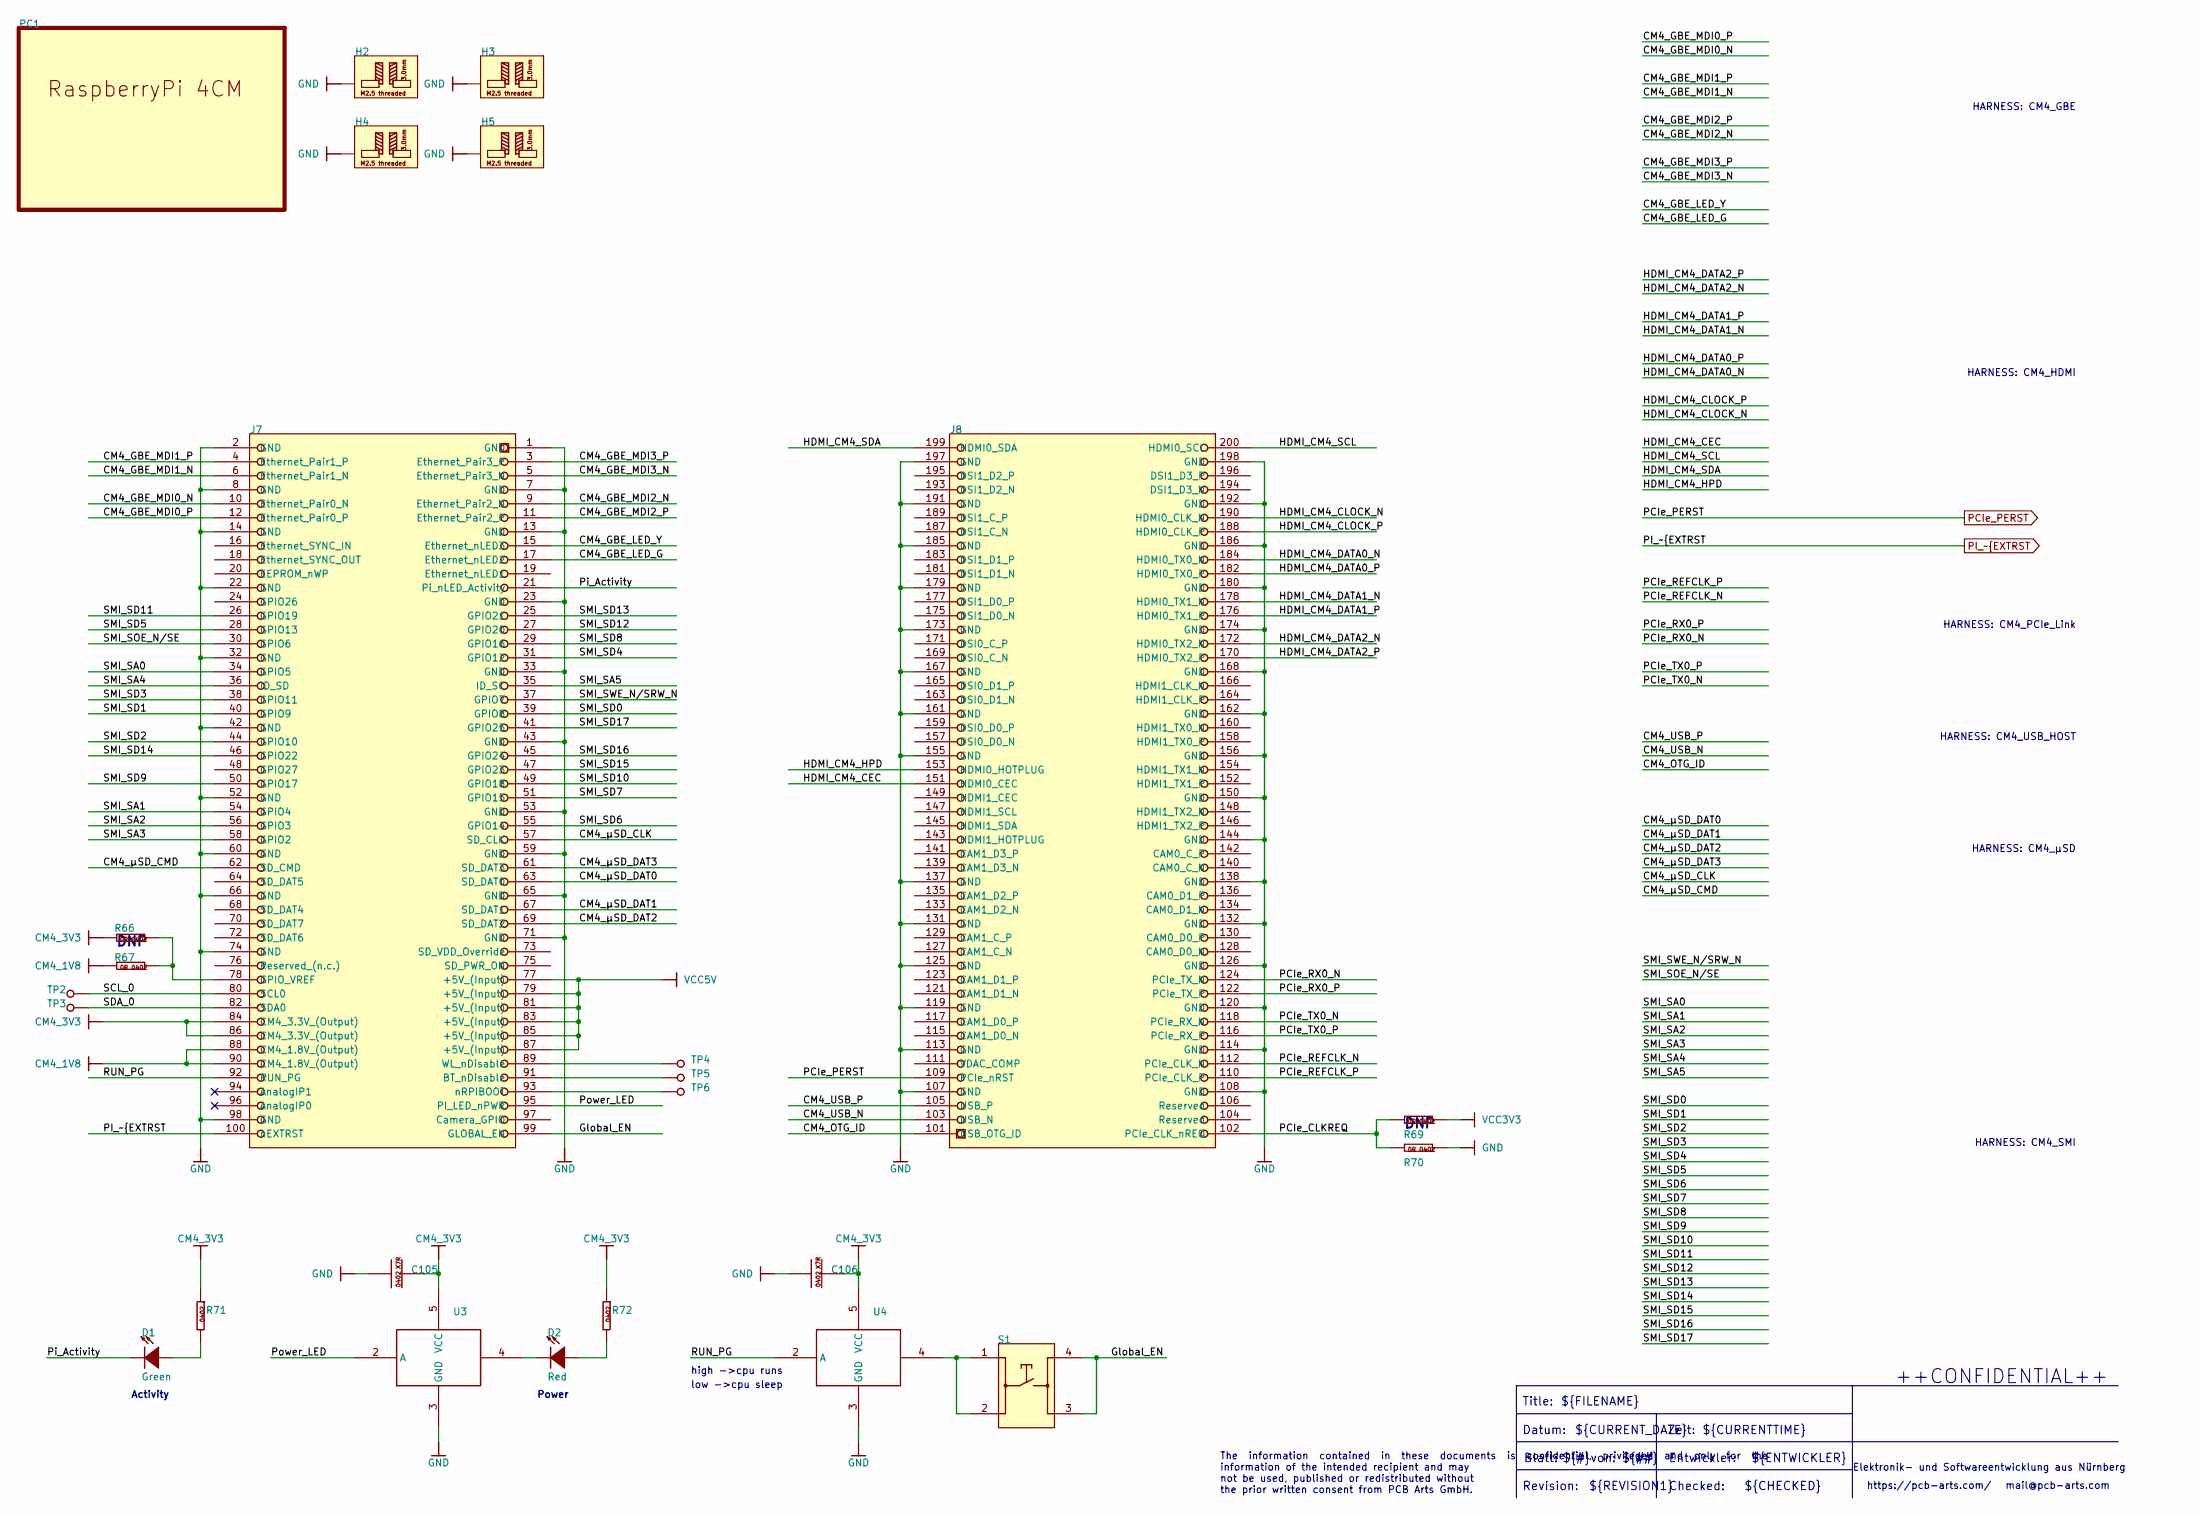
[picture p79: schematic Raspberry Pi CM4.kicad_sch]

Parts:
C105, C106: CAP_0402_L
D1, D2: LED-0603 Sideview
H2, H3, H4, H5: 9774030151R
J7: Hirose DF40HC(3.0)-100DS-0.4V_1-100
J8: Hirose DF40HC(3.0)-100DS-0.4V_101-200
PC1: RaspberryPi_CM4
R66, R67, R69, R70, R71, R72: RES_0402_L
S1: LL3301BF065QJ
TP2, TP3, TP4, TP5, TP6: Testpoint 0.8mm
U3, U4: SOT65P210X110-5N

Connections:
CM4_GBE_LED_G: J7.17 (Ethernet_nLED2)
CM4_GBE_LED_Y: J7.15 (Ethernet_nLED3)
CM4_GBE_MDI0_N: J7.10 (Ethernet_Pair0_N)
CM4_GBE_MDI0_P: J7.12 (Ethernet_Pair0_P)
CM4_GBE_MDI1_N: J7.6 (Ethernet_Pair1_N)
CM4_GBE_MDI1_P: J7.4 (Ethernet_Pair1_P)
CM4_GBE_MDI2_N: J7.9 (Ethernet_Pair2_N)
CM4_GBE_MDI2_P: J7.11 (Ethernet_Pair2_P)
CM4_GBE_MDI3_N: J7.5 (Ethernet_Pair3_N)
CM4_GBE_MDI3_P: J7.3 (Ethernet_Pair3_P)
CM4_OTG_ID: J8.101 (USB_OTG_ID)
CM4_USB_N: J8.103 (USB_N)
CM4_USB_P: J8.105 (USB_P)
CM4_µSD_CLK: J7.57 (SD_CLK)
CM4_µSD_CMD: J7.62 (SD_CMD)
CM4_µSD_DAT0: J7.63 (SD_DAT0)
CM4_µSD_DAT1: J7.67 (SD_DAT1)
CM4_µSD_DAT2: J7.69 (SD_DAT2)
CM4_µSD_DAT3: J7.61 (SD_DAT3)
Global_EN: J7.99 (GLOBAL_EN), S1.3, S1.4
HDMI_CM4_CEC: J8.151 (HDMI0_CEC)
HDMI_CM4_CLOCK_N: J8.190 (HDMI0_CLK_N)
HDMI_CM4_CLOCK_P: J8.188 (HDMI0_CLK_P)
HDMI_CM4_DATA0_N: J8.184 (HDMI0_TX0_N)
HDMI_CM4_DATA0_P: J8.182 (HDMI0_TX0_P)
HDMI_CM4_DATA1_N: J8.178 (HDMI0_TX1_N)
HDMI_CM4_DATA1_P: J8.176 (HDMI0_TX1_P)
HDMI_CM4_DATA2_N: J8.172 (HDMI0_TX2_N)
HDMI_CM4_DATA2_P: J8.170 (HDMI0_TX2_P)
HDMI_CM4_HPD: J8.153 (HDMI0_HOTPLUG)
HDMI_CM4_SCL: J8.200 (HDMI0_SCL)
HDMI_CM4_SDA: J8.199 (HDMI0_SDA)
unnamed: C105.2, U3.5 (VCC)
unnamed: C106.2, U4.5 (VCC)
unnamed: D1.2, R71.1
unnamed: D2.1, U3.4 (Y)
unnamed: D2.2, R72.1
unnamed: J7.1 (GND), J7.7 (GND), J7.13 (GND), J7.23 (GND), J7.33 (GND), J7.43 (GND), J7.53 (GND), J7.59 (GND), J7.65 (GND), J7.71 (GND)
unnamed: J7.2 (GND), J7.8 (GND), J7.14 (GND), J7.22 (GND), J7.32 (GND), J7.42 (GND), J7.52 (GND), J7.60 (GND), J7.66 (GND), J7.74 (GND), J7.98 (GND)
unnamed: J7.77 (+5V_(Input)), J7.79 (+5V_(Input)), J7.81 (+5V_(Input)), J7.83 (+5V_(Input)), J7.85 (+5V_(Input)), J7.87 (+5V_(Input))
unnamed: J7.78 (GPIO_VREF), R66.2, R67.2
unnamed: J7.84 (CM4_3.3V_(Output)), J7.86 (CM4_3.3V_(Output))
unnamed: J7.88 (CM4_1.8V_(Output)), J7.90 (CM4_1.8V_(Output))
unnamed: J7.89 (WL_nDisable), TP4.1
unnamed: J7.91 (BT_nDisable), TP5.1
unnamed: J7.93 (nRPIBOOT), TP6.1
unnamed: J8.107 (GND), J8.113 (GND), J8.119 (GND), J8.125 (GND), J8.131 (GND), J8.137 (GND), J8.155 (GND), J8.161 (GND), J8.167 (GND), J8.173 (GND), J8.179 (GND), J8.185 (GND), J8.191 (GND), J8.197 (GND)
unnamed: J8.108 (GND), J8.114 (GND), J8.120 (GND), J8.126 (GND), J8.132 (GND), J8.138 (GND), J8.144 (GND), J8.150 (GND), J8.156 (GND), J8.162 (GND), J8.168 (GND), J8.174 (GND), J8.180 (GND), J8.186 (GND), J8.192 (GND), J8.198 (GND)
unnamed: S1.1, S1.2, U4.4 (Y)
PCIe_CLKREQ: J8.102 (PCIe_CLK_nREQ), R69.1, R70.1
PCIe_PERST: J8.109 (PCIe_nRST)
PCIe_REFCLK_N: J8.112 (PCIe_CLK_N)
PCIe_REFCLK_P: J8.110 (PCIe_CLK_P)
PCIe_RX0_N: J8.124 (PCIe_TX_N)
PCIe_RX0_P: J8.122 (PCIe_TX_P)
PCIe_TX0_N: J8.118 (PCIe_RX_N)
PCIe_TX0_P: J8.116 (PCIe_RX_P)
PI_~{EXTRST: J7.100 (nEXTRST)
Pi_Activity: D1.1, J7.21 (Pi_nLED_Activity)
Power_LED: J7.95 (PI_LED_nPWR), U3.2 (A)
RUN_PG: J7.92 (RUN_PG), U4.2 (A)
SCL_0: J7.80 (SCL0), TP2.1
SDA_0: J7.82 (SDA0), TP3.1
SMI_SA0: J7.34 (GPIO5)
SMI_SA1: J7.54 (GPIO4)
SMI_SA2: J7.56 (GPIO3)
SMI_SA3: J7.58 (GPIO2)
SMI_SA4: J7.36 (ID_SD)
SMI_SA5: J7.35 (ID_SC)
SMI_SD0: J7.39 (GPIO8)
SMI_SD1: J7.40 (GPIO9)
SMI_SD2: J7.44 (GPIO10)
SMI_SD3: J7.38 (GPIO11)
SMI_SD4: J7.31 (GPIO12)
SMI_SD5: J7.28 (GPIO13)
SMI_SD6: J7.55 (GPIO14)
SMI_SD7: J7.51 (GPIO15)
SMI_SD8: J7.29 (GPIO16)
SMI_SD9: J7.50 (GPIO17)
SMI_SD10: J7.49 (GPIO18)
SMI_SD11: J7.26 (GPIO19)
SMI_SD12: J7.27 (GPIO20)
SMI_SD13: J7.25 (GPIO21)
SMI_SD14: J7.46 (GPIO22)
SMI_SD15: J7.47 (GPIO23)
SMI_SD16: J7.45 (GPIO24)
SMI_SD17: J7.41 (GPIO25)
SMI_SOE_N/SE: J7.30 (GPIO6)
SMI_SWE_N/SRW_N: J7.37 (GPIO7)

Notes on the sheet:
++CONFIDENTIAL++
von:
HARNESS: CM4_PCIe_Link
${REVISION1}
${##}
HARNESS: CM4_USB_HOST
${#}
DNP
Blatt:
Revision:
high ->cpu runs
Datum:
HARNESS: CM4_SMI
HARNESS: CM4_GBE
${CURRENT_DATE}
Power
Entwickler:
Elektronik- und Softwareentwicklung aus Nürnberg
mail@pcb-arts.com
HARNESS: CM4_µSD
Title:
Activity
Checked:
low ->cpu sleep
${CURRENTTIME}
${CHECKED}
https://pcb-arts.com/
The information contained in these documents is confidential, privileged and only for the information of the intended recipient and may not be used, published or redistributed without the prior written consent from PCB Arts GmbH.
${FILENAME}
Zeit:
${ENTWICKLER}
HARNESS: CM4_HDMI
