pcbarts/fast-open-switch-hardware/fast-open-switch r1.0 - KiCad/Raspberry Pi CM4_Periphery.kicad_sch

## KiCad design fast-open-switch r1.0 - KiCad/Raspberry Pi CM4_Periphery.kicad_sch (2023-05-11)

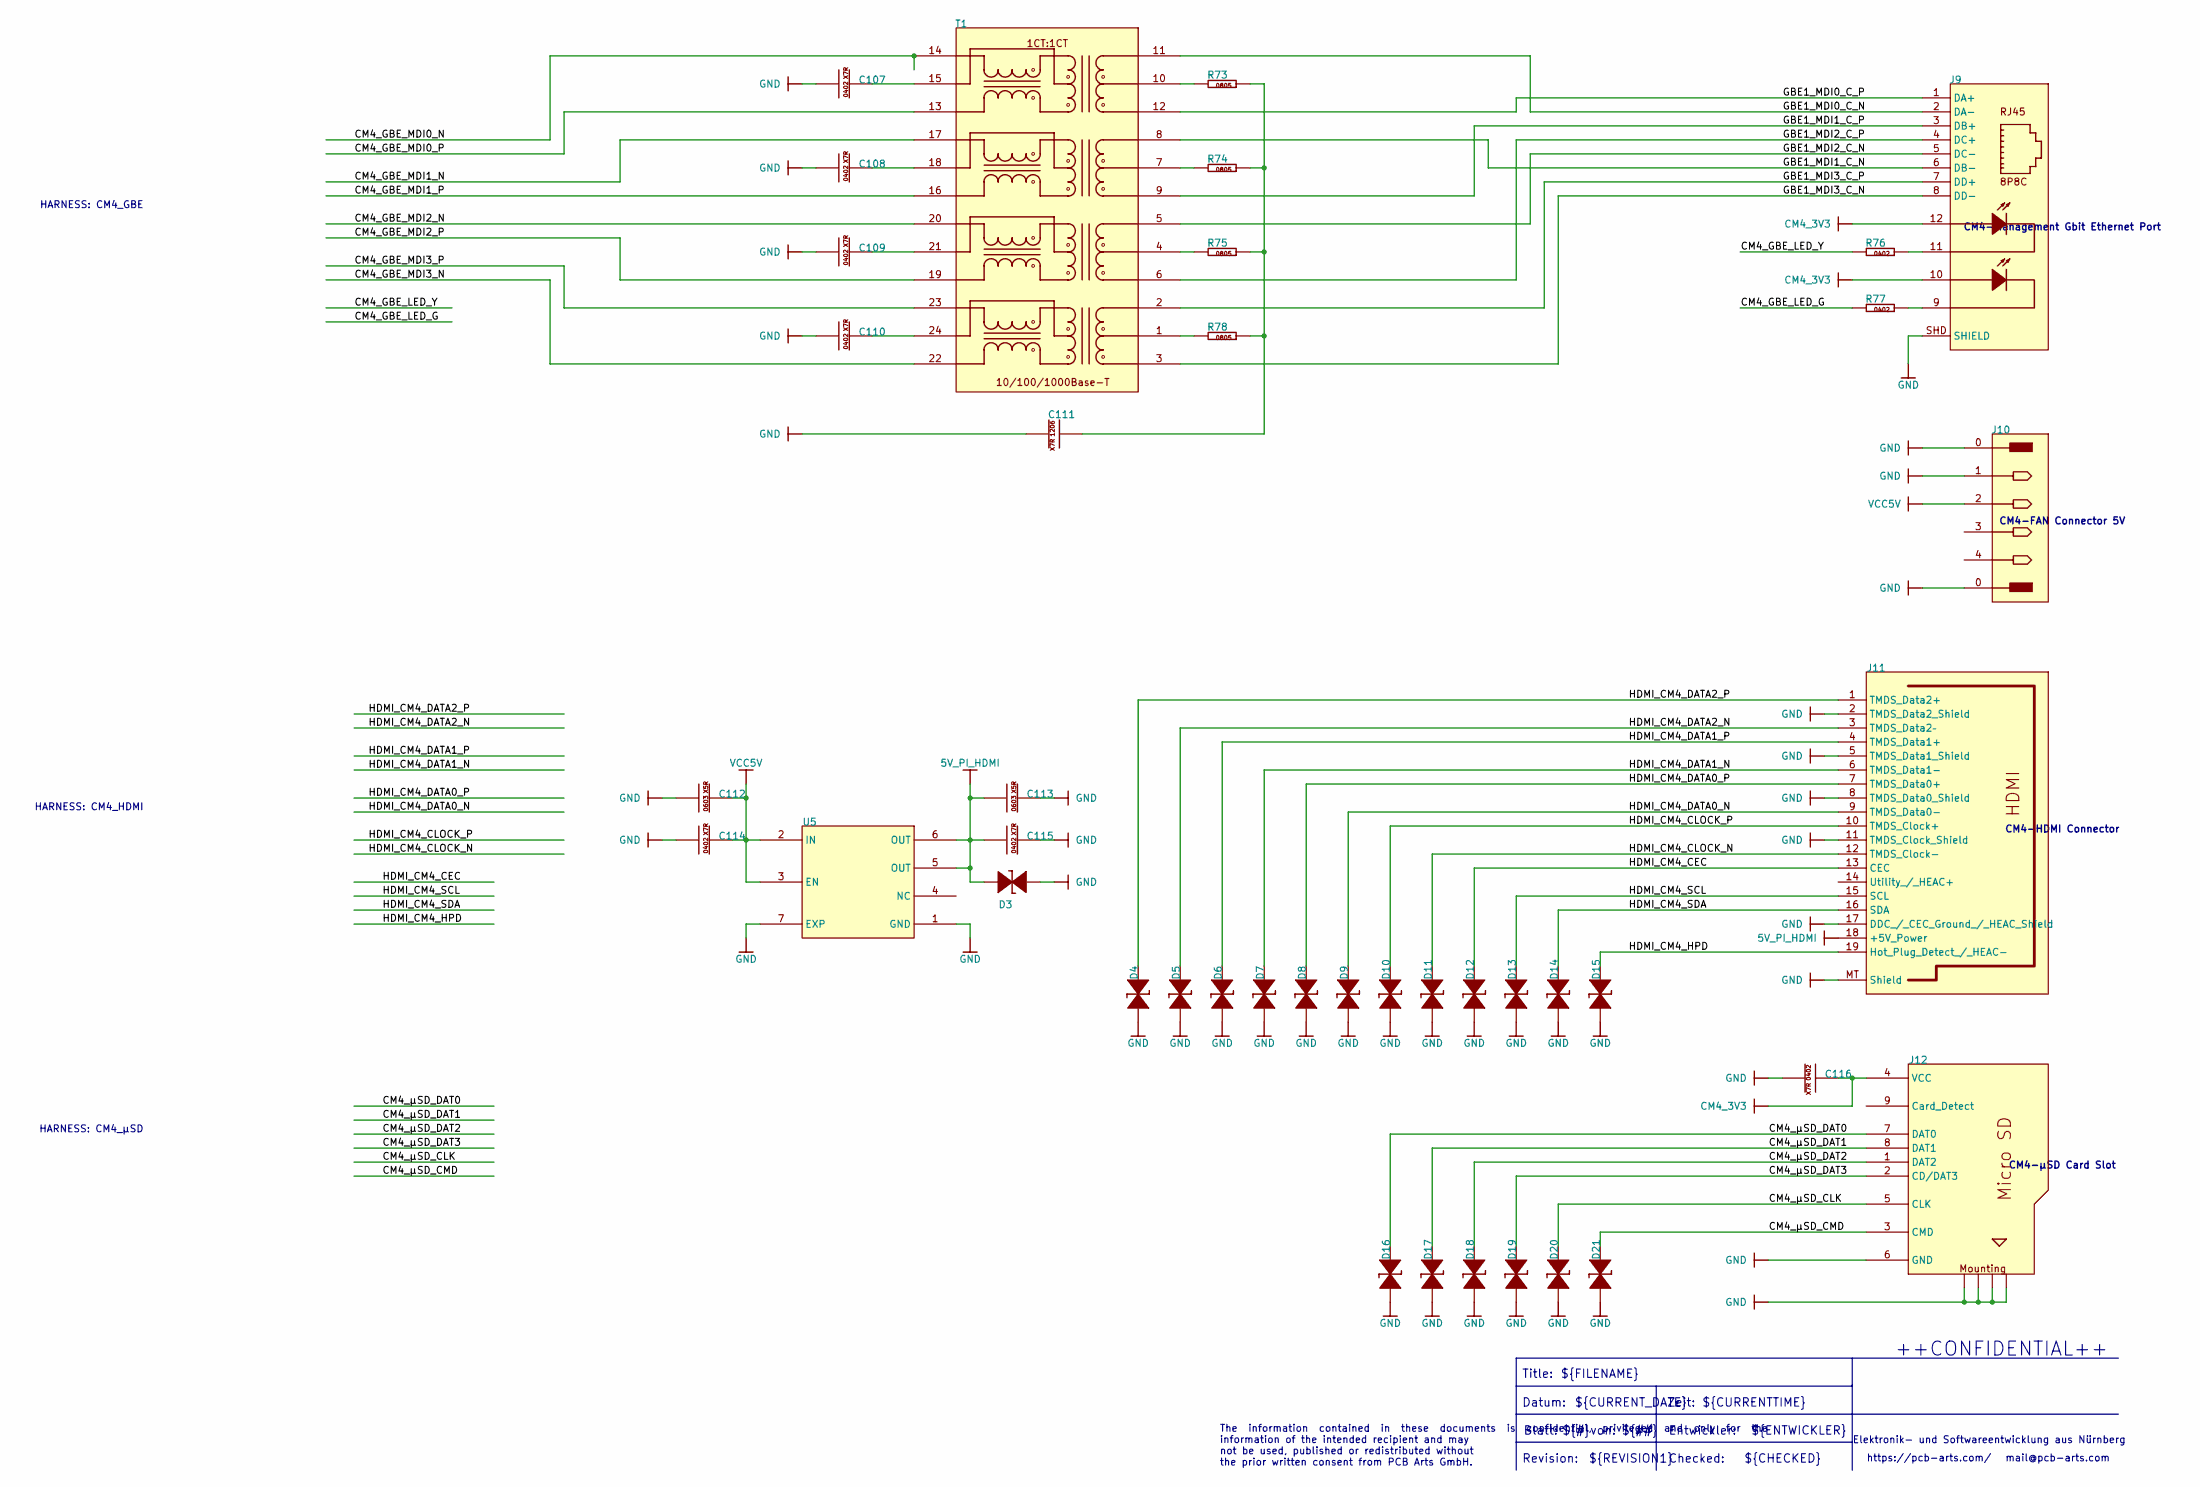
[picture p80: schematic Raspberry Pi CM4_Periphery.kicad_sch]

Parts:
C107, C108, C109, C110, C114, C115, C116: CAP_0402_L
C111: CAP_1206
C112, C113: CAP_0603_L
D3, D4, D5, D6, D7, D8, D9, D10, D11, D12, D13, D14, D15, D16, D17, D18, D19, D20, D21: TVS_0402
J9: Ckmtw - R-RJ45R08P-C000
J10: Molex 53398-0476
J11: Elecbee EB-500-6007
J12: TF-115
R73, R74, R75, R78: RES_0805
R76, R77: RES_0402_L
T1: QT24A01
U5: QFN50P201X181X60_HS-7N

Connections:
CM4_GBE_LED_G: R77.1
CM4_GBE_LED_Y: R76.1
CM4_GBE_MDI0_N: T1.14 (MX4+)
CM4_GBE_MDI0_P: T1.13 (MX4-)
CM4_GBE_MDI1_N: T1.17 (MX3+)
CM4_GBE_MDI1_P: T1.16 (MX3-)
CM4_GBE_MDI2_N: T1.20 (MX2+)
CM4_GBE_MDI2_P: T1.19 (MX2-)
CM4_GBE_MDI3_N: T1.22 (MX1-)
CM4_GBE_MDI3_P: T1.23 (MX1+)
CM4_µSD_CLK: D20.2, J12.5 (CLK)
CM4_µSD_CMD: D21.2, J12.3 (CMD)
CM4_µSD_DAT0: D16.2, J12.7 (DAT0)
CM4_µSD_DAT1: D17.2, J12.8 (DAT1)
CM4_µSD_DAT2: D18.2, J12.1 (DAT2)
CM4_µSD_DAT3: D19.2, J12.2 (CD/DAT3)
GBE1_MDI0_C_N: J9.2 (DA-), T1.11 (TD4+)
GBE1_MDI0_C_P: J9.1 (DA+), T1.12 (TD4-)
GBE1_MDI1_C_N: J9.6 (DB-), T1.8 (TD3+)
GBE1_MDI1_C_P: J9.3 (DB+), T1.9 (TD3-)
GBE1_MDI2_C_N: J9.5 (DC-), T1.5 (TD2+)
GBE1_MDI2_C_P: J9.4 (DC+), T1.6 (TD2-)
GBE1_MDI3_C_N: J9.8 (DD-), T1.3 (TD1-)
GBE1_MDI3_C_P: J9.7 (DD+), T1.2 (TD1+)
HDMI_CM4_CEC: D12.2, J11.13 (CEC)
HDMI_CM4_CLOCK_N: D11.2, J11.12 (TMDS_Clock-)
HDMI_CM4_CLOCK_P: D10.2, J11.10 (TMDS_Clock+)
HDMI_CM4_DATA0_N: D9.2, J11.9 (TMDS_Data0-)
HDMI_CM4_DATA0_P: D8.2, J11.7 (TMDS_Data0+)
HDMI_CM4_DATA1_N: D7.2, J11.6 (TMDS_Data1-)
HDMI_CM4_DATA1_P: D6.2, J11.4 (TMDS_Data1+)
HDMI_CM4_DATA2_N: D5.2, J11.3 (TMDS_Data2–)
HDMI_CM4_DATA2_P: D4.2, J11.1 (TMDS_Data2+)
HDMI_CM4_HPD: D15.2, J11.19 (Hot_Plug_Detect_/_HEAC-)
HDMI_CM4_SCL: D13.2, J11.15 (SCL)
HDMI_CM4_SDA: D14.2, J11.16 (SDA)
unnamed: C107.2, T1.15 (MCT4)
unnamed: C108.2, T1.18 (MCT3)
unnamed: C109.2, T1.21 (MCT2)
unnamed: C110.2, T1.24 (MCT1)
unnamed: C111.1, R73.2, R74.2, R75.2, R78.2
unnamed: C112.2, C114.2, U5.2 (IN), U5.3 (EN)
unnamed: C113.1, C115.1, D3.1, U5.5 (OUT), U5.6 (OUT)
unnamed: C116.1, J12.4 (VCC)
unnamed: J9.9, R77.2
unnamed: J9.11, R76.2
unnamed: J12.10, J12.11, J12.12, J12.13
unnamed: R73.1, T1.10 (TCT4)
unnamed: R74.1, T1.7 (TCT3)
unnamed: R75.1, T1.4 (TCT2)
unnamed: R78.1, T1.1 (TCT1)

Notes on the sheet:
${CURRENTTIME}
${REVISION1}
Checked:
Revision:
HARNESS: CM4_GBE
Zeit:
Blatt:
CM4-µSD Card Slot
https://pcb-arts.com/
++CONFIDENTIAL++
${CHECKED}
${CURRENT_DATE}
The information contained in these documents is confidential, privileged and only for the information of the intended recipient and may not be used, published or redistributed without the prior written consent from PCB Arts GmbH.
${##}
Datum:
HARNESS: CM4_HDMI
CM4-HDMI Connector
Elektronik- und Softwareentwicklung aus Nürnberg
${ENTWICKLER}
CM4-Management Gbit Ethernet Port
Title:
von:
mail@pcb-arts.com
${#}
CM4-FAN Connector 5V
HARNESS: CM4_µSD
${FILENAME}
Entwickler:
