pcbarts/fast-open-switch-hardware/fast-open-switch r1.0 - KiCad/SFP+_Connectors.kicad_sch

## KiCad design fast-open-switch r1.0 - KiCad/SFP+_Connectors.kicad_sch (2023-05-11)

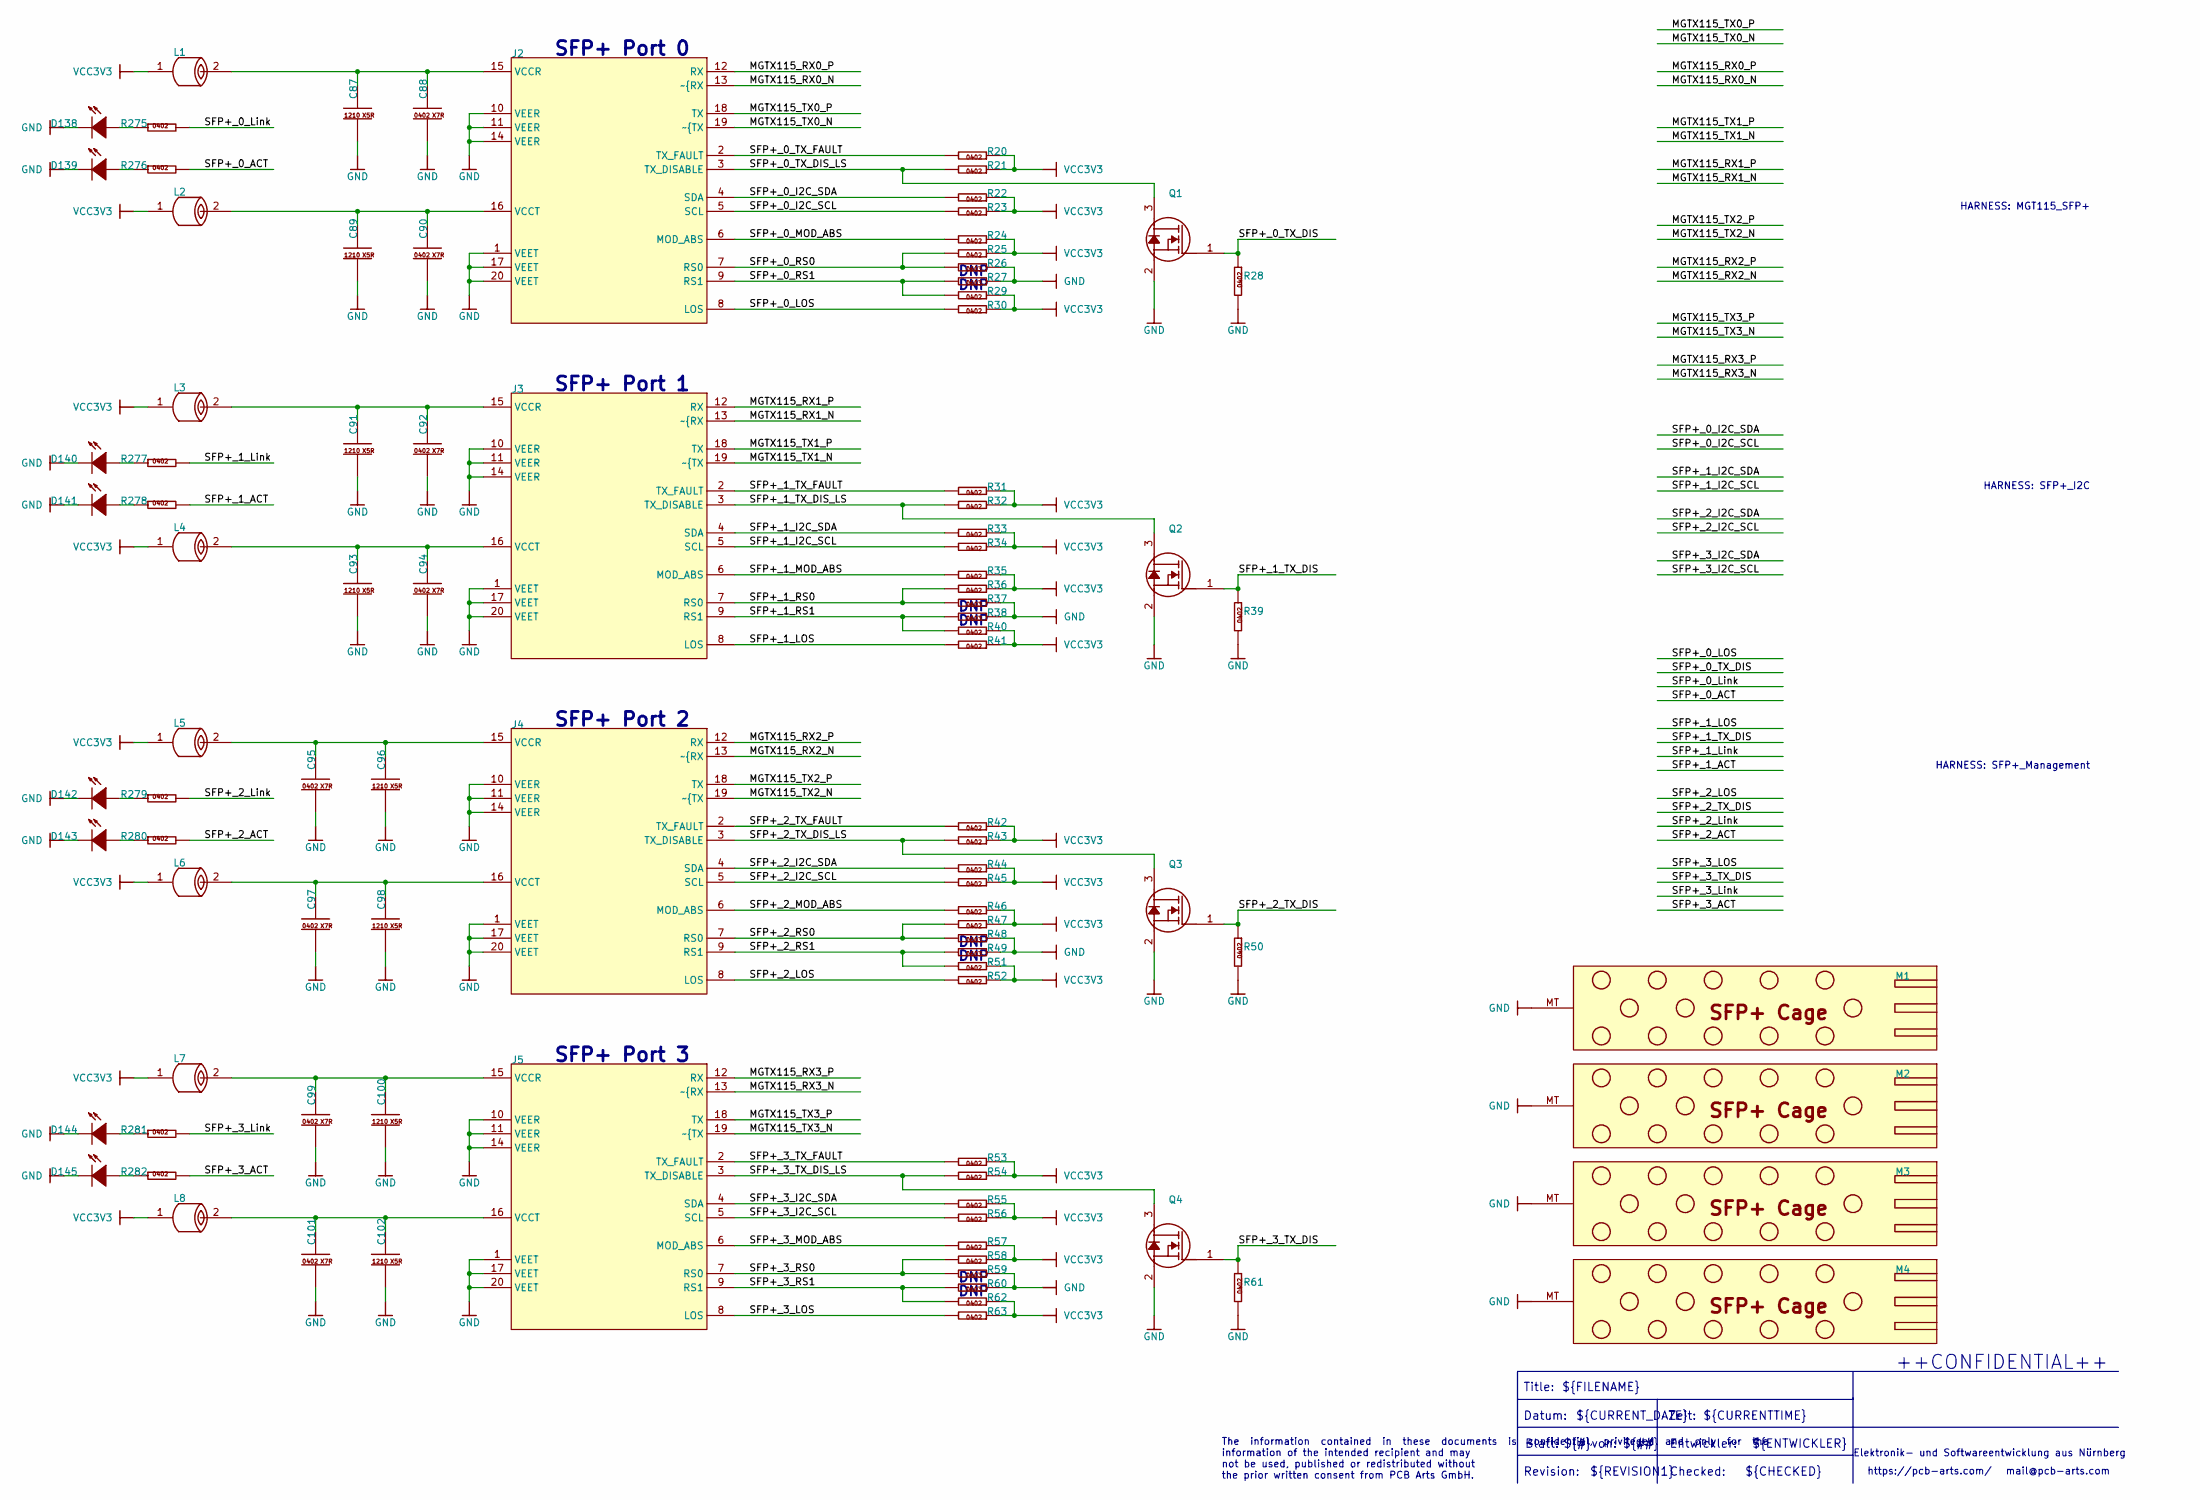
[picture p81: schematic SFP+_Connectors.kicad_sch]

Parts:
C87, C89, C91, C93, C96, C98, C100, C102: CAP_1210
C88, C90, C92, C94, C95, C97, C99, C101: CAP_0402_L
D138, D139, D140, D141, D142, D143, D144, D145: LED-0603 Sideview
J2, J3, J4, J5: 74441-0010
L1, L2, L3, L4, L5, L6, L7, L8: L_0603
M1, M2, M3, M4: 2007198-1
Q1, Q2, Q3, Q4: SOT95P251X112-3N
R20, R21, R22, R23, R24, R25, R28, R29, R30, R31, R32, R33, R34, R35, R36, R39, R40, R41, R42, R43, R44, R45, R46, R47, R50, R51, R52, R53, R54, R55, R56, R57, R58, R61, R62, R63, R275, R276, R277, R278, R279, R280, R281, R282: RES_0402_L
R26, R27, R37, R38, R48, R49, R59, R60: RES_0603_L

Connections:
MGTX115_RX0_N: J2.13 (~{RX)
MGTX115_RX0_P: J2.12 (RX)
MGTX115_RX1_N: J3.13 (~{RX)
MGTX115_RX1_P: J3.12 (RX)
MGTX115_RX2_N: J4.13 (~{RX)
MGTX115_RX2_P: J4.12 (RX)
MGTX115_RX3_N: J5.13 (~{RX)
MGTX115_RX3_P: J5.12 (RX)
MGTX115_TX0_N: J2.19 (~{TX)
MGTX115_TX0_P: J2.18 (TX)
MGTX115_TX1_N: J3.19 (~{TX)
MGTX115_TX1_P: J3.18 (TX)
MGTX115_TX2_N: J4.19 (~{TX)
MGTX115_TX2_P: J4.18 (TX)
MGTX115_TX3_N: J5.19 (~{TX)
MGTX115_TX3_P: J5.18 (TX)
unnamed: C87.1, C88.1, J2.15 (VCCR), L1.2
unnamed: C89.1, C90.1, J2.16 (VCCT), L2.2
unnamed: C91.1, C92.1, J3.15 (VCCR), L3.2
unnamed: C93.1, C94.1, J3.16 (VCCT), L4.2
unnamed: C95.1, C96.1, J4.15 (VCCR), L5.2
unnamed: C97.1, C98.1, J4.16 (VCCT), L6.2
unnamed: C99.1, C100.1, J5.15 (VCCR), L7.2
unnamed: C101.1, C102.1, J5.16 (VCCT), L8.2
unnamed: D138.2, R275.2
unnamed: D139.2, R276.2
unnamed: D140.2, R277.2
unnamed: D141.2, R278.2
unnamed: D142.2, R279.2
unnamed: D143.2, R280.2
unnamed: D144.2, R281.2
unnamed: D145.2, R282.2
unnamed: J2.1 (VEET), J2.17 (VEET), J2.20 (VEET)
unnamed: J2.10 (VEER), J2.11 (VEER), J2.14 (VEER)
unnamed: J3.1 (VEET), J3.17 (VEET), J3.20 (VEET)
unnamed: J3.10 (VEER), J3.11 (VEER), J3.14 (VEER)
unnamed: J4.1 (VEET), J4.17 (VEET), J4.20 (VEET)
unnamed: J4.10 (VEER), J4.11 (VEER), J4.14 (VEER)
unnamed: J5.1 (VEET), J5.17 (VEET), J5.20 (VEET)
unnamed: J5.10 (VEER), J5.11 (VEER), J5.14 (VEER)
unnamed: R20.2, R21.2
unnamed: R22.2, R23.2
unnamed: R24.2, R25.2
unnamed: R26.2, R27.2
unnamed: R29.2, R30.2
unnamed: R31.2, R32.2
unnamed: R33.2, R34.2
unnamed: R35.2, R36.2
unnamed: R37.2, R38.2
unnamed: R40.2, R41.2
unnamed: R42.2, R43.2
unnamed: R44.2, R45.2
unnamed: R46.2, R47.2
unnamed: R48.2, R49.2
unnamed: R51.2, R52.2
unnamed: R53.2, R54.2
unnamed: R55.2, R56.2
unnamed: R57.2, R58.2
unnamed: R59.2, R60.2
unnamed: R62.2, R63.2
SFP+_0_ACT: R276.1
SFP+_0_I2C_SCL: J2.5 (SCL), R23.1
SFP+_0_I2C_SDA: J2.4 (SDA), R22.1
SFP+_0_LOS: J2.8 (LOS), R30.1
SFP+_0_Link: R275.1
SFP+_0_MOD_ABS: J2.6 (MOD_ABS), R24.1
SFP+_0_RS0: J2.7 (RS0), R25.1, R26.1
SFP+_0_RS1: J2.9 (RS1), R27.1, R29.1
SFP+_0_TX_DIS: Q1.1 (G), R28.2
SFP+_0_TX_DIS_LS: J2.3 (TX_DISABLE), Q1.3 (S), R21.1
SFP+_0_TX_FAULT: J2.2 (TX_FAULT), R20.1
SFP+_1_ACT: R278.1
SFP+_1_I2C_SCL: J3.5 (SCL), R34.1
SFP+_1_I2C_SDA: J3.4 (SDA), R33.1
SFP+_1_LOS: J3.8 (LOS), R41.1
SFP+_1_Link: R277.1
SFP+_1_MOD_ABS: J3.6 (MOD_ABS), R35.1
SFP+_1_RS0: J3.7 (RS0), R36.1, R37.1
SFP+_1_RS1: J3.9 (RS1), R38.1, R40.1
SFP+_1_TX_DIS: Q2.1 (G), R39.2
SFP+_1_TX_DIS_LS: J3.3 (TX_DISABLE), Q2.3 (S), R32.1
SFP+_1_TX_FAULT: J3.2 (TX_FAULT), R31.1
SFP+_2_ACT: R280.1
SFP+_2_I2C_SCL: J4.5 (SCL), R45.1
SFP+_2_I2C_SDA: J4.4 (SDA), R44.1
SFP+_2_LOS: J4.8 (LOS), R52.1
SFP+_2_Link: R279.1
SFP+_2_MOD_ABS: J4.6 (MOD_ABS), R46.1
SFP+_2_RS0: J4.7 (RS0), R47.1, R48.1
SFP+_2_RS1: J4.9 (RS1), R49.1, R51.1
SFP+_2_TX_DIS: Q3.1 (G), R50.2
SFP+_2_TX_DIS_LS: J4.3 (TX_DISABLE), Q3.3 (S), R43.1
SFP+_2_TX_FAULT: J4.2 (TX_FAULT), R42.1
SFP+_3_ACT: R282.1
SFP+_3_I2C_SCL: J5.5 (SCL), R56.1
SFP+_3_I2C_SDA: J5.4 (SDA), R55.1
SFP+_3_LOS: J5.8 (LOS), R63.1
SFP+_3_Link: R281.1
SFP+_3_MOD_ABS: J5.6 (MOD_ABS), R57.1
SFP+_3_RS0: J5.7 (RS0), R58.1, R59.1
SFP+_3_RS1: J5.9 (RS1), R60.1, R62.1
SFP+_3_TX_DIS: Q4.1 (G), R61.2
SFP+_3_TX_DIS_LS: J5.3 (TX_DISABLE), Q4.3 (S), R54.1
SFP+_3_TX_FAULT: J5.2 (TX_FAULT), R53.1

Notes on the sheet:
DNP
${#}
von:
${CHECKED}
The information contained in these documents is confidential, privileged and only for the information of the intended recipient and may not be used, published or redistributed without the prior written consent from PCB Arts GmbH.
Title:
SFP+ Port 2
Checked:
Zeit:
Entwickler:
https://pcb-arts.com/
HARNESS: SFP+_Management
SFP+ Port 0
SFP+ Port 1
${CURRENT_DATE}
++CONFIDENTIAL++
${CURRENTTIME}
mail@pcb-arts.com
HARNESS: MGT115_SFP+
Elektronik- und Softwareentwicklung aus Nürnberg
${FILENAME}
Datum:
${REVISION1}
SFP+ Port 3
${##}
Blatt:
${ENTWICKLER}
HARNESS: SFP+_I2C
Revision:
