pcbarts/fast-open-switch-hardware/fast-open-switch r1.0 - KiCad/SMI Bank 12.kicad_sch

## KiCad design fast-open-switch r1.0 - KiCad/SMI Bank 12.kicad_sch (2023-05-11)

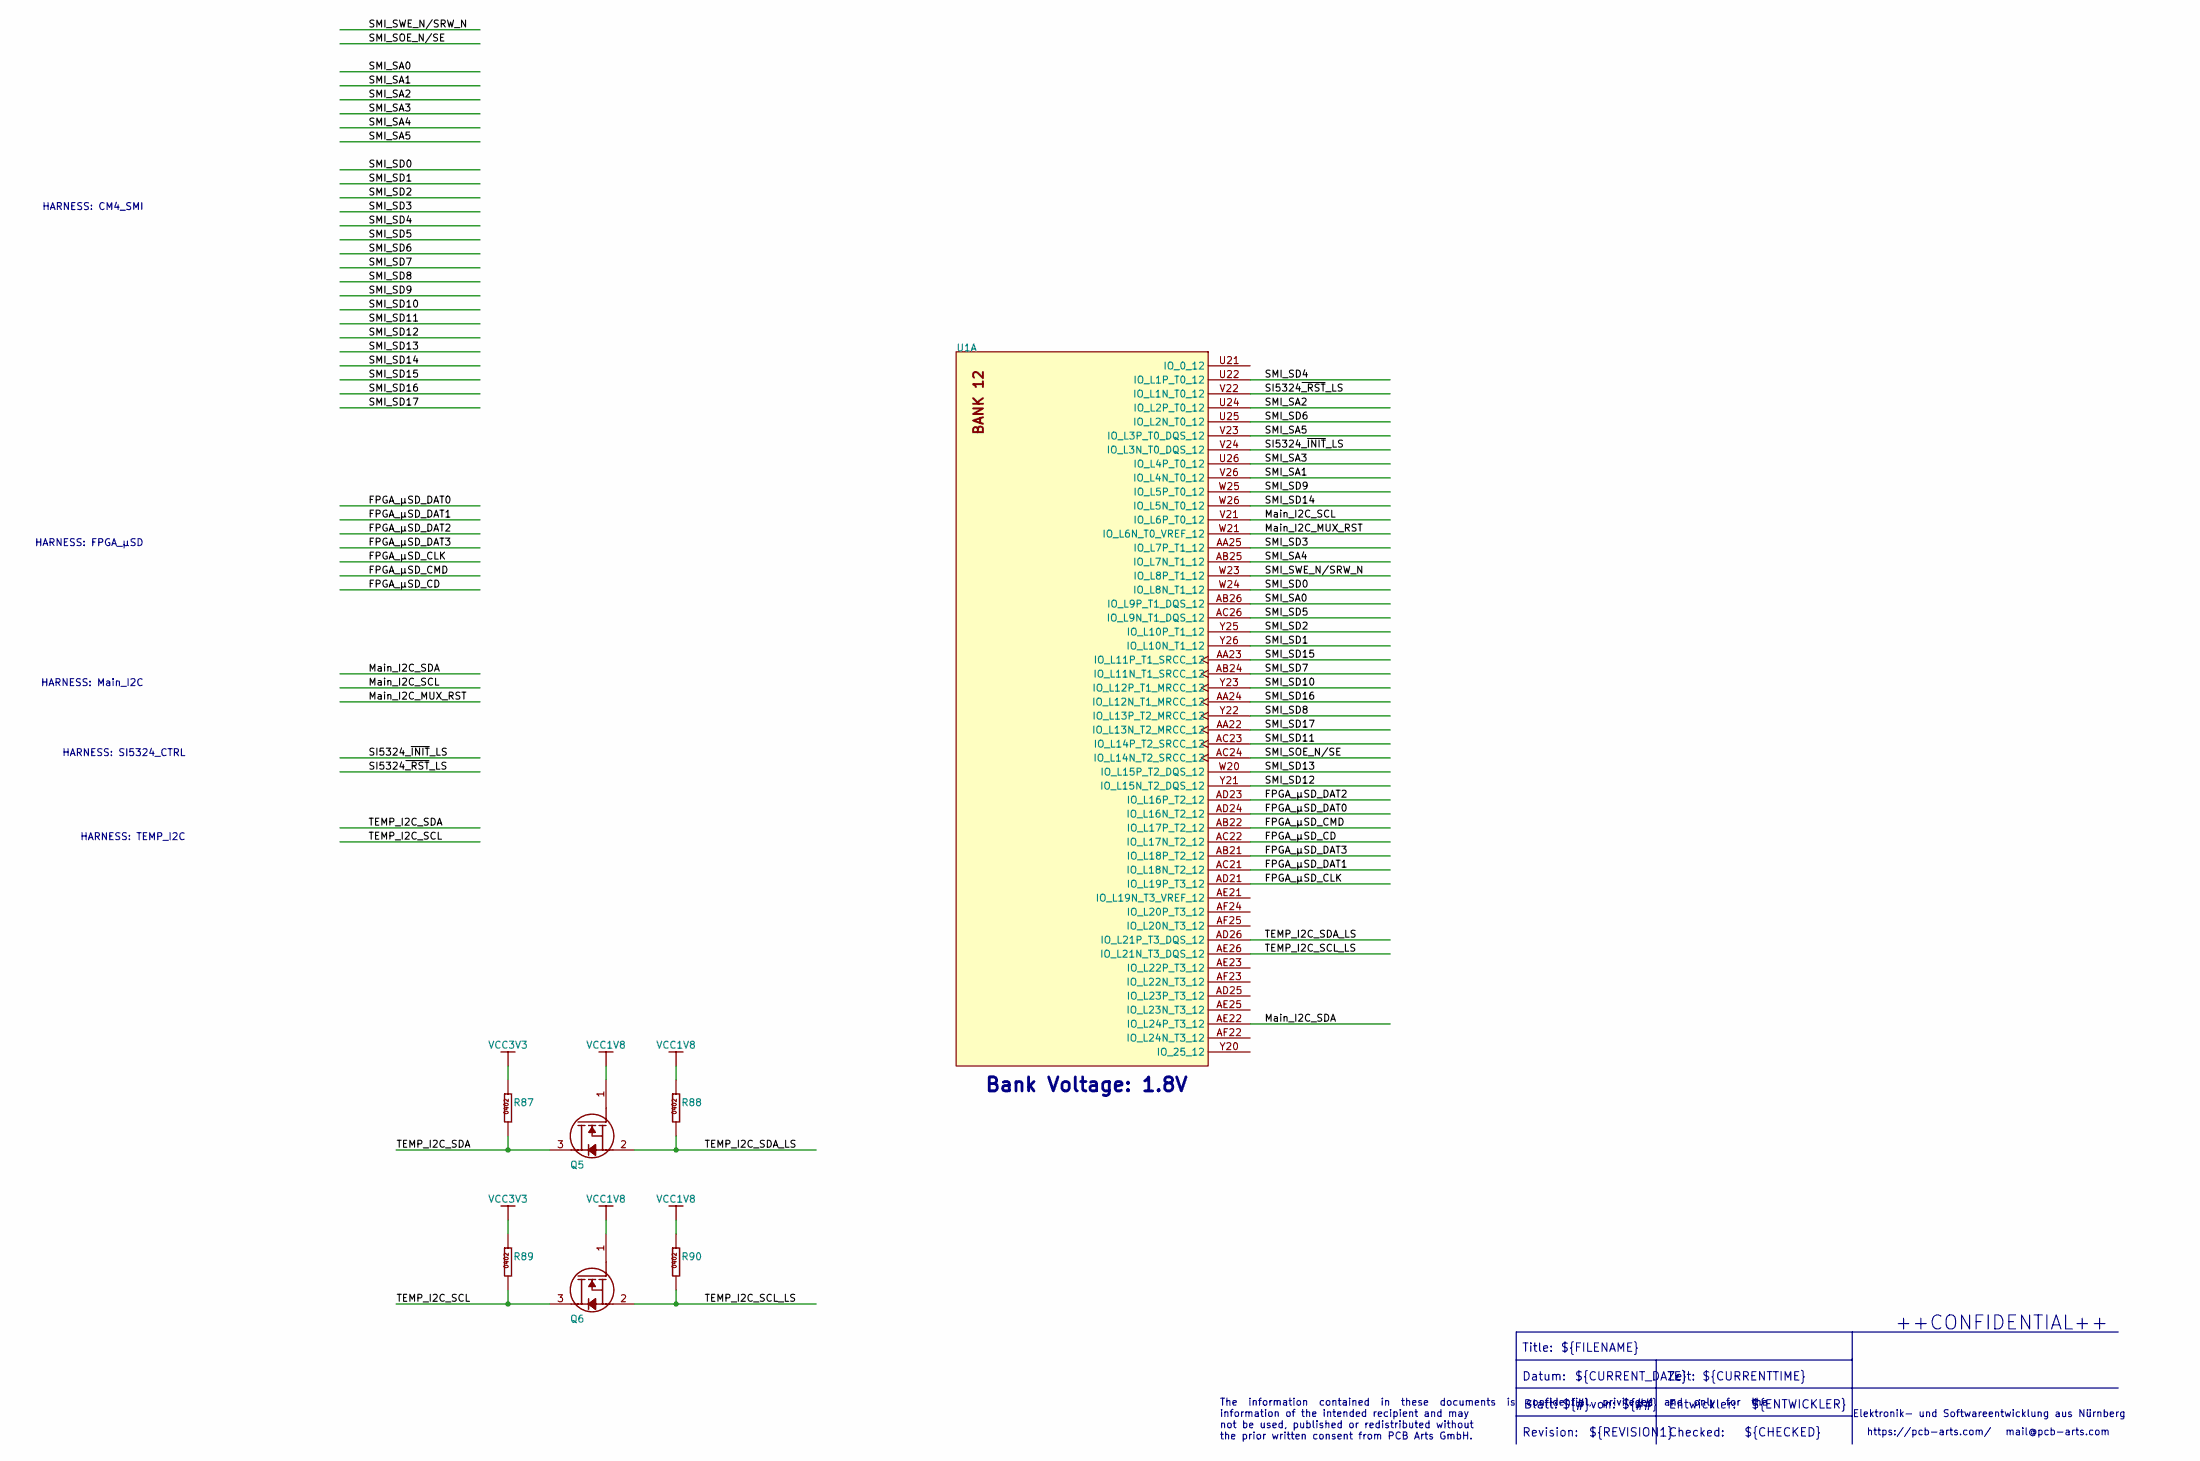
[picture p82: schematic SMI Bank 12.kicad_sch]

Parts:
Q5, Q6: SOT95P251X112-3N
R87, R88, R89, R90: RES_0402_L
U1: BGA100P2700X2700X317-676N

Connections:
FPGA_µSD_CD: U1.AC22 (IO_L17N_T2_12)
FPGA_µSD_CLK: U1.AD21 (IO_L19P_T3_12)
FPGA_µSD_CMD: U1.AB22 (IO_L17P_T2_12)
FPGA_µSD_DAT0: U1.AD24 (IO_L16N_T2_12)
FPGA_µSD_DAT1: U1.AC21 (IO_L18N_T2_12)
FPGA_µSD_DAT2: U1.AD23 (IO_L16P_T2_12)
FPGA_µSD_DAT3: U1.AB21 (IO_L18P_T2_12)
Main_I2C_MUX_RST: U1.W21 (IO_L6N_T0_VREF_12)
Main_I2C_SCL: U1.V21 (IO_L6P_T0_12)
Main_I2C_SDA: U1.AE22 (IO_L24P_T3_12)
SI5324_~INIT_LS: U1.V24 (IO_L3N_T0_DQS_12)
SI5324~_RST_LS: U1.V22 (IO_L1N_T0_12)
SMI_SA0: U1.AB26 (IO_L9P_T1_DQS_12)
SMI_SA1: U1.V26 (IO_L4N_T0_12)
SMI_SA2: U1.U24 (IO_L2P_T0_12)
SMI_SA3: U1.U26 (IO_L4P_T0_12)
SMI_SA4: U1.AB25 (IO_L7N_T1_12)
SMI_SA5: U1.V23 (IO_L3P_T0_DQS_12)
SMI_SD0: U1.W24 (IO_L8N_T1_12)
SMI_SD1: U1.Y26 (IO_L10N_T1_12)
SMI_SD2: U1.Y25 (IO_L10P_T1_12)
SMI_SD3: U1.AA25 (IO_L7P_T1_12)
SMI_SD4: U1.U22 (IO_L1P_T0_12)
SMI_SD5: U1.AC26 (IO_L9N_T1_DQS_12)
SMI_SD6: U1.U25 (IO_L2N_T0_12)
SMI_SD7: U1.AB24 (IO_L11N_T1_SRCC_12)
SMI_SD8: U1.Y22 (IO_L13P_T2_MRCC_12)
SMI_SD9: U1.W25 (IO_L5P_T0_12)
SMI_SD10: U1.Y23 (IO_L12P_T1_MRCC_12)
SMI_SD11: U1.AC23 (IO_L14P_T2_SRCC_12)
SMI_SD12: U1.Y21 (IO_L15N_T2_DQS_12)
SMI_SD13: U1.W20 (IO_L15P_T2_DQS_12)
SMI_SD14: U1.W26 (IO_L5N_T0_12)
SMI_SD15: U1.AA23 (IO_L11P_T1_SRCC_12)
SMI_SD16: U1.AA24 (IO_L12N_T1_MRCC_12)
SMI_SD17: U1.AA22 (IO_L13N_T2_MRCC_12)
SMI_SOE_N/SE: U1.AC24 (IO_L14N_T2_SRCC_12)
SMI_SWE_N/SRW_N: U1.W23 (IO_L8P_T1_12)
TEMP_I2C_SCL: Q6.3 (D), R89.1
TEMP_I2C_SCL_LS: Q6.2 (S), R90.1, U1.AE26 (IO_L21N_T3_DQS_12)
TEMP_I2C_SDA: Q5.3 (D), R87.1
TEMP_I2C_SDA_LS: Q5.2 (S), R88.1, U1.AD26 (IO_L21P_T3_DQS_12)

Notes on the sheet:
Title:
HARNESS: FPGA_µSD
Revision:
https://pcb-arts.com/
Datum:
Entwickler:
Elektronik- und Softwareentwicklung aus Nürnberg
The information contained in these documents is confidential, privileged and only for the information of the intended recipient and may not be used, published or redistributed without the prior written consent from PCB Arts GmbH.
${FILENAME}
${#}
HARNESS: CM4_SMI
${CHECKED}
Bank Voltage: 1.8V
mail@pcb-arts.com
Zeit:
HARNESS: Main_I2C
Blatt:
HARNESS: SI5324_CTRL
von:
${ENTWICKLER}
HARNESS: TEMP_I2C
${##}
${REVISION1}
++CONFIDENTIAL++
${CURRENT_DATE}
Checked:
${CURRENTTIME}
