pcbarts/fast-open-switch-hardware/fast-open-switch r1.0 - KiCad/SSD M.2_B-Key.kicad_sch

## KiCad design fast-open-switch r1.0 - KiCad/SSD M.2_B-Key.kicad_sch (2023-05-11)

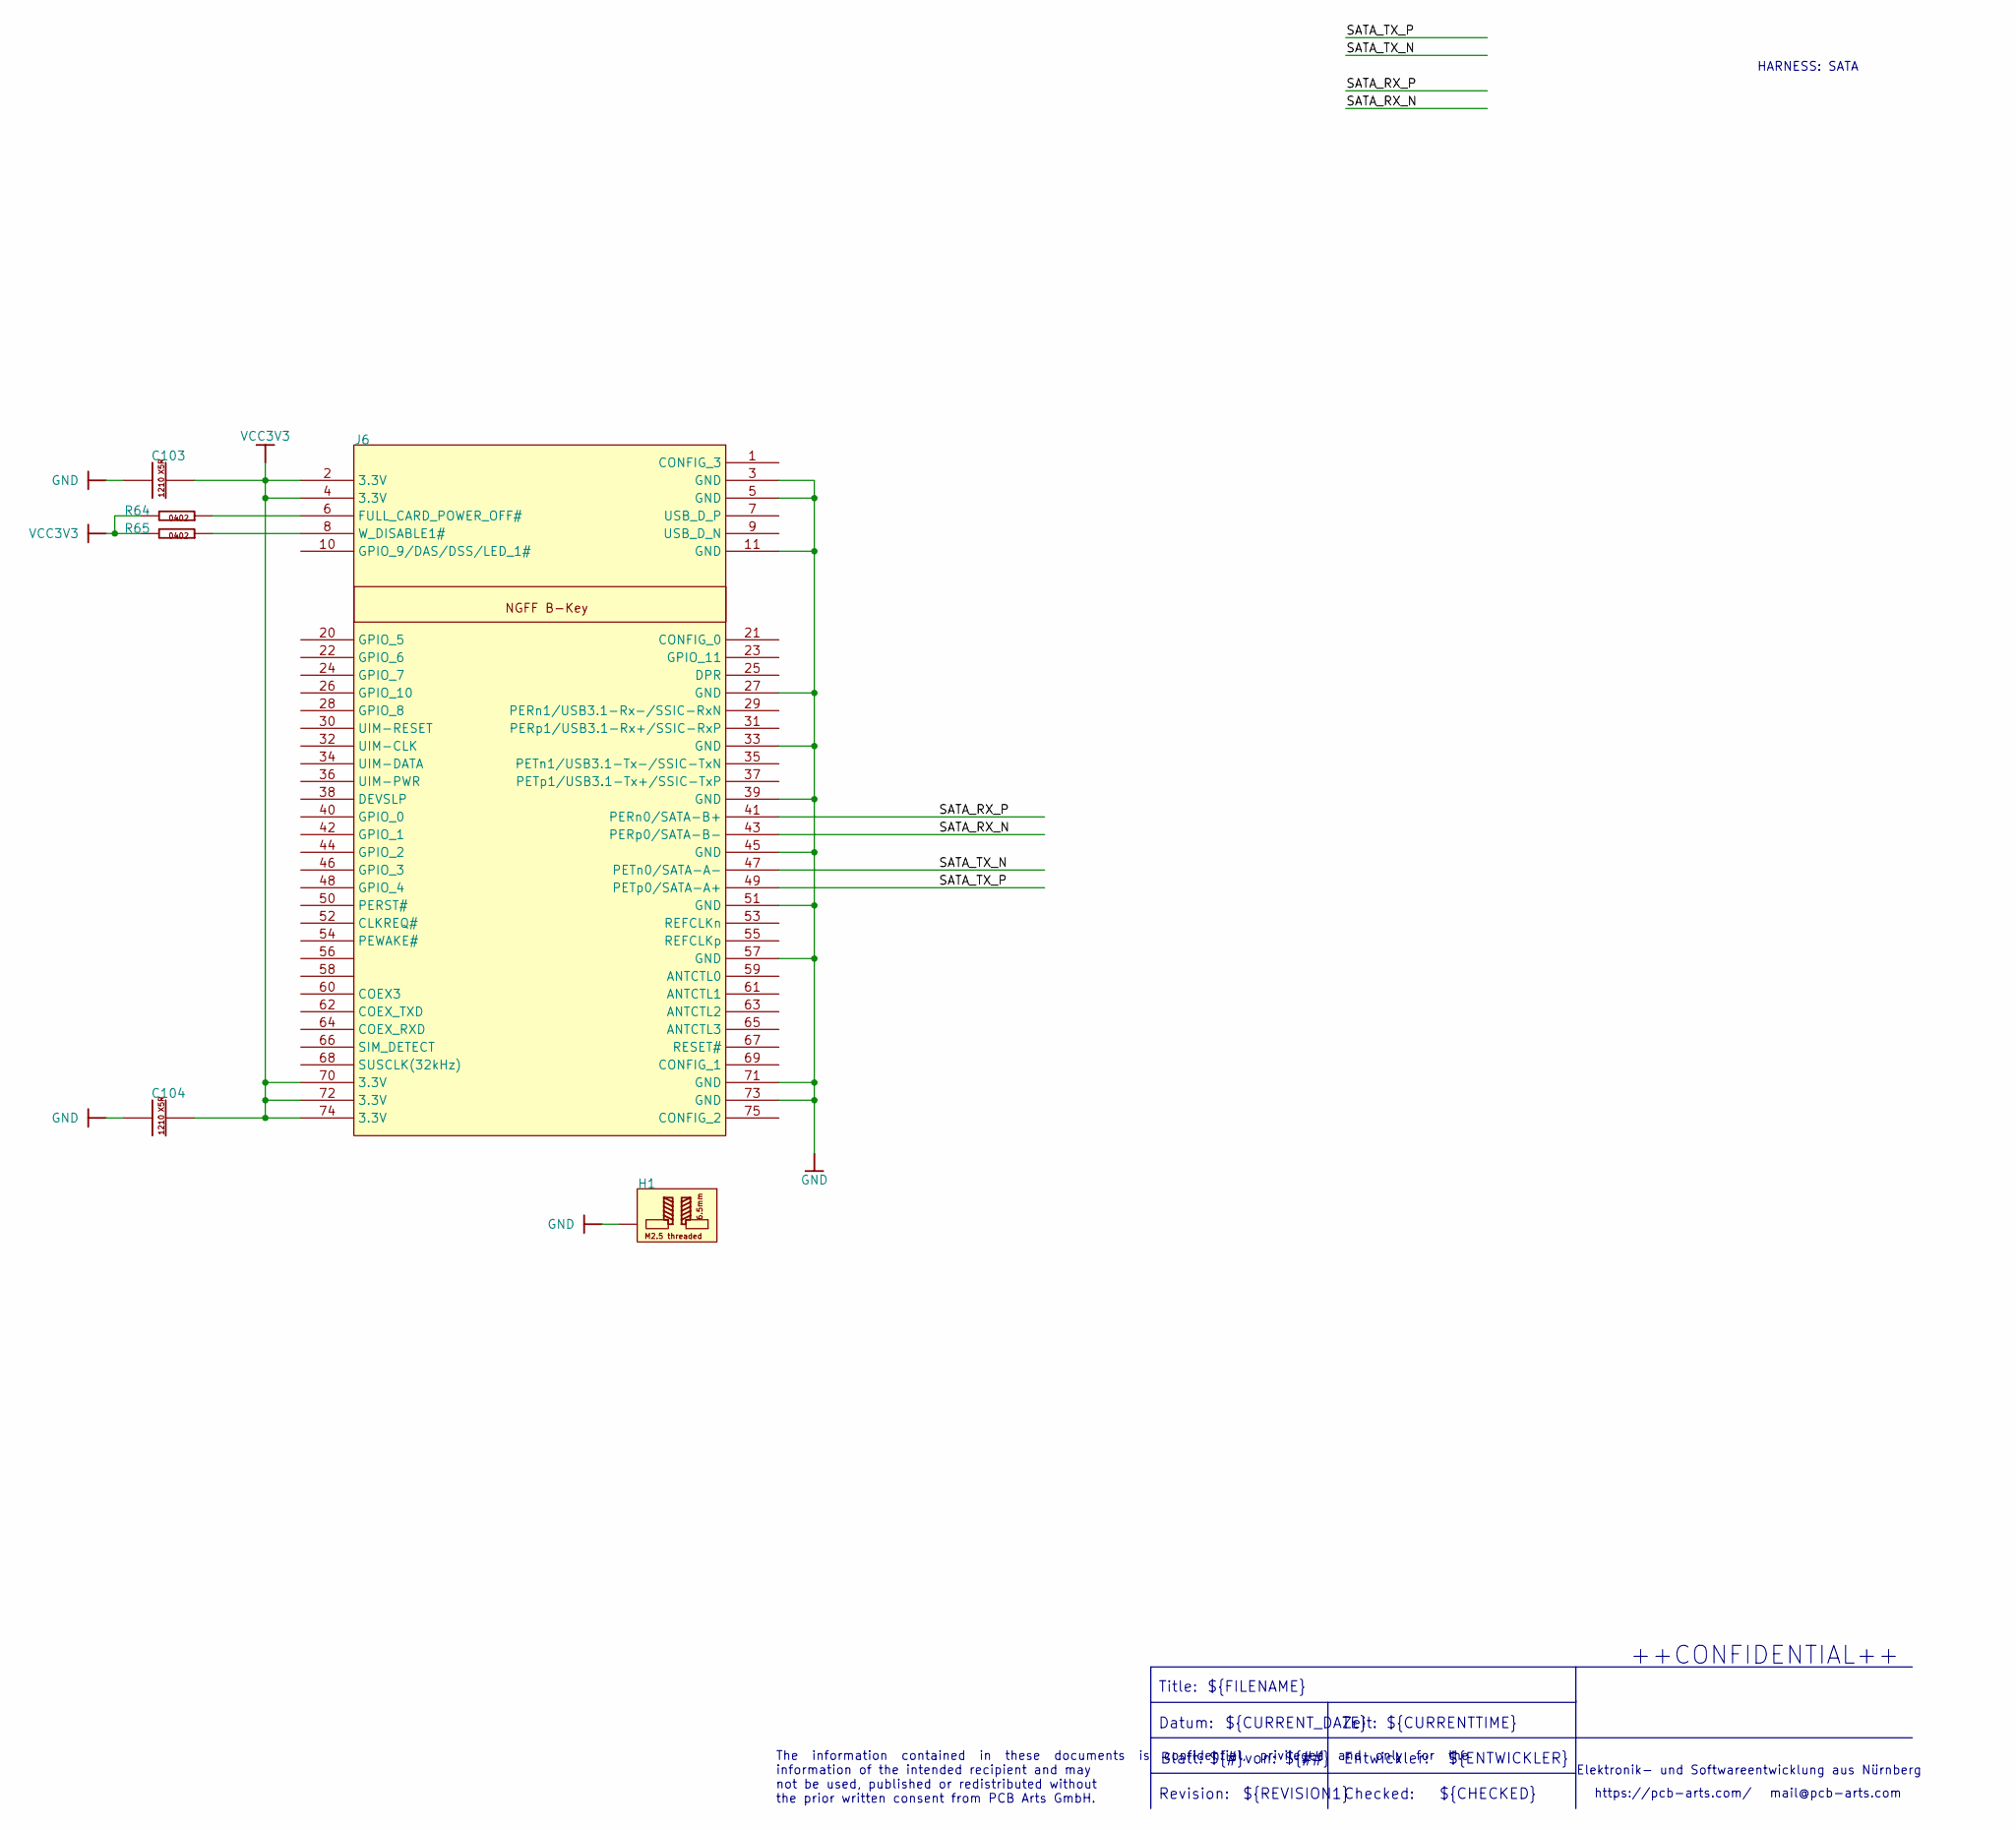
[picture p83: schematic SSD M.2_B-Key.kicad_sch]

Parts:
C103, C104: CAP_1210
H1: 9774065151R
J6: APCI0161-P001A
R64, R65: RES_0402_L

Connections:
unnamed: C103.2, C104.2, J6.2 (3.3V), J6.4 (3.3V), J6.70 (3.3V), J6.72 (3.3V), J6.74 (3.3V)
unnamed: J6.6 (FULL_CARD_POWER_OFF#), R64.2
unnamed: J6.8 (W_DISABLE1#), R65.2
unnamed: J6.3 (GND), J6.5 (GND), J6.11 (GND), J6.27 (GND), J6.33 (GND), J6.39 (GND), J6.45 (GND), J6.51 (GND), J6.57 (GND), J6.71 (GND), J6.73 (GND)
unnamed: R64.1, R65.1
SATA_RX_N: J6.43 (PERp0/SATA-B-)
SATA_RX_P: J6.41 (PERn0/SATA-B+)
SATA_TX_N: J6.47 (PETn0/SATA-A-)
SATA_TX_P: J6.49 (PETp0/SATA-A+)

Notes on the sheet:
Entwickler:
von:
Checked:
Title:
${#}
${REVISION1}
${CURRENT_DATE}
HARNESS: SATA
The information contained in these documents is confidential, privileged and only for the information of the intended recipient and may not be used, published or redistributed without the prior written consent from PCB Arts GmbH.
${CURRENTTIME}
Zeit:
mail@pcb-arts.com
Blatt:
Revision:
${FILENAME}
Elektronik- und Softwareentwicklung aus Nürnberg
https://pcb-arts.com/
${##}
${CHECKED}
Datum:
${ENTWICKLER}
++CONFIDENTIAL++
