pcbarts/fast-open-switch-hardware/fast-open-switch r1.0 - KiCad/Spare Pins.kicad_sch

## KiCad design fast-open-switch r1.0 - KiCad/Spare Pins.kicad_sch (2023-05-11)

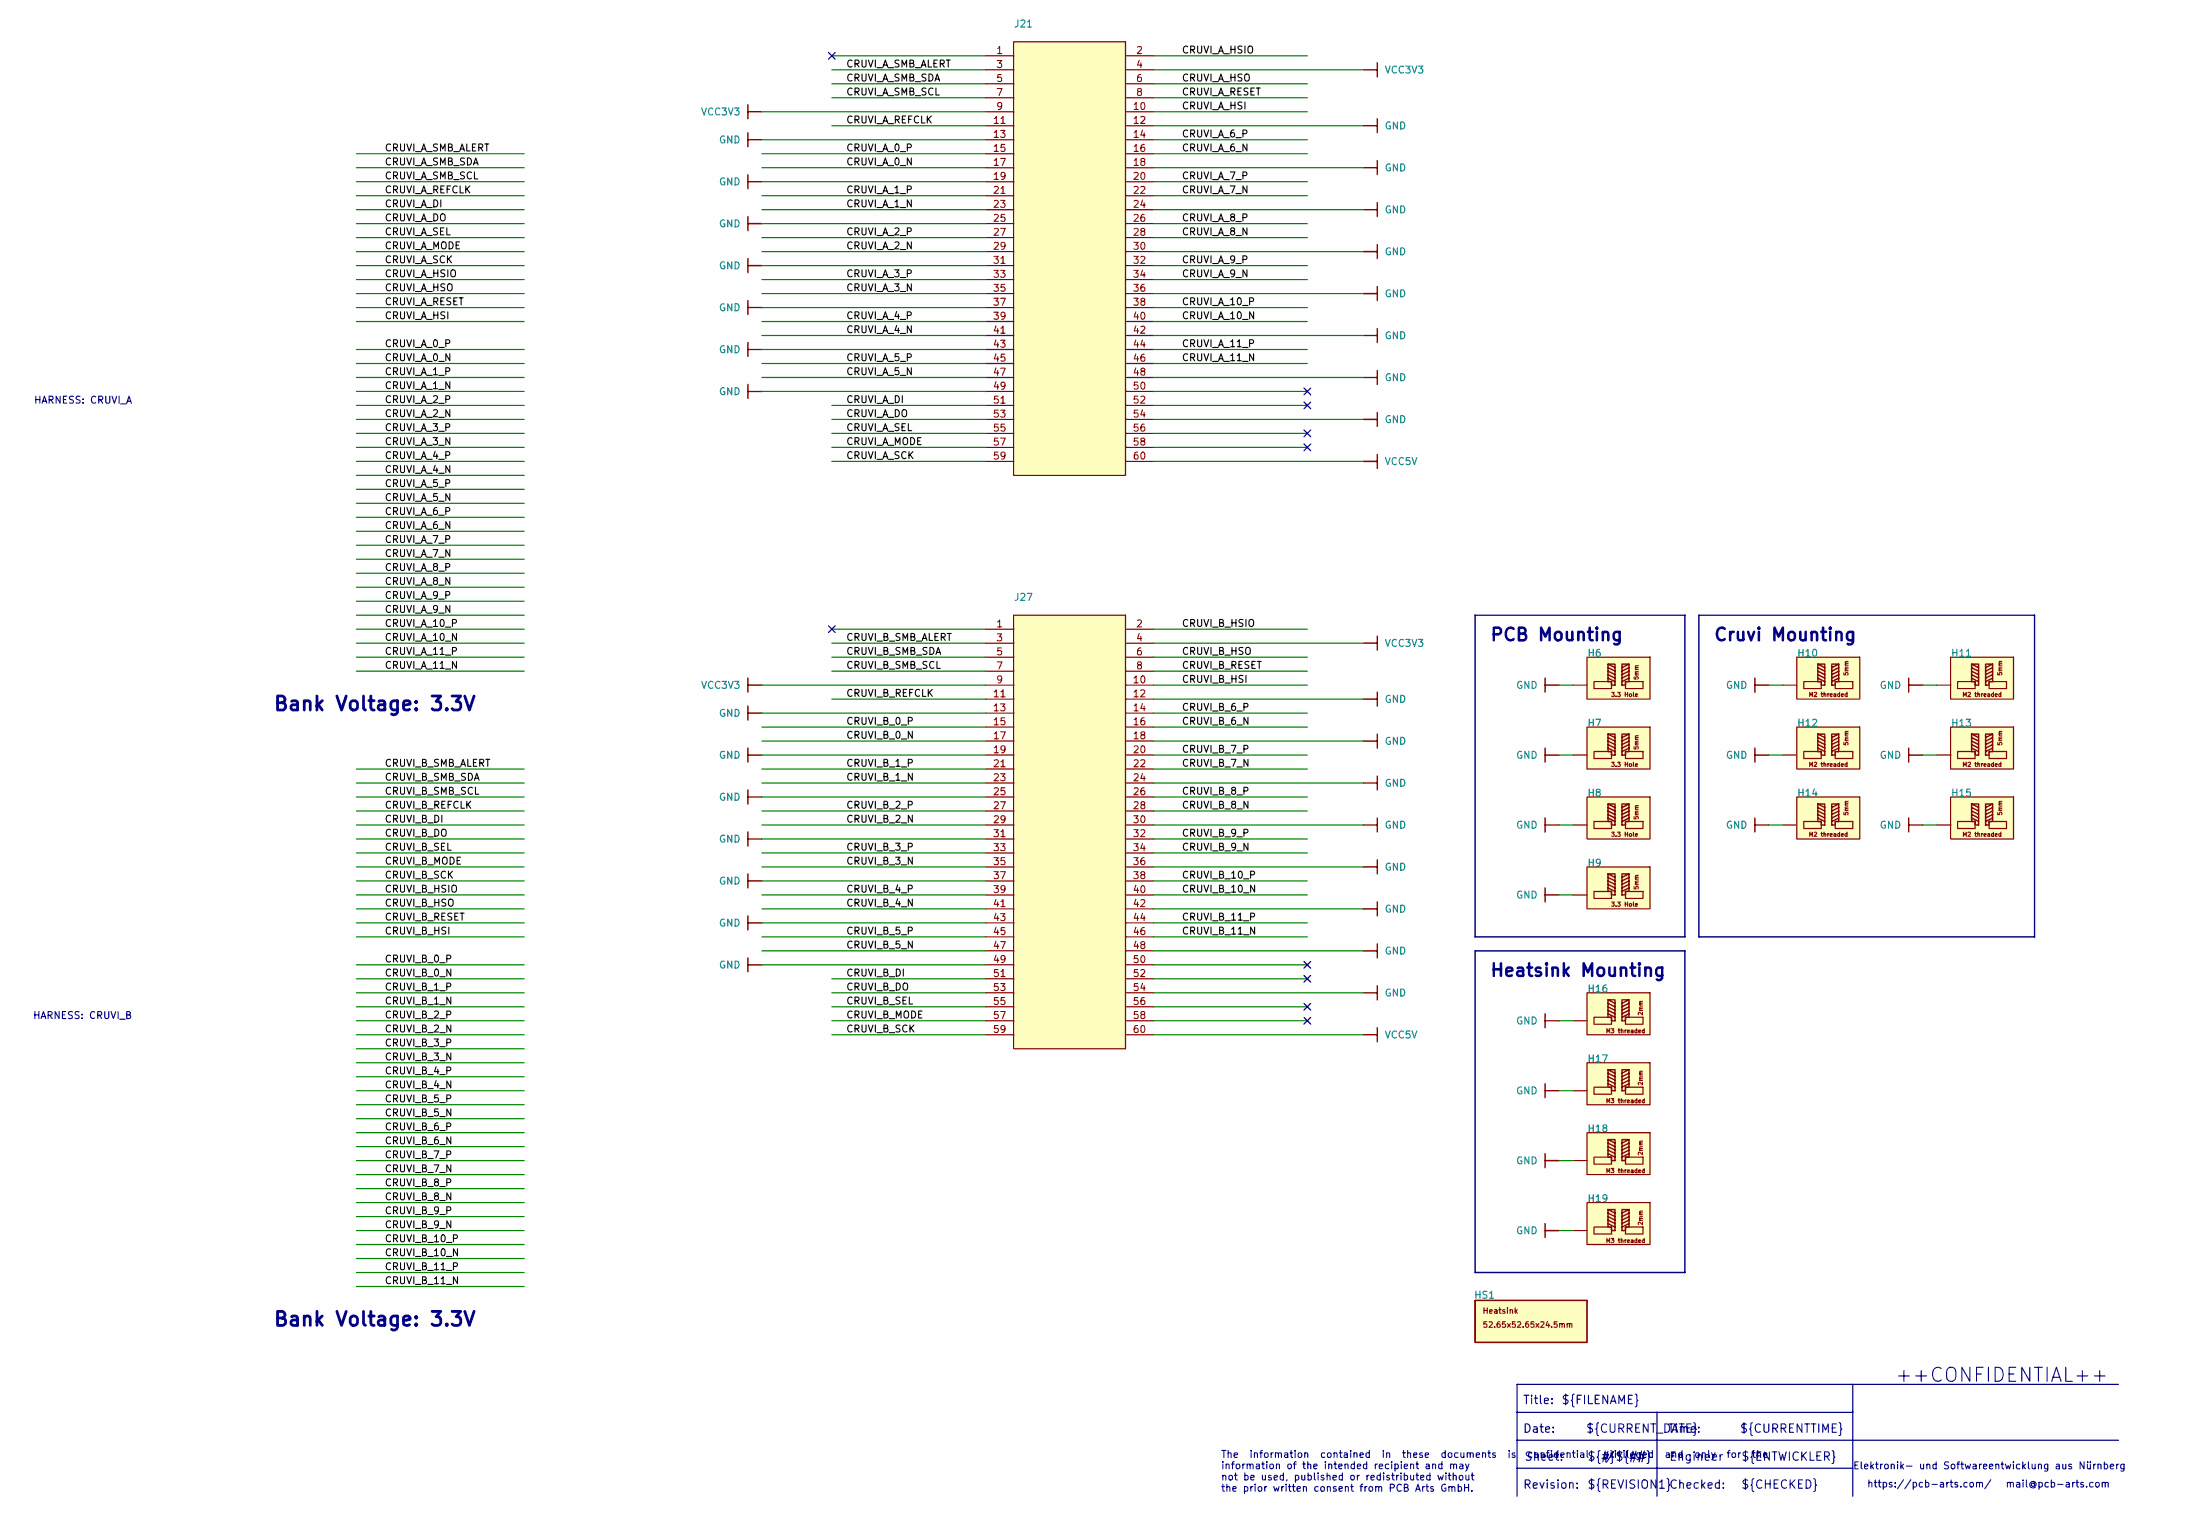
[picture p84: schematic Spare Pins.kicad_sch]

Parts:
H6, H7, H8, H9: 9774050960R
H10, H11, H12, H13, H14, H15: 9774050243R
H16, H17, H18, H19: 9774020360R
HS1: ATS-61500W-C2-R0
J21, J27: SS4-30-3.50-L-D-K-TR

Connections:
CRUVI_A_0_N: J21.17
CRUVI_A_0_P: J21.15
CRUVI_A_1_N: J21.23
CRUVI_A_1_P: J21.21
CRUVI_A_2_N: J21.29
CRUVI_A_2_P: J21.27
CRUVI_A_3_N: J21.35
CRUVI_A_3_P: J21.33
CRUVI_A_4_N: J21.41
CRUVI_A_4_P: J21.39
CRUVI_A_5_N: J21.47
CRUVI_A_5_P: J21.45
CRUVI_A_6_N: J21.16
CRUVI_A_6_P: J21.14
CRUVI_A_7_N: J21.22
CRUVI_A_7_P: J21.20
CRUVI_A_8_N: J21.28
CRUVI_A_8_P: J21.26
CRUVI_A_9_N: J21.34
CRUVI_A_9_P: J21.32
CRUVI_A_10_N: J21.40
CRUVI_A_10_P: J21.38
CRUVI_A_11_N: J21.46
CRUVI_A_11_P: J21.44
CRUVI_A_DI: J21.51
CRUVI_A_DO: J21.53
CRUVI_A_HSI: J21.10
CRUVI_A_HSIO: J21.2
CRUVI_A_HSO: J21.6
CRUVI_A_MODE: J21.57
CRUVI_A_REFCLK: J21.11
CRUVI_A_RESET: J21.8
CRUVI_A_SCK: J21.59
CRUVI_A_SEL: J21.55
CRUVI_A_SMB_ALERT: J21.3
CRUVI_A_SMB_SCL: J21.7
CRUVI_A_SMB_SDA: J21.5
CRUVI_B_0_N: J27.17
CRUVI_B_0_P: J27.15
CRUVI_B_1_N: J27.23
CRUVI_B_1_P: J27.21
CRUVI_B_2_N: J27.29
CRUVI_B_2_P: J27.27
CRUVI_B_3_N: J27.35
CRUVI_B_3_P: J27.33
CRUVI_B_4_N: J27.41
CRUVI_B_4_P: J27.39
CRUVI_B_5_N: J27.47
CRUVI_B_5_P: J27.45
CRUVI_B_6_N: J27.16
CRUVI_B_6_P: J27.14
CRUVI_B_7_N: J27.22
CRUVI_B_7_P: J27.20
CRUVI_B_8_N: J27.28
CRUVI_B_8_P: J27.26
CRUVI_B_9_N: J27.34
CRUVI_B_9_P: J27.32
CRUVI_B_10_N: J27.40
CRUVI_B_10_P: J27.38
CRUVI_B_11_N: J27.46
CRUVI_B_11_P: J27.44
CRUVI_B_DI: J27.51
CRUVI_B_DO: J27.53
CRUVI_B_HSI: J27.10
CRUVI_B_HSIO: J27.2
CRUVI_B_HSO: J27.6
CRUVI_B_MODE: J27.57
CRUVI_B_REFCLK: J27.11
CRUVI_B_RESET: J27.8
CRUVI_B_SCK: J27.59
CRUVI_B_SEL: J27.55
CRUVI_B_SMB_ALERT: J27.3
CRUVI_B_SMB_SCL: J27.7
CRUVI_B_SMB_SDA: J27.5

Notes on the sheet:
PCB Mounting
The information contained in these documents is confidential, privileged and only for the information of the intended recipient and may not be used, published or redistributed without the prior written consent from PCB Arts GmbH.
https://pcb-arts.com/
HARNESS: CRUVI_B
mail@pcb-arts.com
Sheet:
Bank Voltage: 3.3V
Cruvi Mounting
${FILENAME}
${CURRENT_DATE}
Revision:
${##}
Date:
HARNESS: CRUVI_A
Elektronik- und Softwareentwicklung aus Nürnberg
Heatsink Mounting
${REVISION1}
Checked:
${ENTWICKLER}
Engineer
${CURRENTTIME}
${CHECKED}
++CONFIDENTIAL++
Title:
Time:
${#}
