pcbarts/fast-open-switch-hardware/fast-open-switch r1.0 - KiCad/System Clocks.kicad_sch

## KiCad design fast-open-switch r1.0 - KiCad/System Clocks.kicad_sch (2023-05-11)

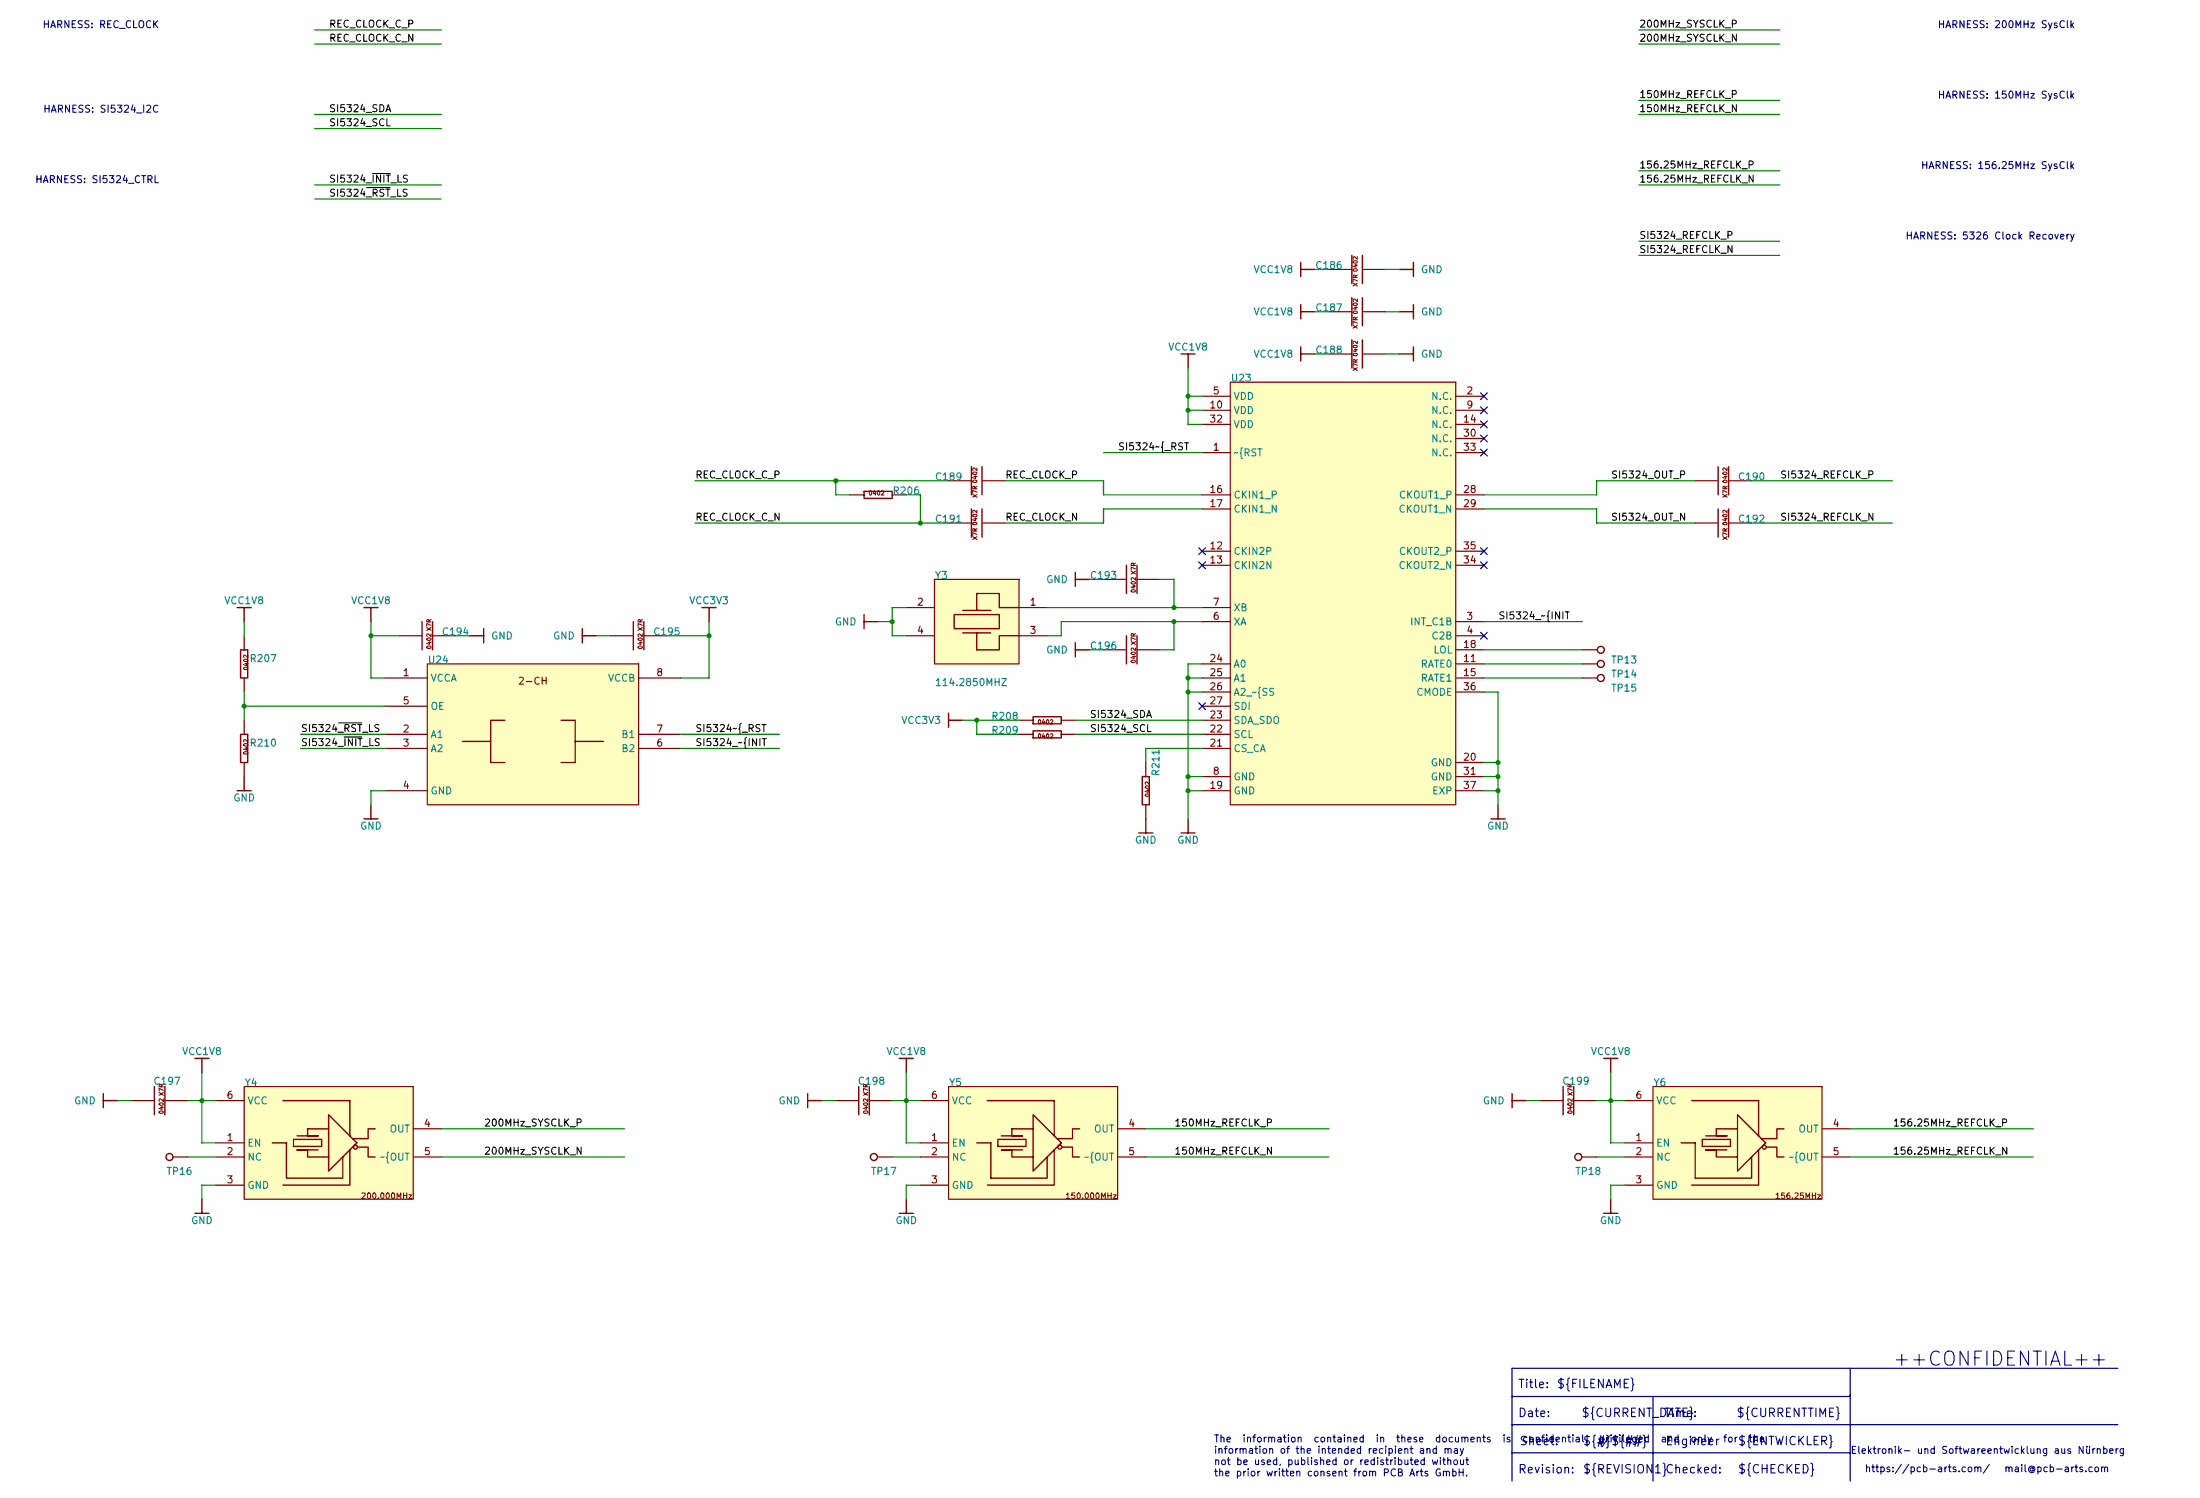
[picture p85: schematic System Clocks.kicad_sch]

Parts:
C186, C187, C188, C189, C190, C191, C192, C193, C194, C195, C196, C197, C198, C199: CAP_0402_L
R206, R207, R208, R209, R210, R211: RES_0402_L
TP13, TP14, TP15, TP16, TP17, TP18: Testpoint 0.8mm
U23: QFN50P600X600X85-37N
U24: SON40P120X40-8N
Y3: S3D - Shenzhen SCTF Elec
Y4, Y5, Y6: Abracon AX3

Connections:
150MHz_REFCLK_N: Y5.5 (~{OUT)
150MHz_REFCLK_P: Y5.4 (OUT)
156.25MHz_REFCLK_N: Y6.5 (~{OUT)
156.25MHz_REFCLK_P: Y6.4 (OUT)
200MHz_SYSCLK_N: Y4.5 (~{OUT)
200MHz_SYSCLK_P: Y4.4 (OUT)
unnamed: C193.2, U23.7 (XB), Y3.1
unnamed: C194.1, U24.1 (VCCA)
unnamed: C195.2, U24.8 (VCCB)
unnamed: C196.2, U23.6 (XA), Y3.3
unnamed: C197.2, Y4.1 (EN), Y4.6 (VCC)
unnamed: C198.2, Y5.1 (EN), Y5.6 (VCC)
unnamed: C199.2, Y6.1 (EN), Y6.6 (VCC)
unnamed: R207.1, R210.2, U24.5 (OE)
unnamed: R208.2, R209.2
unnamed: R211.2, U23.21 (CS_CA)
unnamed: TP13.1, U23.18 (LOL)
unnamed: TP14.1, U23.11 (RATE0)
unnamed: TP15.1, U23.15 (RATE1)
unnamed: TP16.1, Y4.2 (NC)
unnamed: TP17.1, Y5.2 (NC)
unnamed: TP18.1, Y6.2 (NC)
unnamed: U23.5 (VDD), U23.10 (VDD), U23.32 (VDD)
unnamed: U23.8 (GND), U23.19 (GND), U23.24 (A0), U23.25 (A1), U23.26 (A2_~{SS)
unnamed: U23.20 (GND), U23.31 (GND), U23.36 (CMODE), U23.37 (EXP)
unnamed: Y3.2, Y3.4
REC_CLOCK_C_N: C191.2, R206.1
REC_CLOCK_C_P: C189.2, R206.2
REC_CLOCK_N: C191.1, U23.17 (CKIN1_N)
REC_CLOCK_P: C189.1, U23.16 (CKIN1_P)
SI5324_OUT_N: C192.1, U23.29 (CKOUT1_N)
SI5324_OUT_P: C190.1, U23.28 (CKOUT1_P)
SI5324_REFCLK_N: C192.2
SI5324_REFCLK_P: C190.2
SI5324_SCL: R209.1, U23.22 (SCL)
SI5324_SDA: R208.1, U23.23 (SDA_SDO)
SI5324_~{INIT: U23.3 (INT_C1B), U24.6 (B2)
SI5324_~INIT_LS: U24.3 (A2)
SI5324~{_RST: U23.1 (~{RST), U24.7 (B1)
SI5324~_RST_LS: U24.2 (A1)

Notes on the sheet:
The information contained in these documents is confidential, privileged and only for the information of the intended recipient and may not be used, published or redistributed without the prior written consent from PCB Arts GmbH.
${FILENAME}
HARNESS: SI5324_I2C
${#}
Sheet:
${##}
Date:
HARNESS: 200MHz SysClk
Title:
Time:
${CURRENT_DATE}
Checked:
HARNESS: REC_CLOCK
HARNESS: 150MHz SysClk
HARNESS: SI5324_CTRL
HARNESS: 5326 Clock Recovery
++CONFIDENTIAL++
Revision:
https://pcb-arts.com/
${REVISION1}
Engineer
HARNESS: 156.25MHz SysClk
${CURRENTTIME}
Elektronik- und Softwareentwicklung aus Nürnberg
${CHECKED}
mail@pcb-arts.com
${ENTWICKLER}
