pcbarts/fast-open-switch-hardware/fast-open-switch r1.0 - KiCad/USB-HUB-MUX.kicad_sch

## KiCad design fast-open-switch r1.0 - KiCad/USB-HUB-MUX.kicad_sch (2023-05-11)

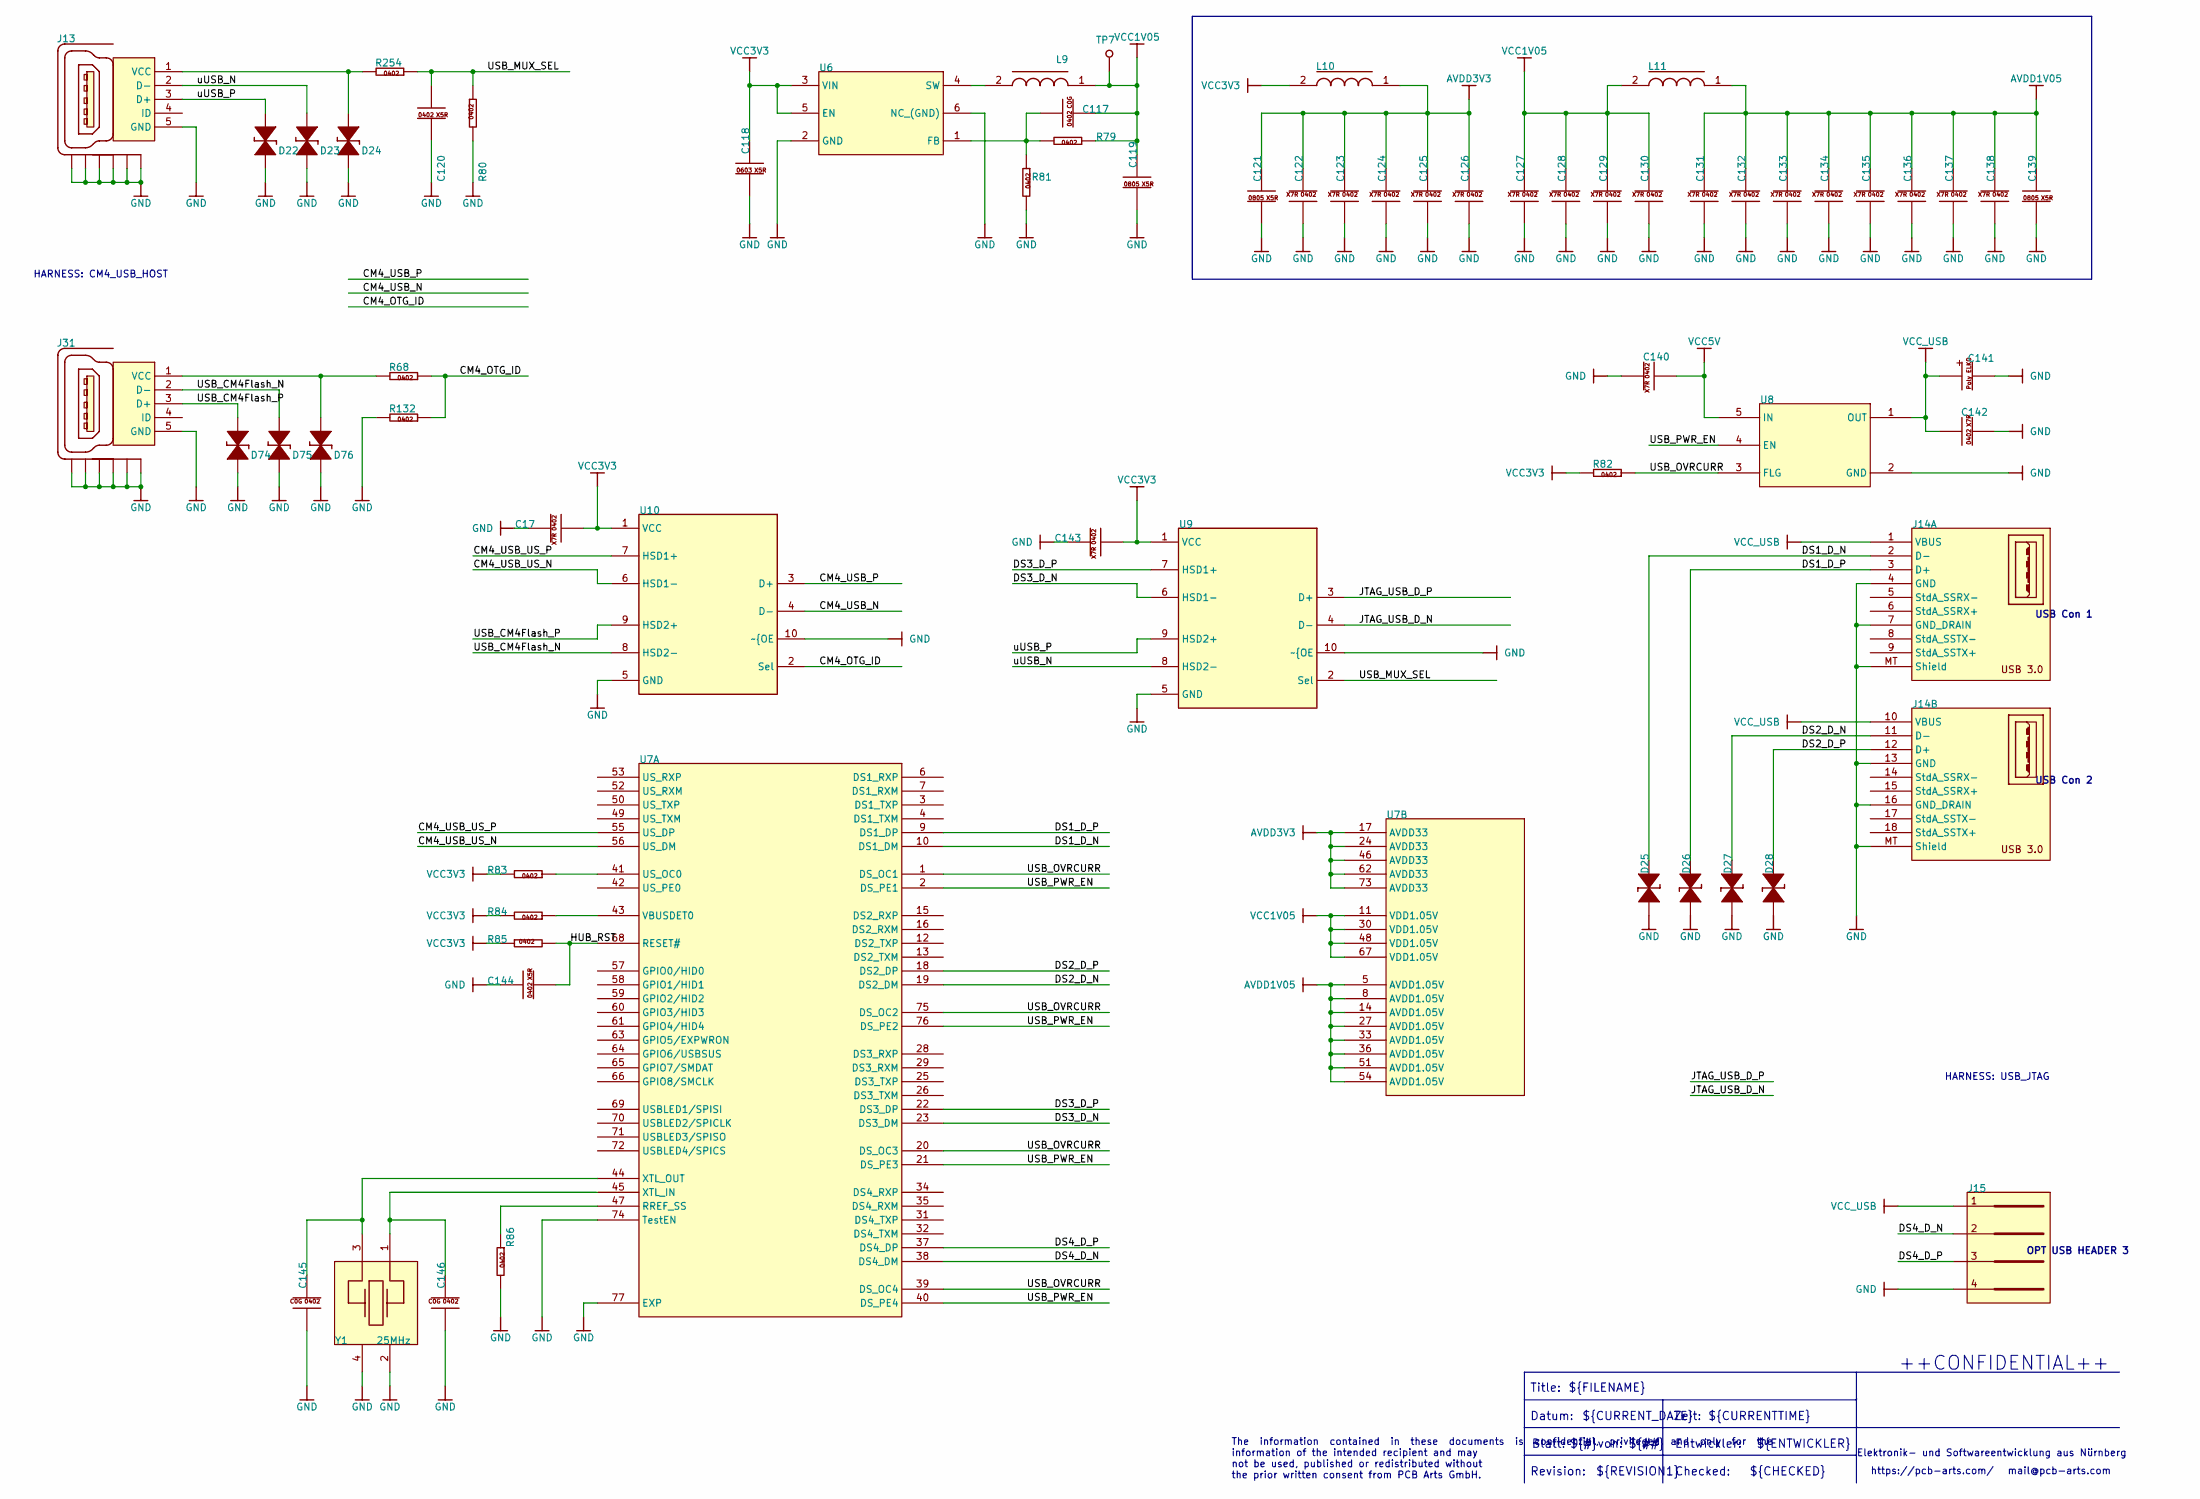
[picture p86: schematic USB-HUB-MUX.kicad_sch]

Parts:
C17, C117, C120, C122, C123, C124, C125, C126, C127, C128, C129, C130, C131, C132, C133, C134, C135, C136, C137, C138, C140, C142, C143, C144, C145, C146: CAP_0402_L
C118: CAP_0603_L
C119, C121, C139: CAP_0805
C141: WCAP-ASLI_D5H5.5
D22, D23, D24, D25, D26, D27, D28, D74, D75, D76: TVS_0402
J13, J31: MICRO5.9mmusb
J14: UEA1112C-8FS6-4F
J15: 61300411121
L9: FXL0420-1R0-M
L10, L11: L_0805
R68, R79, R80, R81, R82, R83, R84, R85, R86, R132, R254: RES_0402_L
TP7: Testpoint 0.8mm
U6: SON50P150X80-6N
U7: QFN50P900X900X85-76N
U8: SOT95P285X140-5N
U9, U10: SOP50P300X300X110-10N
Y1: ECX-2236B

Connections:
CM4_OTG_ID: R68.2, R132.2, U10.2 (Sel)
CM4_USB_N: U10.4 (D-)
CM4_USB_P: U10.3 (D+)
CM4_USB_US_N: U7.56 (US_DM), U10.6 (HSD1-)
CM4_USB_US_P: U7.55 (US_DP), U10.7 (HSD1+)
DS1_D_N: D25.2, J14.2 (D-), U7.10 (DS1_DM)
DS1_D_P: D26.2, J14.3 (D+), U7.9 (DS1_DP)
DS2_D_N: D27.2, J14.11 (D-), U7.19 (DS2_DM)
DS2_D_P: D28.2, J14.12 (D+), U7.18 (DS2_DP)
DS3_D_N: U7.23 (DS3_DM), U9.6 (HSD1-)
DS3_D_P: U7.22 (DS3_DP), U9.7 (HSD1+)
DS4_D_N: J15.2, U7.38 (DS4_DM)
DS4_D_P: J15.3, U7.37 (DS4_DP)
HUB_RST: C144.2, R85.1, U7.68 (RESET#)
JTAG_USB_D_N: U9.4 (D-)
JTAG_USB_D_P: U9.3 (D+)
unnamed: C17.1, U10.1 (VCC)
unnamed: C117.1, R79.1, R81.2, U6.1 (FB)
unnamed: C117.2, C119.1, L9.1, R79.2, TP7.1
unnamed: C118.1, U6.3 (VIN), U6.5 (EN)
unnamed: C121.1, C122.2, C123.2, C124.2, C125.2, C126.2, L10.1
unnamed: C127.2, C128.2, C129.2, C130.2, L11.2
unnamed: C131.2, C132.2, C133.2, C134.2, C135.2, C136.2, C137.2, C138.2, C139.1, L11.1
unnamed: C140.1, U8.5 (IN)
unnamed: C141.1, C142.1, U8.1 (OUT)
unnamed: C143.1, U9.1 (VCC)
unnamed: C145.2, U7.44 (XTL_OUT), Y1.3
unnamed: C146.2, U7.45 (XTL_IN), Y1.1
unnamed: D24.1, J13.1 (VCC), R254.1
unnamed: D76.1, J31.1 (VCC), R68.1
unnamed: J13.6 (Shield), J13.7 (Shield), J13.8 (Shield), J13.9 (Shield), J13.10 (Shield), J13.11 (Shield)
unnamed: J14.4 (GND), J14.7 (GND_DRAIN), J14.13 (GND), J14.16 (GND_DRAIN), J14.MT (Shield)
unnamed: J31.6 (Shield), J31.7 (Shield), J31.8 (Shield), J31.9 (Shield), J31.10 (Shield), J31.11 (Shield)
unnamed: L9.2, U6.4 (SW)
unnamed: R83.2, U7.41 (US_OC0)
unnamed: R84.2, U7.43 (VBUSDET0)
unnamed: R86.2, U7.47 (RREF_SS)
unnamed: U7.11 (VDD1.05V), U7.30 (VDD1.05V), U7.48 (VDD1.05V), U7.67 (VDD1.05V)
unnamed: U7.5 (AVDD1.05V), U7.8 (AVDD1.05V), U7.14 (AVDD1.05V), U7.27 (AVDD1.05V), U7.33 (AVDD1.05V), U7.36 (AVDD1.05V), U7.51 (AVDD1.05V), U7.54 (AVDD1.05V)
unnamed: U7.17 (AVDD33), U7.24 (AVDD33), U7.46 (AVDD33), U7.62 (AVDD33), U7.73 (AVDD33)
USB_CM4Flash_N: D75.1, J31.2 (D-), U10.8 (HSD2-)
USB_CM4Flash_P: D74.1, J31.3 (D+), U10.9 (HSD2+)
USB_MUX_SEL: C120.1, R80.2, R254.2, U9.2 (Sel)
USB_OVRCURR: R82.2, U7.1 (DS_OC1), U7.20 (DS_OC3), U7.39 (DS_OC4), U7.75 (DS_OC2), U8.3 (FLG)
USB_PWR_EN: U7.2 (DS_PE1), U7.21 (DS_PE3), U7.40 (DS_PE4), U7.76 (DS_PE2), U8.4 (EN)
uUSB_N: D23.1, J13.2 (D-), U9.8 (HSD2-)
uUSB_P: D22.1, J13.3 (D+), U9.9 (HSD2+)

Notes on the sheet:
${CURRENT_DATE}
${#}
Title:
${FILENAME}
${##}
https://pcb-arts.com/
HARNESS: CM4_USB_HOST
Blatt:
von:
${CURRENTTIME}
${CHECKED}
Elektronik- und Softwareentwicklung aus Nürnberg
${REVISION1}
USB Con 2
mail@pcb-arts.com
HARNESS: USB_JTAG
Revision:
Datum:
Checked:
++CONFIDENTIAL++
OPT USB HEADER 3
${ENTWICKLER}
Entwickler:
The information contained in these documents is confidential, privileged and only for the information of the intended recipient and may not be used, published or redistributed without the prior written consent from PCB Arts GmbH.
Zeit:
USB Con 1
