pcbarts/fast-open-switch-hardware/fast-open-switch r1.0 - KiCad/USB-UART-interface.kicad_sch

## KiCad design fast-open-switch r1.0 - KiCad/USB-UART-interface.kicad_sch (2023-05-11)

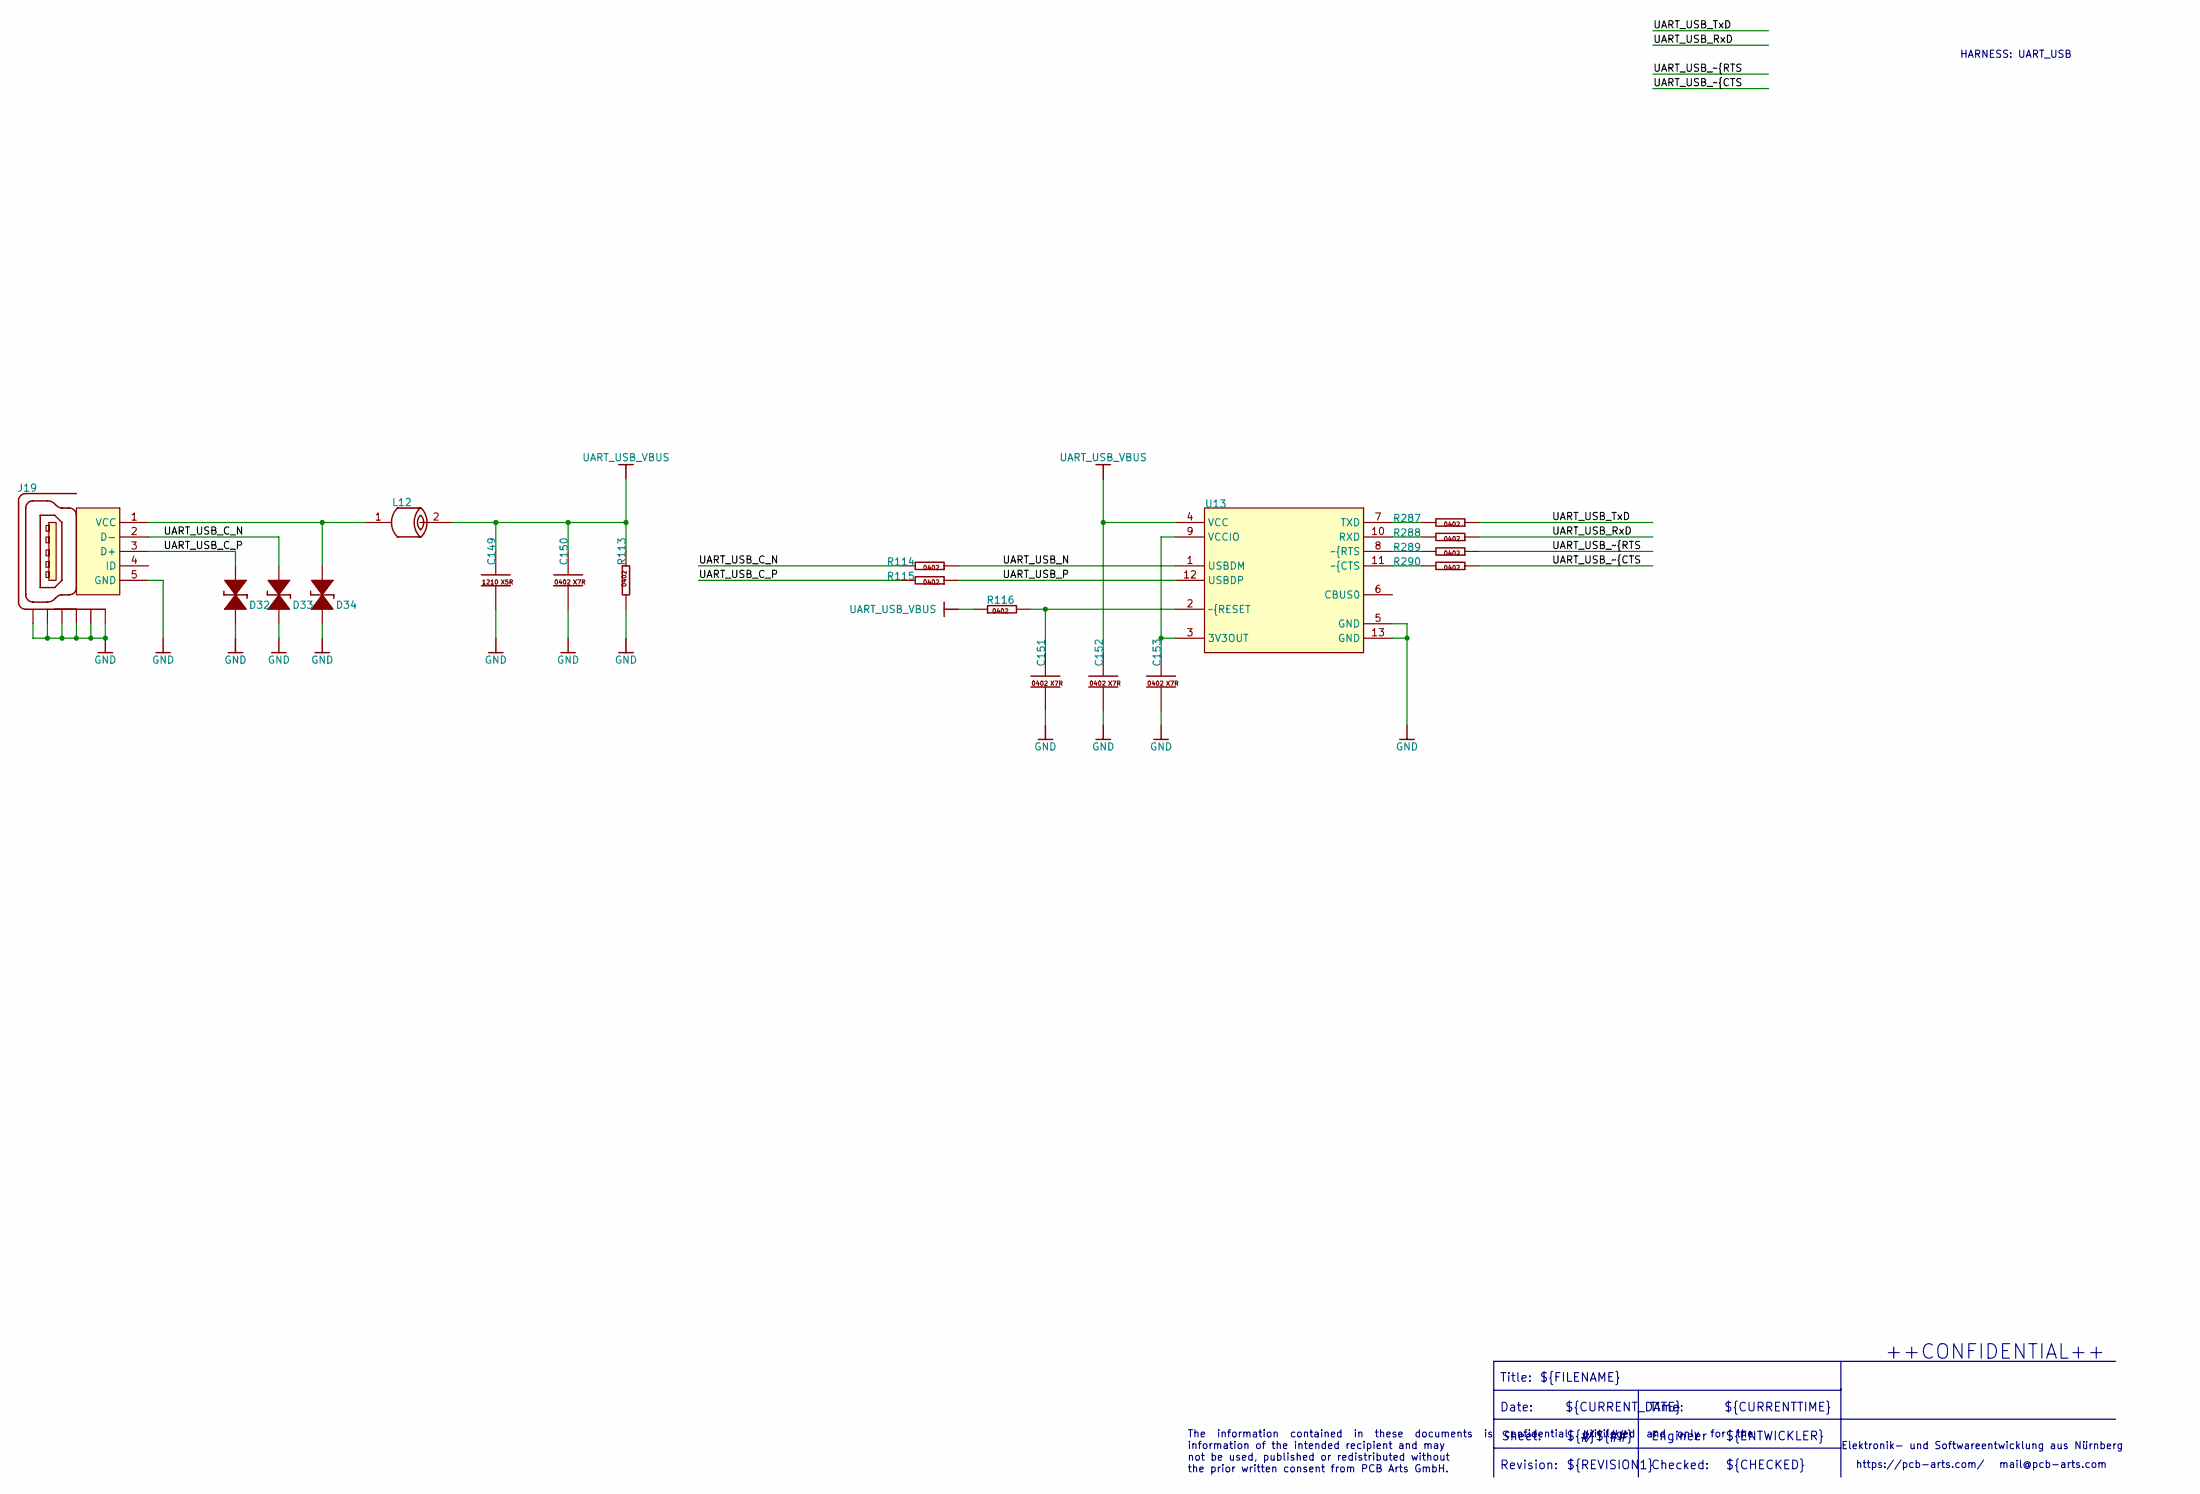
[picture p87: schematic USB-UART-interface.kicad_sch]

Parts:
C149: CAP_1210
C150, C151, C152, C153: CAP_0402_L
D32, D33, D34: TVS_0402
J19: MICRO5.9mmusb
L12: L_0603
R113, R114, R115, R116, R287, R288, R289, R290: RES_0402_L
U13: QFN45P300X300x75_-12N

Connections:
unnamed: C149.1, C150.1, L12.2, R113.2
unnamed: C151.1, R116.1, U13.2 (~{RESET)
unnamed: C152.1, U13.4 (VCC)
unnamed: C153.1, U13.3 (3V3OUT), U13.9 (VCCIO)
unnamed: D34.1, J19.1 (VCC), L12.1
unnamed: J19.6 (Shield), J19.7 (Shield), J19.8 (Shield), J19.9 (Shield), J19.10 (Shield), J19.11 (Shield)
unnamed: R287.1, U13.7 (TXD)
unnamed: R288.1, U13.10 (RXD)
unnamed: R289.1, U13.8 (~{RTS)
unnamed: R290.1, U13.11 (~{CTS)
unnamed: U13.5 (GND), U13.13 (GND)
UART_USB_C_N: D33.1, J19.2 (D-), R114.1
UART_USB_C_P: D32.1, J19.3 (D+), R115.1
UART_USB_N: R114.2, U13.1 (USBDM)
UART_USB_P: R115.2, U13.12 (USBDP)
UART_USB_RxD: R288.2
UART_USB_TxD: R287.2
UART_USB_~{CTS: R290.2
UART_USB_~{RTS: R289.2

Notes on the sheet:
https://pcb-arts.com/
The information contained in these documents is confidential, privileged and only for the information of the intended recipient and may not be used, published or redistributed without the prior written consent from PCB Arts GmbH.
Engineer
Sheet:
Time:
Elektronik- und Softwareentwicklung aus Nürnberg
++CONFIDENTIAL++
mail@pcb-arts.com
${##}
${#}
${FILENAME}
Title:
${CHECKED}
${ENTWICKLER}
${CURRENTTIME}
Date:
HARNESS: UART_USB
Revision:
${REVISION1}
${CURRENT_DATE}
Checked:
