pcbarts/fast-open-switch-hardware/(commit log)

2023-03-30 Initial upload of schematic source documents
    schematics revision 1.0
    [Bank 0_Bank 14.SchDoc, Bank 13_Bank 15_Bank 16.SchDoc, Buck Modules.SchDoc, DDR3 Memory_Banks 32-33-34.SchDoc, DDR3 Memory_SO-DIMM.SchDoc, FPGA Supply Pins.SchDoc, FPGA_HDMI_IN_OUT.SchDoc, HMI.SchDoc]
2023-03-30 initialized PcbDoc
2023-05-11 Changed power switch, added Logos to PCB, Changed 125MHz Crystal to 156.25MHz, uploaded .PDF documentation, uploaded KiCad imports
    [00_Top_Level_Sheet.SchDoc, 0154010.DR.STP, 01_Powersupply.SchDoc, 02_CM4 Module.SchDoc, 03_USB.SchDoc, 04_HDMI_Interface.SchDoc, 05_Cardreader.SchDoc, 06_Ethernet.SchDoc]
